NSEE/Cubesat-Mec/README.md

# Cubesat Mecânica

## Descrição
Desenvolvimento das partes mecânicas do cubesat NSEE, incluindo estrutura, analises térmicas, vibração ...

## Versao 1 

 Sistema escalonável que suporta até 3 unidades

## Envolvidos
- Felipe
- Bruna
- Leonardo

## Parte 1
