NSEE/Cubesat-Mec/Materiais/Arquivos/Apresentação/141203/ppt - com comentários/141128_Apresentacao_Felipe.pptx

## Projeto de Inércia para Rodas de Reação

Instituto Mauá de Tecnologia
Núcleo de Sistemas Eletrônicos Embarcados - NSEE

Felipe Mahlmeister

Engenharia Mecânica

## Slide 2

O trabalho encontra-se em fase de aprimoramento do protótipo, para um modelo matemático mais preciso.

1. Estudo das especificações exigidas pelo INPE e especificações dos motores - 4 semanas
2. Estudo e desenvolvimento de modelo matemático que descreve a dinâmica de atitude de rodas de reação - 10 semanas
3. Desenvolvimento de modelo tridimensional - 10 semanas
4. Construção de protótipo - 10 semanas
5. Teste e validação - 9 semanas
6. Redação de relatórios técnicos com os resultados obtidos - 9 semanas

Plano de trabalho e Cronograma

- Início do projeto: 29/07/2014

- Período de pesquisa: 16 semanas

- Etapas iniciadas: 1 a 4

- Prazo restante: 18 semanas

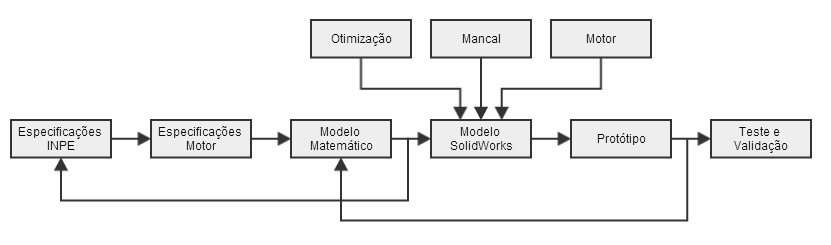
[picture p19: figure]

## Slide 3

Modelo matemático :

- Especificações;
- Projeto;
- Validação.

Simulink :

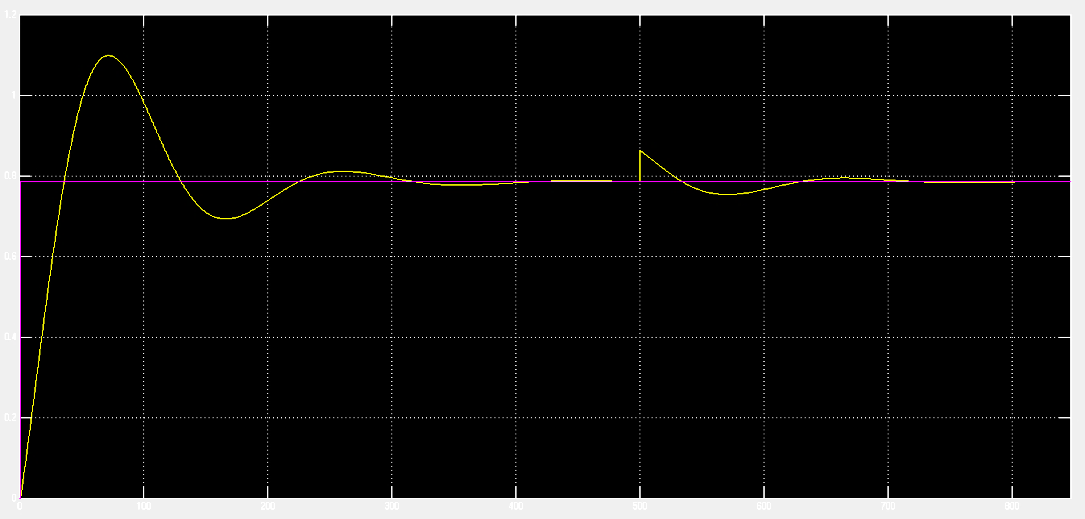
[picture p20: figure]
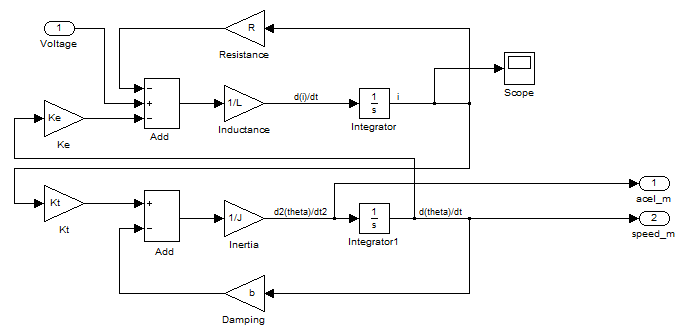
[picture p21: figure]
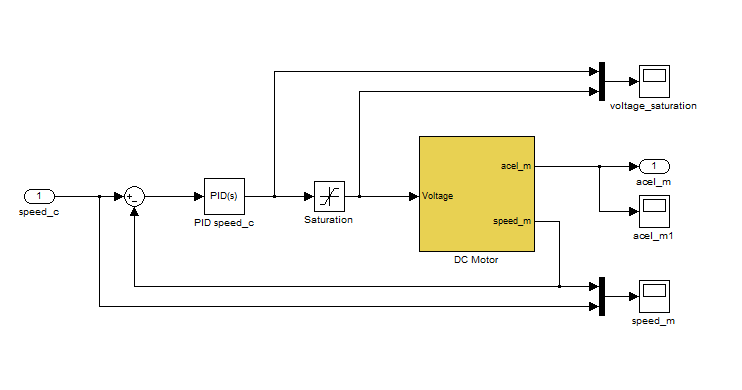
[picture p22: figure]

O modelo matemático foi desenvolvido no Matlab, com base em 3 definições:
Especificações, Projeto e Validação.

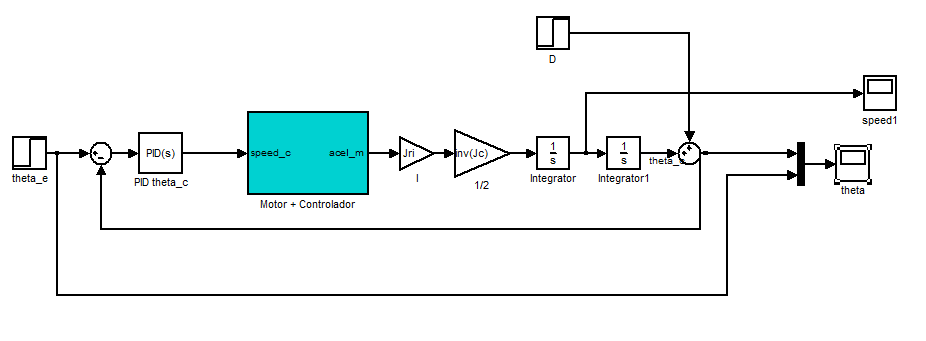
[picture p23: figure]

Protótipos :

Com a necessidade de uma melhor compreensão da dinâmica envolvida,
a pesquisa rumou para simulações no Simulink.

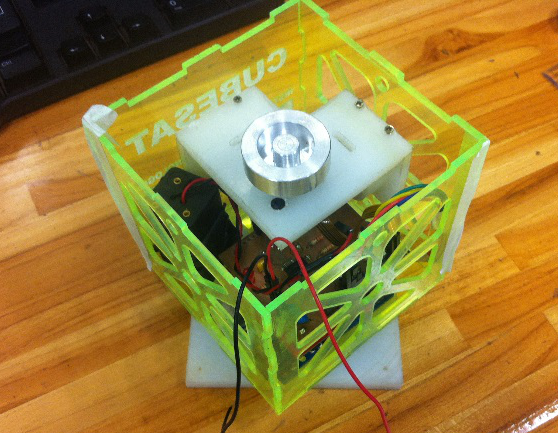
[picture p24: figure]
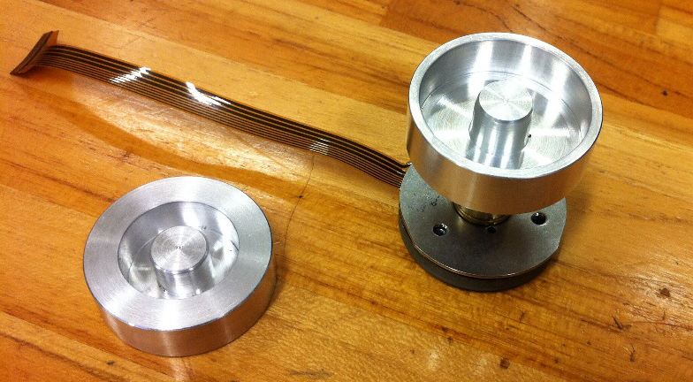
[picture p25: figure]
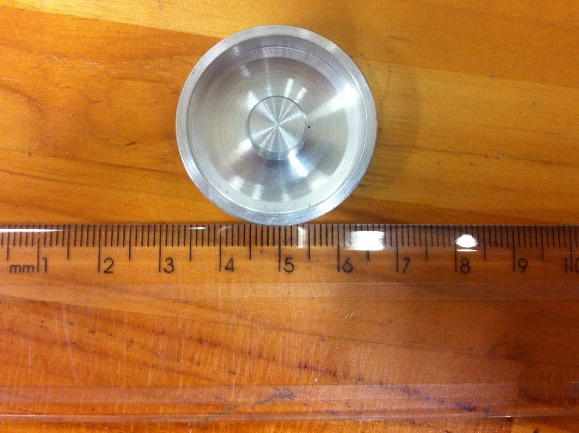
[picture p26: figure]

## Slide 4

Internacional Symposium on Dynamics Problems of Mechanics

Artigos Científicos:

- Projeto de Inércia para Rodas de Reação
- Construção e padronização de estrutura de um CubeSat, seus componentes e interligações

Possibilidades de Divulgação no meio científico:

Congresso Latino-Americano de Satélites – Setembro
Congresso Internacional de Tecnologia na Educação – Setembro
Congresso Nacional de Engenharia Mecânica – Agosto
DINAME – Fevereiro
SciELO – Scientific Electronic Library Online

Possibilidades de Divulgação no meio social:

Canal YouTube
Mídias sociais
