NSEE/Cubesat-Mec/Materiais/Arquivos/Apresentação/151112/ppt/151112_Apresentacao_Felipe.pptx

## CubeSat Frame Design - Petal Model

Instituto Mauá de Tecnologia
Núcleo de Sistemas Eletrônicos Embarcados - NSEE

Felipe Mahlmeister

Engenharia Mecânica

## Slide 2

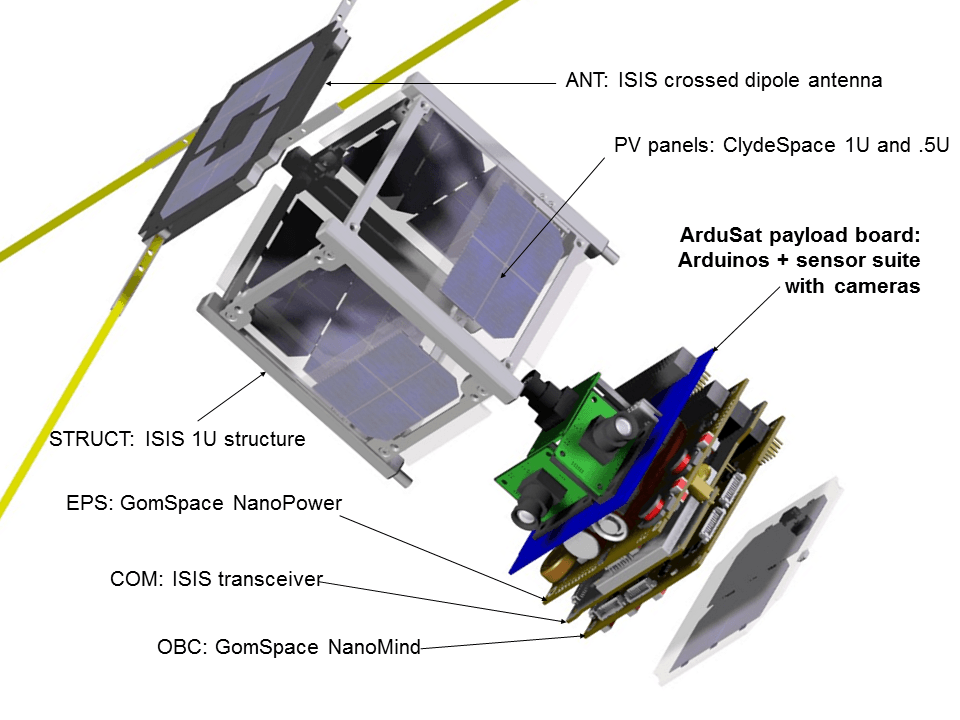
[picture p33: figure]

ArduSat / Fonte: spacesafetymagazine.com

Modelo Gaveta

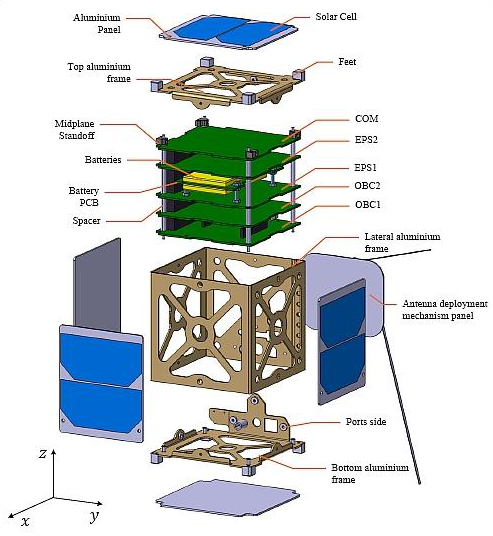
[picture p34: figure]

OUFTI-1 / Fonte: University of Liège

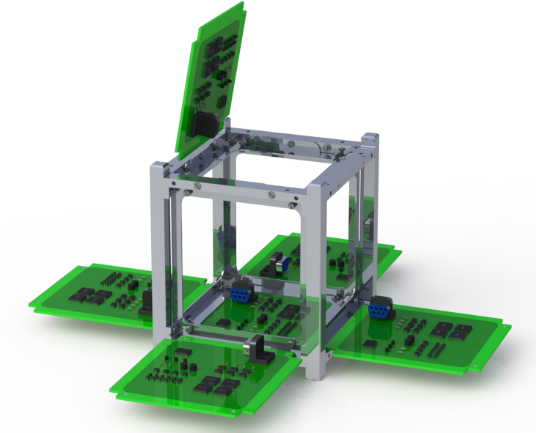
[picture p35: figure]

Modelo Pétala

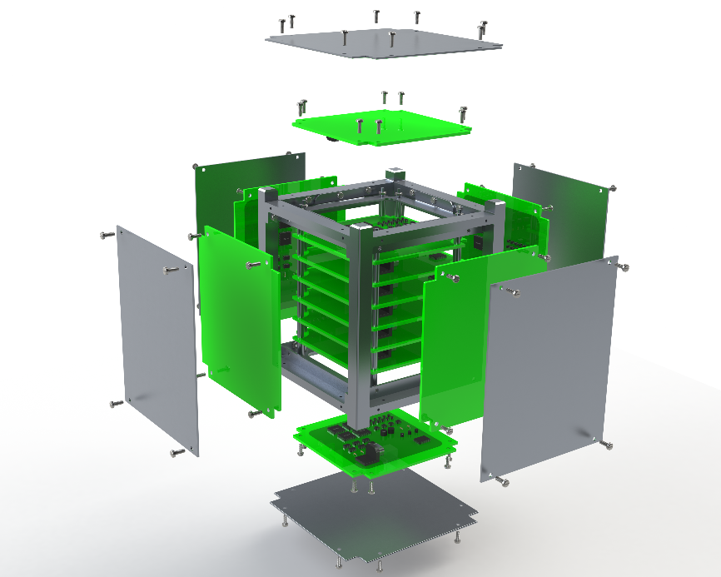
[picture p36: figure]
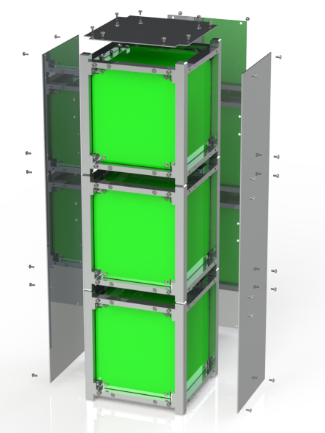
[picture p37: figure]

IMTSat 1U

IMTSat 1U

IMTSat 3U

## Slide 3

Protótipo IMTSat

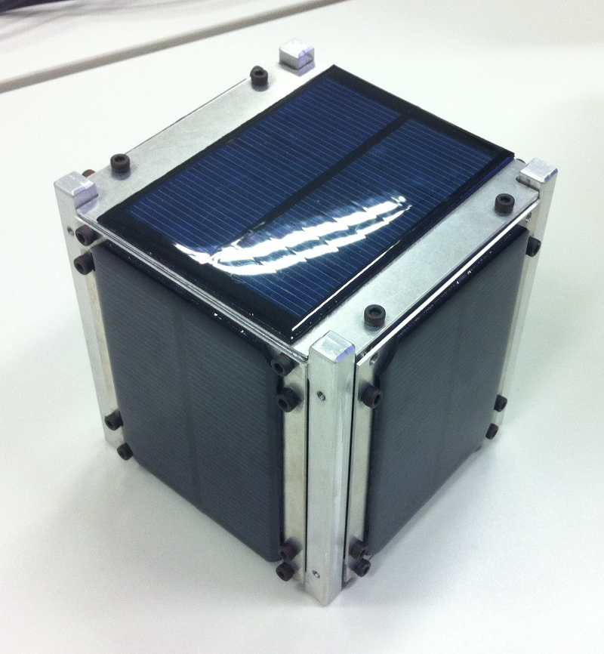
[picture p38: figure]
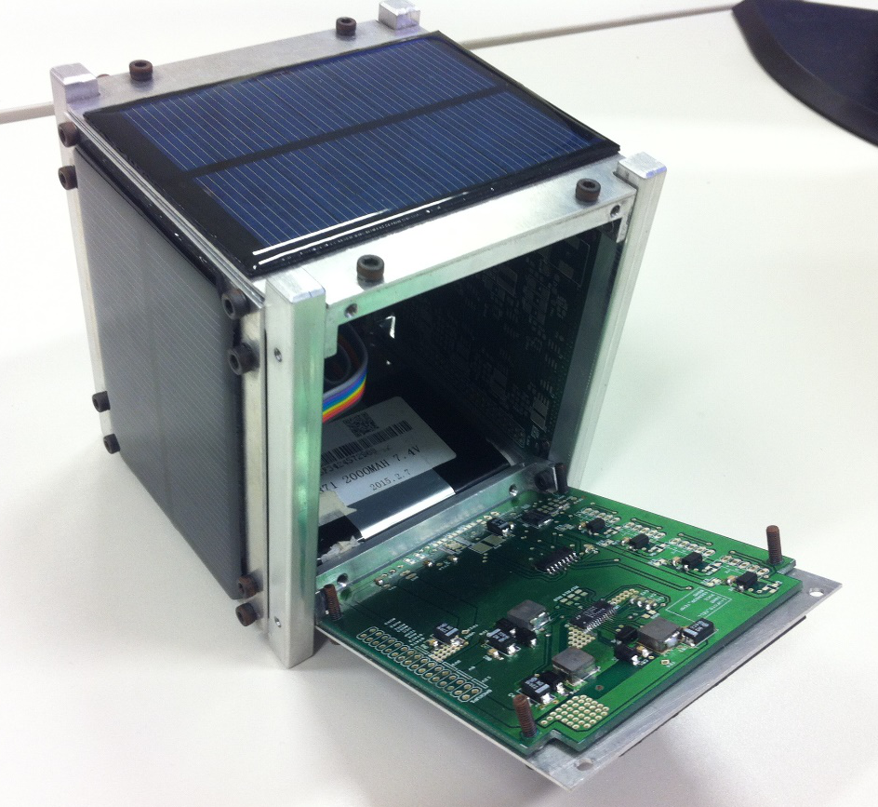
[picture p39: figure]

IMTSat v1.0

IMTSat v1.0
