NSEE/Cubesat-Mec/Materiais/Arquivos/Apresentação/141203/images/45graus - PID01.png

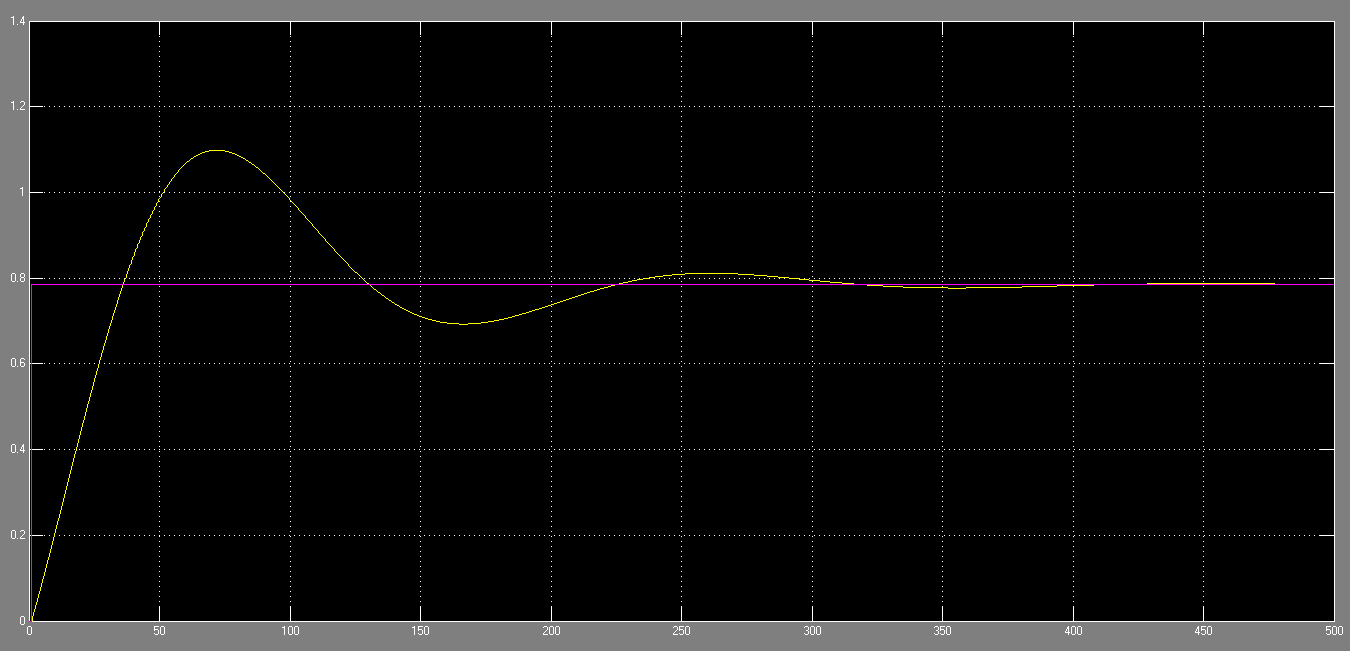
Materiais/Arquivos/Apresentação/141203/images/45graus - PID01.png
