NSEE/Cubesat-Mec/Materiais/Arquivos/Apresentação/151112/images/OUFTI1_AutoB.jpg

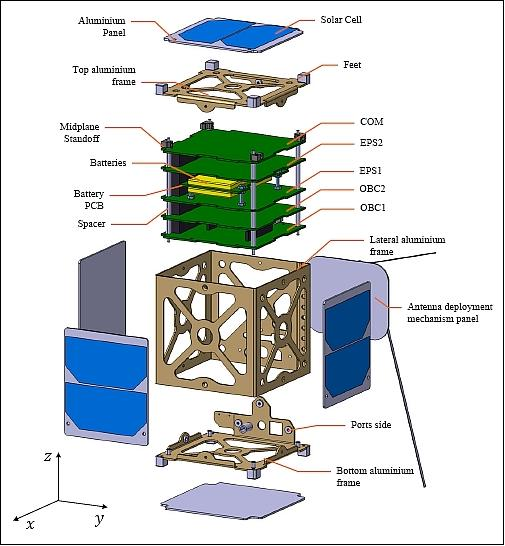
Materiais/Arquivos/Apresentação/151112/images/OUFTI1_AutoB.jpg
