NSEE/Cubesat-Mec/Materiais/Arquivos/Fotos/Reais/v01.1/IMG_6018.JPG

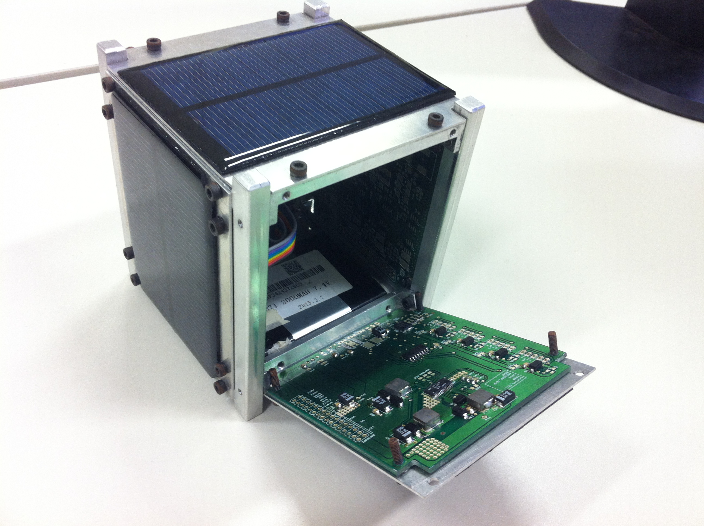
Materiais/Arquivos/Fotos/Reais/v01.1/IMG_6018.JPG
