NSEE/Cubesat-Mec/Materiais/Arquivos/Fotos/Reais/v01.1/IMG_6020.JPG

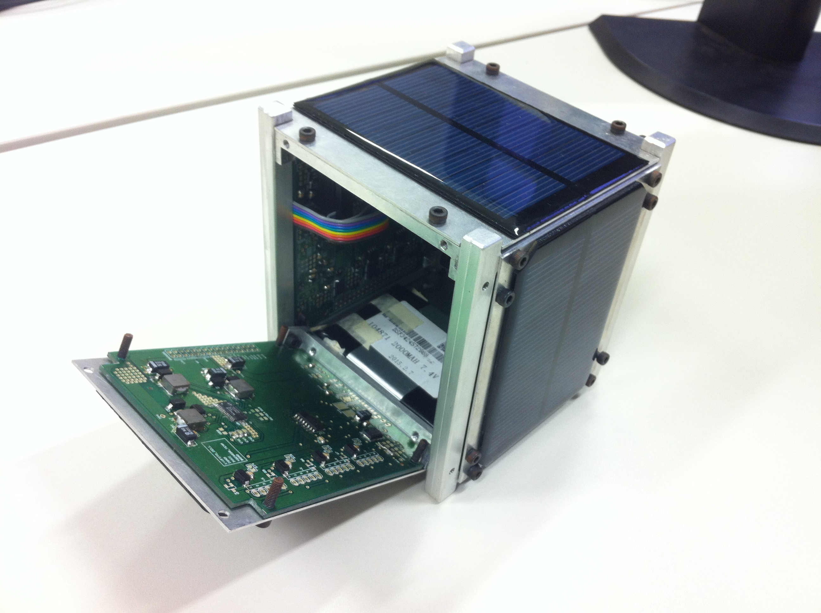
Materiais/Arquivos/Fotos/Reais/v01.1/IMG_6020.JPG
