NSEE/Cubesat-Mec/Materiais/Mecânica/Modelo/Solidworks/Inércia/Modelo 01/Cubesat_I_Flywheel_Mod01_Data.png

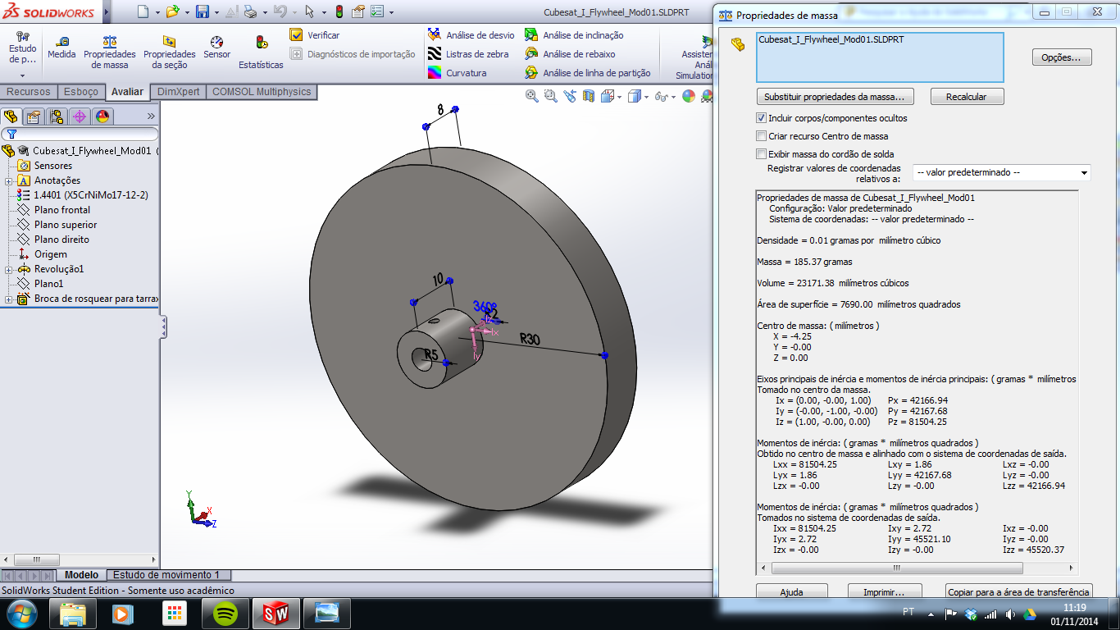
Materiais/Mecânica/Modelo/Solidworks/Inércia/Modelo 01/Cubesat_I_Flywheel_Mod01_Data.png
