NSEE/Cubesat-Mec/Materiais/Mecânica/Modelo/Solidworks/Inércia/Modelo 02/Cubesat_I_Flywheel_Mod02_Data.png

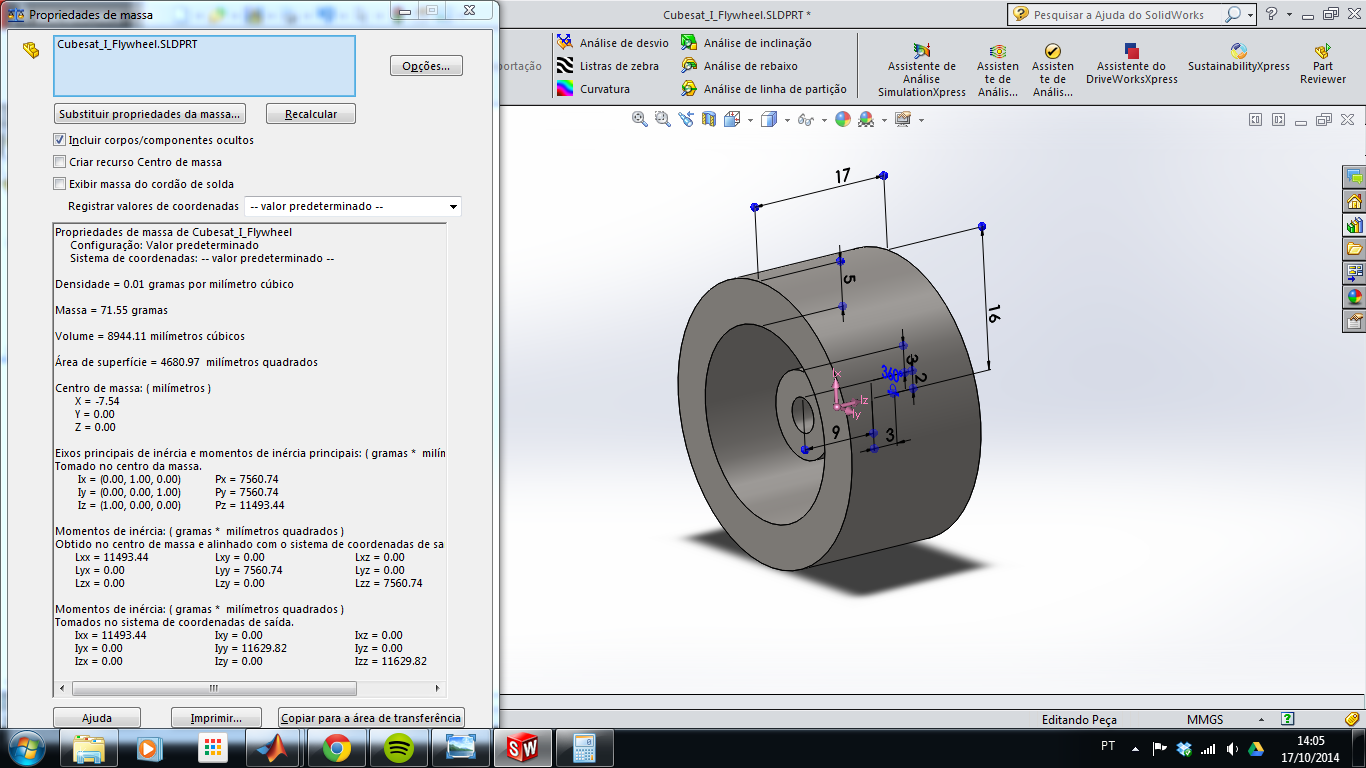
Materiais/Mecânica/Modelo/Solidworks/Inércia/Modelo 02/Cubesat_I_Flywheel_Mod02_Data.png
