NSEE/Cubesat-Mec/Materiais/Mecânica/Modelo/Solidworks/Estrutura/v01.2/Cubesat-PCB-Side-Assembly.SLDASM

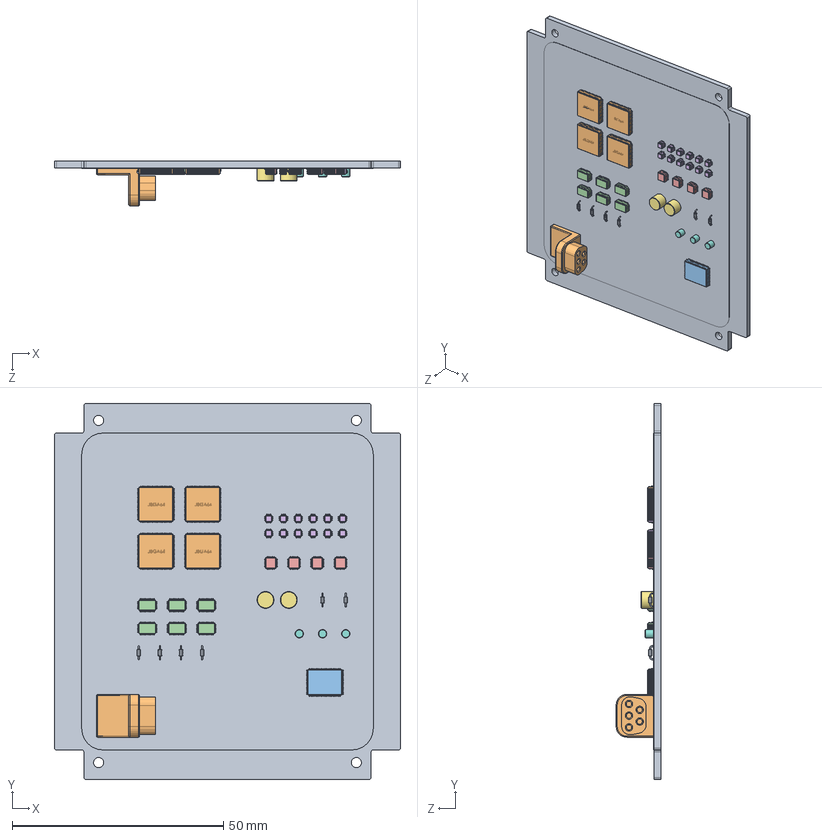
[picture p47: CAD file, 2016-01-29]
Materiais/Mecânica/Modelo/Solidworks/Estrutura/v01.2/Cubesat-PCB-Side-Assembly.SLDASM
82.0 x 89.0 x 10.6 mm
Cubesat-PCB-Side
Cubesat-PCB-Chip01 x 4
Cubesat-PCB-Chip02
Cubesat-PCB-Chip03 x 6
Cubesat-PCB-Chip04 x 4
Cubesat-PCB-Chip05 x 12
Cubesat-PCB-Chip07 x 2
Cubesat-PCB-Chip06 x 3
Cubesat-PCB-Resistor01 x 6
Cubesat-PCB-Connector01
