NSEE/Cubesat-Mec/Materiais/Mecânica/Modelo/Solidworks/Inércia/Modelo 05/Cubesat_I_Flywheel_Assembly_Mod05.SLDASM

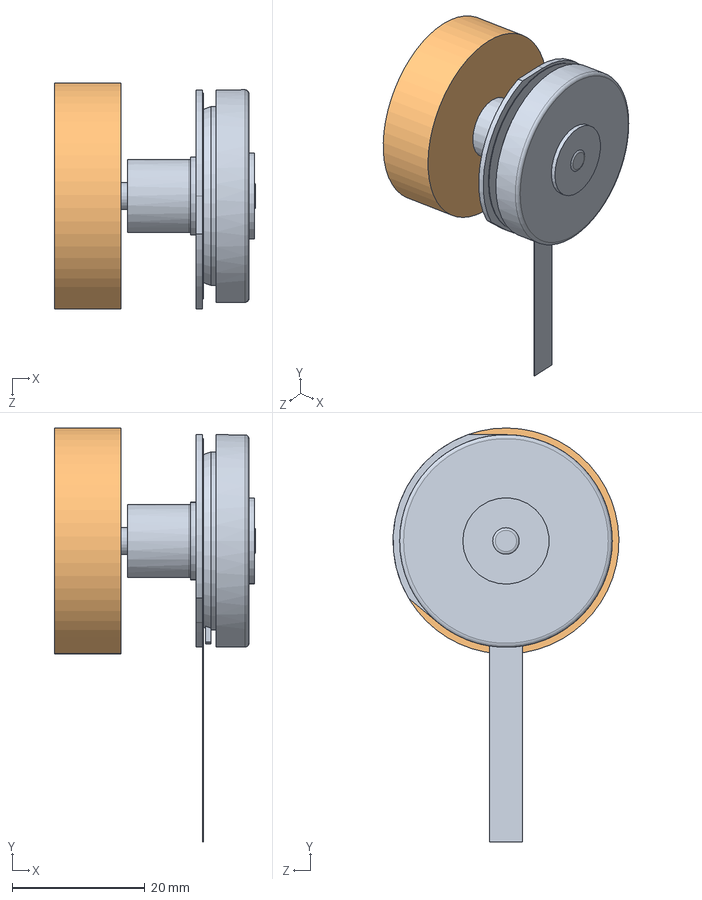
[picture p48: CAD file, 2015-04-06]
Materiais/Mecânica/Modelo/Solidworks/Inércia/Modelo 05/Cubesat_I_Flywheel_Assembly_Mod05.SLDASM
30.3 x 62.3 x 34.0 mm
Cubesat_I_EC32flat
Cubesat_I_Flywheel_Mod05
Cubesat_I_Flywheel_Screw
