NSEE/Cubesat-Mec/Materiais/Mecânica/Modelo/Solidworks/Inércia/Modelo 06/Cubesat_I_Flywheel_Assembly_Mod06.SLDASM

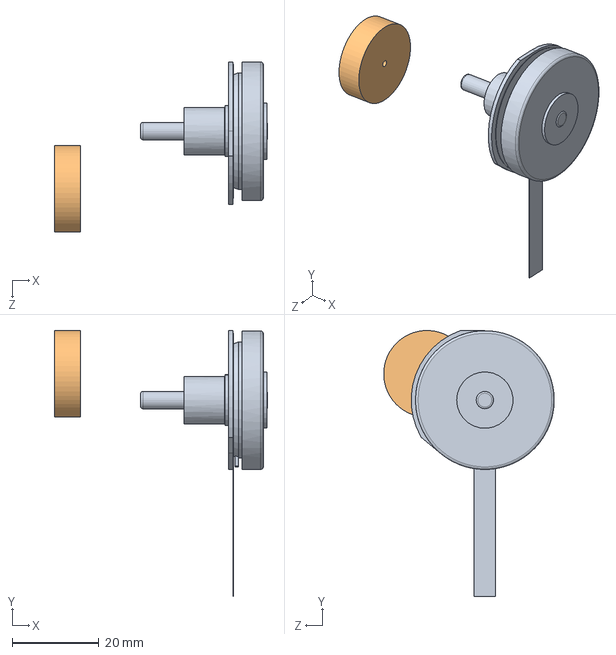
[picture p49: CAD file, 2015-04-06]
Materiais/Mecânica/Modelo/Solidworks/Inércia/Modelo 06/Cubesat_I_Flywheel_Assembly_Mod06.SLDASM
49.2 x 61.4 x 39.3 mm
Cubesat_I_EC32flat
Cubesat_I_Flywheel_Mod06
