NSEE/Cubesat-Mec/Materiais/Mecânica/Modelo/Solidworks/Inércia/Modelo 01/Cubesat_I_Flywheel_Assembly_Mod01.SLDASM

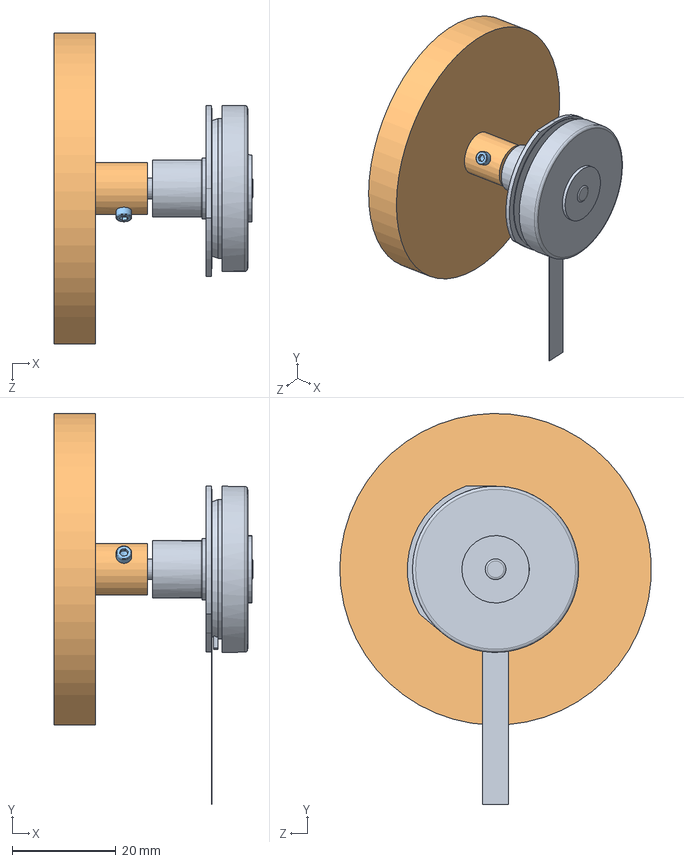
[picture p51: CAD file, 2015-04-06]
Materiais/Mecânica/Modelo/Solidworks/Inércia/Modelo 01/Cubesat_I_Flywheel_Assembly_Mod01.SLDASM
38.3 x 75.3 x 60.0 mm
Cubesat_I_EC32flat
Cubesat_I_Flywheel_Mod01
Cubesat_I_Flywheel_Screw
