NSEE/Cubesat-Mec/Materiais/Mecânica/Modelo/Solidworks/Inércia/Modelo 03/Cubesat_I_Flywheel_Assembly_Mod03.SLDASM

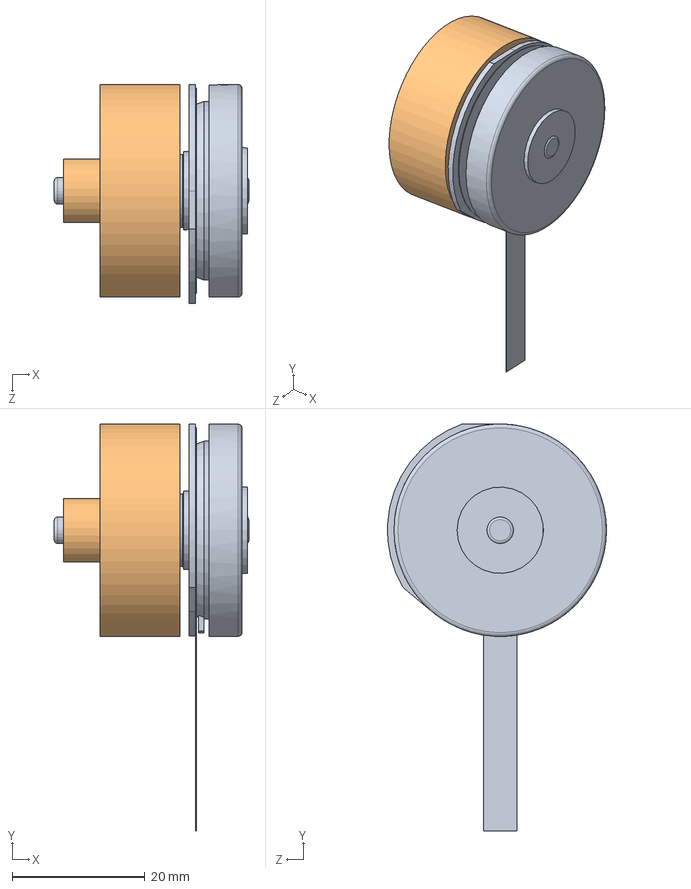
[picture p52: CAD file, 2015-04-06]
Materiais/Mecânica/Modelo/Solidworks/Inércia/Modelo 03/Cubesat_I_Flywheel_Assembly_Mod03.SLDASM
29.3 x 61.3 x 33.0 mm
Cubesat_I_EC32flat
Cubesat_I_Flywheel_Mod03
