NSEE/Cubesat-Mec/Materiais/Mecânica/Modelo/Solidworks/Inércia/Modelo 04/Cubesat_I_Flywheel_Assembly_Mod04.SLDASM

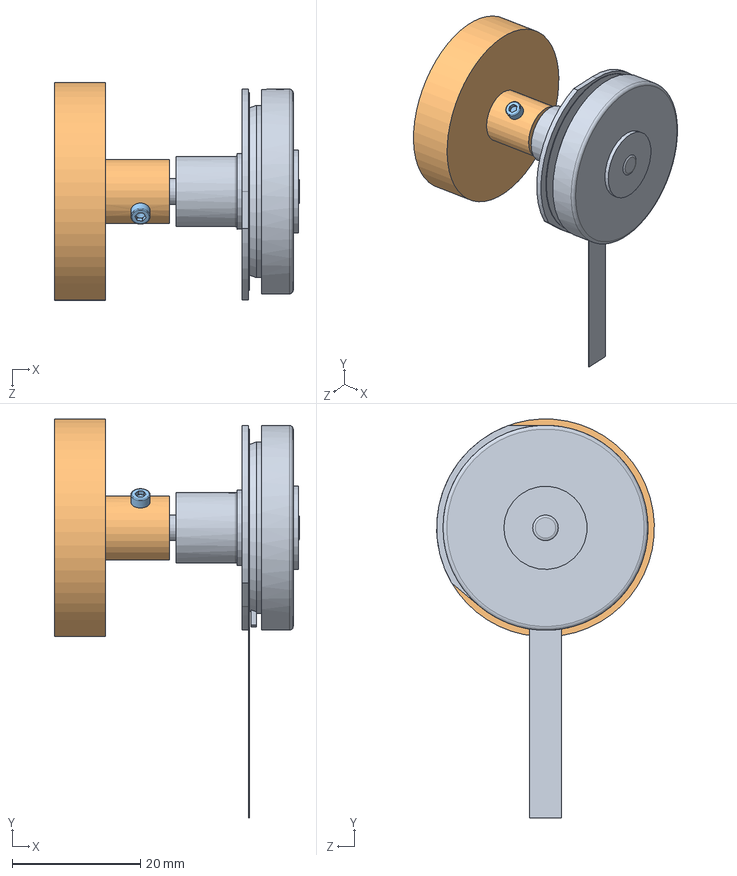
[picture p53: CAD file, 2015-04-06]
Materiais/Mecânica/Modelo/Solidworks/Inércia/Modelo 04/Cubesat_I_Flywheel_Assembly_Mod04.SLDASM
38.3 x 62.3 x 34.0 mm
Cubesat_I_EC32flat
Cubesat_I_Flywheel_Mod04
Cubesat_I_Flywheel_Screw
