NSEE/Cubesat-Mec/Materiais/Mecânica/Modelo/Solidworks/Inércia/Cubesat_I_Flywheel_Assembly.SLDASM

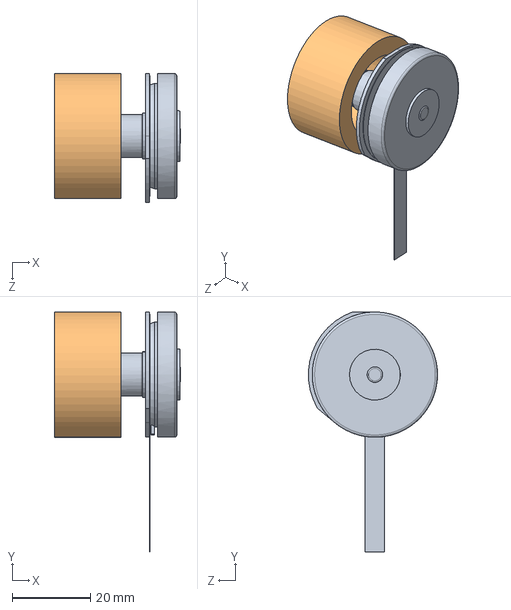
[picture p55: CAD file, 2015-04-06]
Materiais/Mecânica/Modelo/Solidworks/Inércia/Cubesat_I_Flywheel_Assembly.SLDASM
32.3 x 61.3 x 33.0 mm
Cubesat_I_EC32flat
Cubesat_I_Flywheel
