NSEE/Cubesat-Mec/Materiais/Mecânica/Modelo/Solidworks/Inércia/Modelo 10/Cubesat_I_Flywheel_Assembly_Mod10.SLDASM

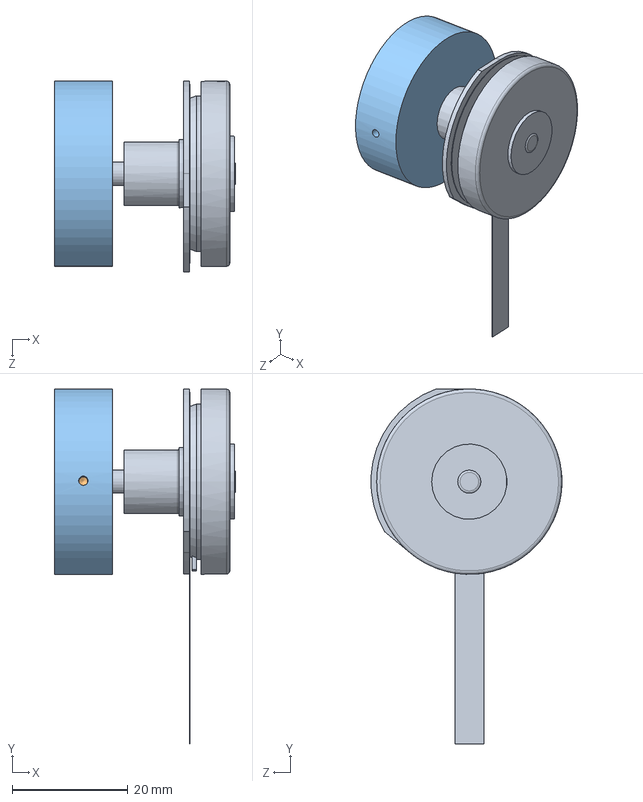
[picture p56: CAD file, 2015-04-06]
Materiais/Mecânica/Modelo/Solidworks/Inércia/Modelo 10/Cubesat_I_Flywheel_Assembly_Mod10.SLDASM
31.3 x 61.3 x 33.0 mm
Cubesat_I_EC32flat
Cubesat_I_Flywheel_Screw
Cubesat_I_Flywheel_Mod08
