NSEE/Cubesat-Mec/Materiais/Mecânica/Modelo/Solidworks/Estrutura/v01.2/Cubesat-PCB-Top-Assembly.SLDASM

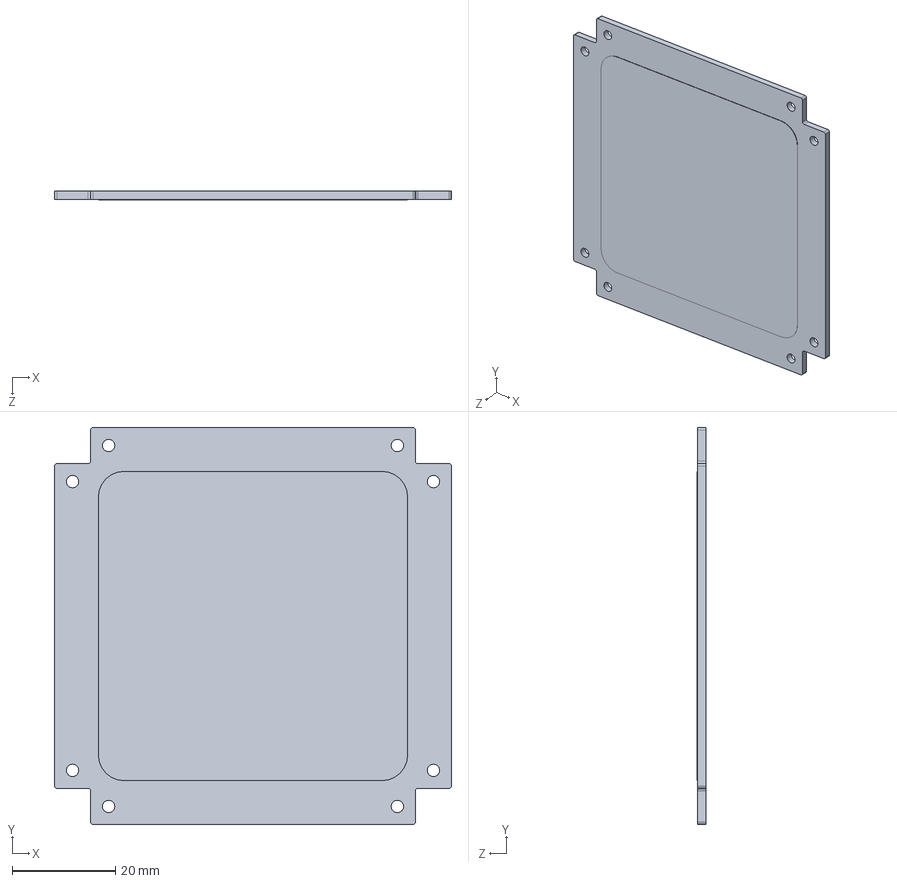
[picture p57: CAD file, 2016-01-29]
Materiais/Mecânica/Modelo/Solidworks/Estrutura/v01.2/Cubesat-PCB-Top-Assembly.SLDASM
77.0 x 77.0 x 1.70 mm
