NSEE/Cubesat-Mec/Materiais/Mecânica/Modelo/Solidworks/Estrutura/v01.2/Cubesat-3U-Assembly.SLDASM

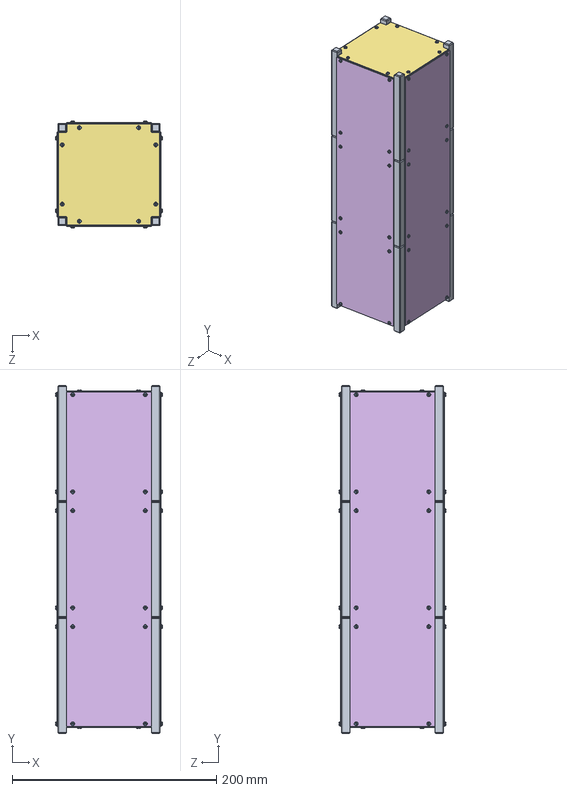
[picture p58: CAD file, 2016-01-29]
Materiais/Mecânica/Modelo/Solidworks/Estrutura/v01.2/Cubesat-3U-Assembly.SLDASM
104.6 x 340.5 x 104.6 mm
Cubesat-Struct-Int-Frame-Side01 x 6
Cubesat-Struct-Int-Plate-PCBStructHalf x 24
CubeSat-Toolbox-Int-Screw-M2-6mm x 208
Cubesat-PCB-Side x 12
Cubesat-PCB-Chip01 x 108
Cubesat-PCB-Chip02 x 27
Cubesat-PCB-Chip03 x 162
Cubesat-PCB-Chip04 x 108
Cubesat-PCB-Chip05 x 324
Cubesat-PCB-Chip07 x 54
Cubesat-PCB-Chip06 x 81
Cubesat-PCB-Resistor01 x 162
Cubesat-PCB-Connector01 x 27
CubeSat-Toolbox-Int-Nut-M2 x 96
Cubesat-Struct-Int-Frame-Side02 x 6
Cubesat-Struct-Int-Frame-Side03 x 6
Cubesat-Struct-Int-Frame-Top x 6
Cubesat-PCB-Top x 6
Cubesat-Struct-Int-Rail-1U x 24
Cubesat-Struct-Int-Rail-Spacer x 144
Cubesat-PCB-Rail x 15
Cubesat-Struct-Ext-Shell-Side-3U x 4
Cubesat-Struct-Ext-Shell-Top x 2
