NSEE/Cubesat-Mec/Materiais/Mecânica/Construção/Arquivos Enviados para Construção/Mauá - CNC/150703/Cubesat-Struct-Int-Frame-Side01.SLDPRT

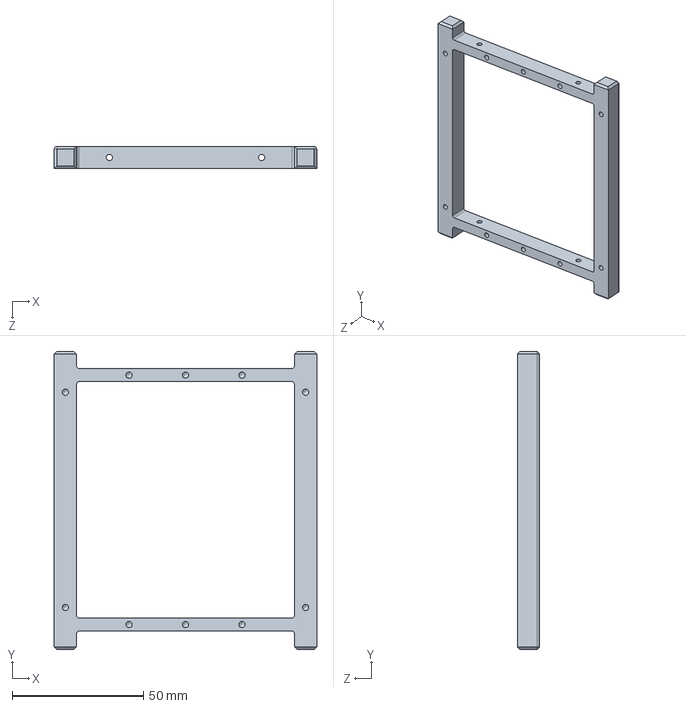
[picture p59: CAD file, 2015-07-07]
Materiais/Mecânica/Construção/Arquivos Enviados para Construção/Mauá - CNC/150703/Cubesat-Struct-Int-Frame-Side01.SLDPRT
100.0 x 113.5 x 8.50 mm
