NSEE/Cubesat-Mec/Materiais/Mecânica/Construção/Arquivos Enviados para Construção/Mauá - CNC/150703/STEP203/Cubesat-Struct-Int-Frame-Side03.STEP

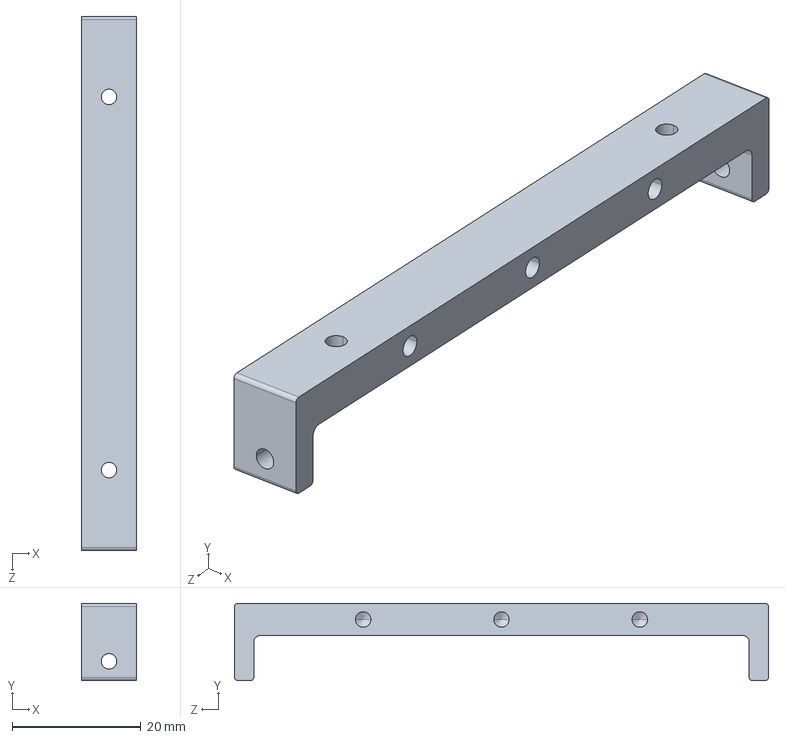
[picture p60: CAD file, 2015-07-07]
Materiais/Mecânica/Construção/Arquivos Enviados para Construção/Mauá - CNC/150703/STEP203/Cubesat-Struct-Int-Frame-Side03.STEP
8.50 x 12.0 x 83.0 mm
