NSEE/Cubesat-Mec/Materiais/Mecânica/Construção/Arquivos Enviados para Construção/Mauá - CNC/151109/Arquivos versão final/SLD/Cubesat-Struct-Int-Frame-Side03.SLDPRT

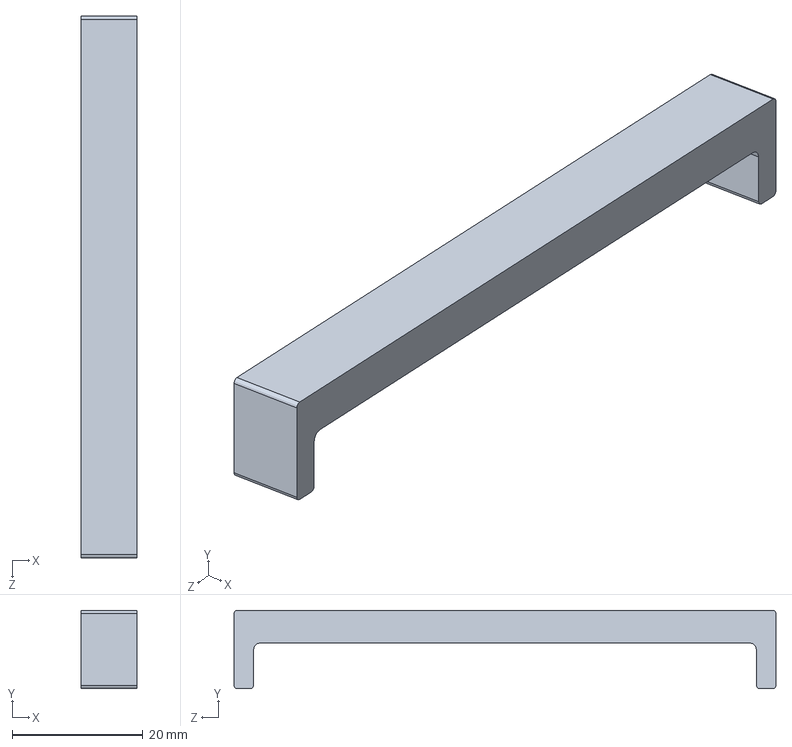
[picture p61: CAD file, 2016-01-26]
Materiais/Mecânica/Construção/Arquivos Enviados para Construção/Mauá - CNC/151109/Arquivos versão final/SLD/Cubesat-Struct-Int-Frame-Side03.SLDPRT
8.50 x 12.0 x 83.0 mm
