NSEE/Cubesat-Mec/Materiais/Mecânica/Modelo/Solidworks/Inércia/Cubesat_I_Flywheel.SLDPRT

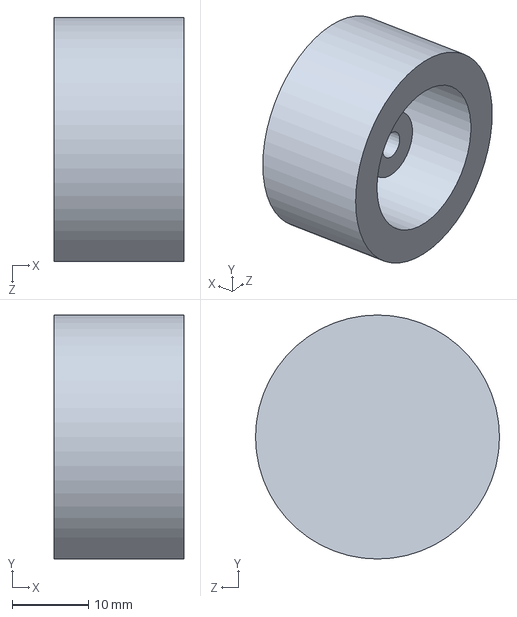
[picture p62: CAD file, 2015-04-06]
Materiais/Mecânica/Modelo/Solidworks/Inércia/Cubesat_I_Flywheel.SLDPRT
17.0 x 32.0 x 32.0 mm
