NSEE/Cubesat-Mec/Materiais/Mecânica/Modelo/Solidworks/Inércia/Modelo 01/Cubesat_I_EC32flat.SLDPRT

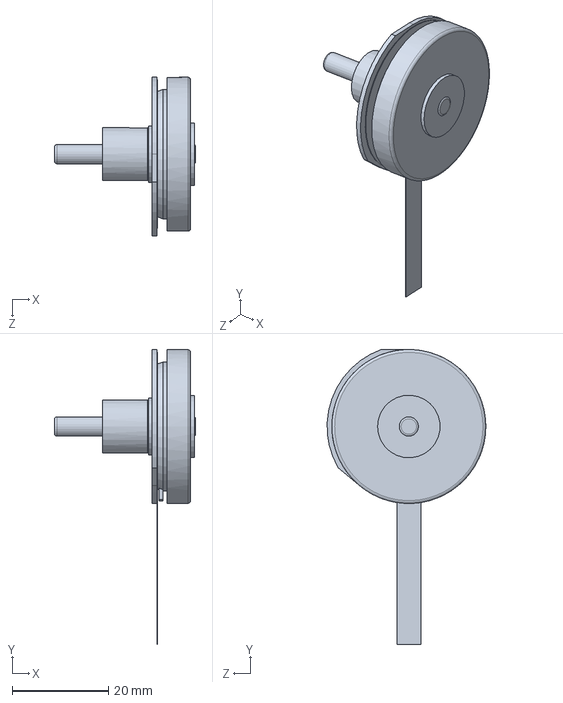
[picture p63: CAD file, 2015-04-06]
Materiais/Mecânica/Modelo/Solidworks/Inércia/Modelo 01/Cubesat_I_EC32flat.SLDPRT
29.3 x 61.3 x 33.0 mm
