NSEE/Cubesat-Mec/Materiais/Mecânica/Modelo/Solidworks/Inércia/Modelo 02/Cubesat_I_Flywheel_Mod02.SLDPRT

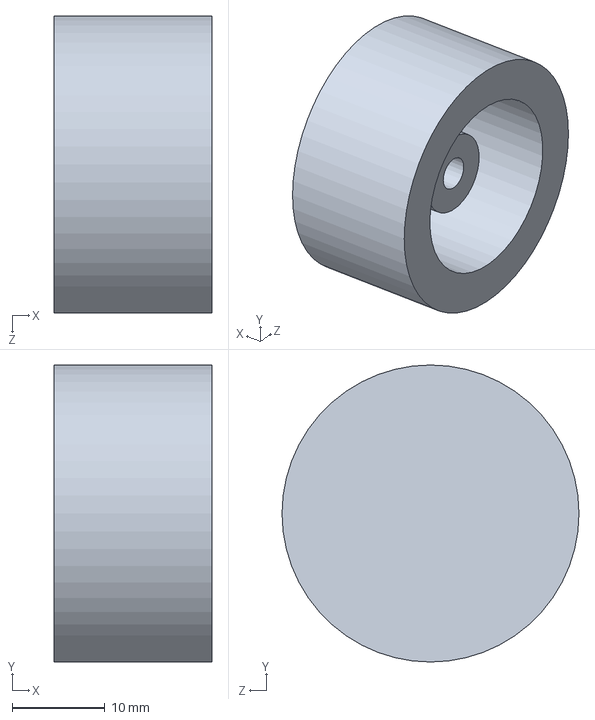
[picture p64: CAD file, 2015-04-06]
Materiais/Mecânica/Modelo/Solidworks/Inércia/Modelo 02/Cubesat_I_Flywheel_Mod02.SLDPRT
17.0 x 32.0 x 32.0 mm
