NSEE/Cubesat-Mec/Materiais/Mecânica/Modelo/Solidworks/Inércia/Modelo 11/Cubesat_I_Flywheel_Mod11.SLDPRT

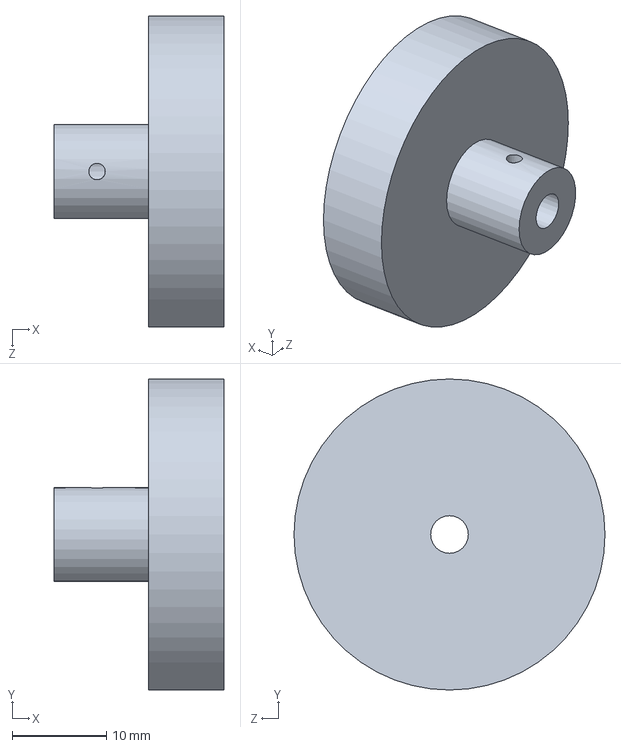
[picture p65: CAD file, 2015-04-06]
Materiais/Mecânica/Modelo/Solidworks/Inércia/Modelo 11/Cubesat_I_Flywheel_Mod11.SLDPRT
18.0 x 33.0 x 33.0 mm
