NSEE/Cubesat-Mec/Materiais/Mecânica/Modelo/Solidworks/Suporte Motor/v01.1/Cubesat-Struct-Int-Motor-Suport.SLDPRT

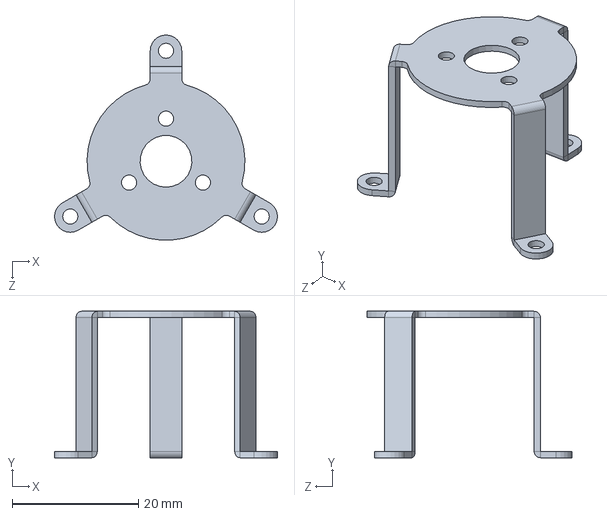
[picture p66: CAD file, 2016-01-26]
Materiais/Mecânica/Modelo/Solidworks/Suporte Motor/v01.1/Cubesat-Struct-Int-Motor-Suport.SLDPRT
35.3 x 23.2 x 32.5 mm
