NSEE/Cubesat-Mec/Materiais/Mecânica/Construção/Arquivos Enviados para Construção/Mauá - CNC/151109/Arquivos versão final/SLD/Cubesat-Struct-Int-Frame-Side01.SLDPRT

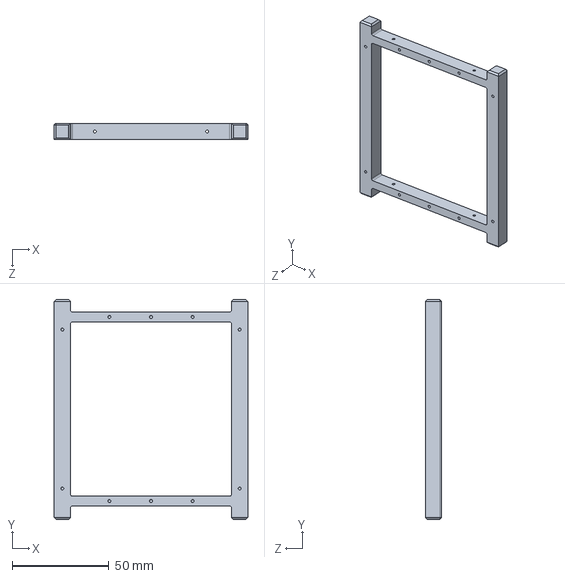
[picture p67: CAD file, 2016-01-26]
Materiais/Mecânica/Construção/Arquivos Enviados para Construção/Mauá - CNC/151109/Arquivos versão final/SLD/Cubesat-Struct-Int-Frame-Side01.SLDPRT
100.0 x 113.5 x 8.50 mm
