NSEE/Cubesat-Mec/Materiais/Mecânica/Construção/Arquivos Enviados para Construção/Mauá - Oficina/151203/Arquivos versão final/SLD/Cubesat-Struct-Ext-Shell-Side-3U.SLDPRT

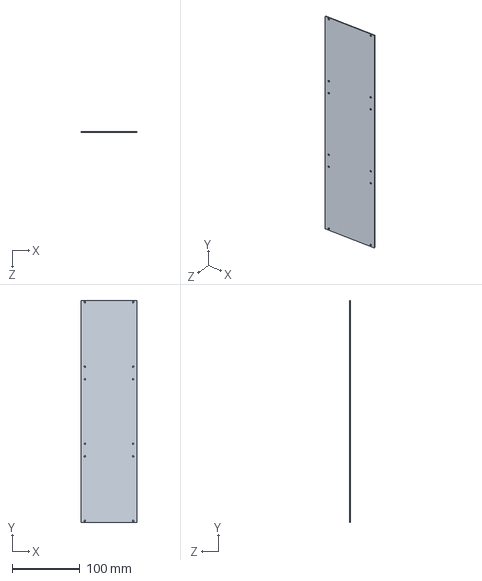
[picture p68: CAD file, 2016-01-26]
Materiais/Mecânica/Construção/Arquivos Enviados para Construção/Mauá - Oficina/151203/Arquivos versão final/SLD/Cubesat-Struct-Ext-Shell-Side-3U.SLDPRT
83.0 x 327.0 x 1.00 mm
