NSEE/Cubesat-Mec/Materiais/Mecânica/Modelo/Solidworks/Inércia/Modelo 05/Cubesat_I_Flywheel_Mod05.SLDPRT

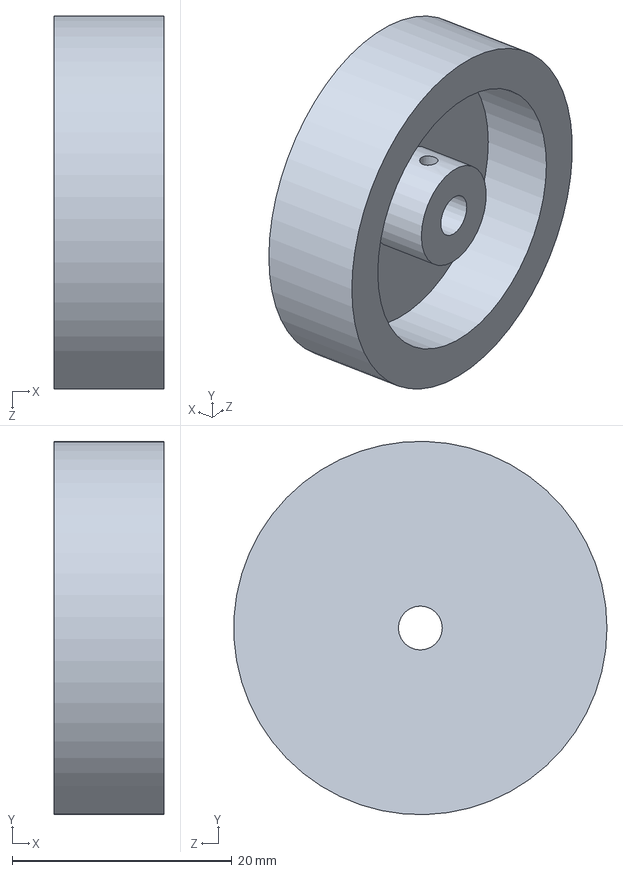
[picture p69: CAD file, 2015-04-06]
Materiais/Mecânica/Modelo/Solidworks/Inércia/Modelo 05/Cubesat_I_Flywheel_Mod05.SLDPRT
10.0 x 34.0 x 34.0 mm
