NSEE/Cubesat-Mec/Materiais/Mecânica/Modelo/Solidworks/Inércia/Modelo 10/Cubesat_I_Flywheel_Mod10.SLDPRT

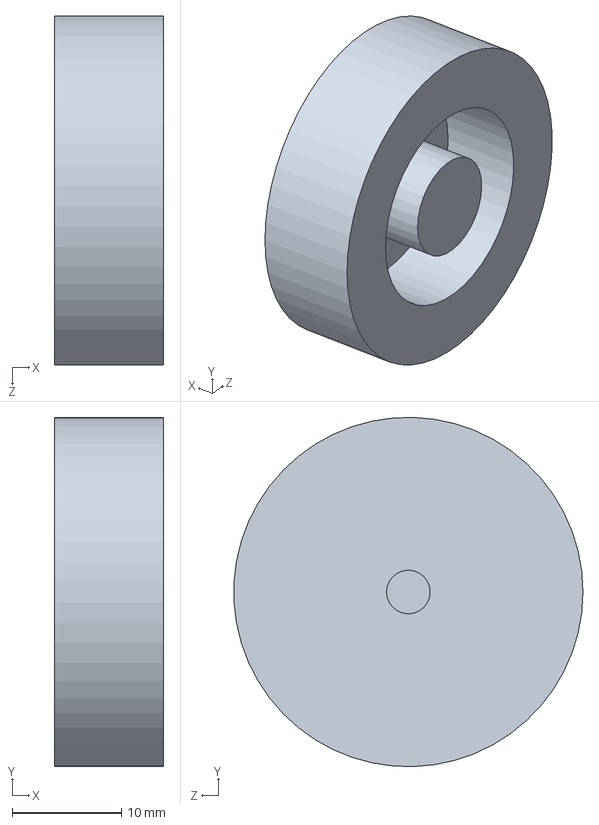
[picture p70: CAD file, 2015-04-06]
Materiais/Mecânica/Modelo/Solidworks/Inércia/Modelo 10/Cubesat_I_Flywheel_Mod10.SLDPRT
10.0 x 32.0 x 32.0 mm
