NSEE/Cubesat-Mec/Materiais/Mecânica/Modelo/Solidworks/Estrutura/v01.2/Cubesat-Struct-Int-Plate-PCBStructHalf.SLDPRT

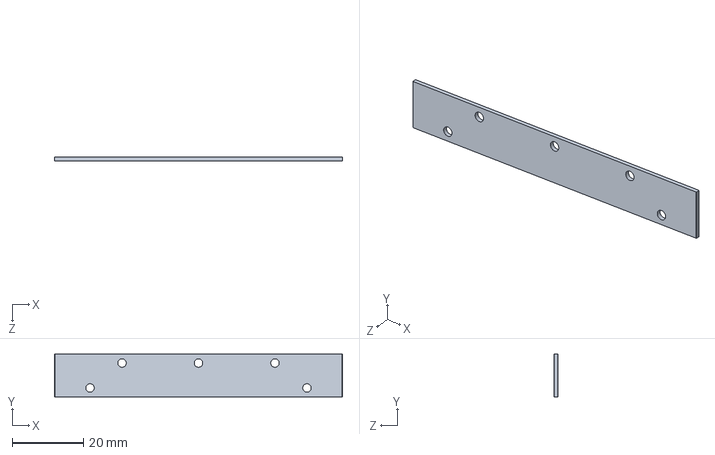
[picture p71: CAD file, 2016-01-29]
Materiais/Mecânica/Modelo/Solidworks/Estrutura/v01.2/Cubesat-Struct-Int-Plate-PCBStructHalf.SLDPRT
81.0 x 12.0 x 1.00 mm
