NSEE/Cubesat-Mec/Materiais/Mecânica/Modelo/Solidworks/Inércia/Modelo 03/Cubesat_I_Flywheel_Mod03.SLDPRT

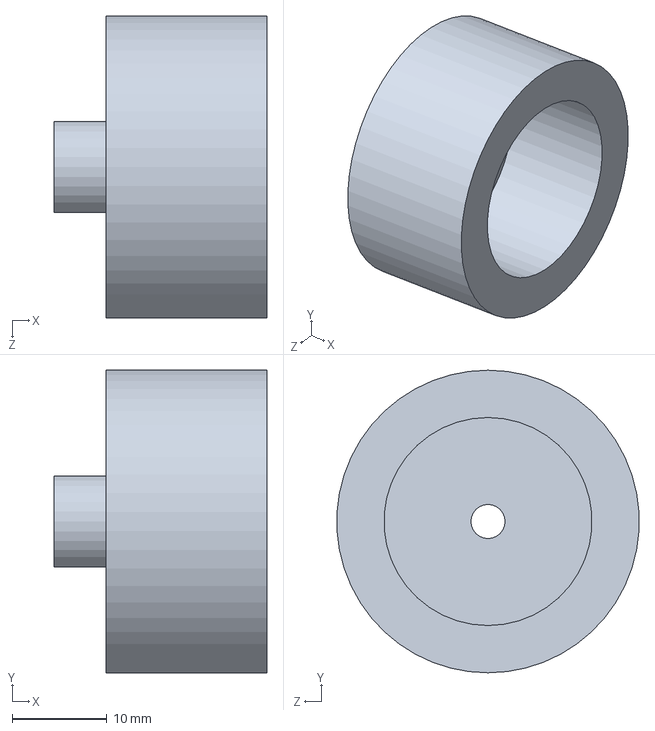
[picture p72: CAD file, 2015-04-06]
Materiais/Mecânica/Modelo/Solidworks/Inércia/Modelo 03/Cubesat_I_Flywheel_Mod03.SLDPRT
22.5 x 32.0 x 31.9 mm
