NSEE/Cubesat-Mec/Materiais/Mecânica/Modelo/Solidworks/Inércia/Modelo 04/Cubesat_I_Flywheel_Mod04.SLDPRT

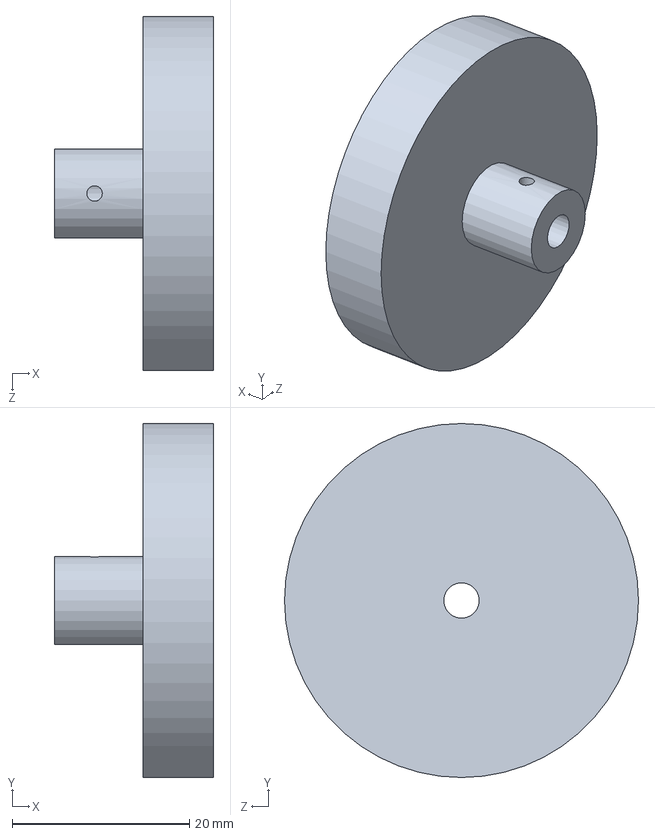
[picture p73: CAD file, 2015-04-06]
Materiais/Mecânica/Modelo/Solidworks/Inércia/Modelo 04/Cubesat_I_Flywheel_Mod04.SLDPRT
18.0 x 40.0 x 40.0 mm
