NSEE/Cubesat-Mec/Materiais/Mecânica/Modelo/Solidworks/Estrutura/v01.2/Cubesat-Struct-Int-Rail-Spacer.SLDPRT

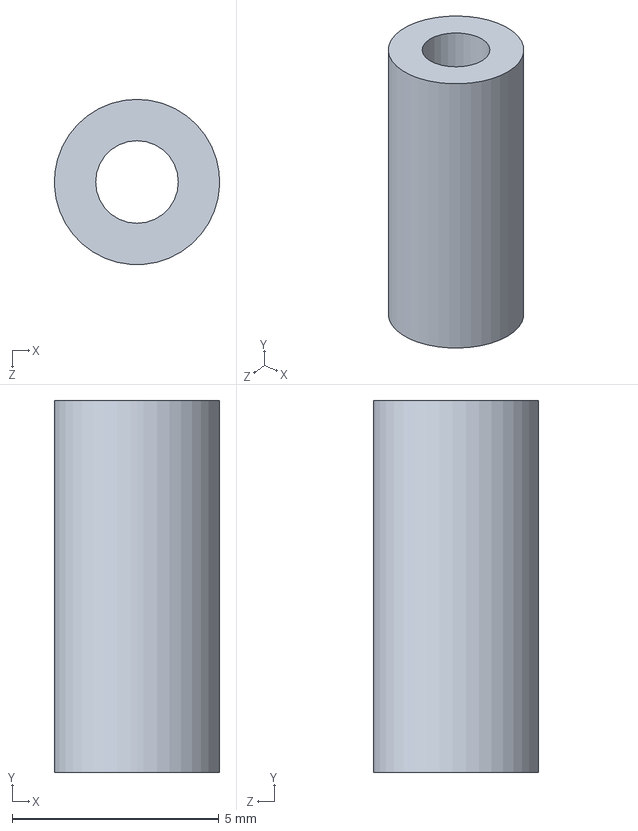
[picture p74: CAD file, 2016-01-29]
Materiais/Mecânica/Modelo/Solidworks/Estrutura/v01.2/Cubesat-Struct-Int-Rail-Spacer.SLDPRT
4.00 x 9.00 x 4.00 mm
