NSEE/Cubesat-Mec/Materiais/Mecânica/Modelo/Solidworks/Inércia/Modelo 01/Cubesat_I_Flywheel_Mod01.SLDPRT

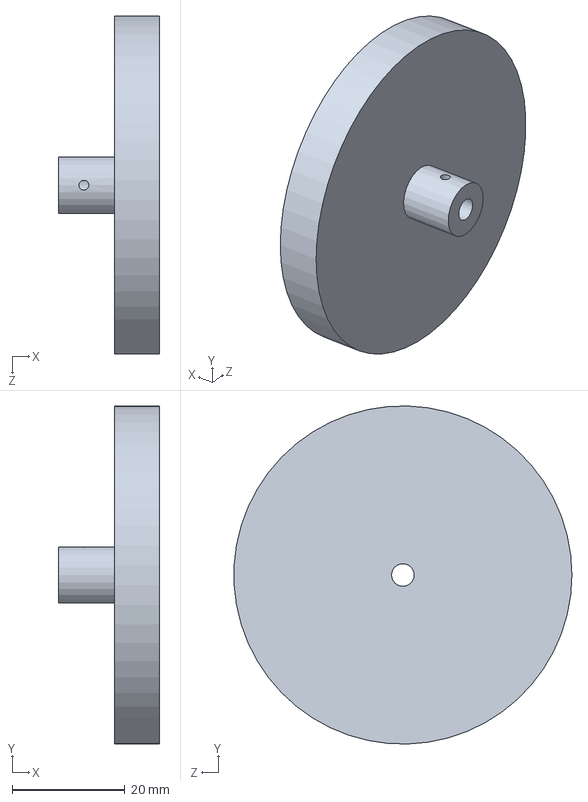
[picture p75: CAD file, 2015-04-06]
Materiais/Mecânica/Modelo/Solidworks/Inércia/Modelo 01/Cubesat_I_Flywheel_Mod01.SLDPRT
18.0 x 60.0 x 59.9 mm
