NSEE/Cubesat-Mec/Materiais/Mecânica/Modelo/Solidworks/Inércia/Modelo 06/Cubesat_I_Flywheel_Mod06.SLDPRT

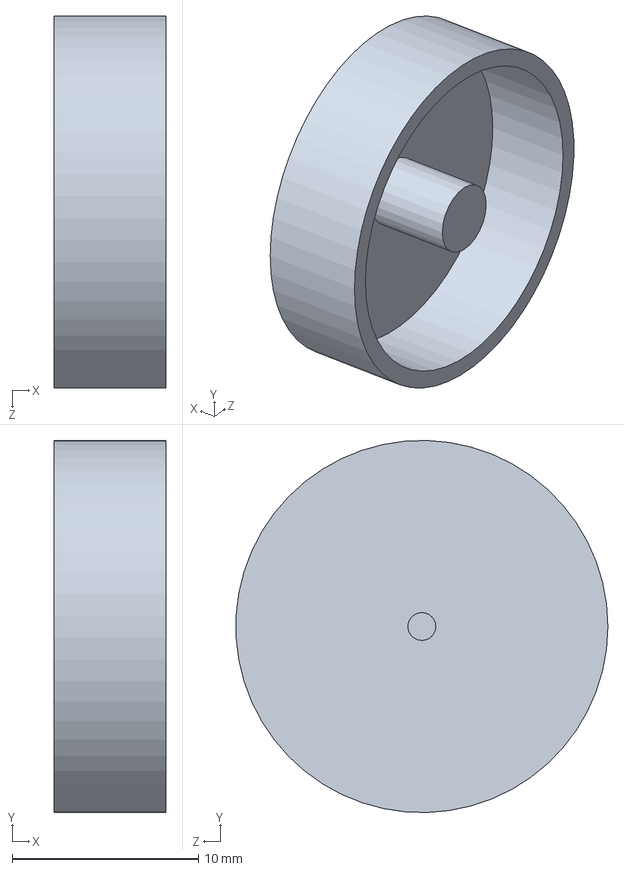
[picture p76: CAD file, 2015-04-06]
Materiais/Mecânica/Modelo/Solidworks/Inércia/Modelo 06/Cubesat_I_Flywheel_Mod06.SLDPRT
6.00 x 20.0 x 20.0 mm
