NSEE/Cubesat-Mec/Materiais/Mecânica/Modelo/Solidworks/Inércia/Modelo 07/Cubesat_I_Flywheel_Mod07.SLDPRT

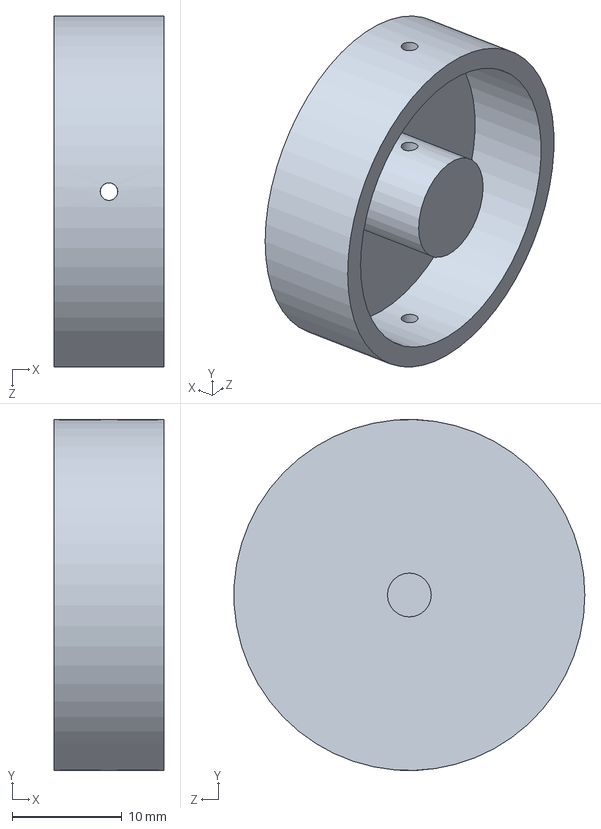
[picture p77: CAD file, 2015-04-06]
Materiais/Mecânica/Modelo/Solidworks/Inércia/Modelo 07/Cubesat_I_Flywheel_Mod07.SLDPRT
10.0 x 32.0 x 32.0 mm
