NSEE/Cubesat-Mec/Materiais/Mecânica/Modelo/Solidworks/Estrutura/v01.2/Cubesat-Struct-Ext-Shell-Top.SLDPRT

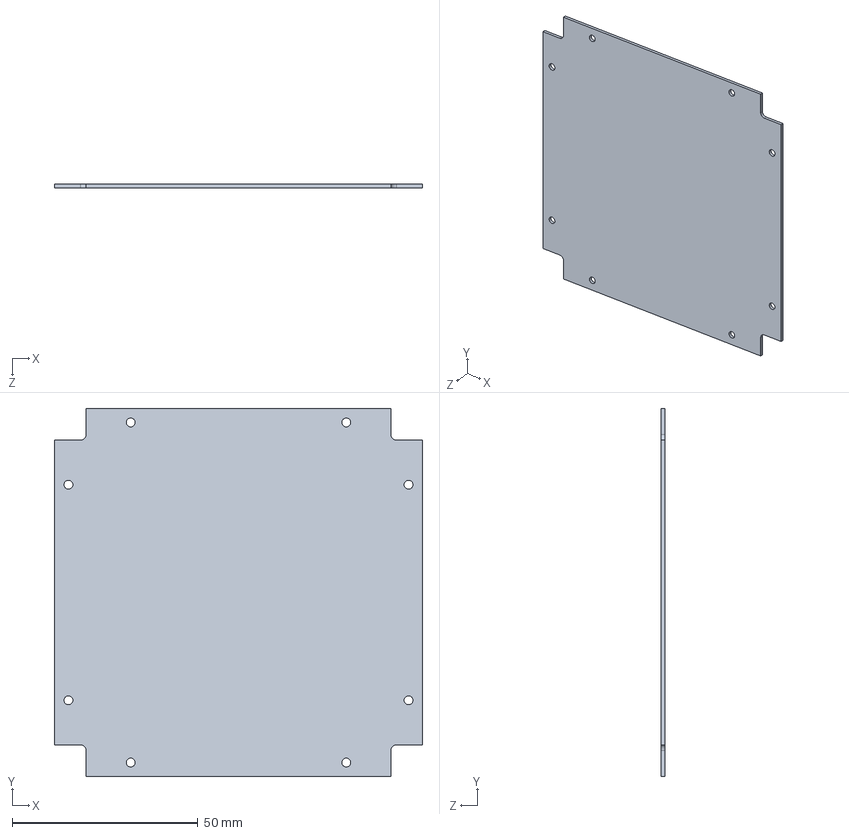
[picture p78: CAD file, 2016-01-29]
Materiais/Mecânica/Modelo/Solidworks/Estrutura/v01.2/Cubesat-Struct-Ext-Shell-Top.SLDPRT
99.0 x 99.0 x 1.00 mm
