NSEE/Cubesat-Mec/Materiais/Mecânica/Modelo/Solidworks/Estrutura/v01.2/Cubesat-Struct-Int-Rail-1U.SLDPRT

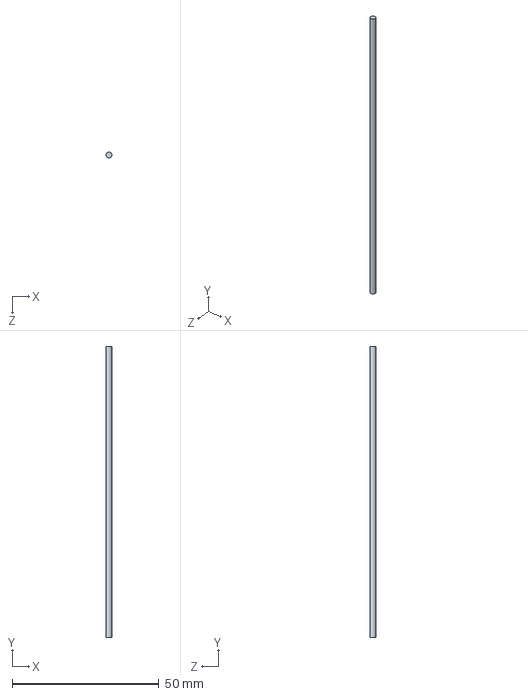
[picture p79: CAD file, 2016-01-29]
Materiais/Mecânica/Modelo/Solidworks/Estrutura/v01.2/Cubesat-Struct-Int-Rail-1U.SLDPRT
2.00 x 99.0 x 2.00 mm
