NSEE/Cubesat-Mec/Materiais/Mecânica/Modelo/Solidworks/Estrutura/v01.2/Cubesat-PCB-Side.SLDPRT

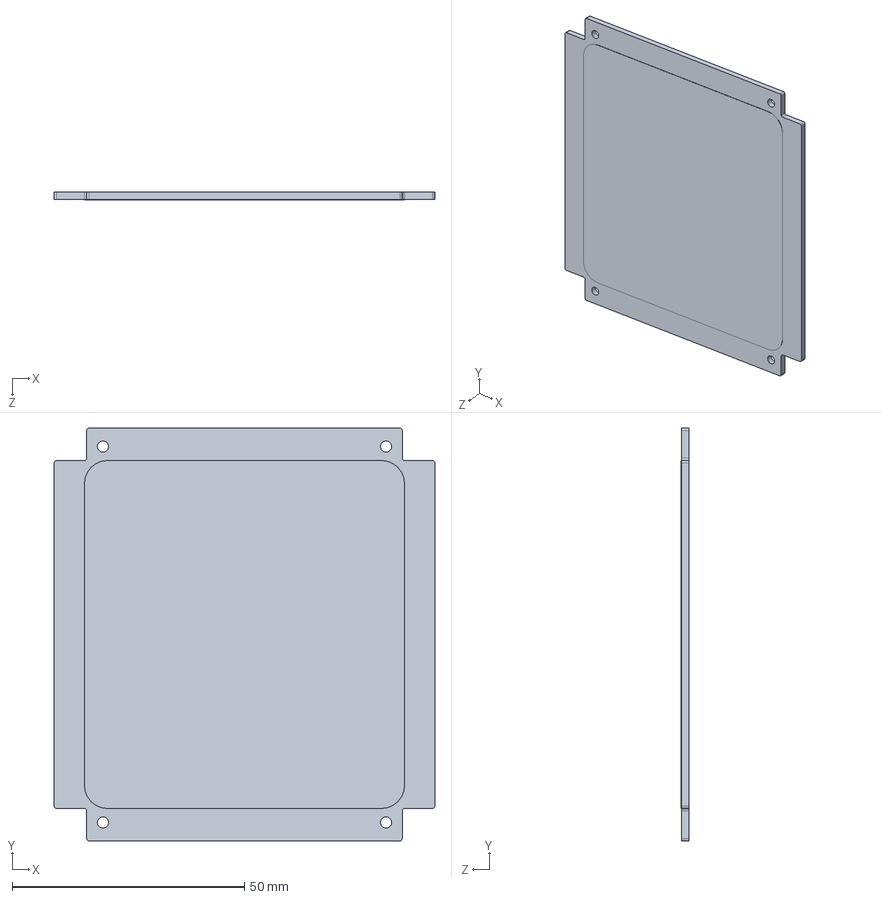
[picture p80: CAD file, 2016-01-28]
Materiais/Mecânica/Modelo/Solidworks/Estrutura/v01.2/Cubesat-PCB-Side.SLDPRT
82.0 x 89.0 x 1.70 mm
