NSEE/Cubesat-Mec/Materiais/Mecânica/Modelo/Solidworks/Estrutura/v01.2/Cubesat-Struct-Int-Frame-Top.SLDPRT

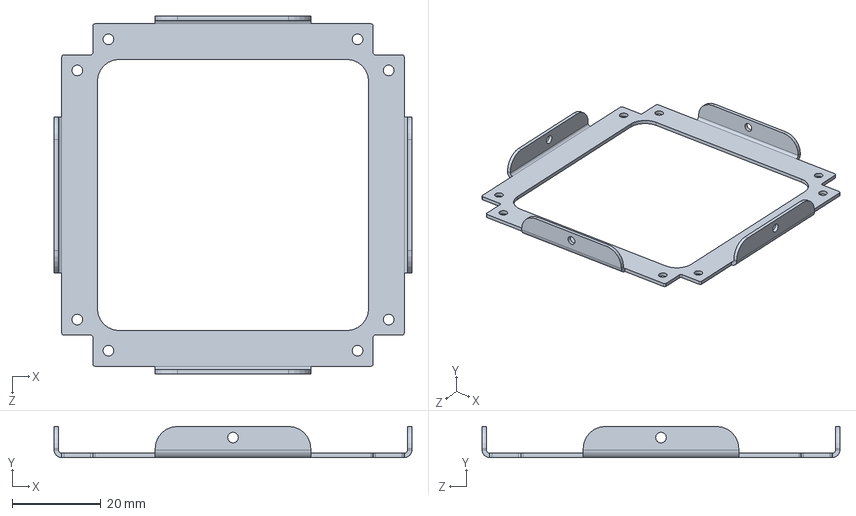
[picture p81: CAD file, 2016-01-28]
Materiais/Mecânica/Modelo/Solidworks/Estrutura/v01.2/Cubesat-Struct-Int-Frame-Top.SLDPRT
80.5 x 7.00 x 80.5 mm
