NSEE/Cubesat-Mec/Materiais/Mecânica/Modelo/Solidworks/Estrutura/v01.2/Cubesat-PCB-Connector01.SLDPRT

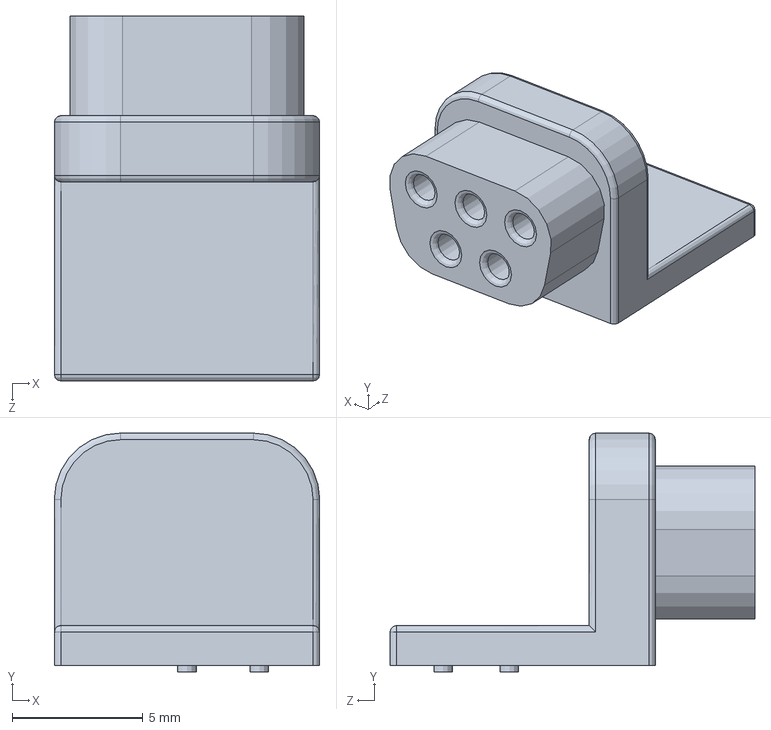
[picture p82: CAD file, 2016-01-28]
Materiais/Mecânica/Modelo/Solidworks/Estrutura/v01.2/Cubesat-PCB-Connector01.SLDPRT
10.2 x 9.14 x 14.0 mm
