NSEE/Cubesat-Mec/Materiais/Mecânica/Modelo/Solidworks/Estrutura/v01.2/Cubesat-Struct-Ext-Shell-Side-1U.SLDPRT

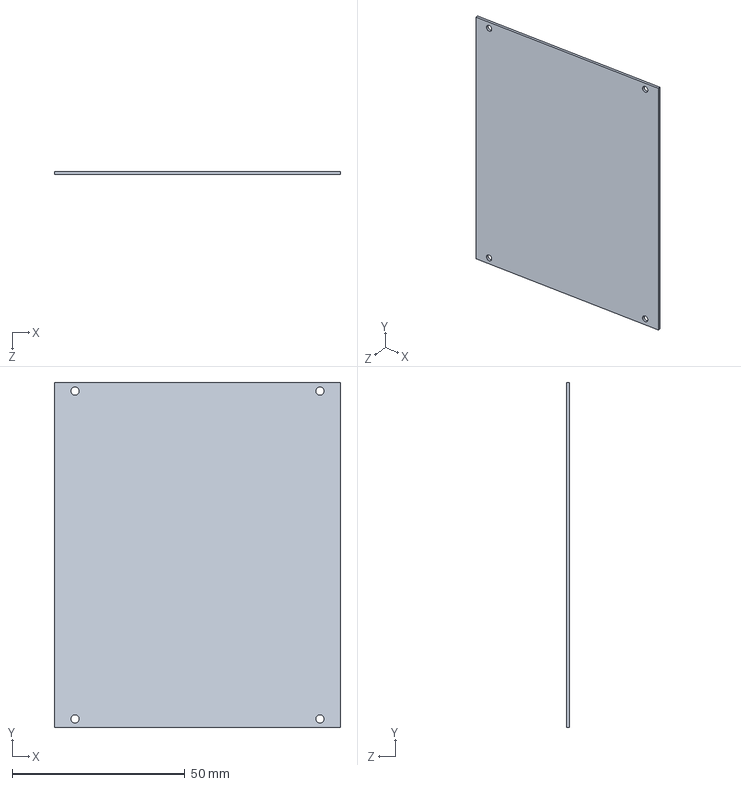
[picture p83: CAD file, 2016-01-28]
Materiais/Mecânica/Modelo/Solidworks/Estrutura/v01.2/Cubesat-Struct-Ext-Shell-Side-1U.SLDPRT
83.0 x 100.0 x 1.00 mm
