NSEE/Cubesat-Mec/Materiais/Mecânica/Modelo/Solidworks/Estrutura/v01.2/Cubesat-Struct-Int-Plate-PCBStruct.SLDPRT

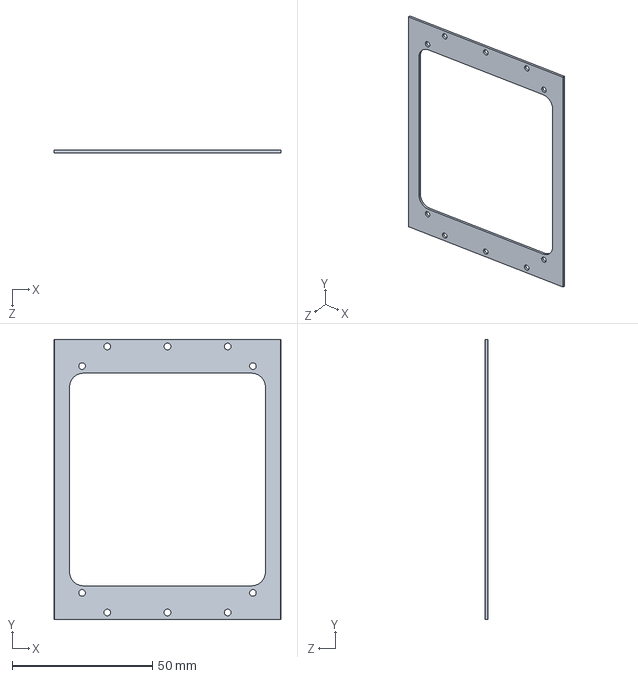
[picture p84: CAD file, 2016-01-28]
Materiais/Mecânica/Modelo/Solidworks/Estrutura/v01.2/Cubesat-Struct-Int-Plate-PCBStruct.SLDPRT
81.0 x 100.0 x 1.00 mm
