NSEE/Cubesat-Mec/Materiais/Mecânica/Modelo/Solidworks/Estrutura/v01.2/Cubesat-PCB-Chip02.SLDPRT

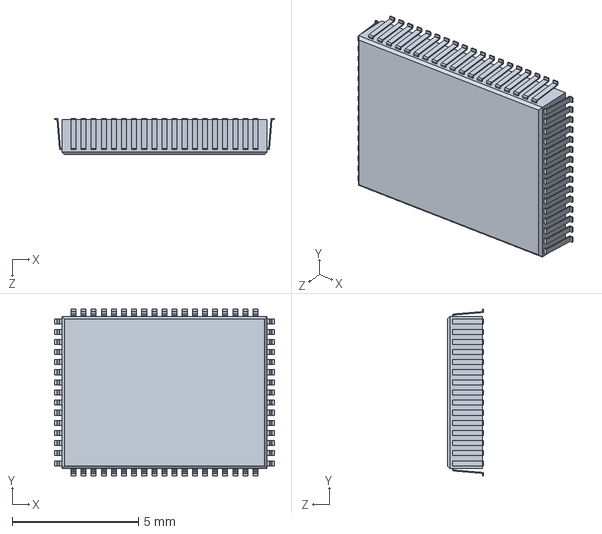
[picture p85: CAD file, 2015-04-01]
Materiais/Mecânica/Modelo/Solidworks/Estrutura/v01.2/Cubesat-PCB-Chip02.SLDPRT
8.70 x 6.60 x 1.44 mm
