NSEE/Cubesat-Mec/Materiais/Mecânica/Modelo/Solidworks/Estrutura/v01.2/Cubesat-PCB-Chip05.SLDPRT

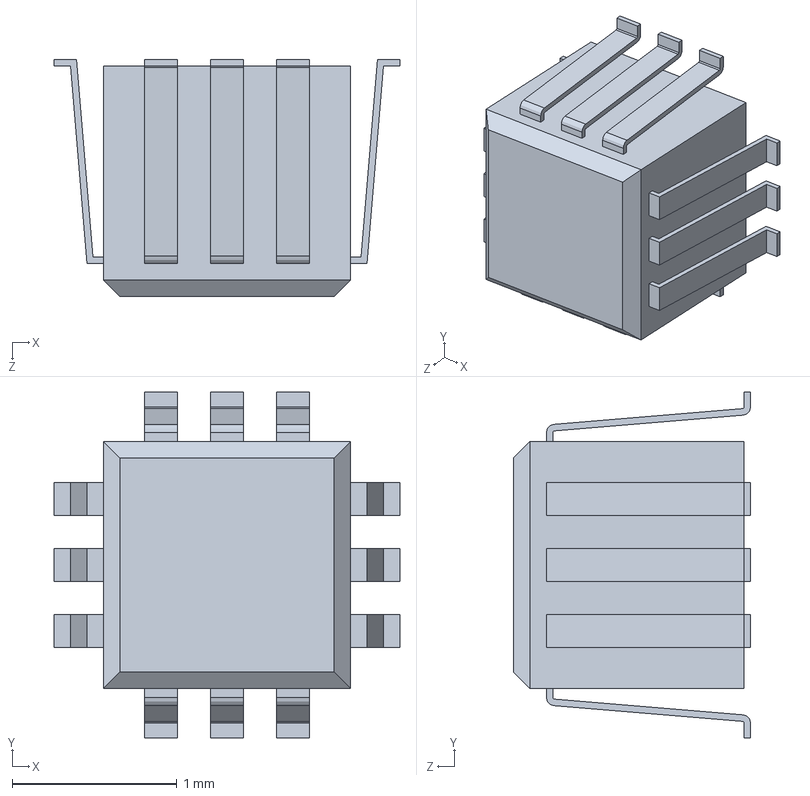
[picture p86: CAD file, 2015-04-01]
Materiais/Mecânica/Modelo/Solidworks/Estrutura/v01.2/Cubesat-PCB-Chip05.SLDPRT
2.10 x 2.10 x 1.44 mm
