NSEE/Cubesat-Mec/Materiais/Mecânica/Modelo/Solidworks/Estrutura/v01.2/Cubesat-PCB-Chip04.SLDPRT

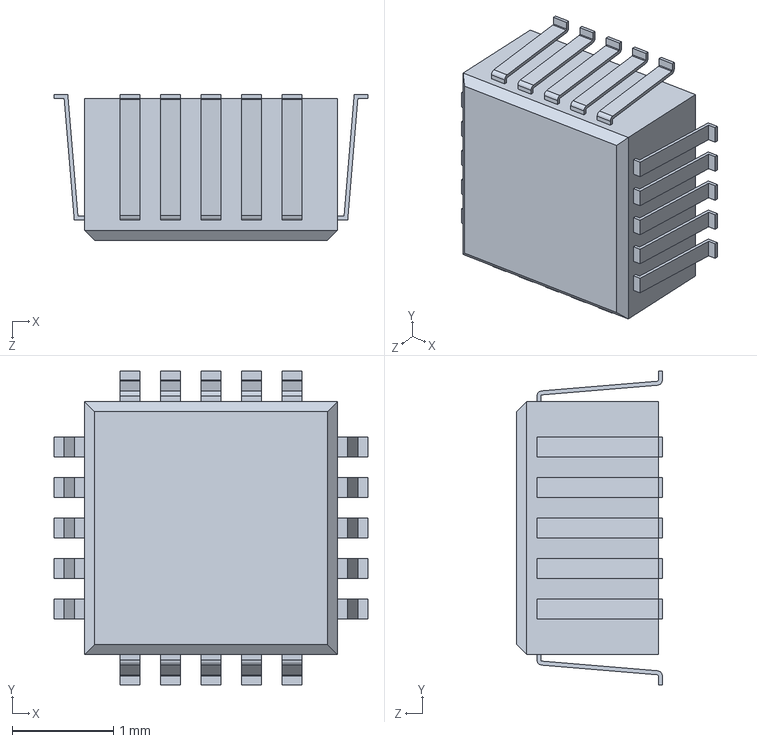
[picture p87: CAD file, 2015-04-01]
Materiais/Mecânica/Modelo/Solidworks/Estrutura/v01.2/Cubesat-PCB-Chip04.SLDPRT
3.10 x 3.10 x 1.44 mm
