NSEE/Cubesat-Mec/Materiais/Mecânica/Modelo/Solidworks/Estrutura/v01.2/Cubesat-PCB-Resistor01.SLDPRT

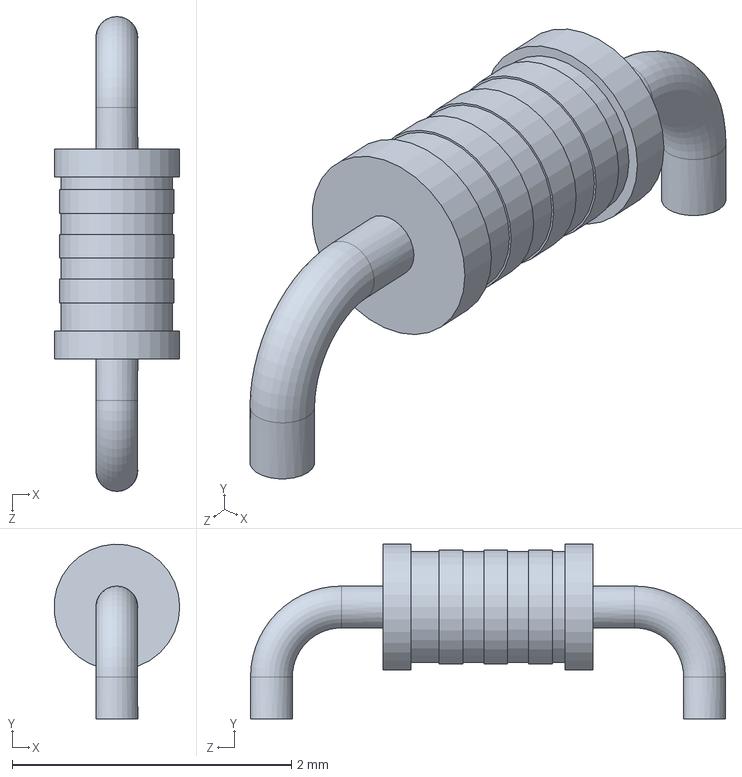
[picture p88: CAD file, 2015-04-01]
Materiais/Mecânica/Modelo/Solidworks/Estrutura/v01.2/Cubesat-PCB-Resistor01.SLDPRT
0.898 x 1.25 x 3.40 mm
