NSEE/Cubesat-Mec/Materiais/Mecânica/Modelo/Solidworks/Estrutura/v01.2/Cubesat-PCB-Chip03.SLDPRT

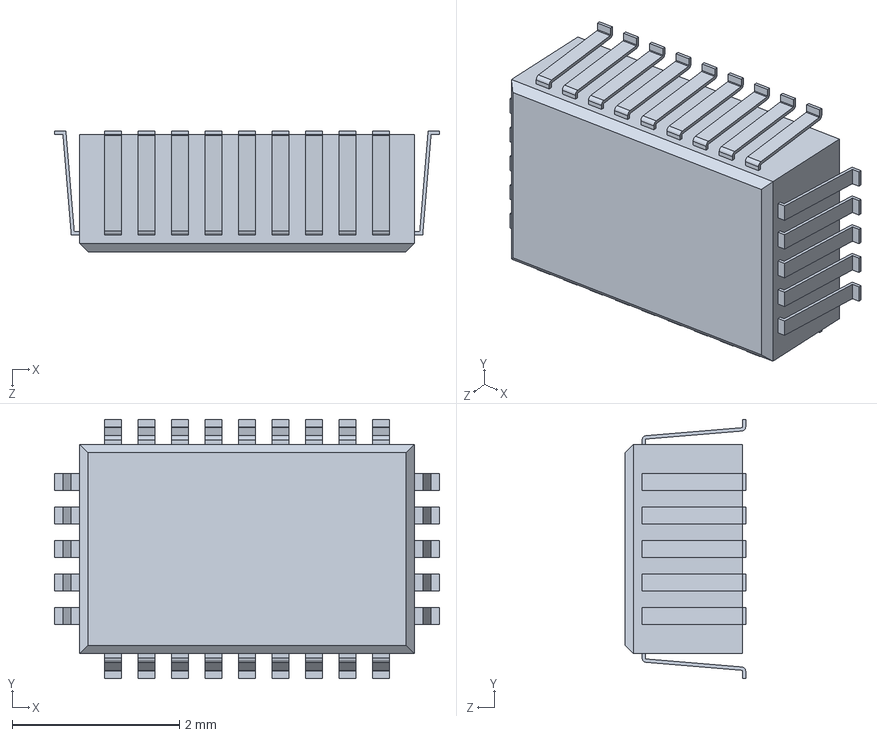
[picture p89: CAD file, 2015-04-01]
Materiais/Mecânica/Modelo/Solidworks/Estrutura/v01.2/Cubesat-PCB-Chip03.SLDPRT
4.60 x 3.10 x 1.44 mm
