NSEE/Cubesat-Mec/(list of files, cad)

Other CAD files:
Materiais/Mecânica/Modelo/Solidworks/Inércia/Modelo 02/Cubesat_I_Flywheel_Assembly_Mod02.SLDASM
Materiais/Mecânica/Modelo/Solidworks/Estrutura/v01.2/Cubesat-PCB-Step-Assembly.SLDASM
Materiais/Mecânica/Construção/Arquivos Enviados para Construção/Maquidema - Mayara/150713/v01.1/DWG/Cubesat-Struct-Int-Frame-Side02.DWG
Materiais/Mecânica/Construção/Arquivos Enviados para Construção/Maquidema - Mayara/150814/v01.1/DWG/Cubesat-Struct-Int-Frame-Side01.DWG
Materiais/Mecânica/Construção/Arquivos Enviados para Construção/Maquidema - Mayara/150826/DWG/Cubesat-Struct-Ext-Shell-Side-3U.DWG
Materiais/Mecânica/Construção/Arquivos Enviados para Construção/Mauá - CNC/150703/STEP214/Cubesat-Struct-Int-Frame-Side03.STEP
Materiais/Mecânica/Construção/Arquivos Enviados para Construção/Mauá - Oficina/151203/Arquivos versão final/SLD/Cubesat-Struct-Int-Frame-Side02.SLDPRT
Materiais/Mecânica/Construção/Arquivos Enviados para Construção/Tiago Demay/Arquivos versão final/SLD/Cubesat-Struct-Int-Frame-Side02.SLDPRT
Materiais/Mecânica/Construção/Folha de Processos/Corte a Jato D'água/v01.1/DWG/Cubesat-Struct-Int-Frame-Side01.DWG
Materiais/Mecânica/Construção/Arquivos Enviados para Construção/Maquidema - Mayara/150713/v01.1/DWG/Cubesat-Struct-Int-Frame-Top.DWG
Materiais/Mecânica/Construção/Arquivos Enviados para Construção/Maquidema - Mayara/150814/v01.1/DWG/Cubesat-Struct-Int-Frame-Side02.DWG
Materiais/Mecânica/Construção/Arquivos Enviados para Construção/Mauá - CNC/150703/Cubesat-Struct-Int-Frame-Side03.SLDPRT
Materiais/Mecânica/Construção/Arquivos Enviados para Construção/Mauá - CNC/150703/STEP203/Cubesat-Struct-Int-Frame-Side01.STEP
Materiais/Mecânica/Construção/Arquivos Enviados para Construção/Mauá - CNC/150703/STEP214/Cubesat-Struct-Int-Frame-Side02.STEP
Materiais/Mecânica/Construção/Folha de Processos/Corte a Jato D'água/v01.1/DWG/Cubesat-Struct-Ext-Shell-Top.DWG
Materiais/Mecânica/Construção/Arquivos Enviados para Construção/Maquidema - Mayara/150713/v01.1/DWG/Cubesat-Struct-Ext-Shell-Top.DWG
Materiais/Mecânica/Construção/Arquivos Enviados para Construção/Mauá - CNC/150703/Cubesat-Struct-Int-Frame-Side02.SLDPRT
Materiais/Mecânica/Construção/Arquivos Enviados para Construção/Mauá - CNC/150703/STEP203/Cubesat-Struct-Int-Frame-Side02.STEP
Materiais/Mecânica/Construção/Arquivos Enviados para Construção/Mauá - CNC/150703/STEP214/Cubesat-Struct-Int-Frame-Side01.STEP
Materiais/Mecânica/Construção/Arquivos Enviados para Construção/Mauá - CNC/151109/Arquivos versão final/SLD/Cubesat-Struct-Int-Frame-Side02.SLDPRT
Materiais/Mecânica/Construção/Folha de Processos/Corte a Jato D'água/v01.1/DWG/Cubesat-Struct-Ext-Shell-Side-1U.DWG
Materiais/Mecânica/Modelo/Solidworks/Inércia/Modelo 08/Cubesat_I_Flywheel_Mod08.SLDPRT
Materiais/Mecânica/Construção/Arquivos Enviados para Construção/Maquidema - Mayara/150713/v01.1/DWG/Cubesat-Struct-Int-Motor-Suport.DWG
Materiais/Mecânica/Construção/Folha de Processos/Corte a Jato D'água/v01.1/DWG/Cubesat-Struct-Int-Frame-Side02.DWG
Materiais/Mecânica/Modelo/Solidworks/Inércia/Modelo 09/Cubesat_I_Flywheel_Mod09.SLDPRT
Materiais/Mecânica/Construção/Arquivos Enviados para Construção/Maquidema - Mayara/150713/v01.1/DWG/Cubesat-Struct-Int-Frame-Side01.DWG
Materiais/Mecânica/Construção/Folha de Processos/Corte a Jato D'água/v01.1/DWG/Cubesat-Struct-Int-Motor-Suport.DWG
Materiais/Mecânica/Construção/Arquivos Enviados para Construção/Maquidema - Mayara/150713/v01.1/DWG/Cubesat-Struct-Ext-Shell-Side-1U.DWG
Materiais/Mecânica/Construção/Folha de Processos/Corte a Jato D'água/v01.1/DWG/Cubesat-Struct-Int-Frame-Top.DWG
Materiais/Mecânica/Modelo/Solidworks/Estrutura/v01.2/Cubesat-Struct-Int-Frame-Side02.SLDPRT
Materiais/Mecânica/Construção/Arquivos Enviados para Construção/Maquidema - Mayara/150713/v01.1/DWG/Cubesat-Struct-Int-Plate-PCBStructHalf.DWG
Materiais/Mecânica/Construção/Folha de Processos/Corte a Jato D'água/v01.1/DWG/Cubesat-Struct-Ext-Shell-Side-3U.DWG
Materiais/Mecânica/Modelo/Solidworks/Estrutura/v01.2/Cubesat-Struct-Int-Frame-Side03.SLDPRT
Materiais/Mecânica/Construção/Arquivos Enviados para Construção/Maquidema - Mayara/150713/v01.1/DWG/Cubesat-Struct-Ext-Shell-Side-3U.DWG
Materiais/Mecânica/Construção/Folha de Processos/Corte a Jato D'água/v01.1/DWG/Cubesat-Struct-Int-Plate-PCBStructHalf.DWG
Materiais/Mecânica/Modelo/Solidworks/Estrutura/v01.2/Cubesat-Struct-Int-Frame-Side01.SLDPRT
Materiais/Mecânica/Modelo/Solidworks/Estrutura/v01.2/Cubesat-PCB-Rail.SLDPRT
Materiais/Mecânica/Modelo/Solidworks/Estrutura/v01.2/Cubesat-PCB-Top.SLDPRT
Materiais/Mecânica/Construção/Arquivos Enviados para Construção/Maquidema - Mayara/150713/v01.1/SLD/Cubesat-Struct-Ext-Shell-Side-1U.SLDDRW
Materiais/Mecânica/Construção/Arquivos Enviados para Construção/Maquidema - Mayara/150713/v01.1/SLD/Cubesat-Struct-Ext-Shell-Side-3U.SLDDRW
Materiais/Mecânica/Construção/Arquivos Enviados para Construção/Maquidema - Mayara/150713/v01.1/SLD/Cubesat-Struct-Ext-Shell-Top.SLDDRW
Materiais/Mecânica/Construção/Arquivos Enviados para Construção/Maquidema - Mayara/150713/v01.1/SLD/Cubesat-Struct-Int-Frame-Side01.SLDDRW
Materiais/Mecânica/Construção/Arquivos Enviados para Construção/Maquidema - Mayara/150713/v01.1/SLD/Cubesat-Struct-Int-Frame-Side02.SLDDRW
Materiais/Mecânica/Construção/Arquivos Enviados para Construção/Maquidema - Mayara/150713/v01.1/SLD/Cubesat-Struct-Int-Frame-Top.SLDDRW
Materiais/Mecânica/Construção/Arquivos Enviados para Construção/Maquidema - Mayara/150713/v01.1/SLD/Cubesat-Struct-Int-Motor-Suport.SLDDRW
Materiais/Mecânica/Construção/Arquivos Enviados para Construção/Maquidema - Mayara/150713/v01.1/SLD/Cubesat-Struct-Int-Plate-PCBStructHalf.SLDDRW
Materiais/Mecânica/Construção/Arquivos Enviados para Construção/Maquidema - Mayara/150814/v01.1/SLD/Cubesat-Struct-Int-Frame-Side01.SLDDRW
Materiais/Mecânica/Construção/Arquivos Enviados para Construção/Maquidema - Mayara/150814/v01.1/SLD/Cubesat-Struct-Int-Frame-Side02.SLDDRW
Materiais/Mecânica/Construção/Arquivos Enviados para Construção/Maquidema - Mayara/150826/SLD/Cubesat-Struct-Ext-Shell-Side-3U.SLDDRW
Materiais/Mecânica/Construção/Arquivos Enviados para Construção/Mauá - CNC/151109/Arquivos Corte à Jato D'água/SLD/Cubesat-Struct-Int-Frame-Side01.SLDDRW
Materiais/Mecânica/Construção/Arquivos Enviados para Construção/Mauá - CNC/151109/Arquivos Corte à Jato D'água/SLD/Cubesat-Struct-Int-Frame-Side02.SLDDRW
Materiais/Mecânica/Construção/Arquivos Enviados para Construção/Tiago Demay/Arquivos Corte à Jato D'água/SLD/Cubesat-Struct-Ext-Shell-Side-3U.SLDDRW
Materiais/Mecânica/Construção/Arquivos Enviados para Construção/Tiago Demay/Arquivos Corte à Jato D'água/SLD/Cubesat-Struct-Int-Frame-Side01.SLDDRW
Materiais/Mecânica/Construção/Arquivos Enviados para Construção/Tiago Demay/Arquivos Corte à Jato D'água/SLD/Cubesat-Struct-Int-Frame-Side02.SLDDRW
Materiais/Mecânica/Construção/Dimensões PCB/v01.1/Cubesat-PCB-Side.SLDDRW
Materiais/Mecânica/Construção/Dimensões PCB/v01.1/Cubesat-PCB-Top.SLDDRW
Materiais/Mecânica/Construção/Folha de Processos/Completa/v01.1/Cubesat-1U-Assembly.SLDDRW
Materiais/Mecânica/Construção/Folha de Processos/Completa/v01.1/Cubesat-Struct-Ext-Shell-Side-1U.SLDDRW
Materiais/Mecânica/Construção/Folha de Processos/Completa/v01.1/Cubesat-Struct-Ext-Shell-Side-3U.SLDDRW
Materiais/Mecânica/Construção/Folha de Processos/Completa/v01.1/Cubesat-Struct-Ext-Shell-Top.SLDDRW
Materiais/Mecânica/Construção/Folha de Processos/Completa/v01.1/Cubesat-Struct-Int-Frame-Side01.SLDDRW
Materiais/Mecânica/Construção/Folha de Processos/Completa/v01.1/Cubesat-Struct-Int-Frame-Side02.SLDDRW
Materiais/Mecânica/Construção/Folha de Processos/Completa/v01.1/Cubesat-Struct-Int-Frame-Side03.SLDDRW
Materiais/Mecânica/Construção/Folha de Processos/Completa/v01.1/Cubesat-Struct-Int-Frame-Top.SLDDRW
Materiais/Mecânica/Construção/Folha de Processos/Completa/v01.1/Cubesat-Struct-Int-Plate-PCBStructHalf.SLDDRW
Materiais/Mecânica/Construção/Folha de Processos/Completa/v01/Cubesat-1U-Assembly.SLDDRW
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
