NSEE/Cubesat-Mec/Materiais/Arquivos/Relatórios/Manual Montagem/apresentacao.tex

\section{Apresentação}

Neste documento será apresentado instruções de montagem do CubeSat, é recomendável a leitura prévia do  \textbf{\href{http://www.cubesat.org/images/developers/cds_rev13_final.pdf}{CubeSat Design Specification}} para conhecimento dos padrões internacionais a serem seguidos pelo projeto.

Estaremos exemplificando a princípio com um CubeSat 1U, e posteriormente com um CubeSat 3U, as especificações de dimensões estão descritas no documento acima nas sessões 01 e 04, respectivamente.

Os desenhos com dimensões das peças e as folhas de processos estão em um documento à parte: \textbf{Folhas de Processos}

A relação de número dos furos está na folha de processos.
