NSEE/Cubesat-Mec/Materiais/Mecânica/Construção/Arquivos Enviados para Construção/Mauá - Oficina/150326/Cubesat-Struct-Int-Frame-Side01.PDF

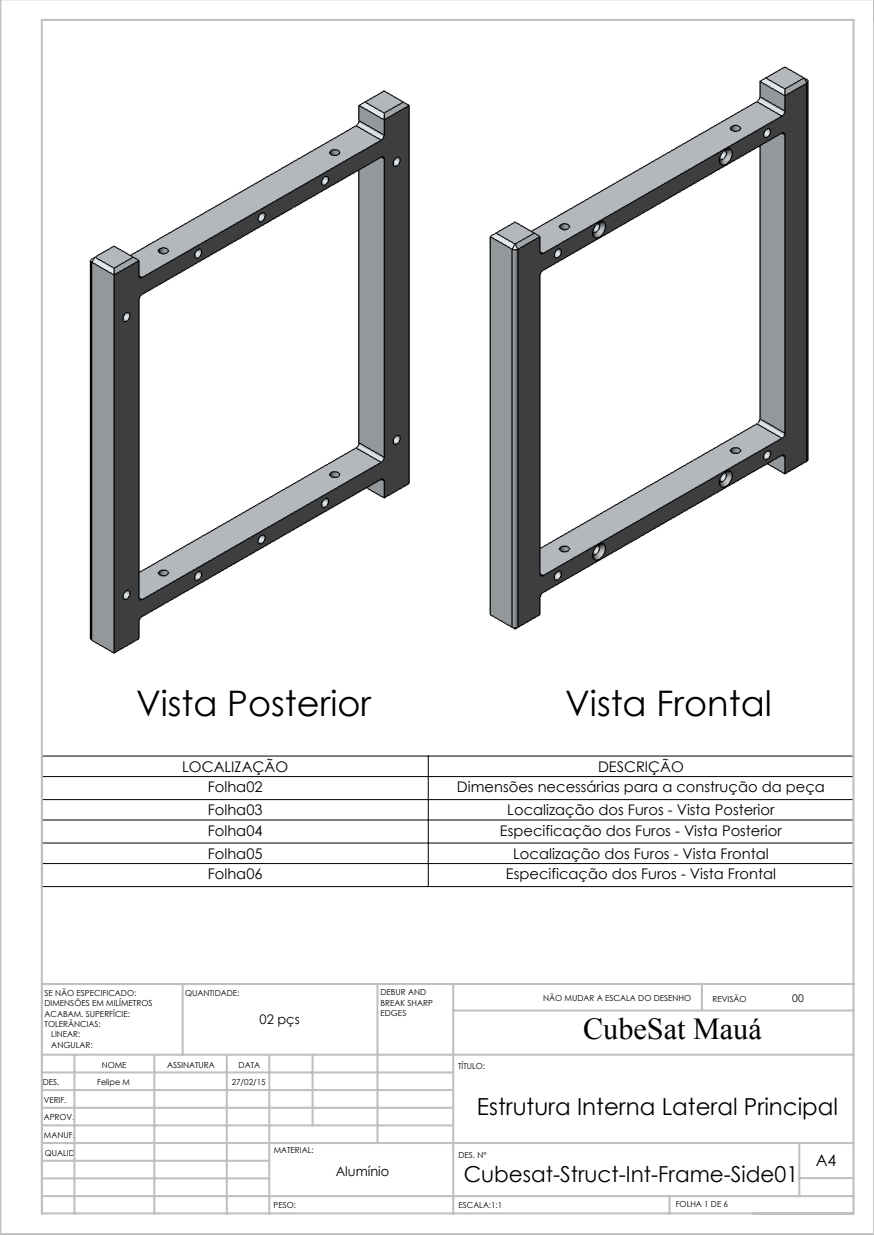
[picture p127: page 1]
Vista Posterior; Vista Frontal; CubeSat Mauá; 02 pçs; ESCALA:1:1; FOLHA 1 DE 6; NÃO MUDAR A ESCALA DO DESENHO; REVISÃO; DEBUR AND BREAK SHARP; SE NÃO ESPECIFICADO:; QUANTIDADE:

LOCALIZAÇÃO | DESCRIÇÃO
Folha02 | Dimensões necessárias para a construção da peça
Folha03 | Localização dos Furos - Vista Posterior
Folha04 | Especificação dos Furos - Vista Posterior
Folha05 | Localização dos Furos - Vista Frontal
Folha06 | Especificação dos Furos - Vista Frontal

DIMENSÕES EM MILÍMETROS
ACABAM. SUPERFÍCIE:
TOLERÂNCIAS:
LINEAR:
ANGULAR:

NOME | ASSINATURA | DATA | | | | TÍTULO: Estrutura Interna Lateral Principal

DES. | Felipe M | | 27/02/15
VERIF.
APROV.
MANUF.
QUALID | | | | MATERIAL: Alumínio | DES. Nº Cubesat-Struct-Int-Frame-Side01 | A4

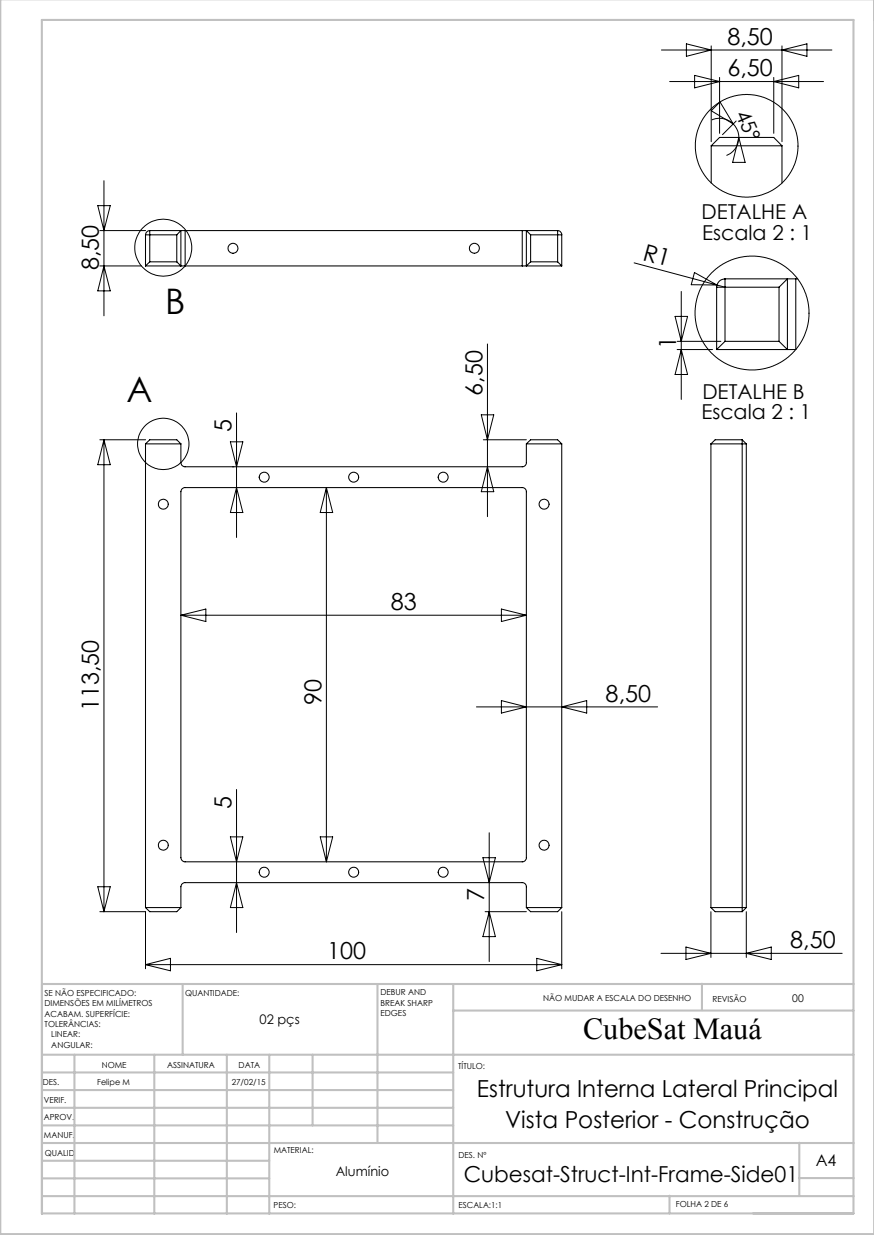
[picture p128: page 2]
DETALHE A Escala 2 : 1; DETALHE B Escala 2 : 1; CubeSat Mauá; 02 pçs; NÃO MUDAR A ESCALA DO DESENHO; REVISÃO; DEBUR AND BREAK SHARP; SE NÃO ESPECIFICADO:; QUANTIDADE:

DIMENSÕES EM MILÍMETROS
ACABAM. SUPERFÍCIE:
TOLERÂNCIAS:
LINEAR:
ANGULAR:

NOME | ASSINATURA | DATA | TÍTULO: Estrutura Interna Lateral Principal Vista Posterior - Construção

DES. | Felipe M | | 27/02/15
VERIF.
APROV.

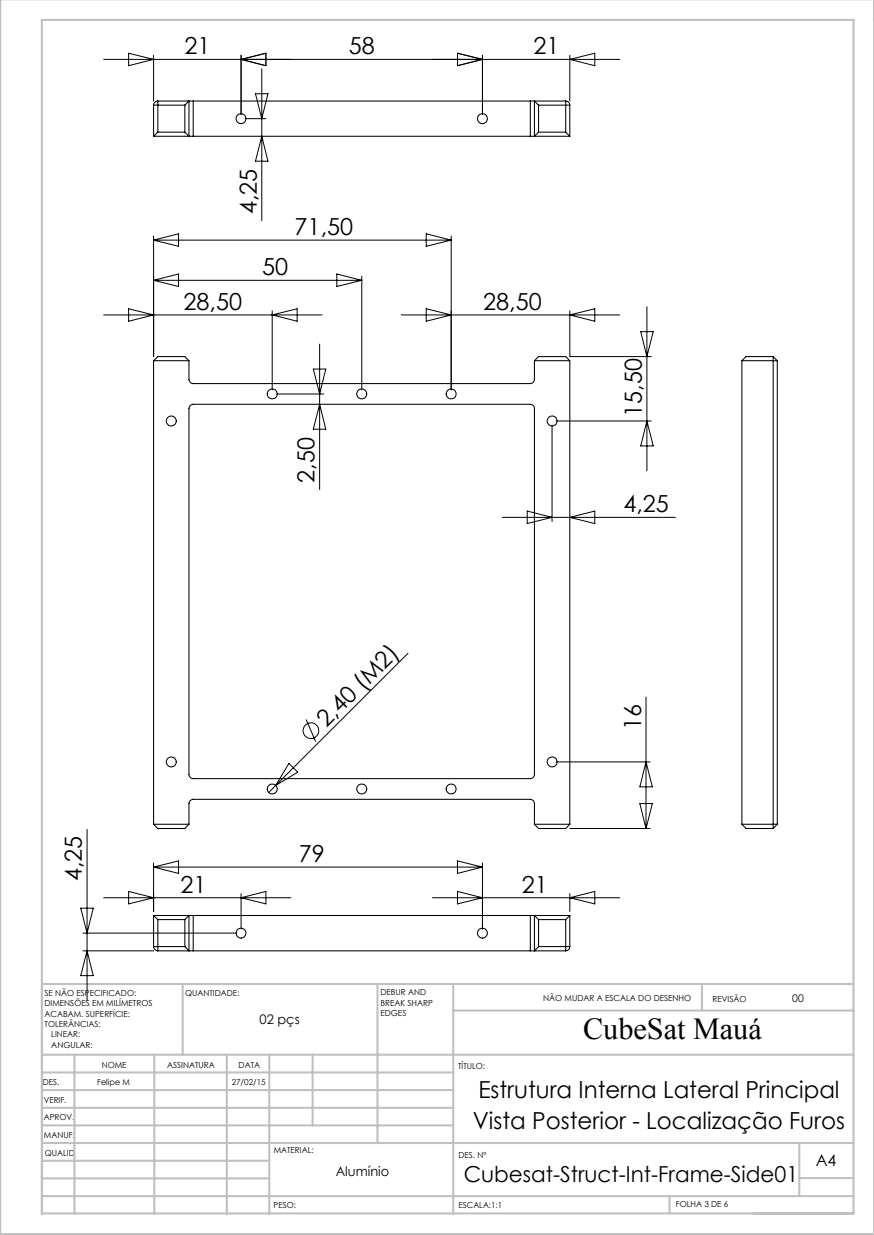
[picture p129: page 3]
CubeSat Mauá; 02 pçs; NÃO MUDAR A ESCALA DO DESENHO; REVISÃO; DEBUR AND BREAK SHARP; SE NÃO ESPECIFICADO:; QUANTIDADE:

DIMENSÕES EM MILÍMETROS
ACABAM. SUPERFÍCIE:
TOLERÂNCIAS:
LINEAR:
ANGULAR:

NOME | ASSINATURA | DATA | TÍTULO: Estrutura Interna Lateral Principal Vista Posterior - Localização Furos

DES. | Felipe M | | 27/02/15
VERIF.
APROV.

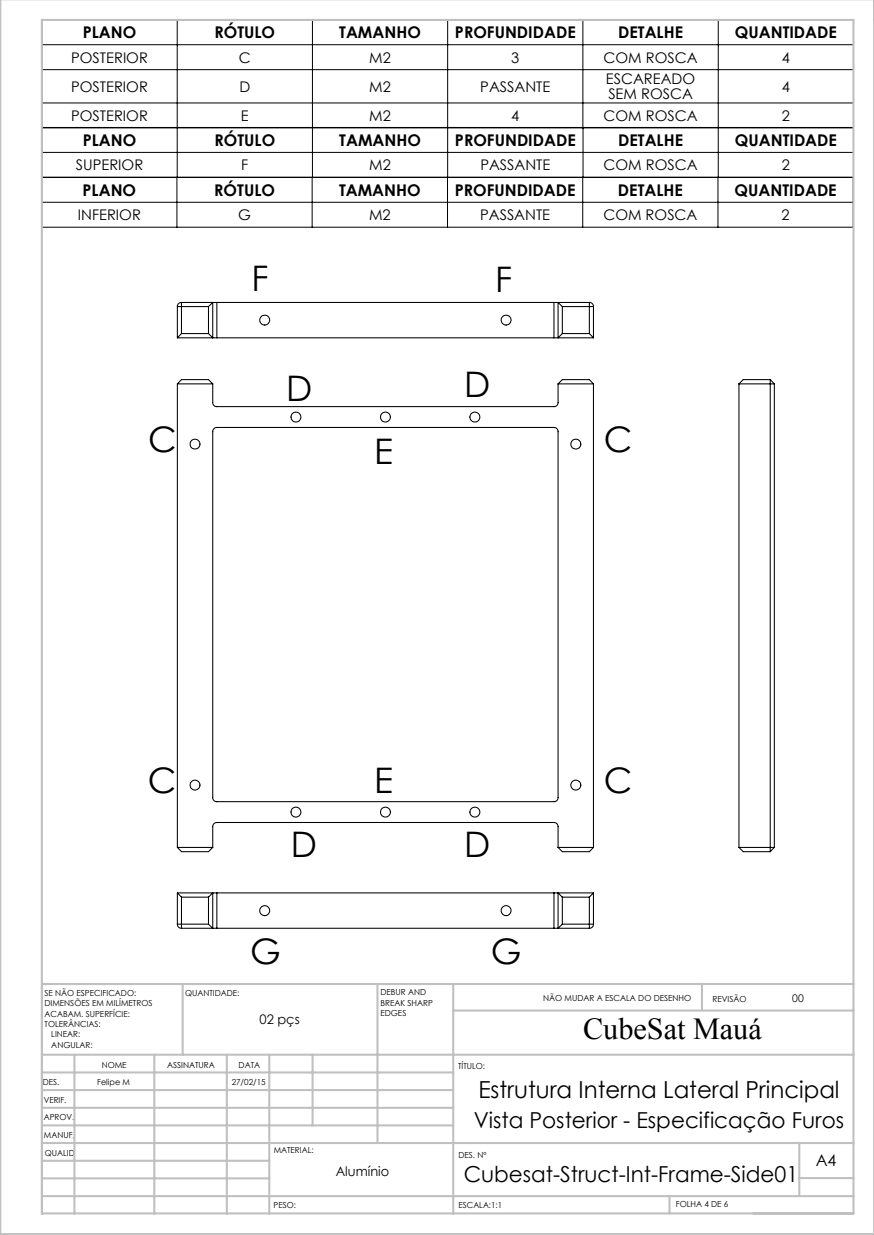
[picture p130: page 4]
CubeSat Mauá; 02 pçs; NÃO MUDAR A ESCALA DO DESENHO; REVISÃO; DEBUR AND BREAK SHARP; SE NÃO ESPECIFICADO:; QUANTIDADE:

PLANO | RÓTULO | TAMANHO | PROFUNDIDADE | DETALHE | QUANTIDADE
POSTERIOR | C | M2 | 3 | COM ROSCA | 4
POSTERIOR | D | M2 | PASSANTE | ESCAREADO SEM ROSCA | 4
POSTERIOR | E | M2 | 4 | COM ROSCA | 2
SUPERIOR | F | M2 | PASSANTE | COM ROSCA | 2
INFERIOR | G | M2 | PASSANTE | COM ROSCA | 2

DIMENSÕES EM MILÍMETROS
ACABAM. SUPERFÍCIE:
TOLERÂNCIAS:
LINEAR:
ANGULAR:

NOME | ASSINATURA | DATA | TÍTULO: Estrutura Interna Lateral Principal Vista Posterior - Especificação Furos

DES. | Felipe M | | 27/02/15
VERIF.
APROV.

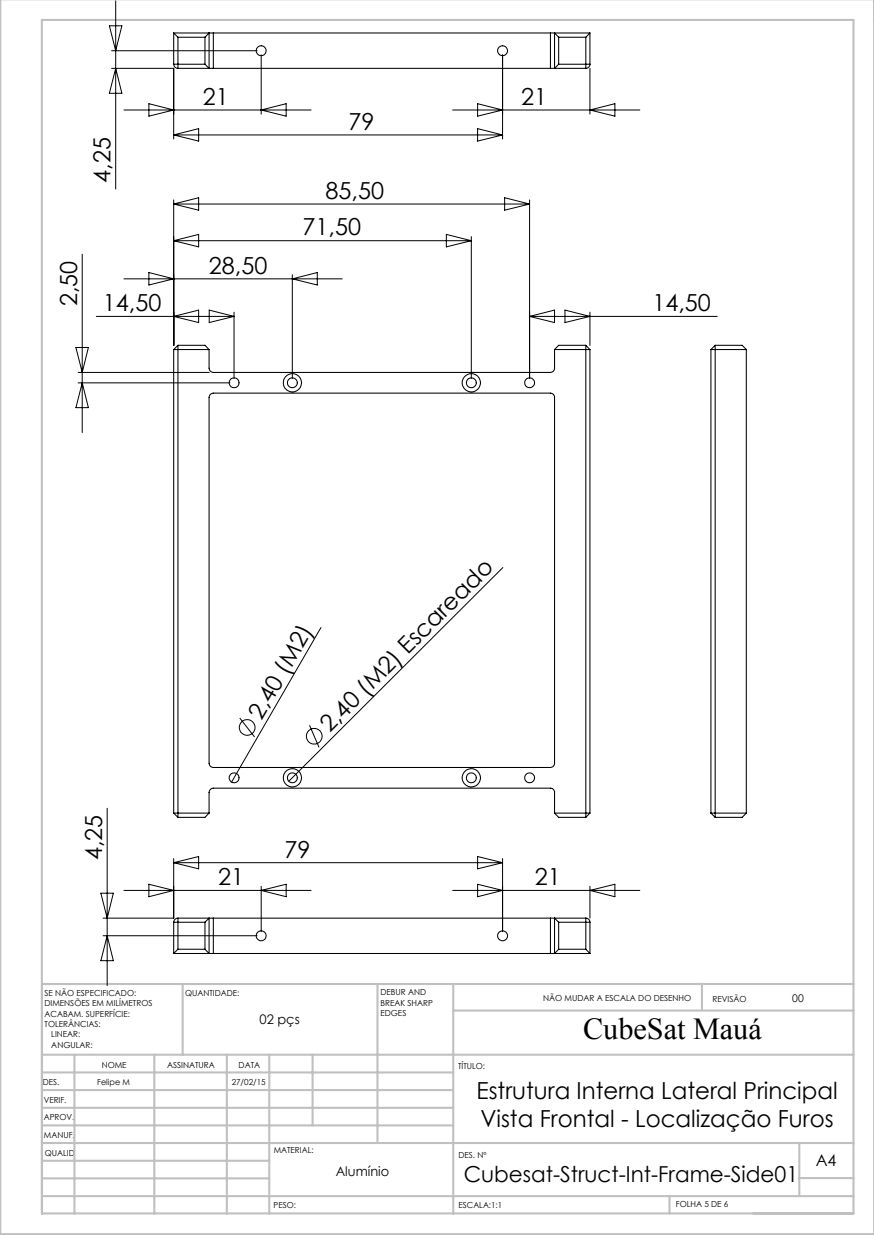
[picture p131: page 5]
2,40 (M2) Escareado; CubeSat Mauá; 02 pçs; NÃO MUDAR A ESCALA DO DESENHO; REVISÃO; DEBUR AND BREAK SHARP; SE NÃO ESPECIFICADO:; QUANTIDADE:

DIMENSÕES EM MILÍMETROS
ACABAM. SUPERFÍCIE:
TOLERÂNCIAS:
LINEAR:
ANGULAR:

NOME | ASSINATURA | DATA | TÍTULO: Estrutura Interna Lateral Principal Vista Frontal - Localização Furos

DES. | Felipe M | | 27/02/15
VERIF.
APROV.

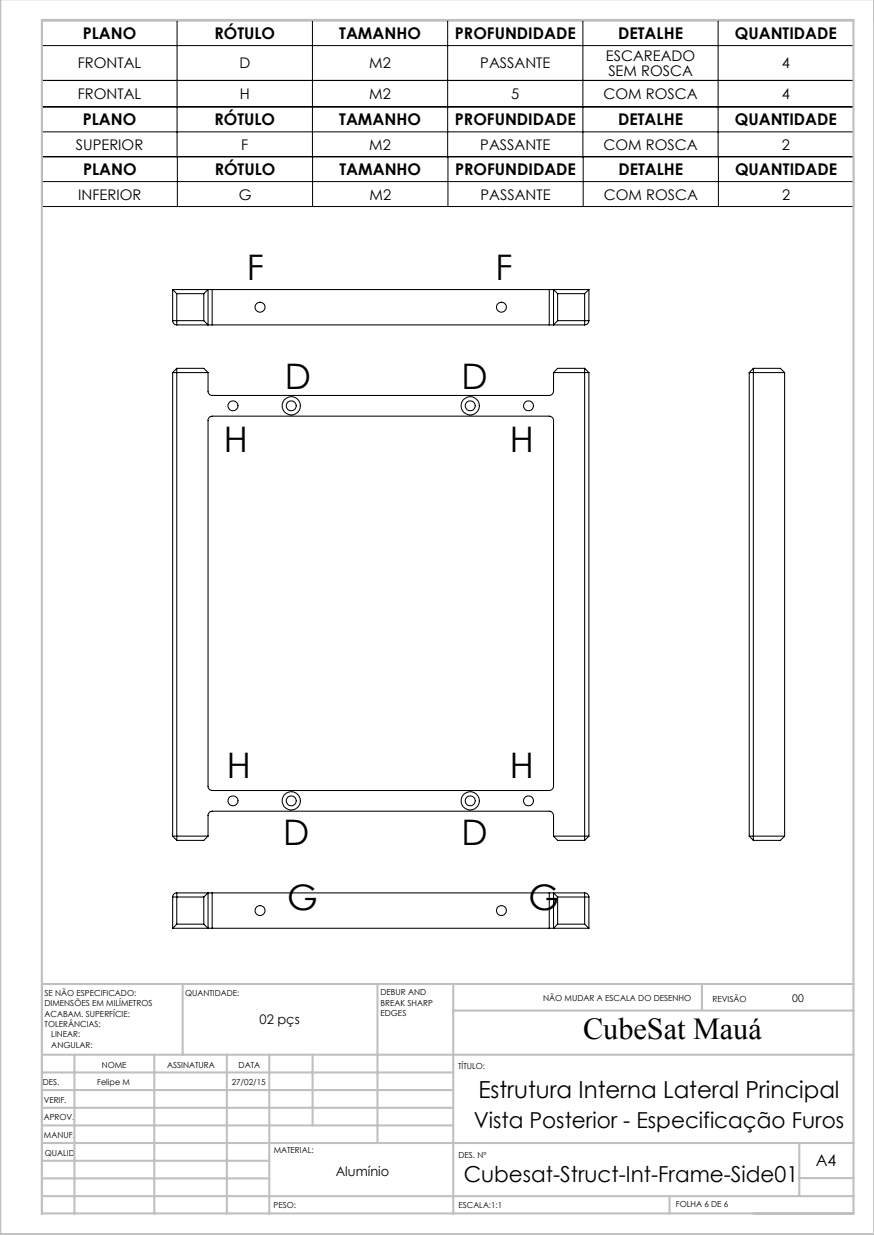
[picture p132: page 6]
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

PLANO | RÓTULO | TAMANHO | PROFUNDIDADE | DETALHE | QUANTIDADE
FRONTAL | D | M2 | PASSANTE | ESCAREADO SEM ROSCA | 4

FRONTAL | H | M2 | 5 | COM ROSCA | 4
SUPERIOR | F | M2 | PASSANTE | COM ROSCA | 2
INFERIOR | G | M2 | PASSANTE | COM ROSCA | 2

DIMENSÕES EM MILÍMETROS
ACABAM. SUPERFÍCIE:
TOLERÂNCIAS:
LINEAR:
ANGULAR:

NOME | ASSINATURA | DATA | TÍTULO: Estrutura Interna Lateral Principal Vista Posterior - Especificação Furos

DES. | Felipe M | | 27/02/15
VERIF.
APROV.
