NSEE/Cubesat-Mec/Materiais/Mecânica/Construção/Arquivos Enviados para Construção/Mauá - Oficina/150326/Cubesat-Struct-Int-Frame-Side03.PDF

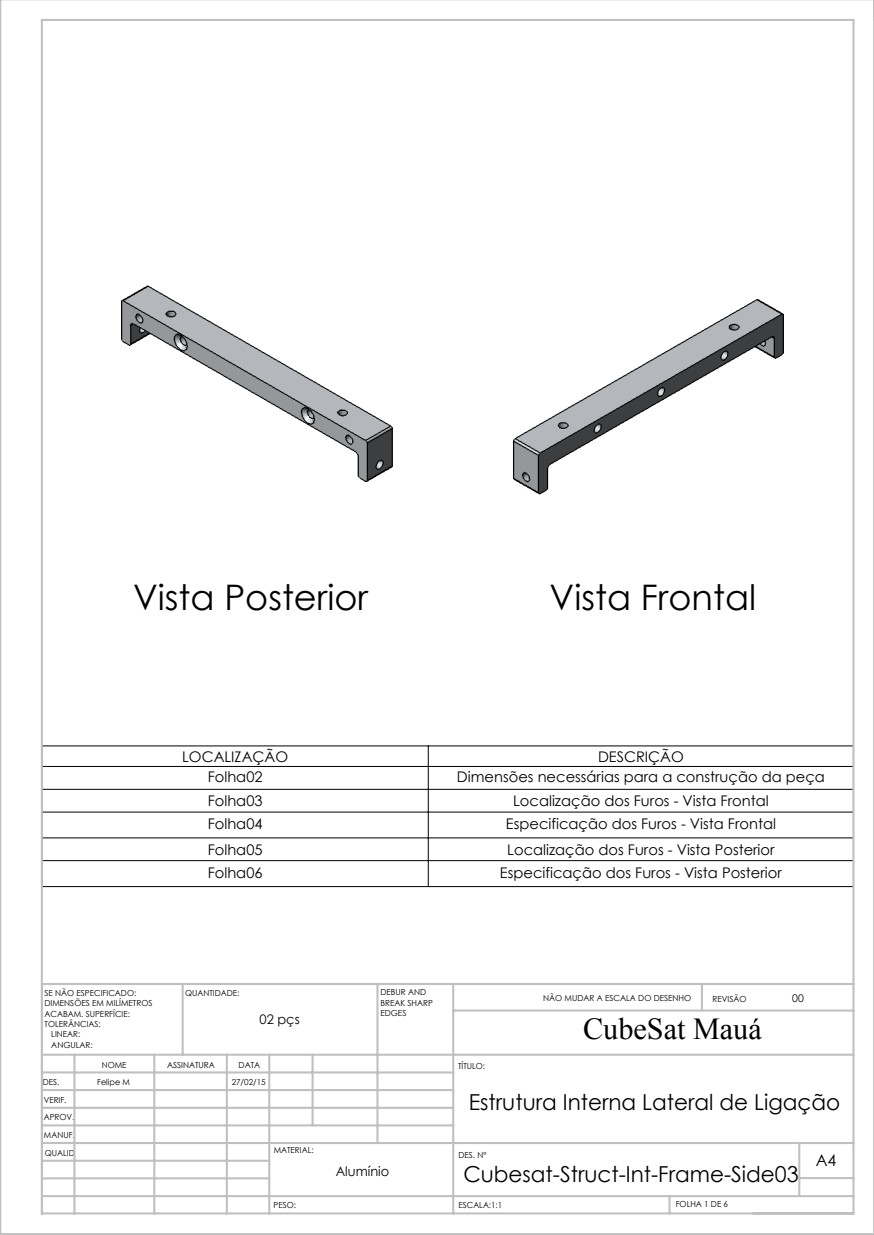
[picture p139: page 1]
Vista Posterior; Vista Frontal; CubeSat Mauá; 02 pçs; ESCALA:1:1; FOLHA 1 DE 6; NÃO MUDAR A ESCALA DO DESENHO; REVISÃO; DEBUR AND BREAK SHARP; SE NÃO ESPECIFICADO:; QUANTIDADE:

LOCALIZAÇÃO | DESCRIÇÃO
Folha02 | Dimensões necessárias para a construção da peça
Folha03 | Localização dos Furos - Vista Frontal
Folha04 | Especificação dos Furos - Vista Frontal
Folha05 | Localização dos Furos - Vista Posterior
Folha06 | Especificação dos Furos - Vista Posterior

DIMENSÕES EM MILÍMETROS
ACABAM. SUPERFÍCIE:
TOLERÂNCIAS:
LINEAR:
ANGULAR:

NOME | ASSINATURA | DATA | | | | TÍTULO: Estrutura Interna Lateral de Ligação

DES. | Felipe M | | 27/02/15
VERIF.
APROV.
MANUF.
QUALID | | | | MATERIAL: Alumínio | DES. Nº Cubesat-Struct-Int-Frame-Side03 | A4

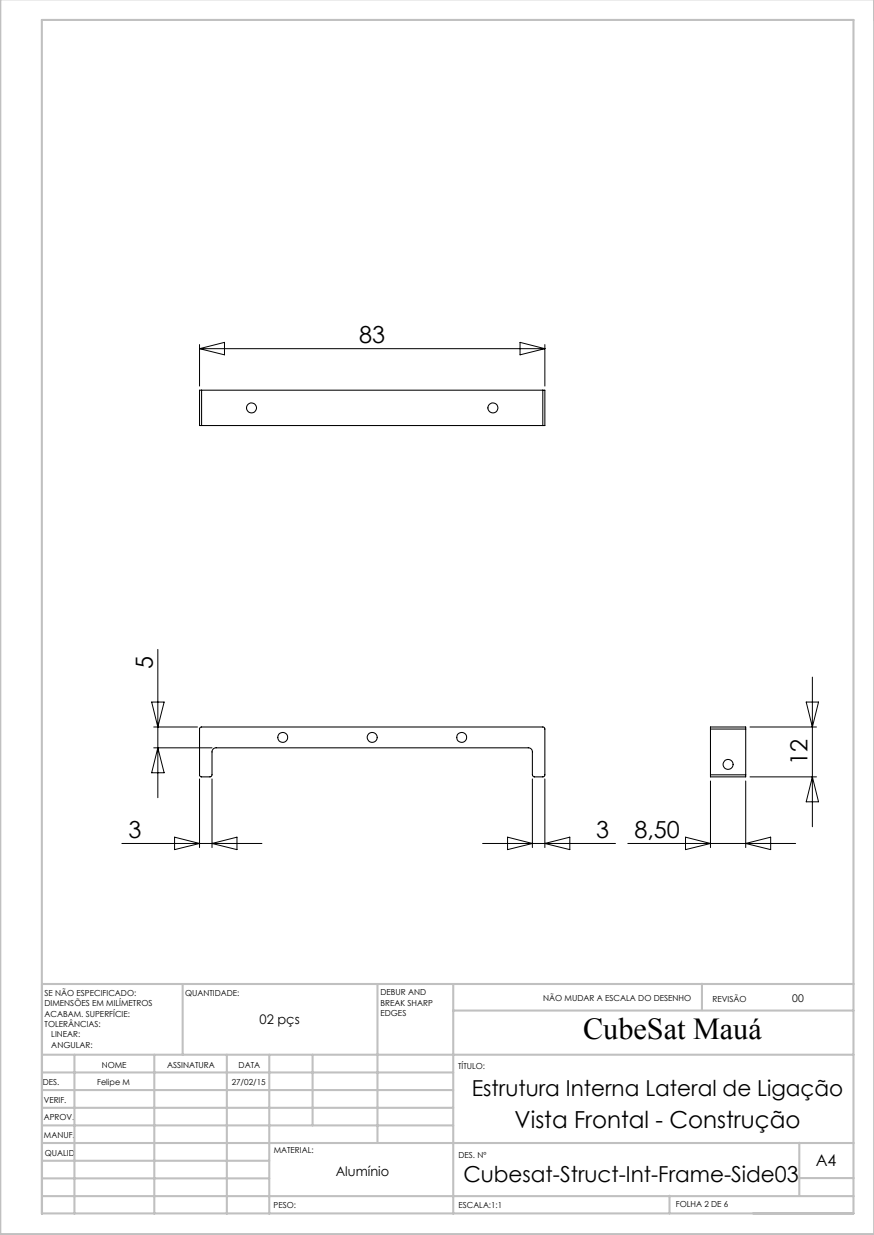
[picture p140: page 2]
CubeSat Mauá; 02 pçs; NÃO MUDAR A ESCALA DO DESENHO; REVISÃO; DEBUR AND BREAK SHARP; SE NÃO ESPECIFICADO:; QUANTIDADE:

DIMENSÕES EM MILÍMETROS
ACABAM. SUPERFÍCIE:
TOLERÂNCIAS:
LINEAR:
ANGULAR:

NOME | ASSINATURA | DATA | TÍTULO: Estrutura Interna Lateral de Ligação Vista Frontal - Construção

DES. | Felipe M | | 27/02/15
VERIF.
APROV.

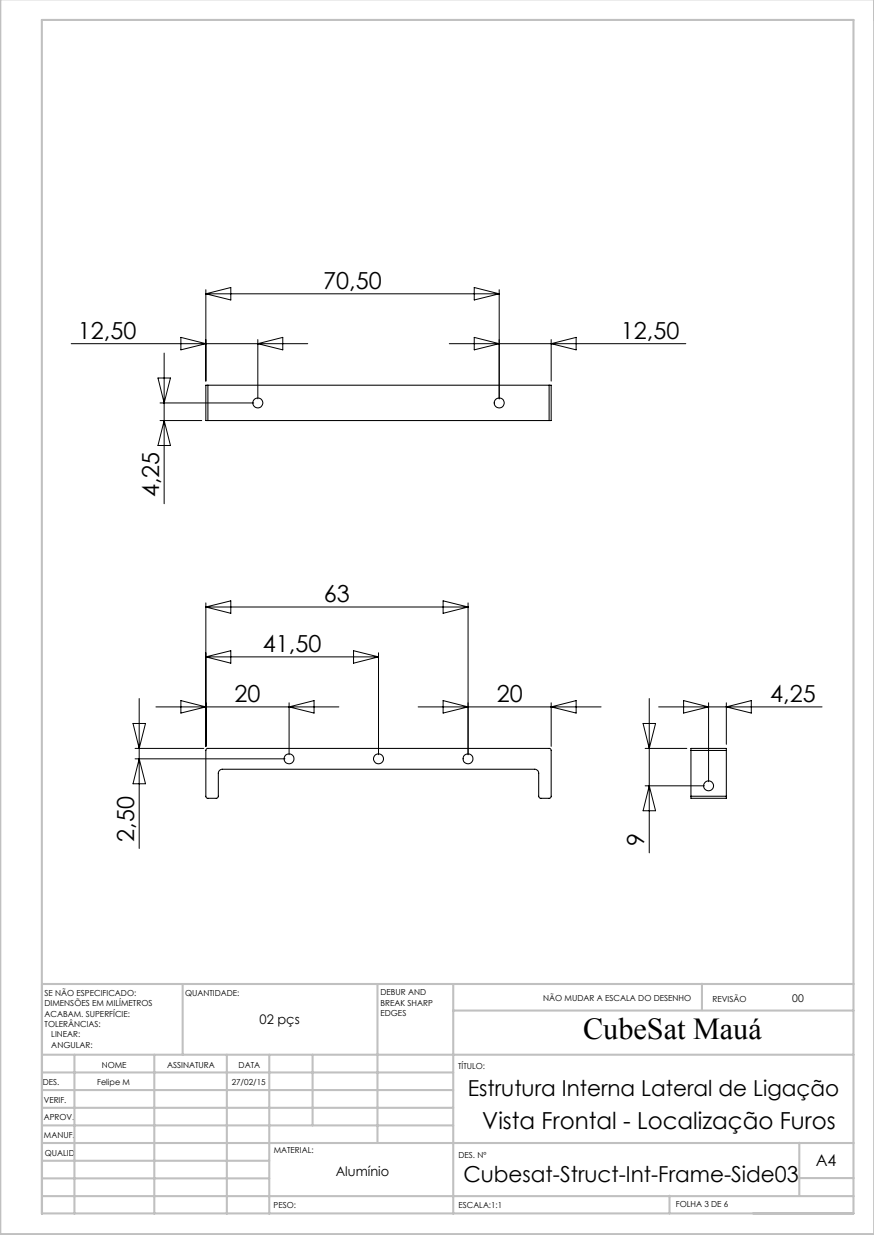
[picture p141: page 3]
CubeSat Mauá; 02 pçs; NÃO MUDAR A ESCALA DO DESENHO; REVISÃO; DEBUR AND BREAK SHARP; SE NÃO ESPECIFICADO:; QUANTIDADE:

DIMENSÕES EM MILÍMETROS
ACABAM. SUPERFÍCIE:
TOLERÂNCIAS:
LINEAR:
ANGULAR:

NOME | ASSINATURA | DATA | TÍTULO: Estrutura Interna Lateral de Ligação Vista Frontal - Localização Furos

DES. | Felipe M | | 27/02/15
VERIF.
APROV.

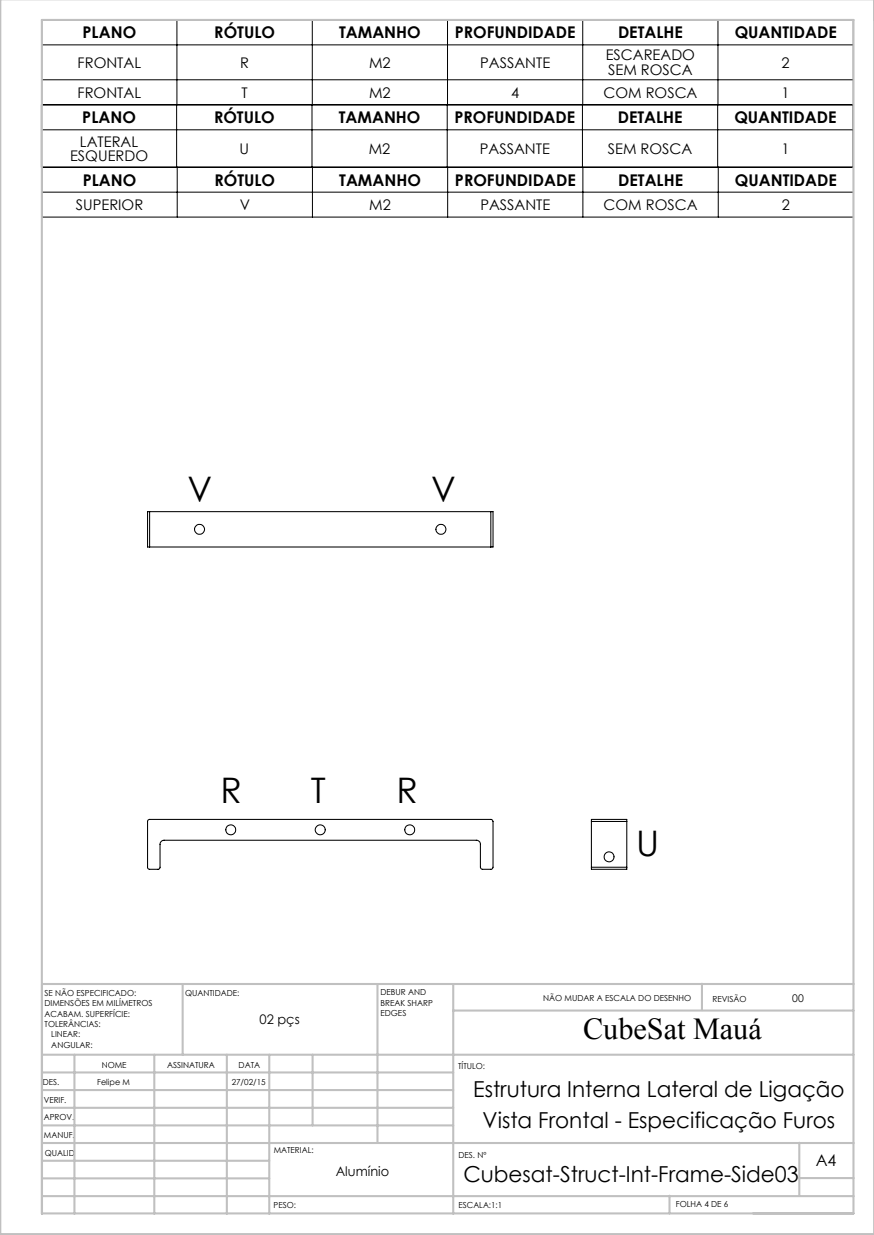
[picture p142: page 4]
CubeSat Mauá; 02 pçs; NÃO MUDAR A ESCALA DO DESENHO; REVISÃO; DEBUR AND BREAK SHARP; SE NÃO ESPECIFICADO:; QUANTIDADE:

PLANO | RÓTULO | TAMANHO | PROFUNDIDADE | DETALHE | QUANTIDADE
FRONTAL | R | M2 | PASSANTE | ESCAREADO SEM ROSCA | 2
FRONTAL | T | M2 | 4 | COM ROSCA | 1
LATERAL ESQUERDO | U | M2 | PASSANTE | SEM ROSCA | 1
SUPERIOR | V | M2 | PASSANTE | COM ROSCA | 2

DIMENSÕES EM MILÍMETROS
ACABAM. SUPERFÍCIE:
TOLERÂNCIAS:
LINEAR:
ANGULAR:

NOME | ASSINATURA | DATA | TÍTULO: Estrutura Interna Lateral de Ligação Vista Frontal - Especificação Furos

DES. | Felipe M | | 27/02/15
VERIF.
APROV.

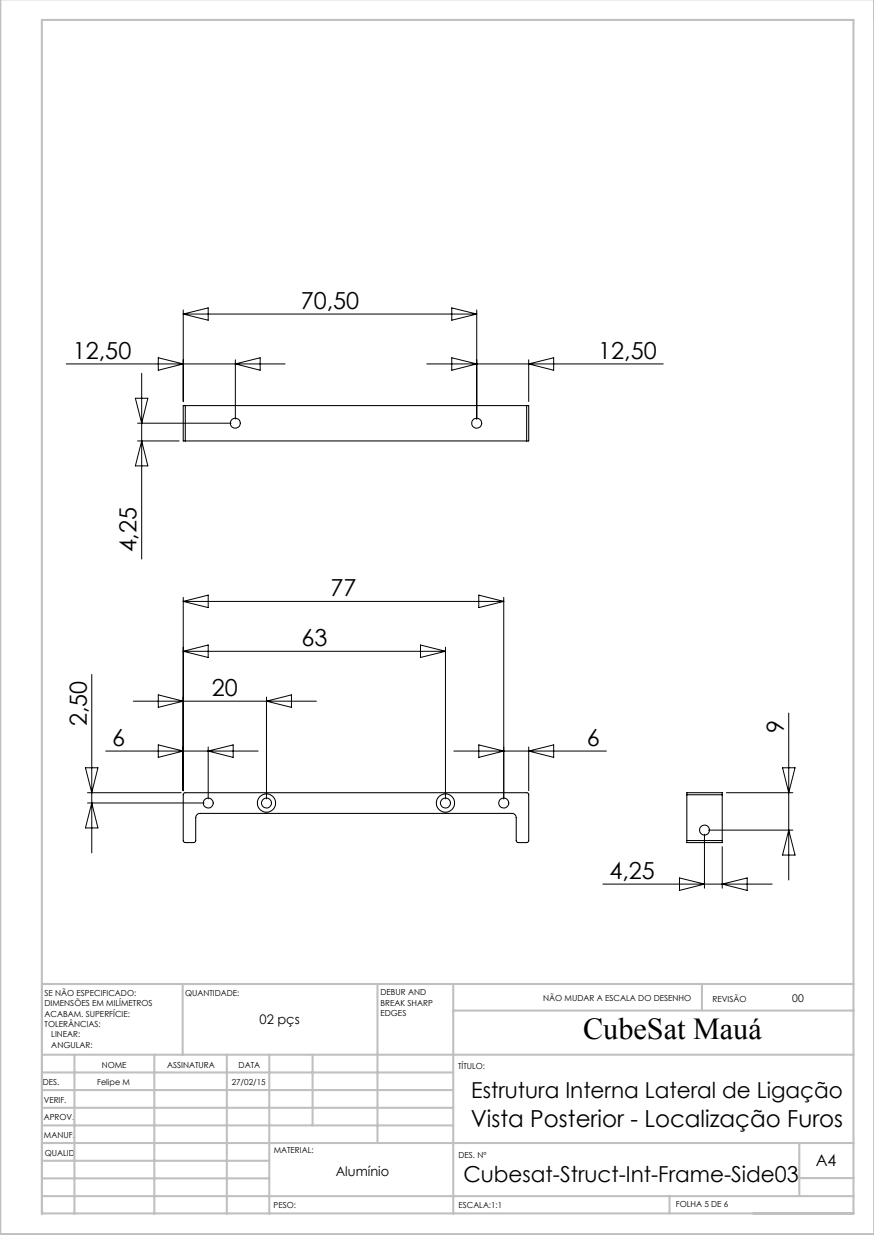
[picture p143: page 5]
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

DIMENSÕES EM MILÍMETROS
ACABAM. SUPERFÍCIE:
TOLERÂNCIAS:
LINEAR:
ANGULAR:

NOME | ASSINATURA | DATA | TÍTULO: Estrutura Interna Lateral de Ligação Vista Posterior - Localização Furos

DES. | Felipe M | | 27/02/15
VERIF.
APROV.

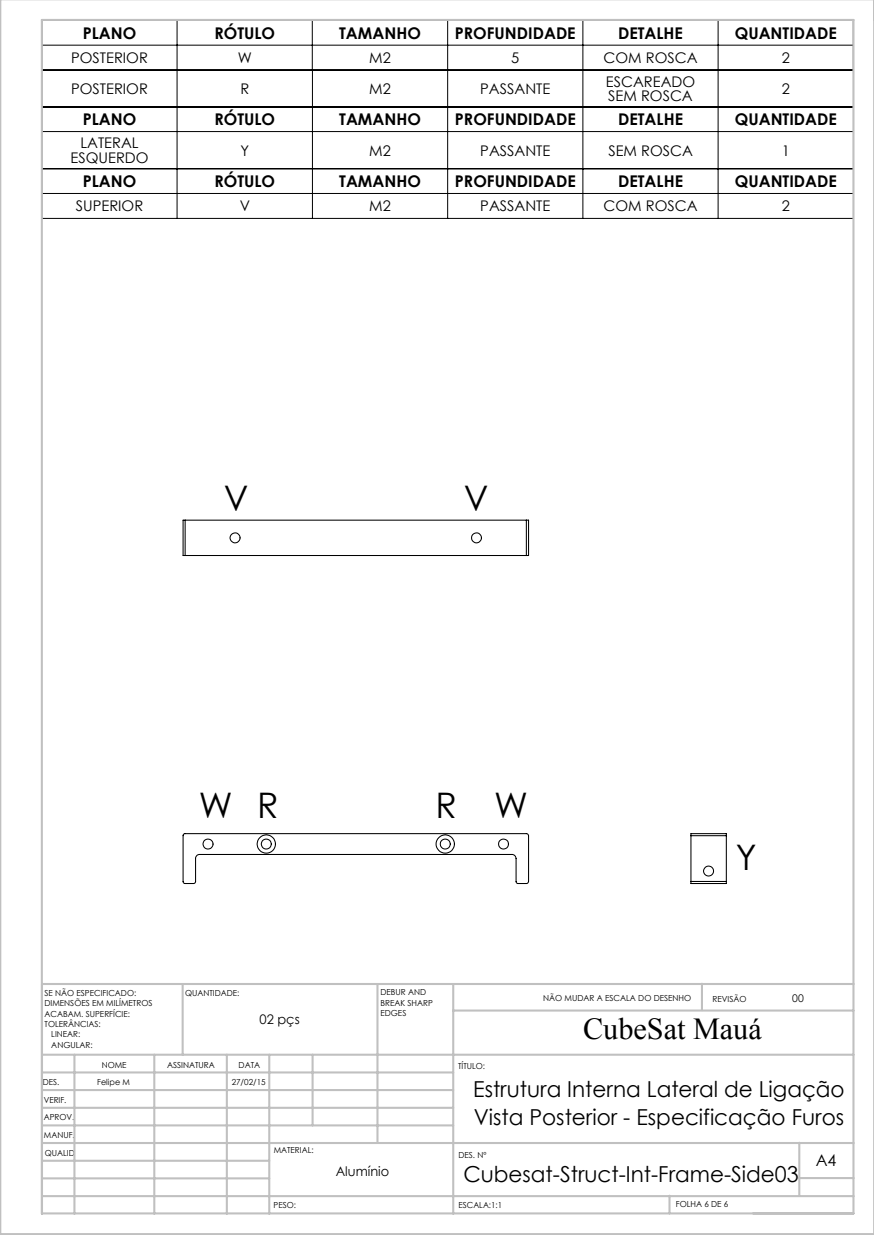
[picture p144: page 6]
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

PLANO | RÓTULO | TAMANHO | PROFUNDIDADE | DETALHE | QUANTIDADE
POSTERIOR | W | M2 | 5 | COM ROSCA | 2
POSTERIOR | R | M2 | PASSANTE | ESCAREADO SEM ROSCA | 2
LATERAL ESQUERDO | Y | M2 | PASSANTE | SEM ROSCA | 1
SUPERIOR | V | M2 | PASSANTE | COM ROSCA | 2

DIMENSÕES EM MILÍMETROS
ACABAM. SUPERFÍCIE:
TOLERÂNCIAS:
LINEAR:
ANGULAR:

NOME | ASSINATURA | DATA | TÍTULO: Estrutura Interna Lateral de Ligação Vista Posterior - Especificação Furos

DES. | Felipe M | | 27/02/15
VERIF.
APROV.
