NSEE/Cubesat-Mec/Materiais/Mecânica/Construção/Arquivos Enviados para Construção/Tiago Demay/Arquivos versão final/PDF/Cubesat-Struct-Int-Frame-Side01.PDF

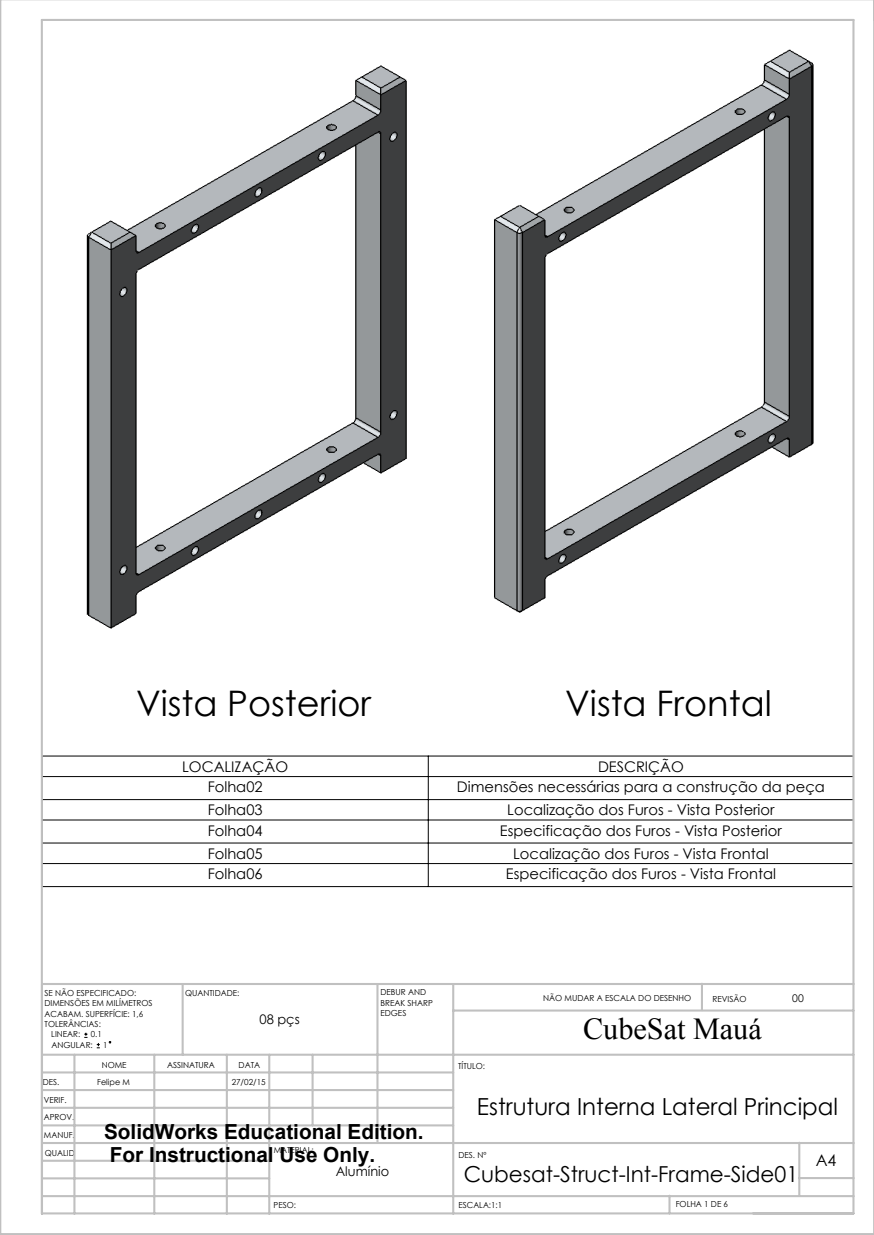
[picture p145: page 1]
Vista Posterior; Vista Frontal; CubeSat Mauá; 08 pçs; ESCALA:1:1; FOLHA 1 DE 6; NÃO MUDAR A ESCALA DO DESENHO; REVISÃO; DEBUR AND BREAK SHARP; SE NÃO ESPECIFICADO:; QUANTIDADE:

LOCALIZAÇÃO | DESCRIÇÃO
Folha02 | Dimensões necessárias para a construção da peça
Folha03 | Localização dos Furos - Vista Posterior
Folha04 | Especificação dos Furos - Vista Posterior
Folha05 | Localização dos Furos - Vista Frontal
Folha06 | Especificação dos Furos - Vista Frontal

DIMENSÕES EM MILÍMETROS
ACABAM. SUPERFÍCIE: 1,6
TOLERÂNCIAS:
LINEAR: 0.1
ANGULAR: 1

NOME | ASSINATURA | DATA | | | | TÍTULO: Estrutura Interna Lateral Principal

DES. | Felipe M | | 27/02/15
VERIF.
APROV.
MANUF. | SolidWorks Educational Edition.
QUALID | For Instructional Use Only. | | | MATERIAL: Alumínio | DES. Nº Cubesat-Struct-Int-Frame-Side01 | A4

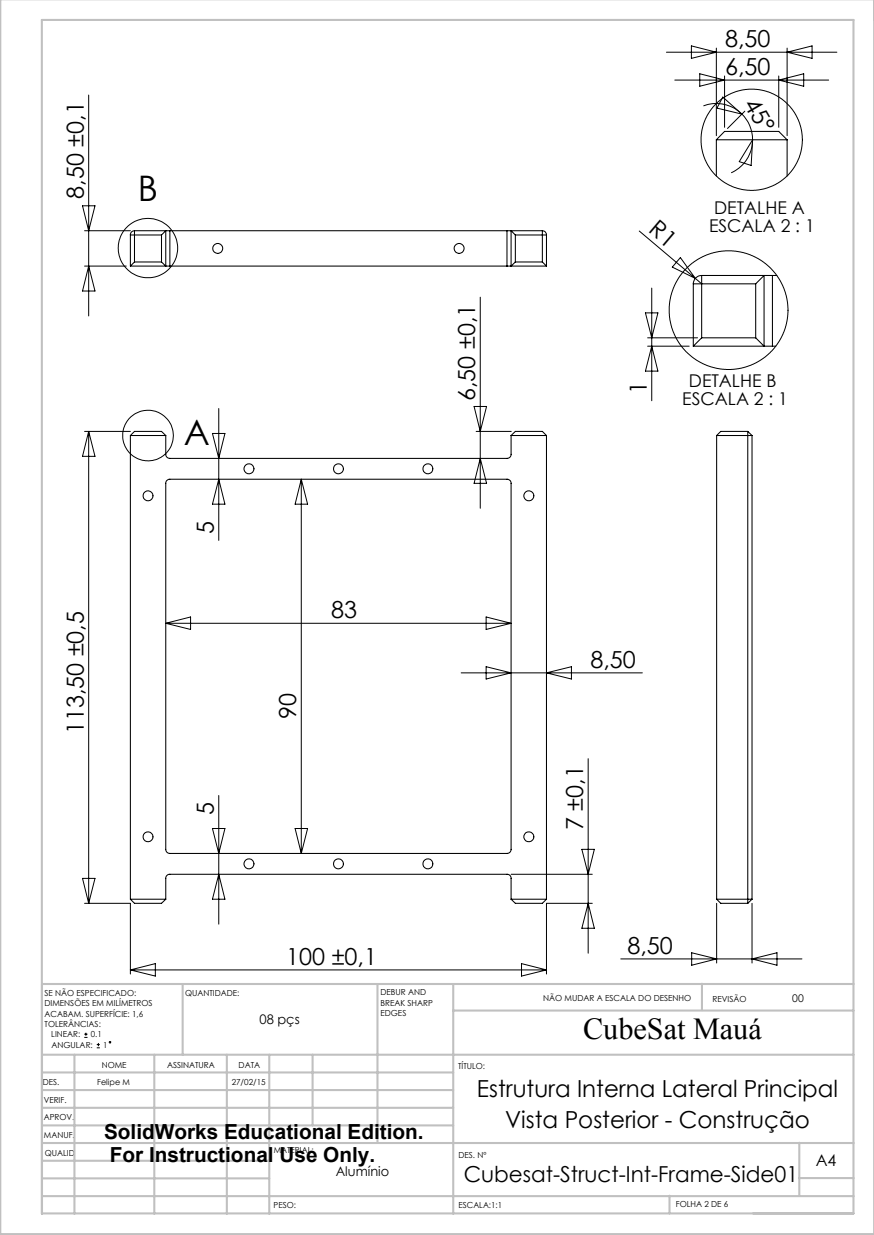
[picture p146: page 2]
DETALHE A ESCALA 2 : 1; DETALHE B ESCALA 2 : 1; CubeSat Mauá; 08 pçs; NÃO MUDAR A ESCALA DO DESENHO; REVISÃO; DEBUR AND BREAK SHARP; SE NÃO ESPECIFICADO:; QUANTIDADE:

DIMENSÕES EM MILÍMETROS
ACABAM. SUPERFÍCIE: 1,6
TOLERÂNCIAS:
LINEAR: 0.1
ANGULAR: 1

NOME | ASSINATURA | DATA | TÍTULO: Estrutura Interna Lateral Principal Vista Posterior - Construção SolidWorks Educational Edition.

DES. | Felipe M | | 27/02/15
VERIF.
APROV.

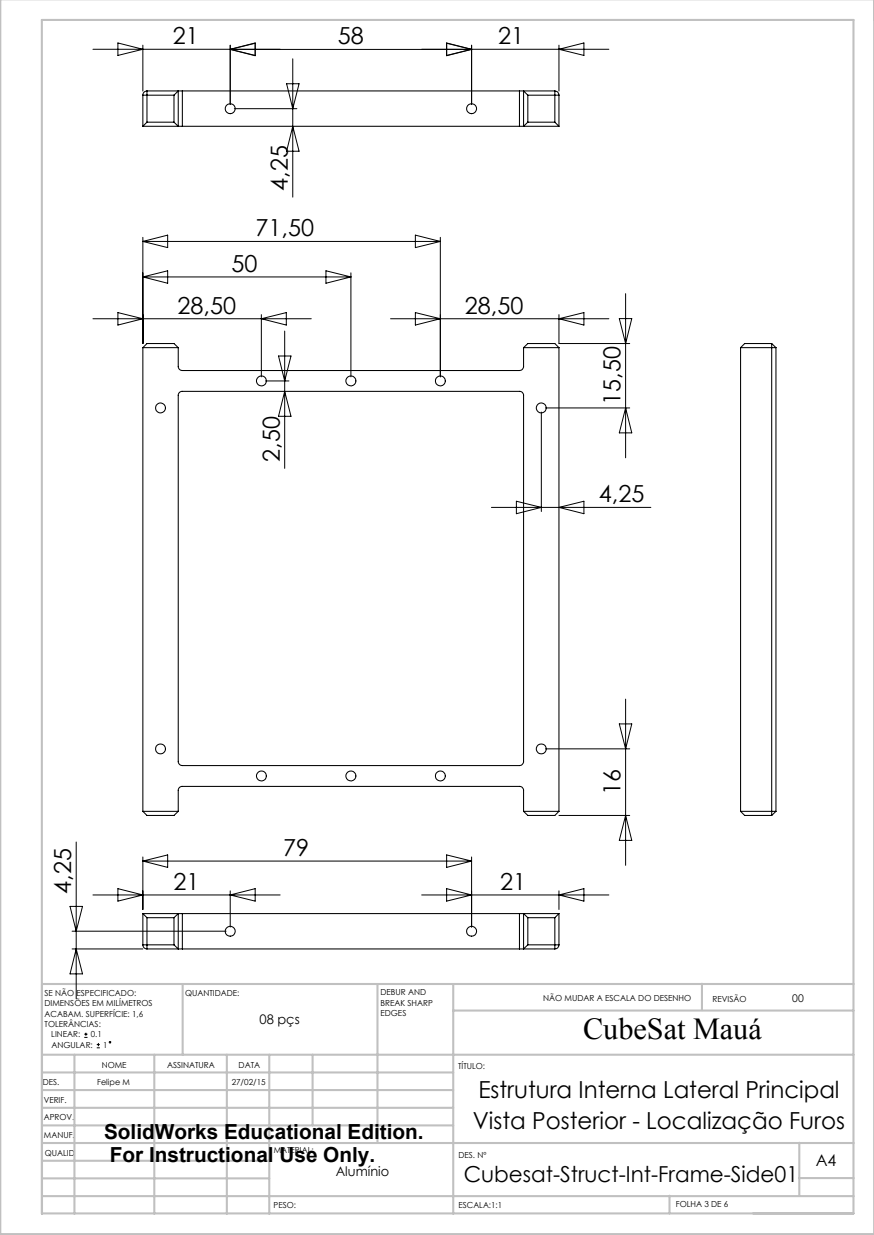
[picture p147: page 3]
CubeSat Mauá; 08 pçs; NÃO MUDAR A ESCALA DO DESENHO; REVISÃO; DEBUR AND BREAK SHARP; SE NÃO ESPECIFICADO:; QUANTIDADE:

DIMENSÕES EM MILÍMETROS
ACABAM. SUPERFÍCIE: 1,6
TOLERÂNCIAS:
LINEAR: 0.1
ANGULAR: 1

NOME | ASSINATURA | DATA | TÍTULO: Estrutura Interna Lateral Principal

DES. | Felipe M | | 27/02/15
VERIF.
APROV. | | | | Vista Posterior - Localização Furos SolidWorks Educational Edition.

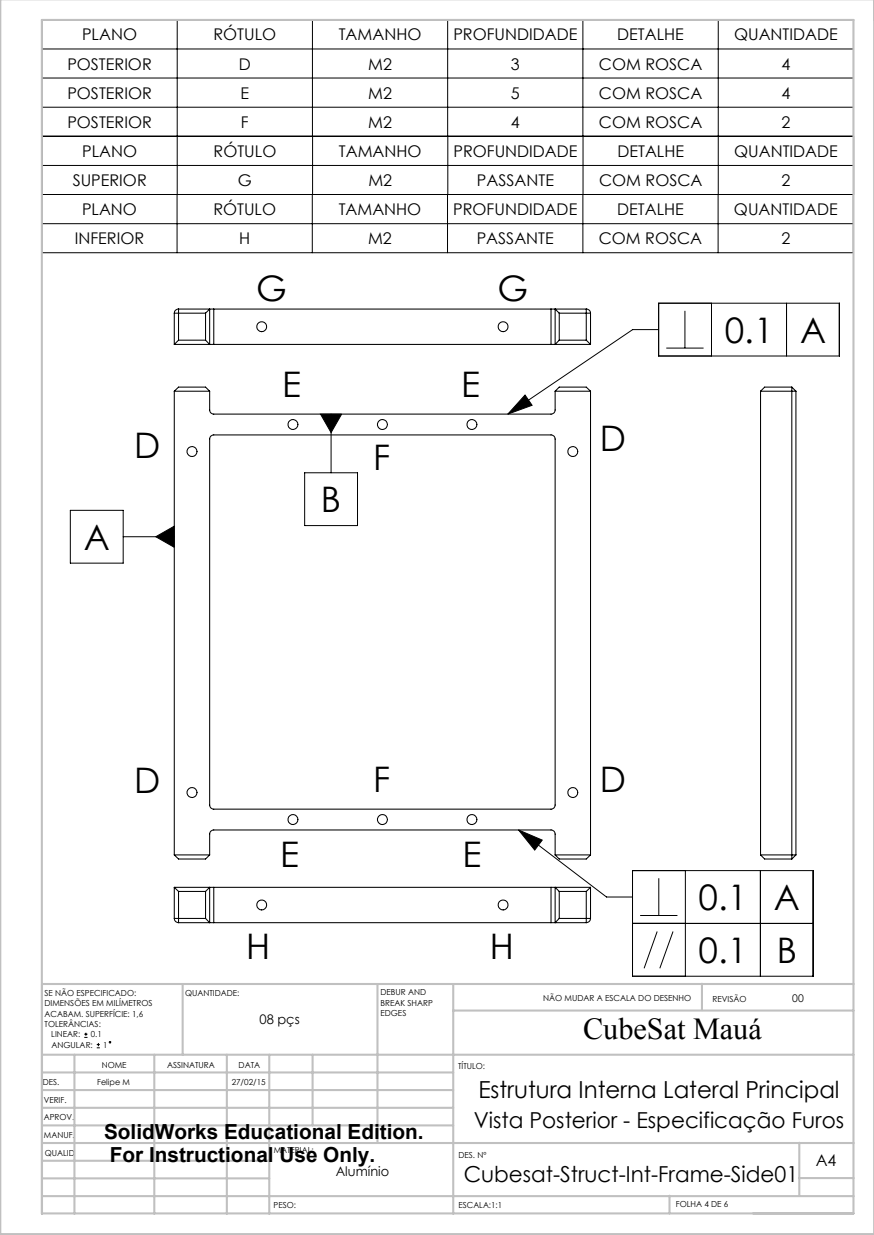
[picture p148: page 4]
CubeSat Mauá; 08 pçs; NÃO MUDAR A ESCALA DO DESENHO; REVISÃO; DEBUR AND BREAK SHARP; SE NÃO ESPECIFICADO:; QUANTIDADE:

PLANO | RÓTULO | TAMANHO | PROFUNDIDADE | DETALHE | QUANTIDADE
POSTERIOR | D | M2 | 3 | COM ROSCA | 4
POSTERIOR | E | M2 | 5 | COM ROSCA | 4
POSTERIOR | F | M2 | 4 | COM ROSCA | 2
SUPERIOR | G | M2 | PASSANTE | COM ROSCA | 2
INFERIOR | H | M2 | PASSANTE | COM ROSCA | 2

DIMENSÕES EM MILÍMETROS
ACABAM. SUPERFÍCIE: 1,6
TOLERÂNCIAS:
LINEAR: 0.1
ANGULAR: 1

NOME | ASSINATURA | DATA | TÍTULO: Estrutura Interna Lateral Principal

DES. | Felipe M | | 27/02/15
VERIF.
APROV. | | | | Vista Posterior - Especificação Furos SolidWorks Educational Edition.

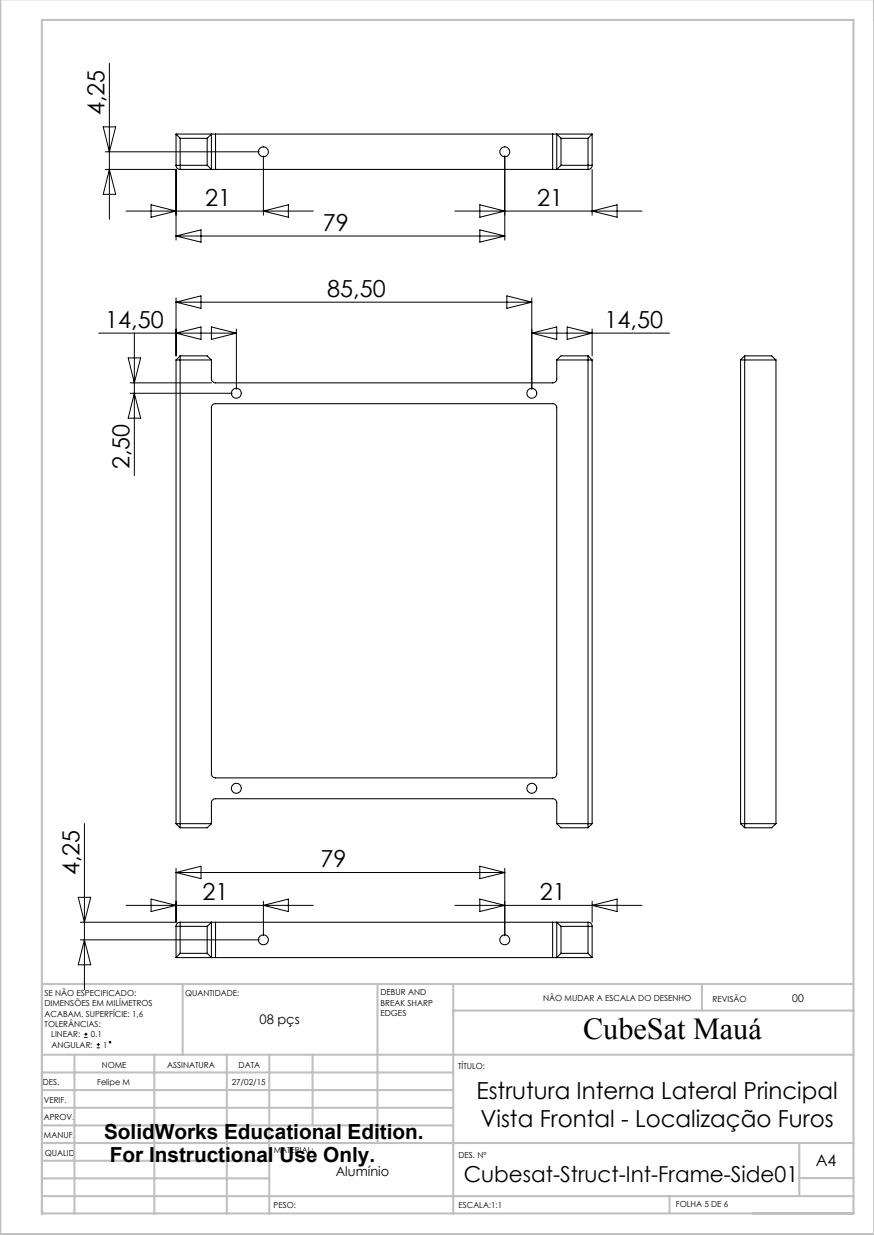
[picture p149: page 5]
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

DIMENSÕES EM MILÍMETROS
ACABAM. SUPERFÍCIE: 1,6
TOLERÂNCIAS:
LINEAR: 0.1
ANGULAR: 1

NOME | ASSINATURA | DATA | TÍTULO: Estrutura Interna Lateral Principal

DES. | Felipe M | | 27/02/15
VERIF.
APROV. | | | | Vista Frontal - Localização Furos SolidWorks Educational Edition.

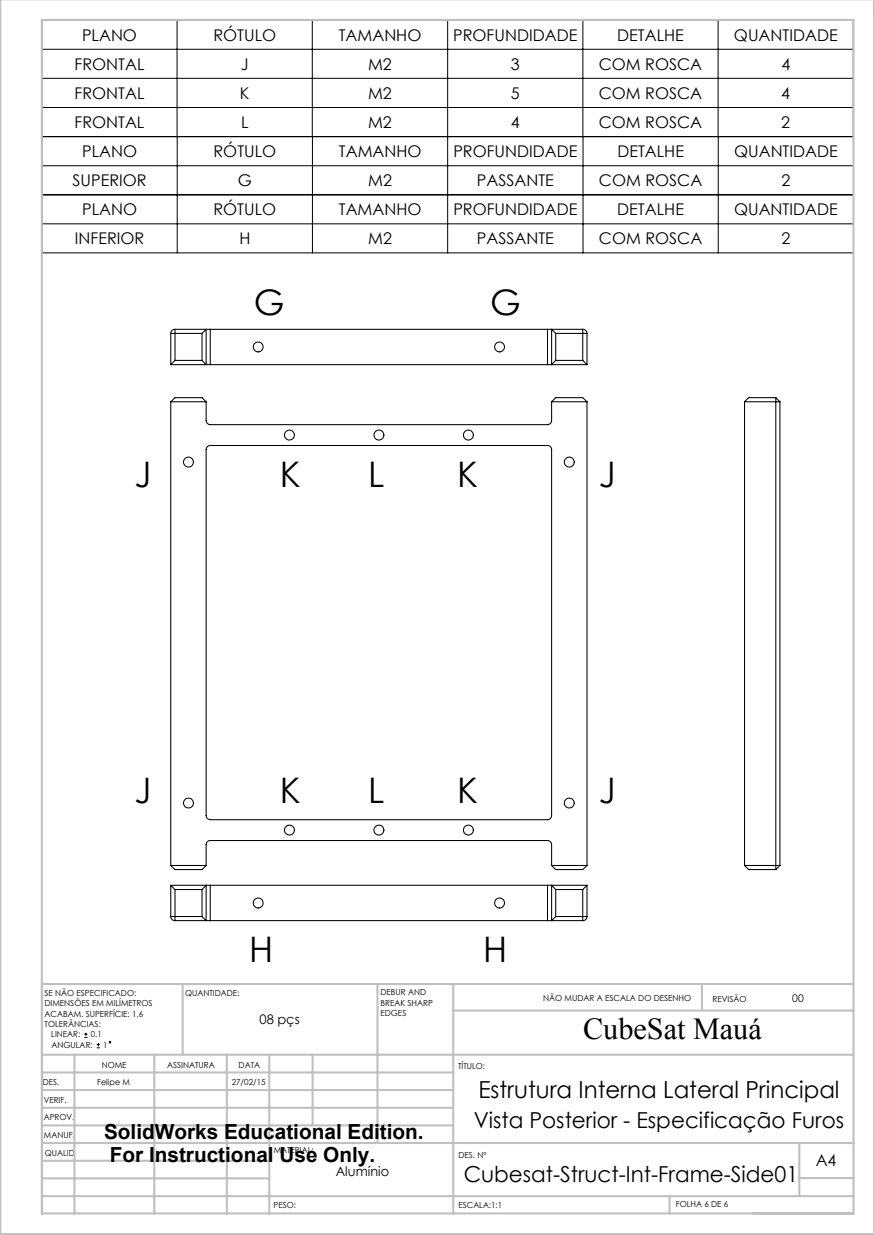
[picture p150: page 6]
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

PLANO | RÓTULO | TAMANHO | PROFUNDIDADE | DETALHE | QUANTIDADE
FRONTAL | J | M2 | 3 | COM ROSCA | 4
FRONTAL | K | M2 | 5 | COM ROSCA | 4
FRONTAL | L | M2 | 4 | COM ROSCA | 2
SUPERIOR | G | M2 | PASSANTE | COM ROSCA | 2
INFERIOR | H | M2 | PASSANTE | COM ROSCA | 2

DIMENSÕES EM MILÍMETROS
ACABAM. SUPERFÍCIE: 1,6
TOLERÂNCIAS:
LINEAR: 0.1
ANGULAR: 1

NOME | ASSINATURA | DATA | TÍTULO: Estrutura Interna Lateral Principal

DES. | Felipe M | | 27/02/15
VERIF.
APROV. | | | | Vista Posterior - Especificação Furos SolidWorks Educational Edition.
