NSEE/Cubesat-Mec/Materiais/Mecânica/Construção/Arquivos Enviados para Construção/Tiago Demay/Arquivos versão final/PDF/Cubesat-Struct-Int-Frame-Side02.PDF

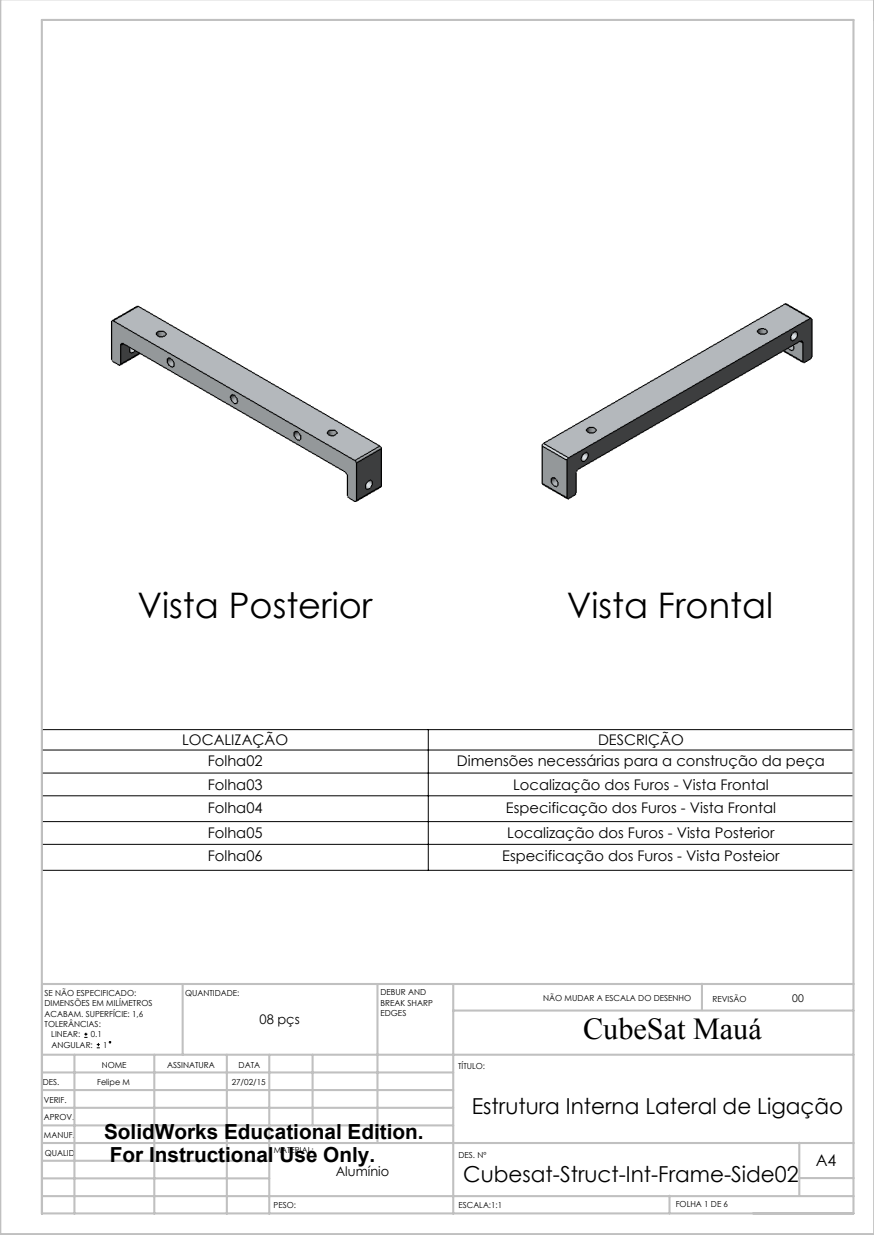
[picture p151: page 1]
Vista Posterior; Vista Frontal; CubeSat Mauá; 08 pçs; ESCALA:1:1; FOLHA 1 DE 6; NÃO MUDAR A ESCALA DO DESENHO; REVISÃO; DEBUR AND BREAK SHARP; SE NÃO ESPECIFICADO:; QUANTIDADE:

LOCALIZAÇÃO | DESCRIÇÃO
Folha02 | Dimensões necessárias para a construção da peça
Folha03 | Localização dos Furos - Vista Frontal
Folha04 | Especificação dos Furos - Vista Frontal
Folha05 | Localização dos Furos - Vista Posterior
Folha06 | Especificação dos Furos - Vista Posteior

DIMENSÕES EM MILÍMETROS
ACABAM. SUPERFÍCIE: 1,6
TOLERÂNCIAS:
LINEAR: 0.1
ANGULAR: 1

NOME | ASSINATURA | DATA | | | | TÍTULO: Estrutura Interna Lateral de Ligação

DES. | Felipe M | | 27/02/15
VERIF.
APROV.
MANUF. | SolidWorks Educational Edition.
QUALID | For Instructional Use Only. | | | MATERIAL: Alumínio | DES. Nº Cubesat-Struct-Int-Frame-Side02 | A4

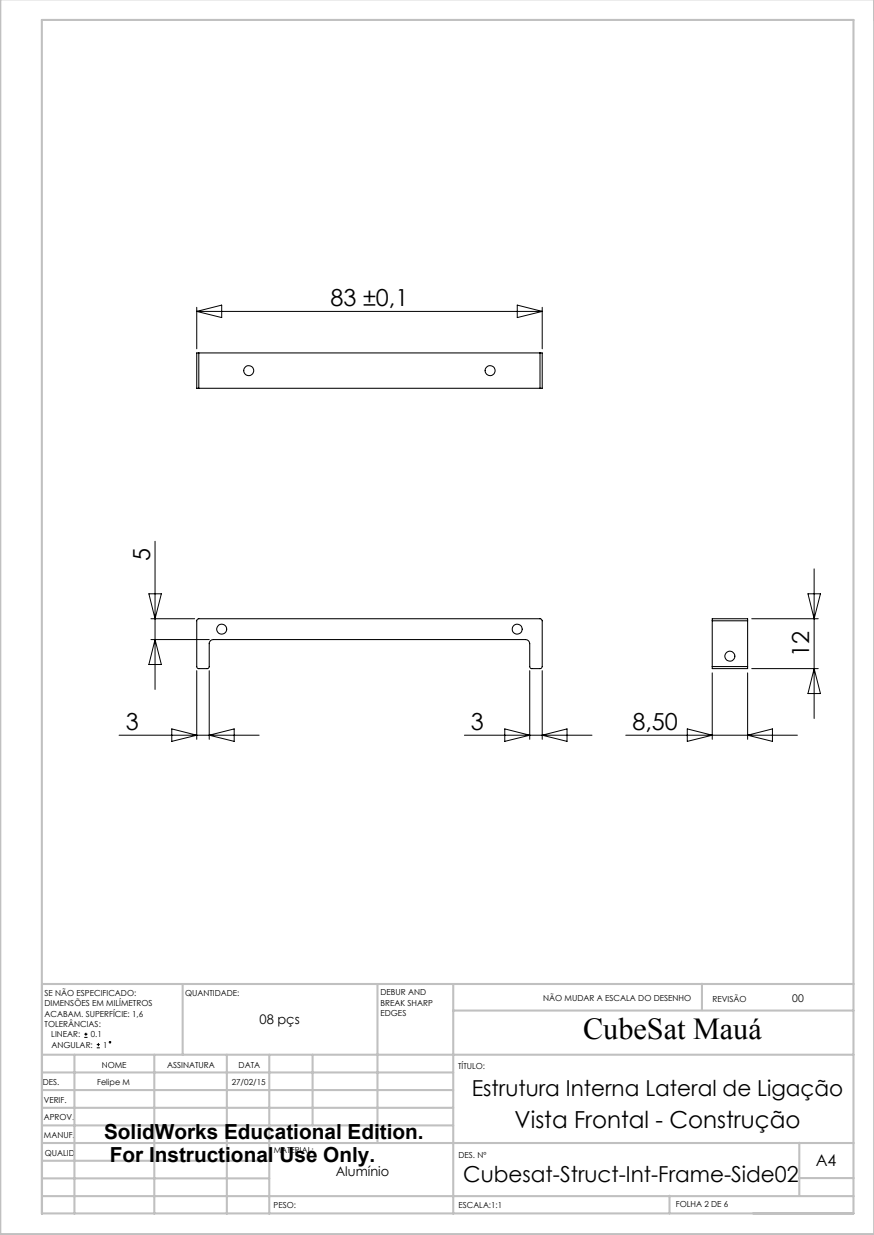
[picture p152: page 2]
CubeSat Mauá; 08 pçs; NÃO MUDAR A ESCALA DO DESENHO; REVISÃO; DEBUR AND BREAK SHARP; SE NÃO ESPECIFICADO:; QUANTIDADE:

DIMENSÕES EM MILÍMETROS
ACABAM. SUPERFÍCIE: 1,6
TOLERÂNCIAS:
LINEAR: 0.1
ANGULAR: 1

NOME | ASSINATURA | DATA | TÍTULO: Estrutura Interna Lateral de Ligação Vista Frontal - Construção SolidWorks Educational Edition.

DES. | Felipe M | | 27/02/15
VERIF.
APROV.

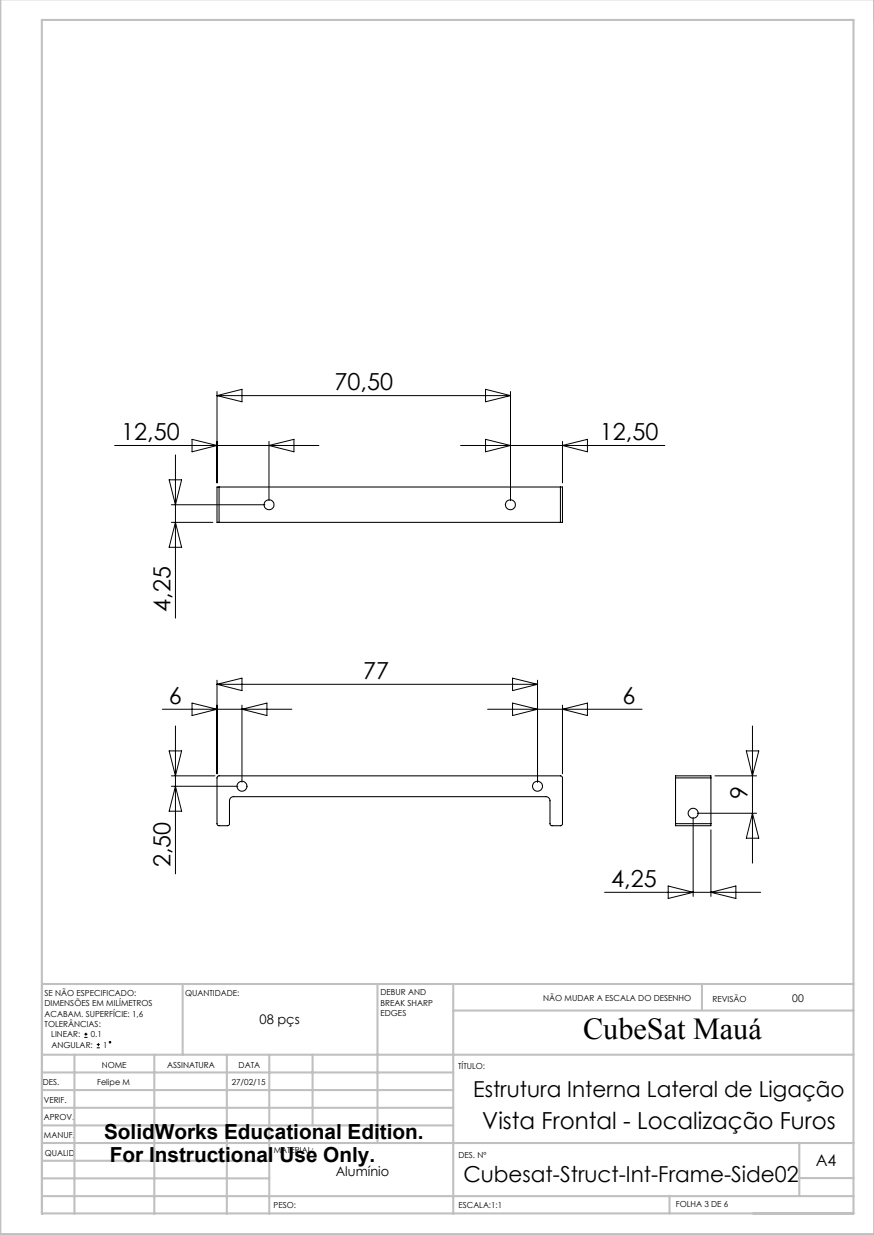
[picture p153: page 3]
CubeSat Mauá; 08 pçs; NÃO MUDAR A ESCALA DO DESENHO; REVISÃO; DEBUR AND BREAK SHARP; SE NÃO ESPECIFICADO:; QUANTIDADE:

DIMENSÕES EM MILÍMETROS
ACABAM. SUPERFÍCIE: 1,6
TOLERÂNCIAS:
LINEAR: 0.1
ANGULAR: 1

NOME | ASSINATURA | DATA | TÍTULO: Estrutura Interna Lateral de Ligação

DES. | Felipe M | | 27/02/15
VERIF.
APROV. | | | | Vista Frontal - Localização Furos SolidWorks Educational Edition.

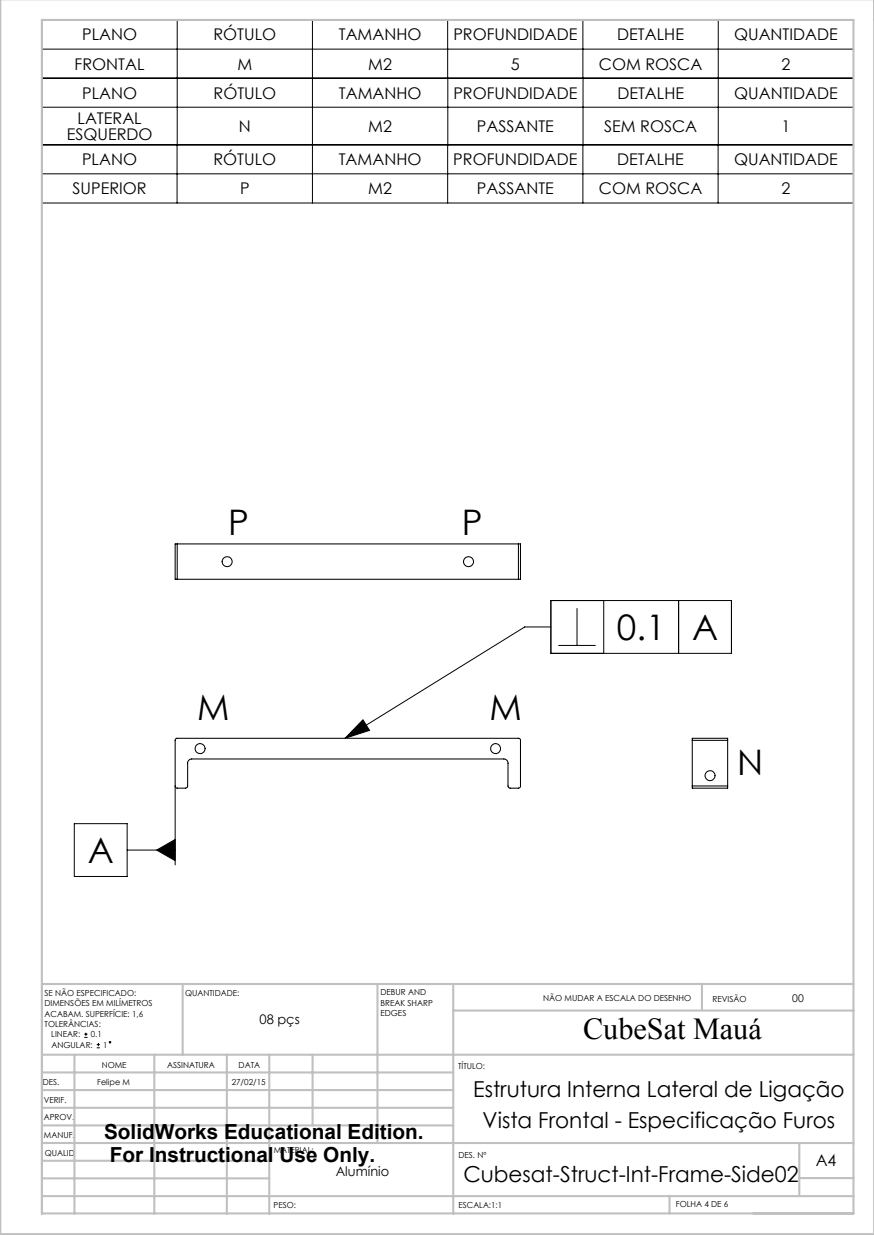
[picture p154: page 4]
CubeSat Mauá; 08 pçs; NÃO MUDAR A ESCALA DO DESENHO; REVISÃO; DEBUR AND BREAK SHARP; SE NÃO ESPECIFICADO:; QUANTIDADE:

PLANO | RÓTULO | TAMANHO | PROFUNDIDADE | DETALHE | QUANTIDADE
FRONTAL | M | M2 | 5 | COM ROSCA | 2
LATERAL ESQUERDO | N | M2 | PASSANTE | SEM ROSCA | 1
SUPERIOR | P | M2 | PASSANTE | COM ROSCA | 2

DIMENSÕES EM MILÍMETROS
ACABAM. SUPERFÍCIE: 1,6
TOLERÂNCIAS:
LINEAR: 0.1
ANGULAR: 1

NOME | ASSINATURA | DATA | TÍTULO: Estrutura Interna Lateral de Ligação

DES. | Felipe M | | 27/02/15
VERIF.
APROV. | | | | Vista Frontal - Especificação Furos SolidWorks Educational Edition.

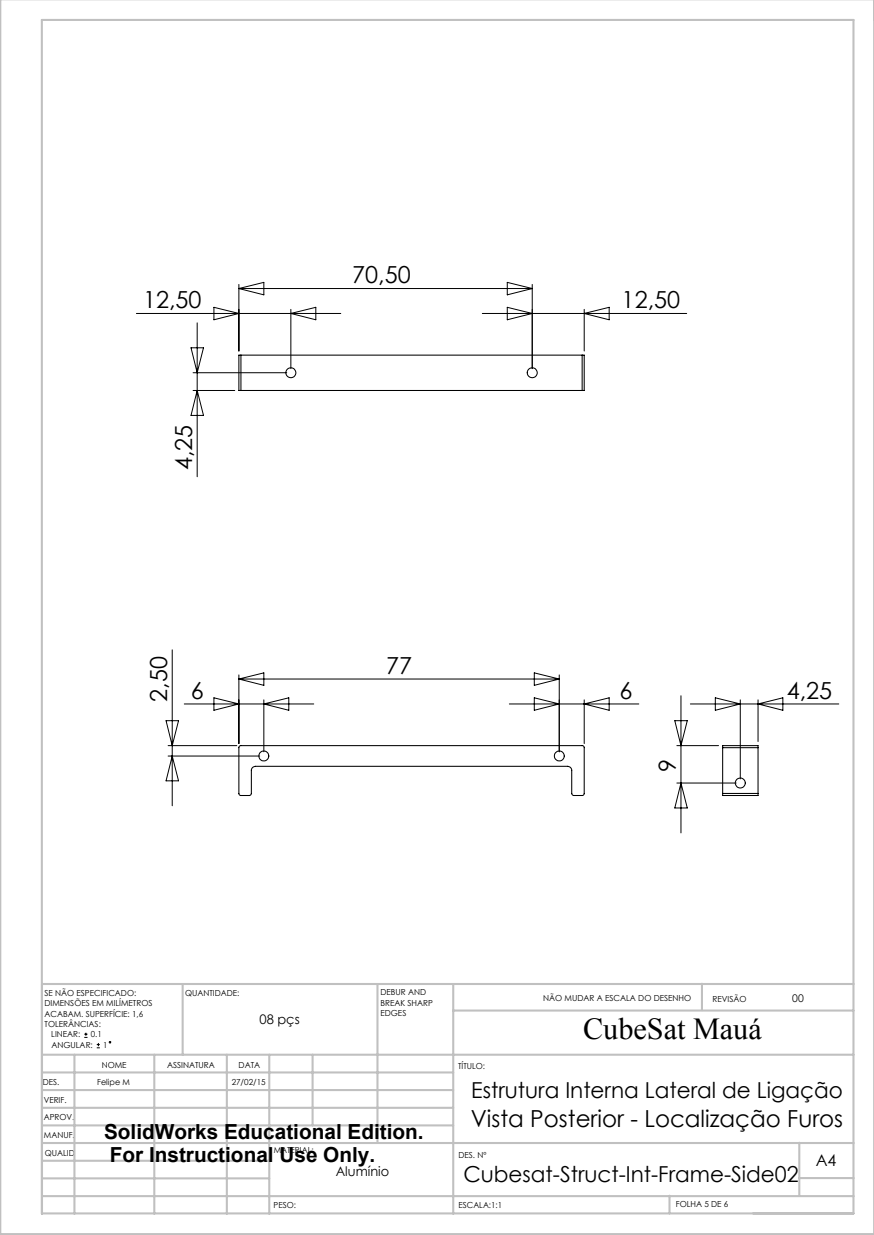
[picture p155: page 5]
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

DIMENSÕES EM MILÍMETROS
ACABAM. SUPERFÍCIE: 1,6
TOLERÂNCIAS:
LINEAR: 0.1
ANGULAR: 1

NOME | ASSINATURA | DATA | TÍTULO: Estrutura Interna Lateral de Ligação

DES. | Felipe M | | 27/02/15
VERIF.
APROV. | | | | Vista Posterior - Localização Furos SolidWorks Educational Edition.

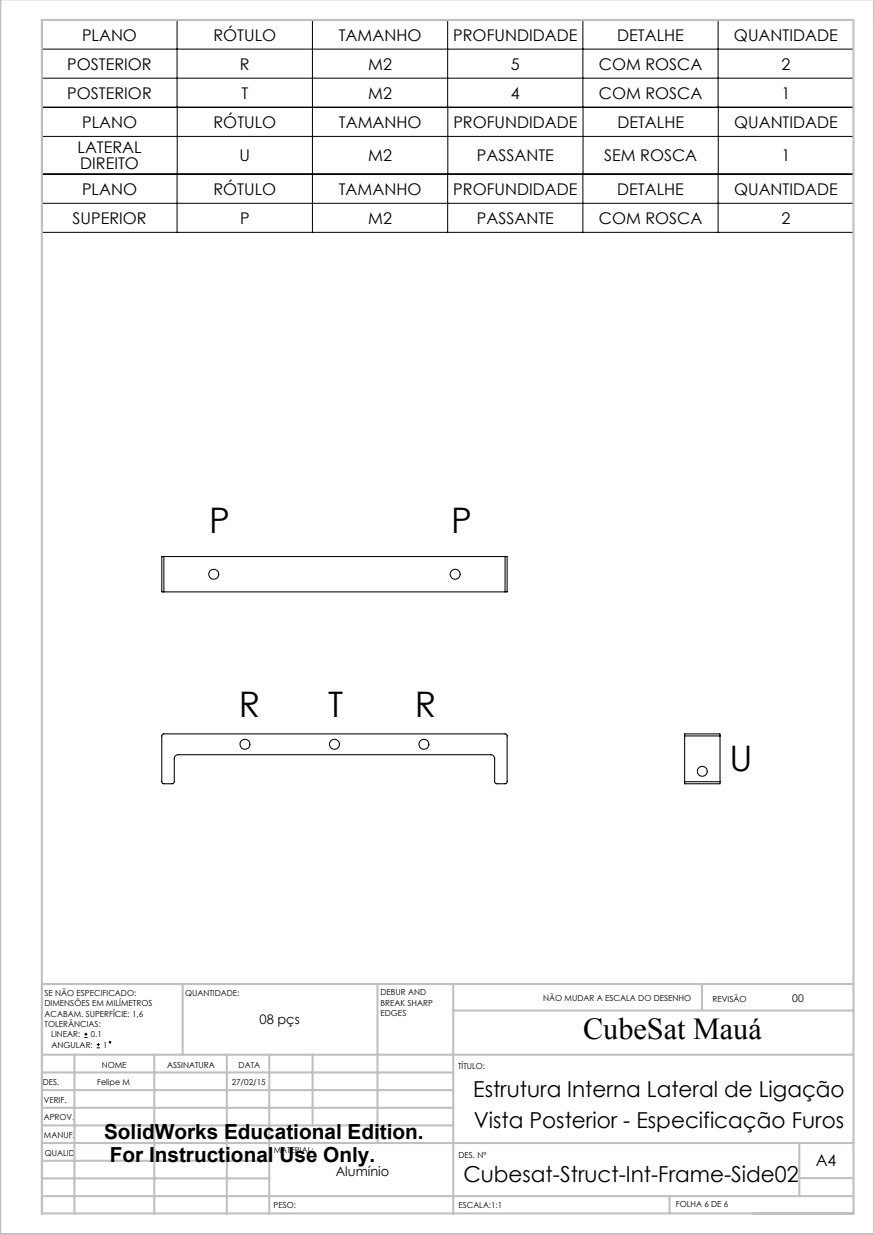
[picture p156: page 6]
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

PLANO | RÓTULO | TAMANHO | PROFUNDIDADE | DETALHE | QUANTIDADE
POSTERIOR | R | M2 | 5 | COM ROSCA | 2
POSTERIOR | T | M2 | 4 | COM ROSCA | 1
LATERAL DIREITO | U | M2 | PASSANTE | SEM ROSCA | 1
SUPERIOR | P | M2 | PASSANTE | COM ROSCA | 2

DIMENSÕES EM MILÍMETROS
ACABAM. SUPERFÍCIE: 1,6
TOLERÂNCIAS:
LINEAR: 0.1
ANGULAR: 1

NOME | ASSINATURA | DATA | TÍTULO: Estrutura Interna Lateral de Ligação

DES. | Felipe M | | 27/02/15
VERIF.
APROV. | | | | Vista Posterior - Especificação Furos SolidWorks Educational Edition.
