NSEE/Cubesat-Mec/Materiais/Mecânica/Construção/Arquivos Enviados para Construção/Tiago Demay/Arquivos versão final/PDF/Cubesat-Struct-Int-Frame-Side03.PDF

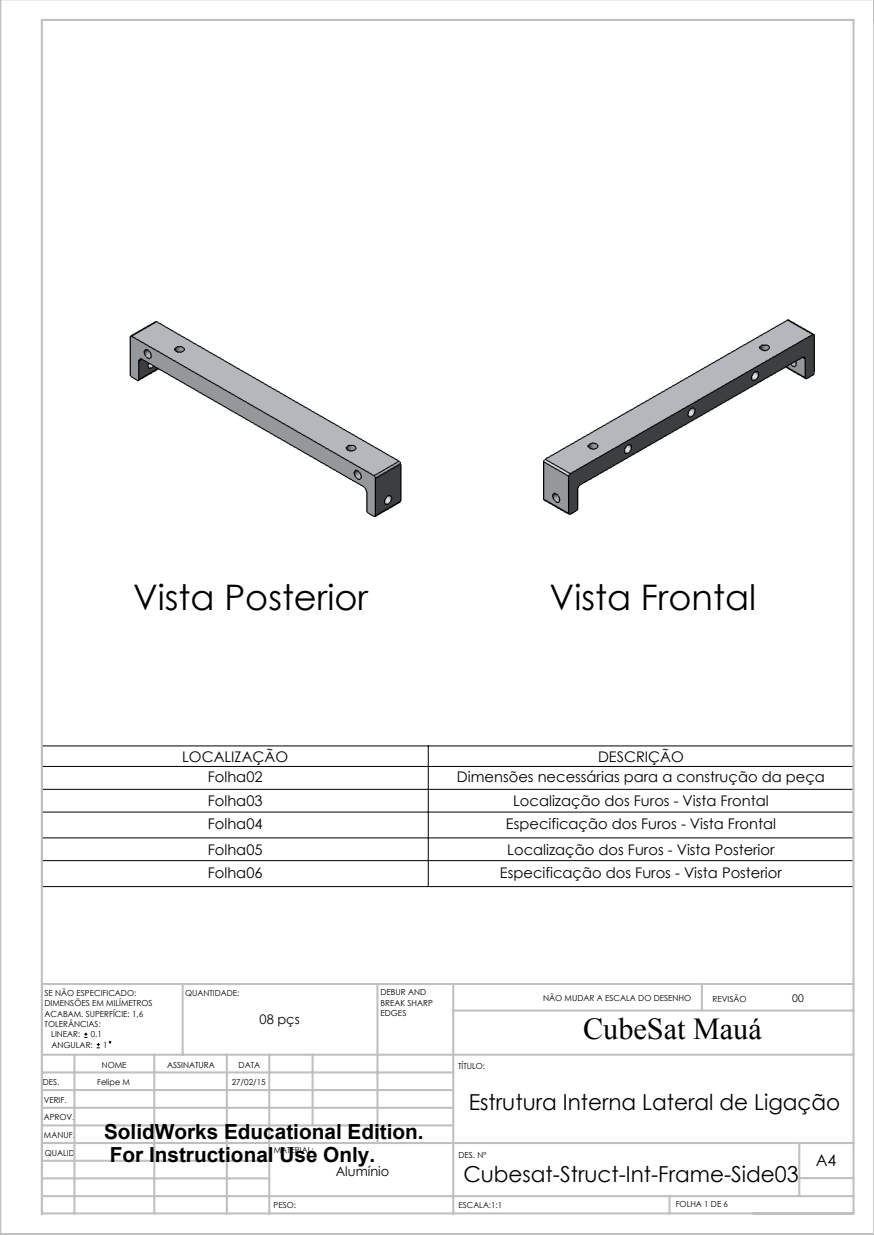
[picture p157: page 1]
Vista Posterior; Vista Frontal; CubeSat Mauá; 08 pçs; ESCALA:1:1; FOLHA 1 DE 6; NÃO MUDAR A ESCALA DO DESENHO; REVISÃO; DEBUR AND BREAK SHARP; SE NÃO ESPECIFICADO:; QUANTIDADE:

LOCALIZAÇÃO | DESCRIÇÃO
Folha02 | Dimensões necessárias para a construção da peça
Folha03 | Localização dos Furos - Vista Frontal
Folha04 | Especificação dos Furos - Vista Frontal
Folha05 | Localização dos Furos - Vista Posterior
Folha06 | Especificação dos Furos - Vista Posterior

DIMENSÕES EM MILÍMETROS
ACABAM. SUPERFÍCIE: 1,6
TOLERÂNCIAS:
LINEAR: 0.1
ANGULAR: 1

NOME | ASSINATURA | DATA | | | | TÍTULO: Estrutura Interna Lateral de Ligação

DES. | Felipe M | | 27/02/15
VERIF.
APROV.
MANUF. | SolidWorks Educational Edition.
QUALID | For Instructional Use Only. | | | MATERIAL: Alumínio | DES. Nº Cubesat-Struct-Int-Frame-Side03 | A4

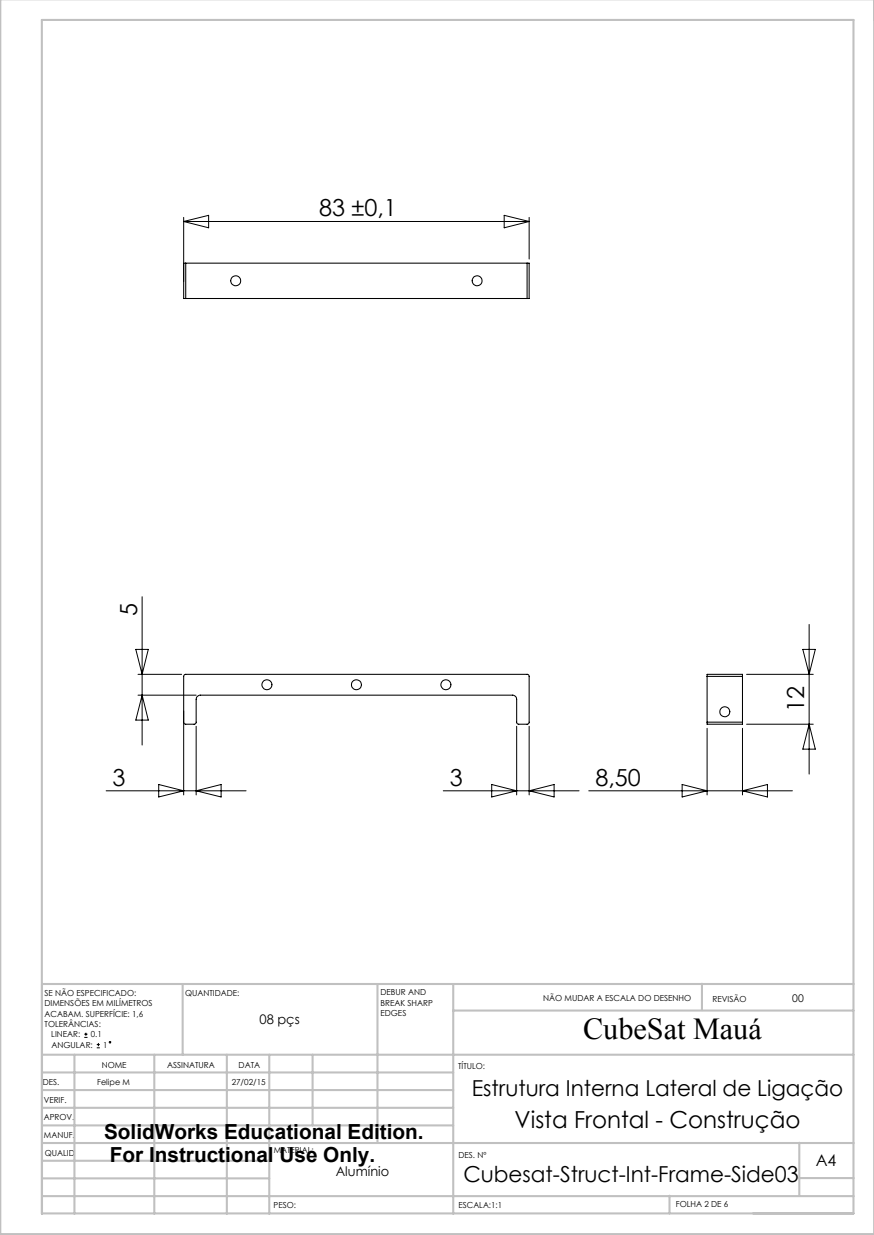
[picture p158: page 2]
CubeSat Mauá; 08 pçs; NÃO MUDAR A ESCALA DO DESENHO; REVISÃO; DEBUR AND BREAK SHARP; SE NÃO ESPECIFICADO:; QUANTIDADE:

DIMENSÕES EM MILÍMETROS
ACABAM. SUPERFÍCIE: 1,6
TOLERÂNCIAS:
LINEAR: 0.1
ANGULAR: 1

NOME | ASSINATURA | DATA | TÍTULO: Estrutura Interna Lateral de Ligação Vista Frontal - Construção SolidWorks Educational Edition.

DES. | Felipe M | | 27/02/15
VERIF.
APROV.

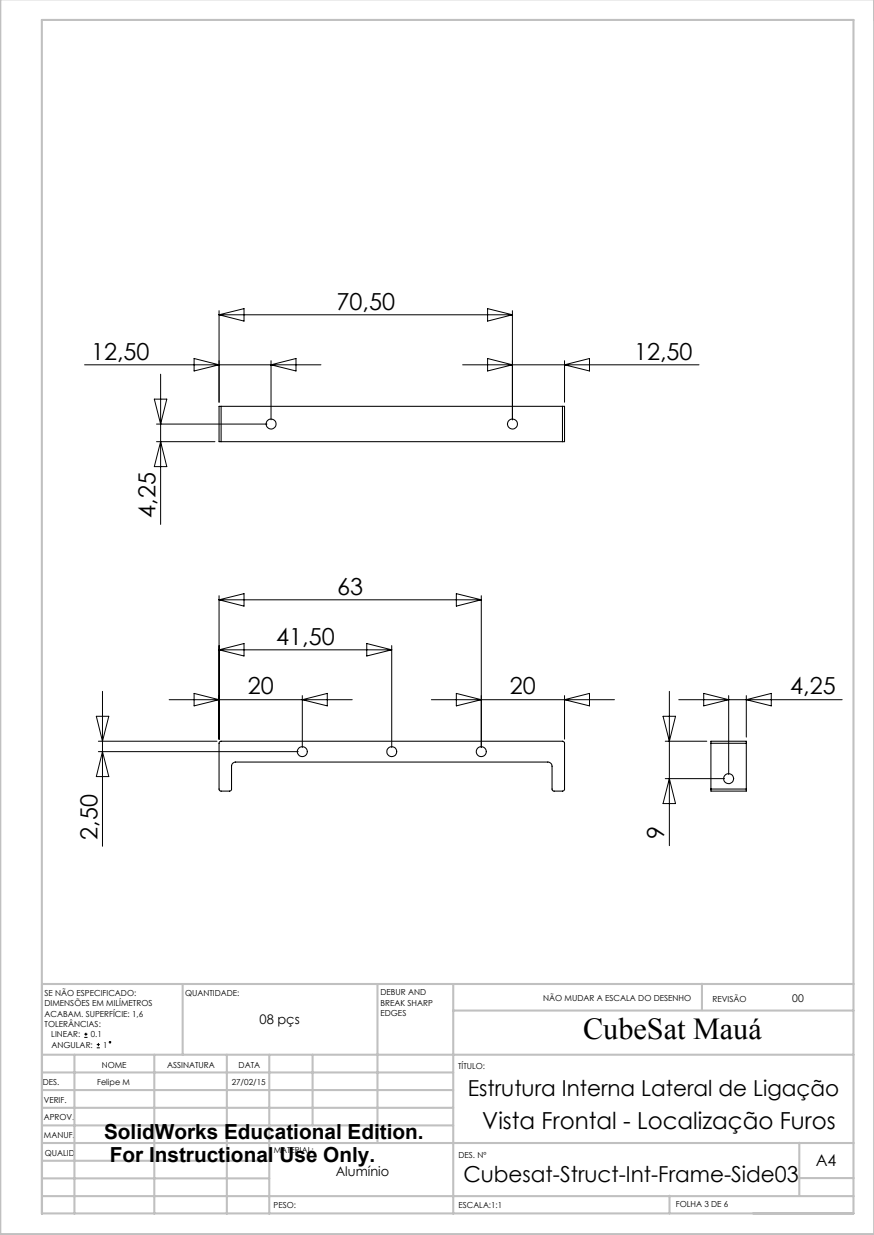
[picture p159: page 3]
CubeSat Mauá; 08 pçs; NÃO MUDAR A ESCALA DO DESENHO; REVISÃO; DEBUR AND BREAK SHARP; SE NÃO ESPECIFICADO:; QUANTIDADE:

DIMENSÕES EM MILÍMETROS
ACABAM. SUPERFÍCIE: 1,6
TOLERÂNCIAS:
LINEAR: 0.1
ANGULAR: 1

NOME | ASSINATURA | DATA | TÍTULO: Estrutura Interna Lateral de Ligação

DES. | Felipe M | | 27/02/15
VERIF.
APROV. | | | | Vista Frontal - Localização Furos SolidWorks Educational Edition.

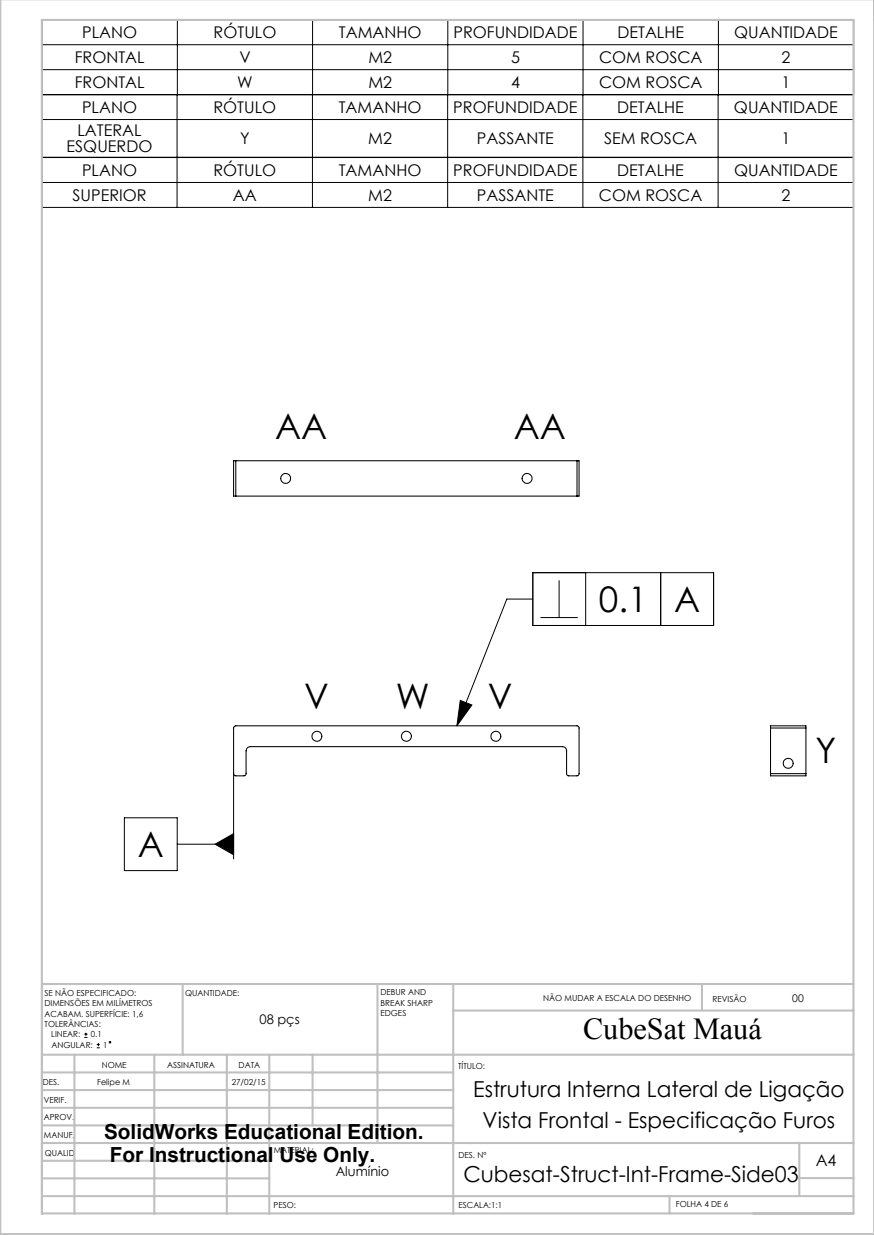
[picture p160: page 4]
CubeSat Mauá; 08 pçs; NÃO MUDAR A ESCALA DO DESENHO; REVISÃO; DEBUR AND BREAK SHARP; SE NÃO ESPECIFICADO:; QUANTIDADE:

PLANO | RÓTULO | TAMANHO | PROFUNDIDADE | DETALHE | QUANTIDADE
FRONTAL | V | M2 | 5 | COM ROSCA | 2
FRONTAL | W | M2 | 4 | COM ROSCA | 1
LATERAL ESQUERDO | Y | M2 | PASSANTE | SEM ROSCA | 1
SUPERIOR | AA | M2 | PASSANTE | COM ROSCA | 2

DIMENSÕES EM MILÍMETROS
ACABAM. SUPERFÍCIE: 1,6
TOLERÂNCIAS:
LINEAR: 0.1
ANGULAR: 1

NOME | ASSINATURA | DATA | TÍTULO: Estrutura Interna Lateral de Ligação

DES. | Felipe M | | 27/02/15
VERIF.
APROV. | | | | Vista Frontal - Especificação Furos SolidWorks Educational Edition.

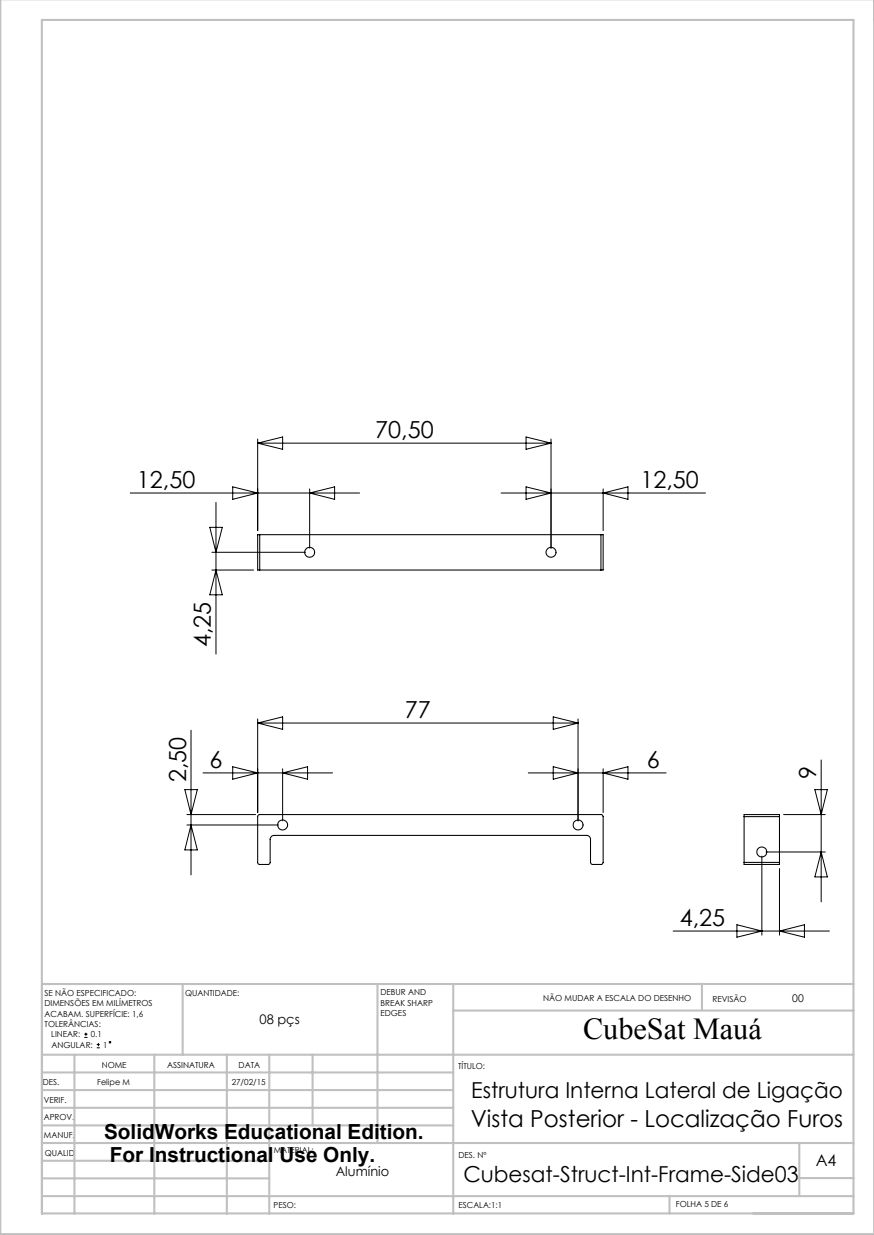
[picture p161: page 5]
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

DIMENSÕES EM MILÍMETROS
ACABAM. SUPERFÍCIE: 1,6
TOLERÂNCIAS:
LINEAR: 0.1
ANGULAR: 1

NOME | ASSINATURA | DATA | TÍTULO: Estrutura Interna Lateral de Ligação

DES. | Felipe M | | 27/02/15
VERIF.
APROV. | | | | Vista Posterior - Localização Furos SolidWorks Educational Edition.

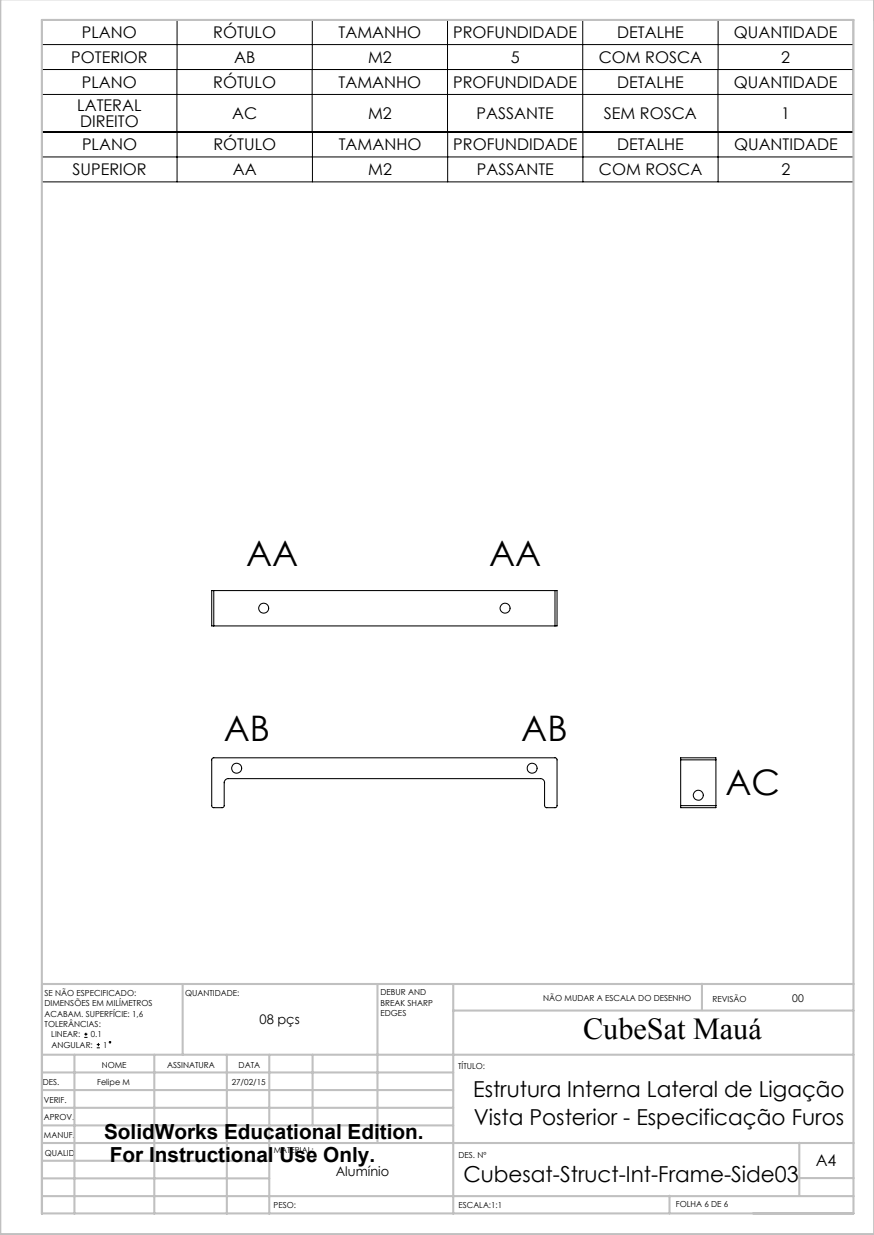
[picture p162: page 6]
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

PLANO | RÓTULO | TAMANHO | PROFUNDIDADE | DETALHE | QUANTIDADE
POTERIOR | AB | M2 | 5 | COM ROSCA | 2
LATERAL DIREITO | AC | M2 | PASSANTE | SEM ROSCA | 1
SUPERIOR | AA | M2 | PASSANTE | COM ROSCA | 2

DIMENSÕES EM MILÍMETROS
ACABAM. SUPERFÍCIE: 1,6
TOLERÂNCIAS:
LINEAR: 0.1
ANGULAR: 1

NOME | ASSINATURA | DATA | TÍTULO: Estrutura Interna Lateral de Ligação

DES. | Felipe M | | 27/02/15
VERIF.
APROV. | | | | Vista Posterior - Especificação Furos SolidWorks Educational Edition.
