NSEE/Cubesat-Mec/Materiais/Mecânica/Construção/Folha de Processos/Completa/v01.1/PDF/Cubesat-Struct-Int-Frame-Top.PDF

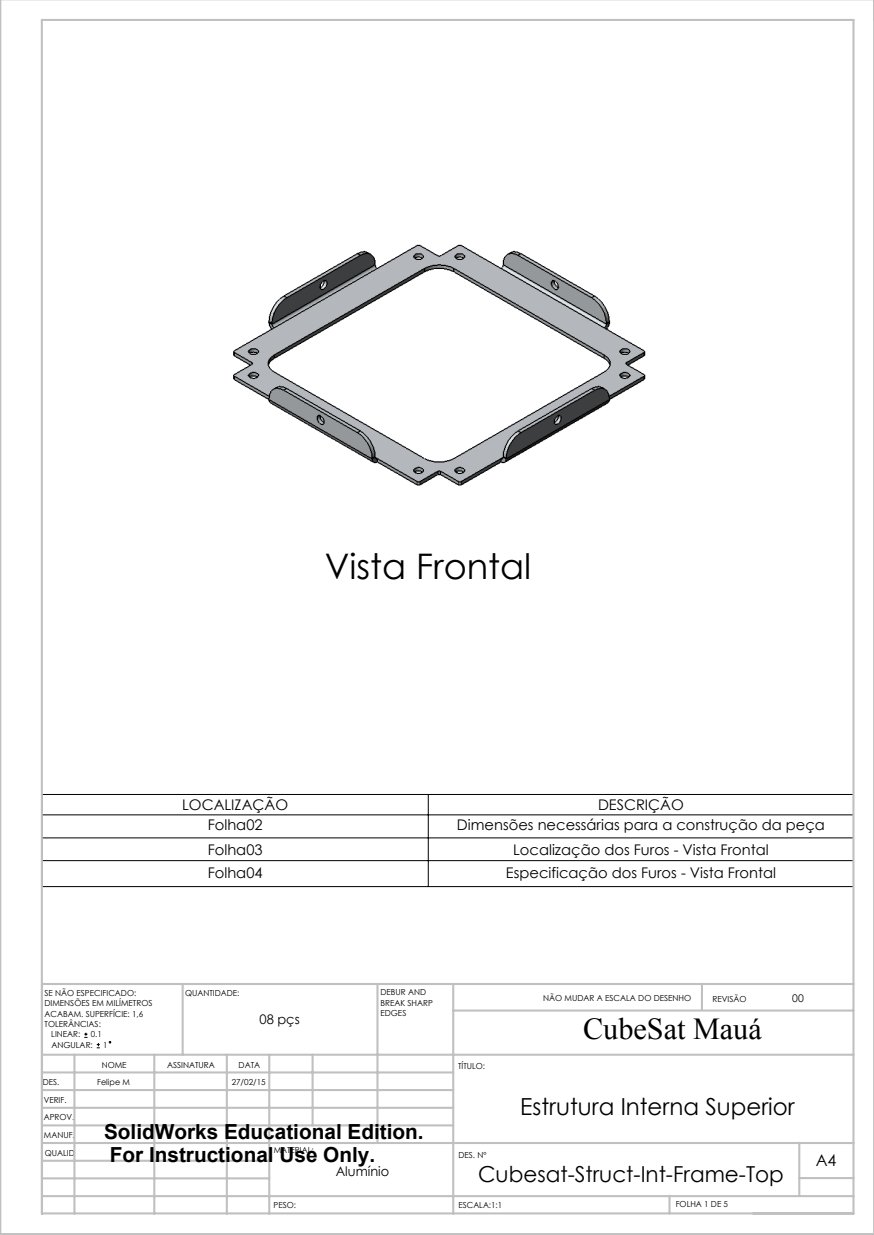
[picture p163: page 1]
Vista Frontal; CubeSat Mauá; 08 pçs; ESCALA:1:1; FOLHA 1 DE 5; NÃO MUDAR A ESCALA DO DESENHO; REVISÃO; DEBUR AND BREAK SHARP; SE NÃO ESPECIFICADO:; QUANTIDADE:

LOCALIZAÇÃO | DESCRIÇÃO
Folha02 | Dimensões necessárias para a construção da peça
Folha03 | Localização dos Furos - Vista Frontal
Folha04 | Especificação dos Furos - Vista Frontal

DIMENSÕES EM MILÍMETROS
ACABAM. SUPERFÍCIE: 1,6
TOLERÂNCIAS:
LINEAR: 0.1
ANGULAR: 1

NOME | ASSINATURA | DATA | | | | TÍTULO: Estrutura Interna Superior

DES. | Felipe M | | 27/02/15
VERIF.
APROV.
MANUF. | SolidWorks Educational Edition.
QUALID | For Instructional Use Only. | | | MATERIAL: Alumínio | DES. Nº Cubesat-Struct-Int-Frame-Top | A4

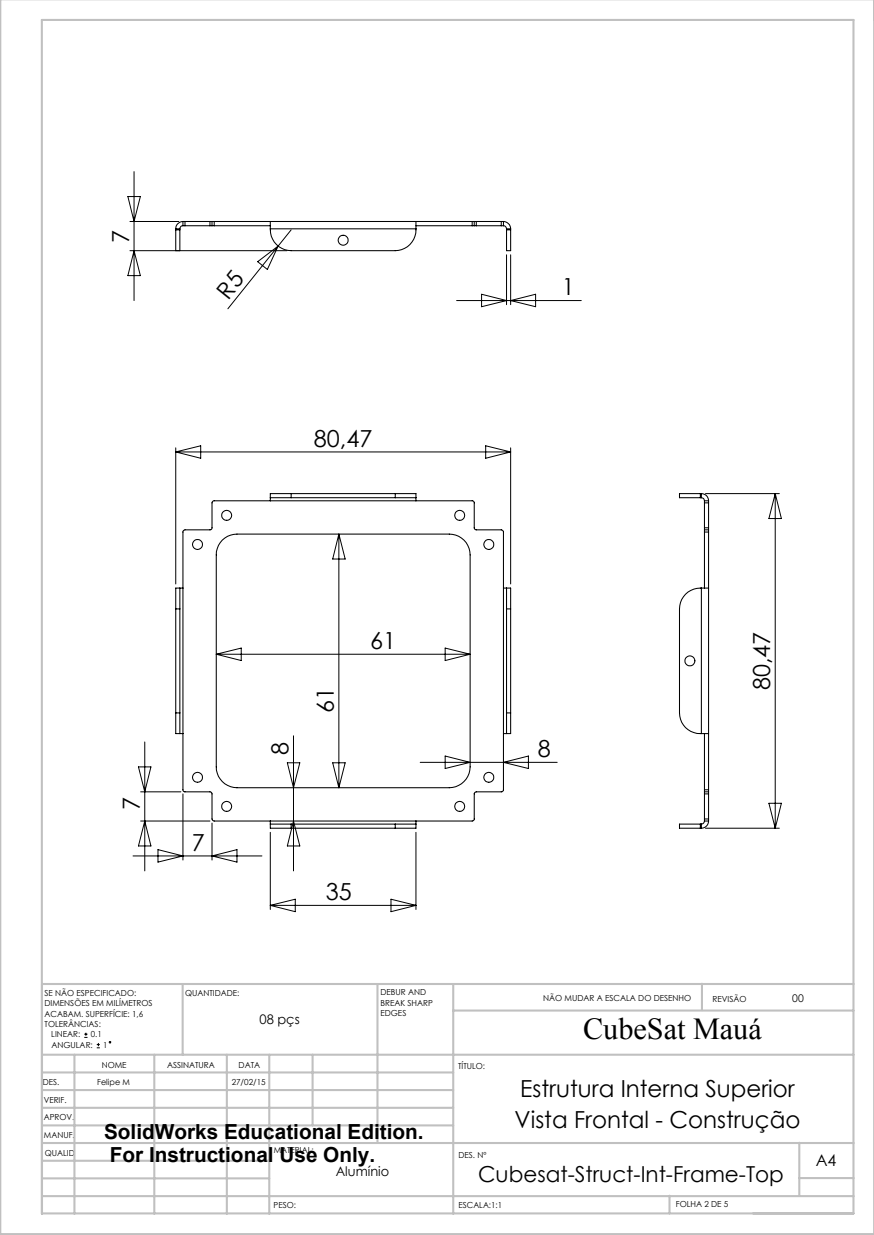
[picture p164: page 2]
CubeSat Mauá; 08 pçs; NÃO MUDAR A ESCALA DO DESENHO; REVISÃO; DEBUR AND BREAK SHARP; SE NÃO ESPECIFICADO:; QUANTIDADE:

DIMENSÕES EM MILÍMETROS
ACABAM. SUPERFÍCIE: 1,6
TOLERÂNCIAS:
LINEAR: 0.1
ANGULAR: 1

NOME | ASSINATURA | DATA | TÍTULO: Estrutura Interna Superior Vista Frontal - Construção SolidWorks Educational Edition.

DES. | Felipe M | | 27/02/15
VERIF.
APROV.

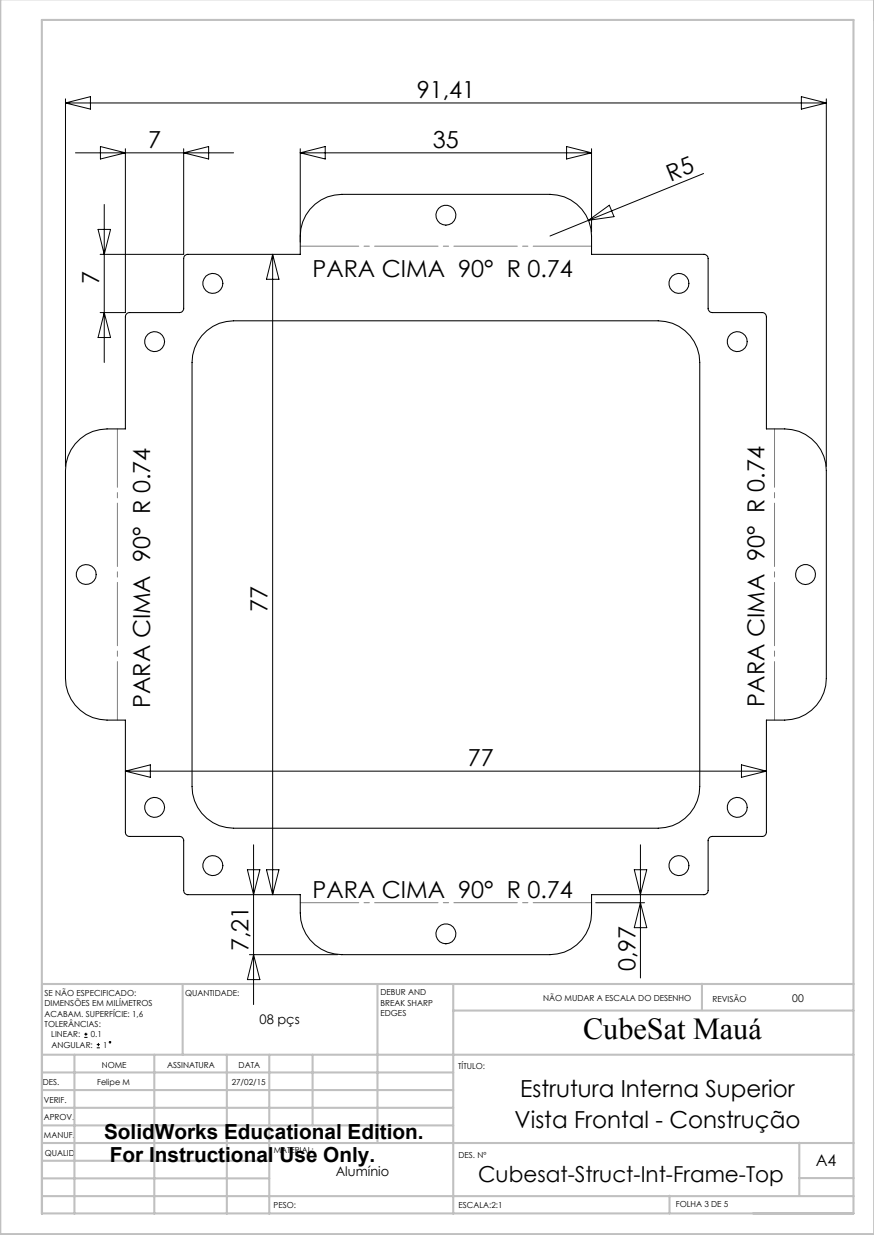
[picture p165: page 3]
PARA CIMA 90° R 0.74; CubeSat Mauá; 08 pçs; ESCALA:2:1; FOLHA 3 DE 5; NÃO MUDAR A ESCALA DO DESENHO; REVISÃO; DEBUR AND BREAK SHARP; SE NÃO ESPECIFICADO:; QUANTIDADE:

DIMENSÕES EM MILÍMETROS
ACABAM. SUPERFÍCIE: 1,6
TOLERÂNCIAS:
LINEAR: 0.1
ANGULAR: 1

NOME | ASSINATURA | DATA | TÍTULO: Estrutura Interna Superior Vista Frontal - Construção SolidWorks Educational Edition.

DES. | Felipe M | | 27/02/15
VERIF.
APROV.

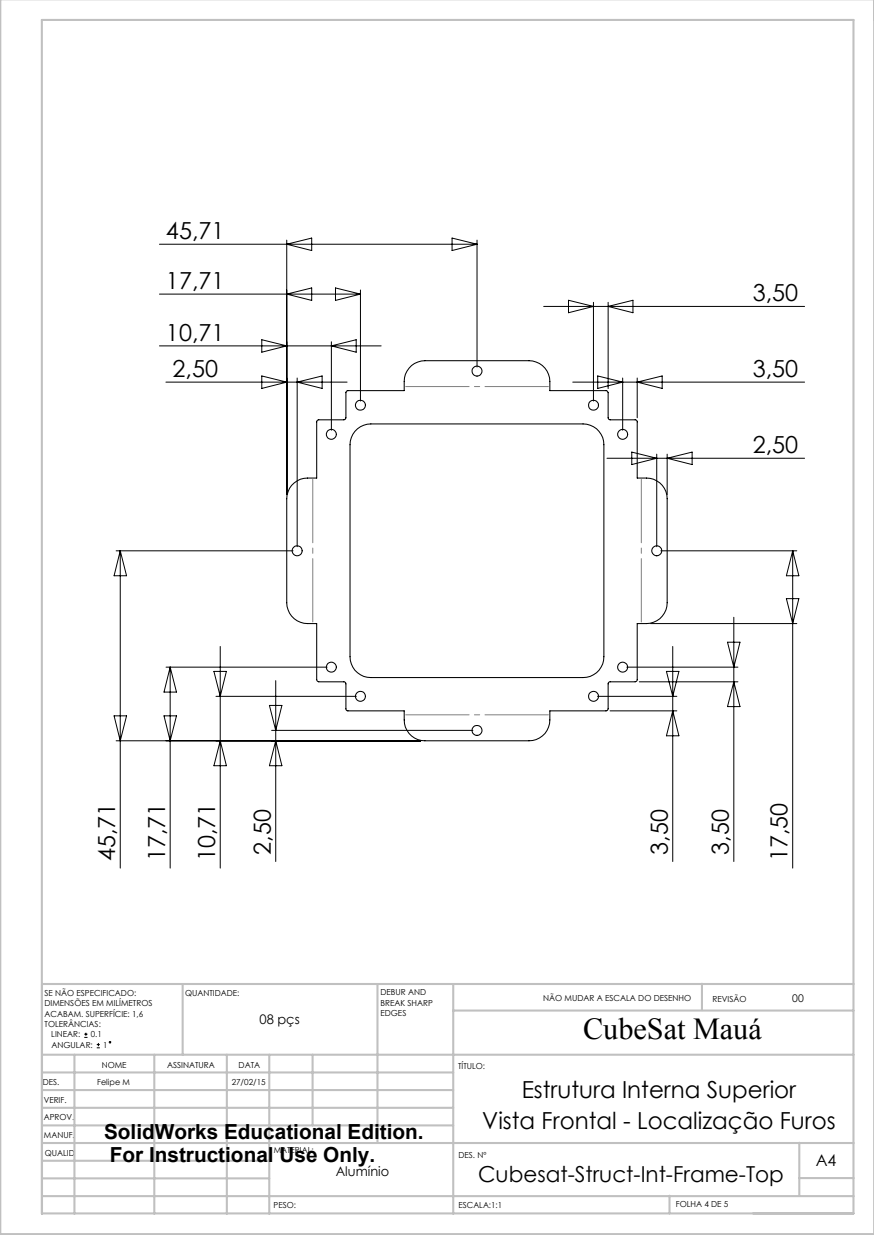
[picture p166: page 4]
CubeSat Mauá; 08 pçs; NÃO MUDAR A ESCALA DO DESENHO; REVISÃO; DEBUR AND BREAK SHARP; SE NÃO ESPECIFICADO:; QUANTIDADE:

DIMENSÕES EM MILÍMETROS
ACABAM. SUPERFÍCIE: 1,6
TOLERÂNCIAS:
LINEAR: 0.1
ANGULAR: 1

NOME | ASSINATURA | DATA | TÍTULO: Estrutura Interna Superior

DES. | Felipe M | | 27/02/15
VERIF.
APROV. | | | | Vista Frontal - Localização Furos SolidWorks Educational Edition.

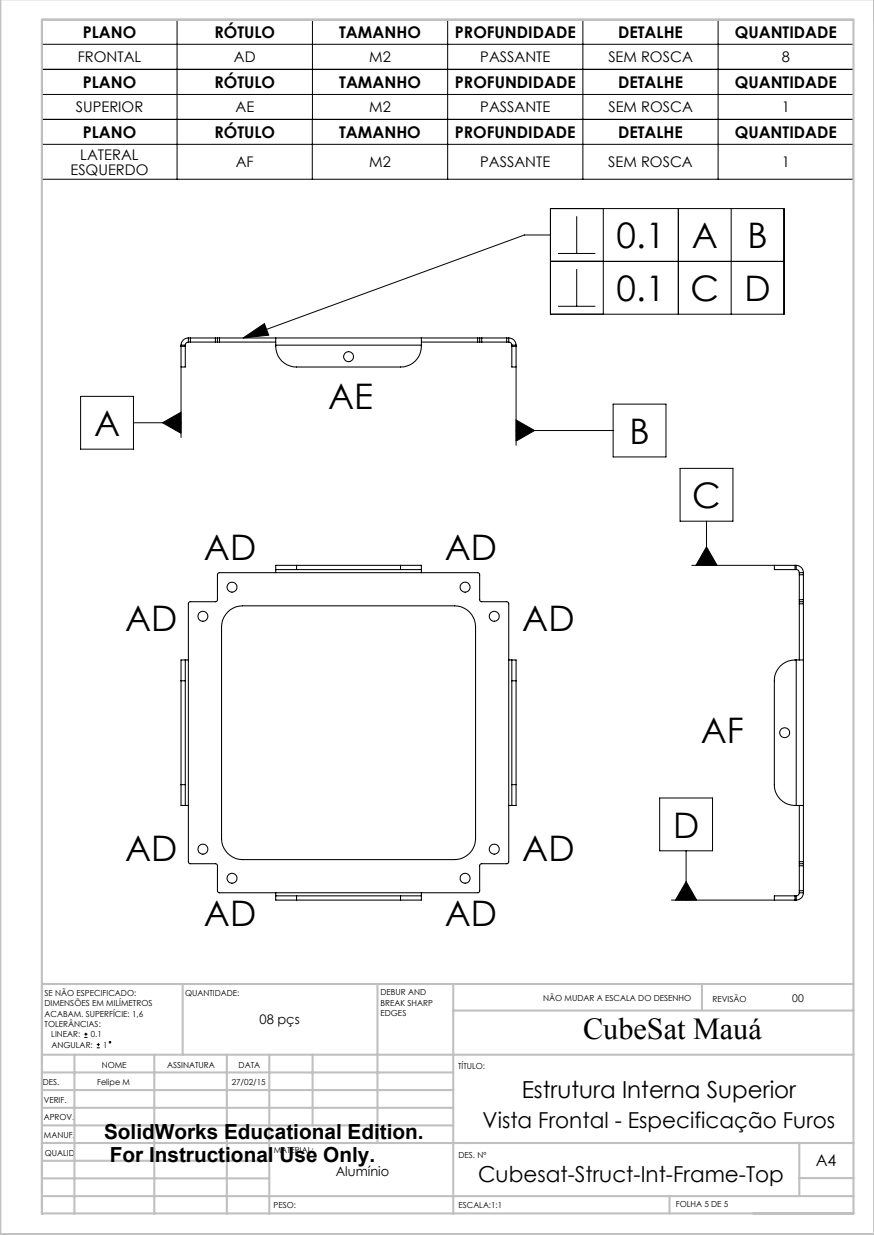
[picture p167: page 5]
CubeSat Mauá; 08 pçs; NÃO MUDAR A ESCALA DO DESENHO; REVISÃO; DEBUR AND BREAK SHARP; SE NÃO ESPECIFICADO:; QUANTIDADE:

PLANO | RÓTULO | TAMANHO | PROFUNDIDADE | DETALHE | QUANTIDADE
FRONTAL | AD | M2 | PASSANTE | SEM ROSCA | 8
SUPERIOR | AE | M2 | PASSANTE | SEM ROSCA | 1
LATERAL ESQUERDO | AF | M2 | PASSANTE | SEM ROSCA | 1

DIMENSÕES EM MILÍMETROS
ACABAM. SUPERFÍCIE: 1,6
TOLERÂNCIAS:
LINEAR: 0.1
ANGULAR: 1

NOME | ASSINATURA | DATA | TÍTULO: Estrutura Interna Superior

DES. | Felipe M | | 27/02/15
VERIF.
APROV. | | | | Vista Frontal - Especificação Furos SolidWorks Educational Edition.
