NSEE/Cubesat-Mec/Materiais/Arquivos/Fotos/Print Screen/v01.2/2.JPG

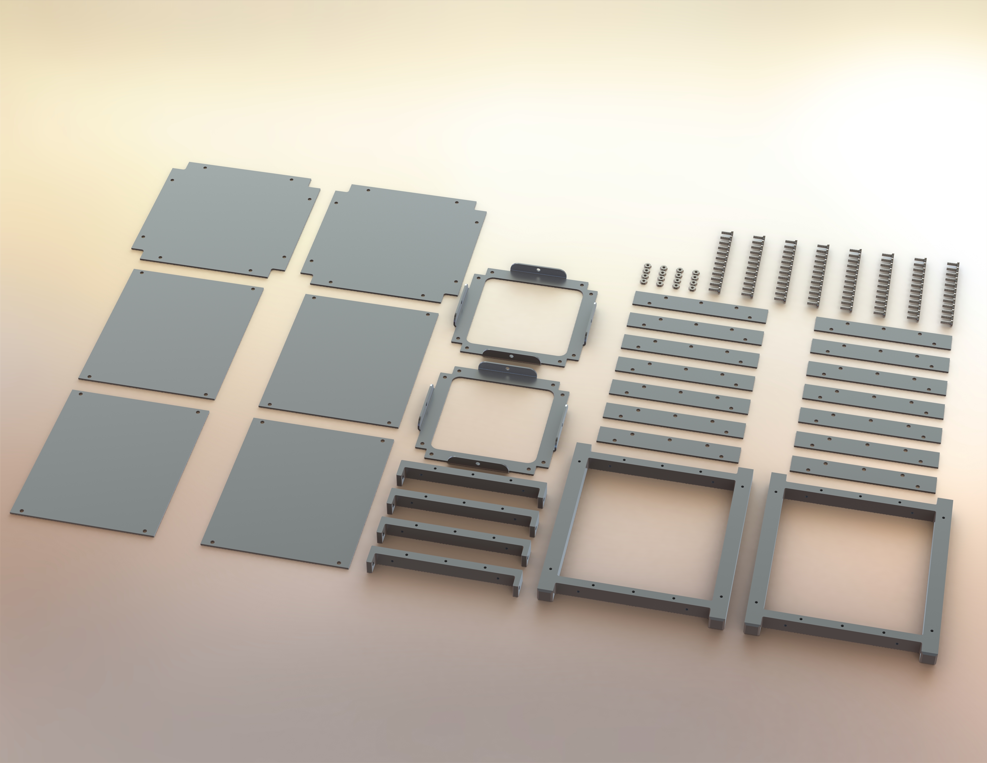
Materiais/Arquivos/Fotos/Print Screen/v01.2/2.JPG
