NSEE/Cubesat-Mec/Materiais/Arquivos/Fotos/Print Screen/v01.2/3.JPG

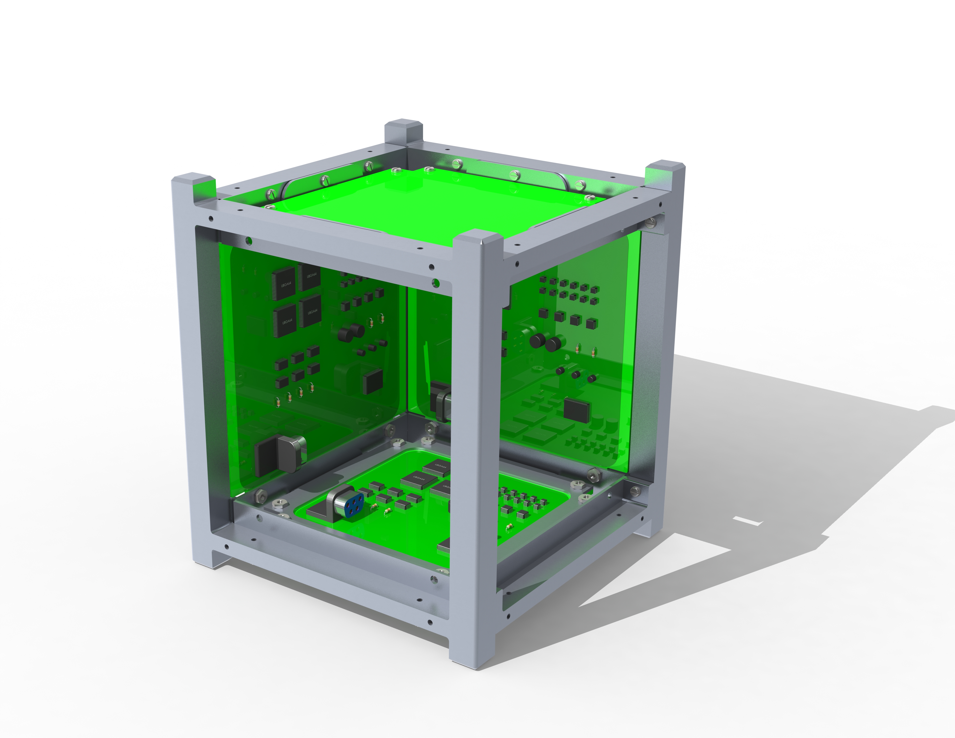
Materiais/Arquivos/Fotos/Print Screen/v01.2/3.JPG
