NSEE/Cubesat-Mec/Materiais/Arquivos/Fotos/Print Screen/v01.2/5.JPG

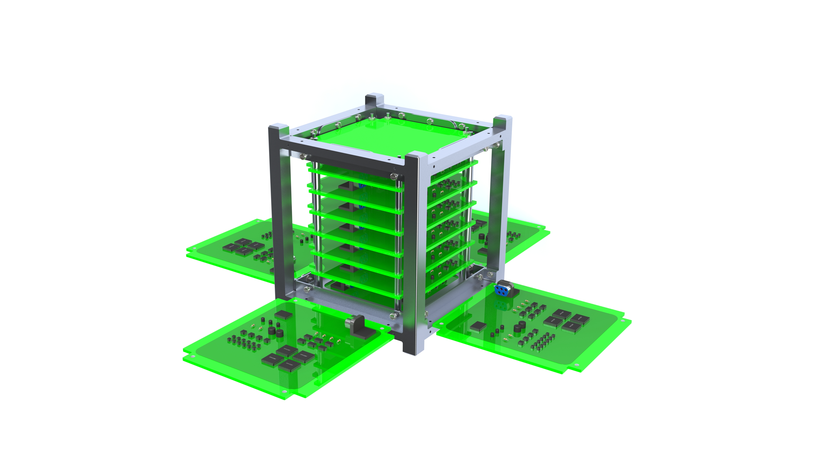
Materiais/Arquivos/Fotos/Print Screen/v01.2/5.JPG
