NSEE/Cubesat-Mec/Materiais/Mecânica/Modelo/Matlab/Testes/ctms/exp7.png

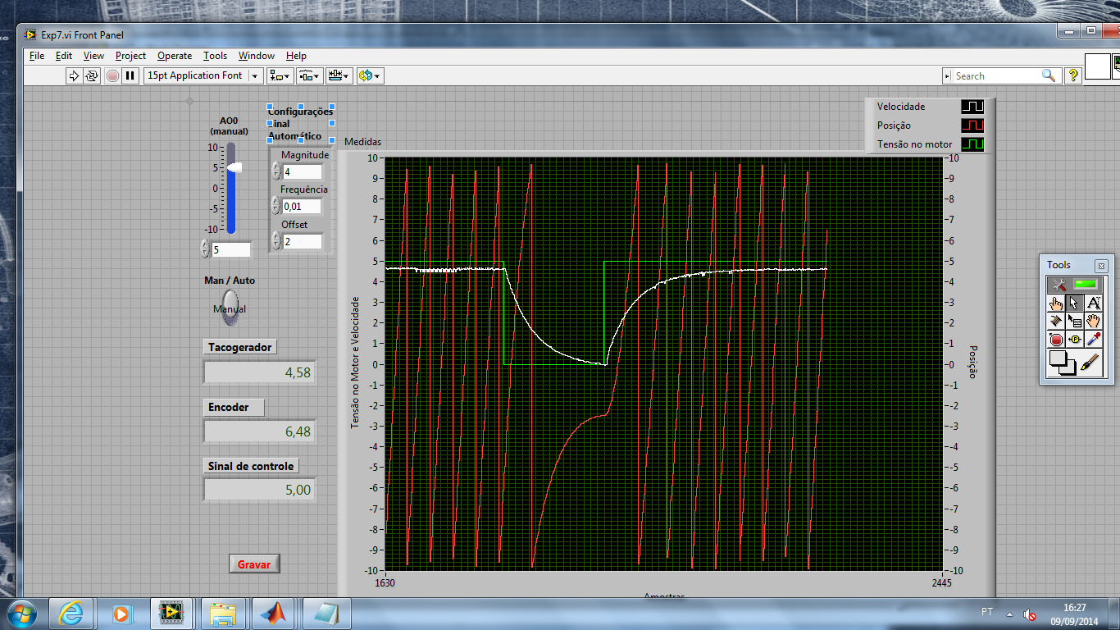
Materiais/Mecânica/Modelo/Matlab/Testes/ctms/exp7.png
