NSEE/Cubesat-Mec/Materiais/Arquivos/Relatórios/Manual Montagem/montagem.PDF

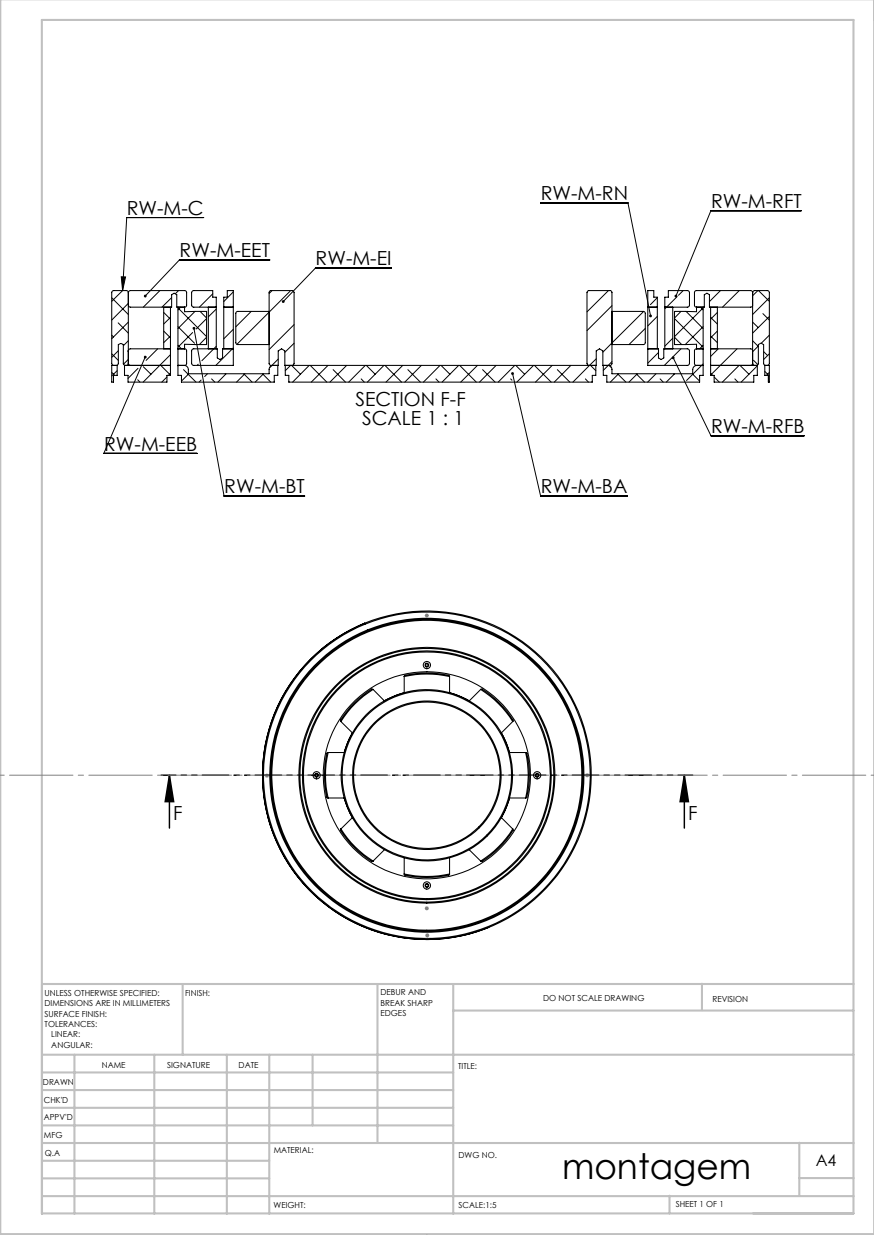
[picture p173: page 1]
SECTION F-F SCALE 1 : 1; SCALE:1:5; SHEET 1 OF 1; DO NOT SCALE DRAWING; REVISION; DEBUR AND BREAK SHARP; UNLESS OTHERWISE SPECIFIED:; FINISH:

DIMENSIONS ARE IN MILLIMETERS
SURFACE FINISH:
TOLERANCES:
LINEAR:
ANGULAR:

NAME | SIGNATURE | DATE | | | | TITLE:
Q.A | | | | MATERIAL: | montagem WEIGHT: DWG NO. | A4

DRAWN
CHK'D
APPV'D
MFG
