NSEE/Cubesat-Mec/Materiais/PCB/Dimensões PCB/v01.1/PDF/Cubesat-PCB-Side.PDF

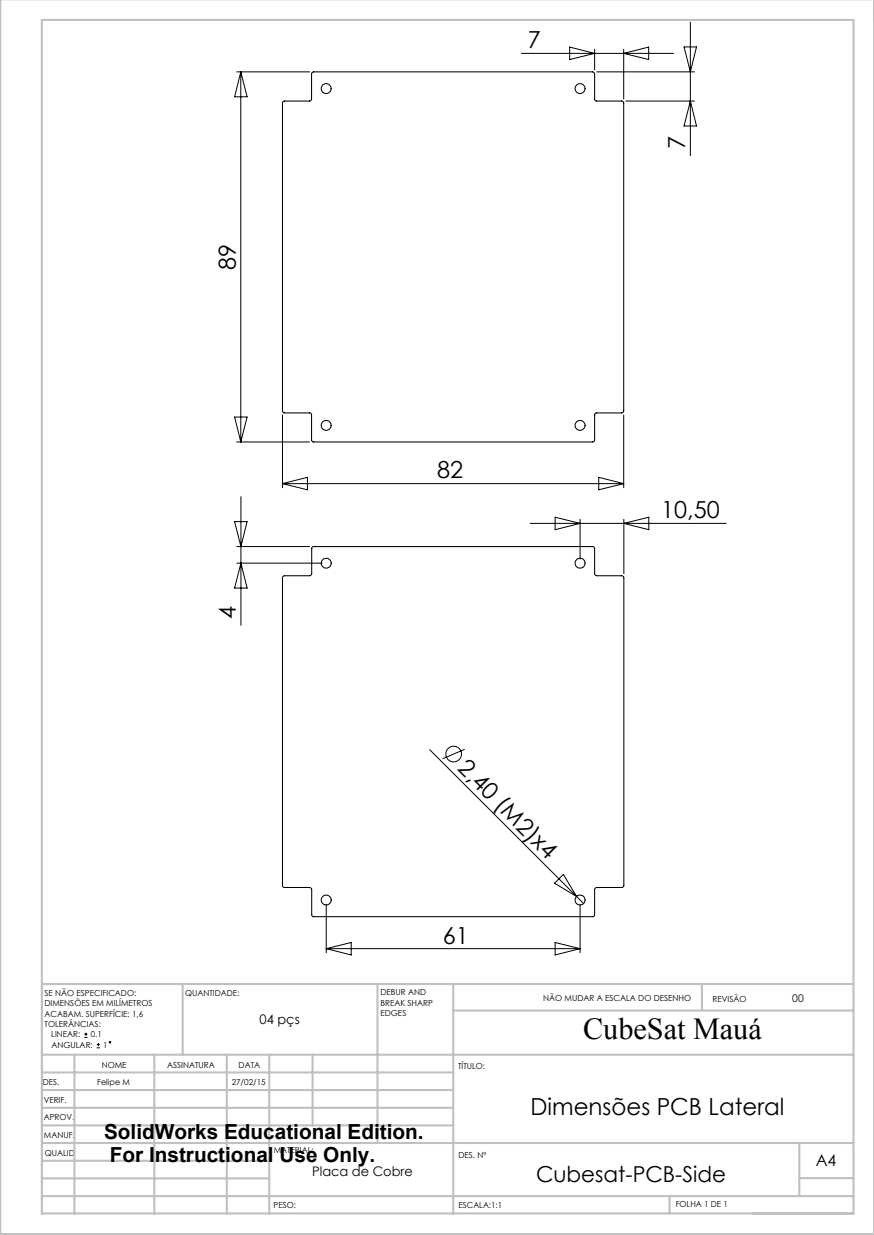
[picture p174: page 1]
CubeSat Mauá; 04 pçs; ESCALA:1:1; FOLHA 1 DE 1; NÃO MUDAR A ESCALA DO DESENHO; REVISÃO; DEBUR AND BREAK SHARP; SE NÃO ESPECIFICADO:; QUANTIDADE:

DIMENSÕES EM MILÍMETROS
ACABAM. SUPERFÍCIE: 1,6
TOLERÂNCIAS:
LINEAR: 0.1
ANGULAR: 1

NOME | ASSINATURA | DATA | | | | TÍTULO: Dimensões PCB Lateral

DES. | Felipe M | | 27/02/15
VERIF.
APROV.
MANUF. | SolidWorks Educational Edition.
QUALID | For Instructional Use Only. | | | MATERIAL: Placa de Cobre | DES. Nº Cubesat-PCB-Side | A4
