NSEE/Cubesat-Mec/Materiais/Mecânica/Construção/Arquivos Enviados para Construção/Mauá - Oficina/150326/Cubesat-1U-Assembly.PDF

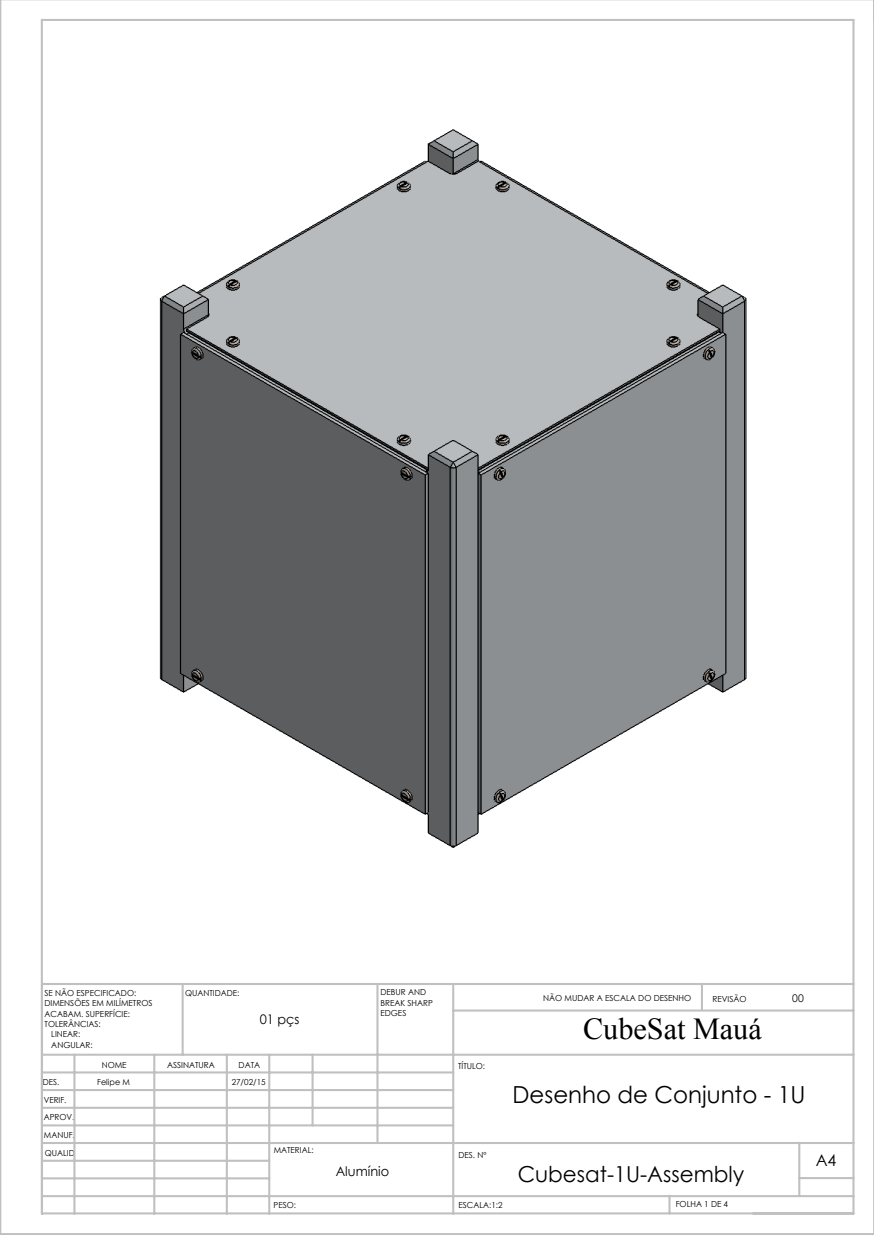
[picture p175: page 1]
CubeSat Mauá; 01 pçs; ESCALA:1:2; FOLHA 1 DE 4; NÃO MUDAR A ESCALA DO DESENHO; REVISÃO; DEBUR AND BREAK SHARP; SE NÃO ESPECIFICADO:; QUANTIDADE:

DIMENSÕES EM MILÍMETROS
ACABAM. SUPERFÍCIE:
TOLERÂNCIAS:
LINEAR:
ANGULAR:

NOME | ASSINATURA | DATA | | | | TÍTULO: Desenho de Conjunto - 1U

DES. | Felipe M | | 27/02/15
VERIF.
APROV.
MANUF.
QUALID | | | | MATERIAL: Alumínio | DES. Nº Cubesat-1U-Assembly | A4

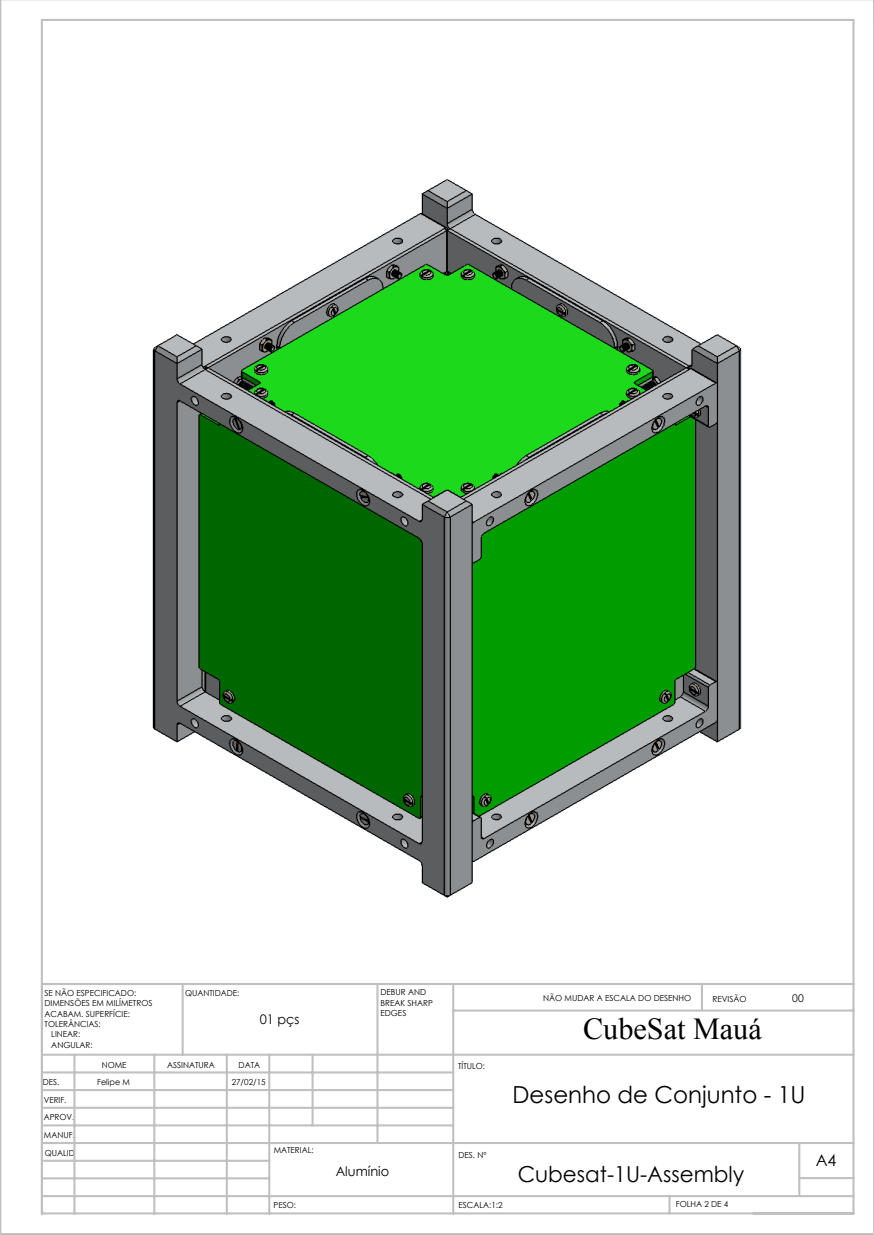
[picture p176: page 2]
CubeSat Mauá; 01 pçs; NÃO MUDAR A ESCALA DO DESENHO; REVISÃO; DEBUR AND BREAK SHARP; SE NÃO ESPECIFICADO:; QUANTIDADE:

DIMENSÕES EM MILÍMETROS
ACABAM. SUPERFÍCIE:
TOLERÂNCIAS:
LINEAR:
ANGULAR:

NOME | ASSINATURA | DATA | TÍTULO: Desenho de Conjunto - 1U

DES. | Felipe M | | 27/02/15
VERIF.
APROV.

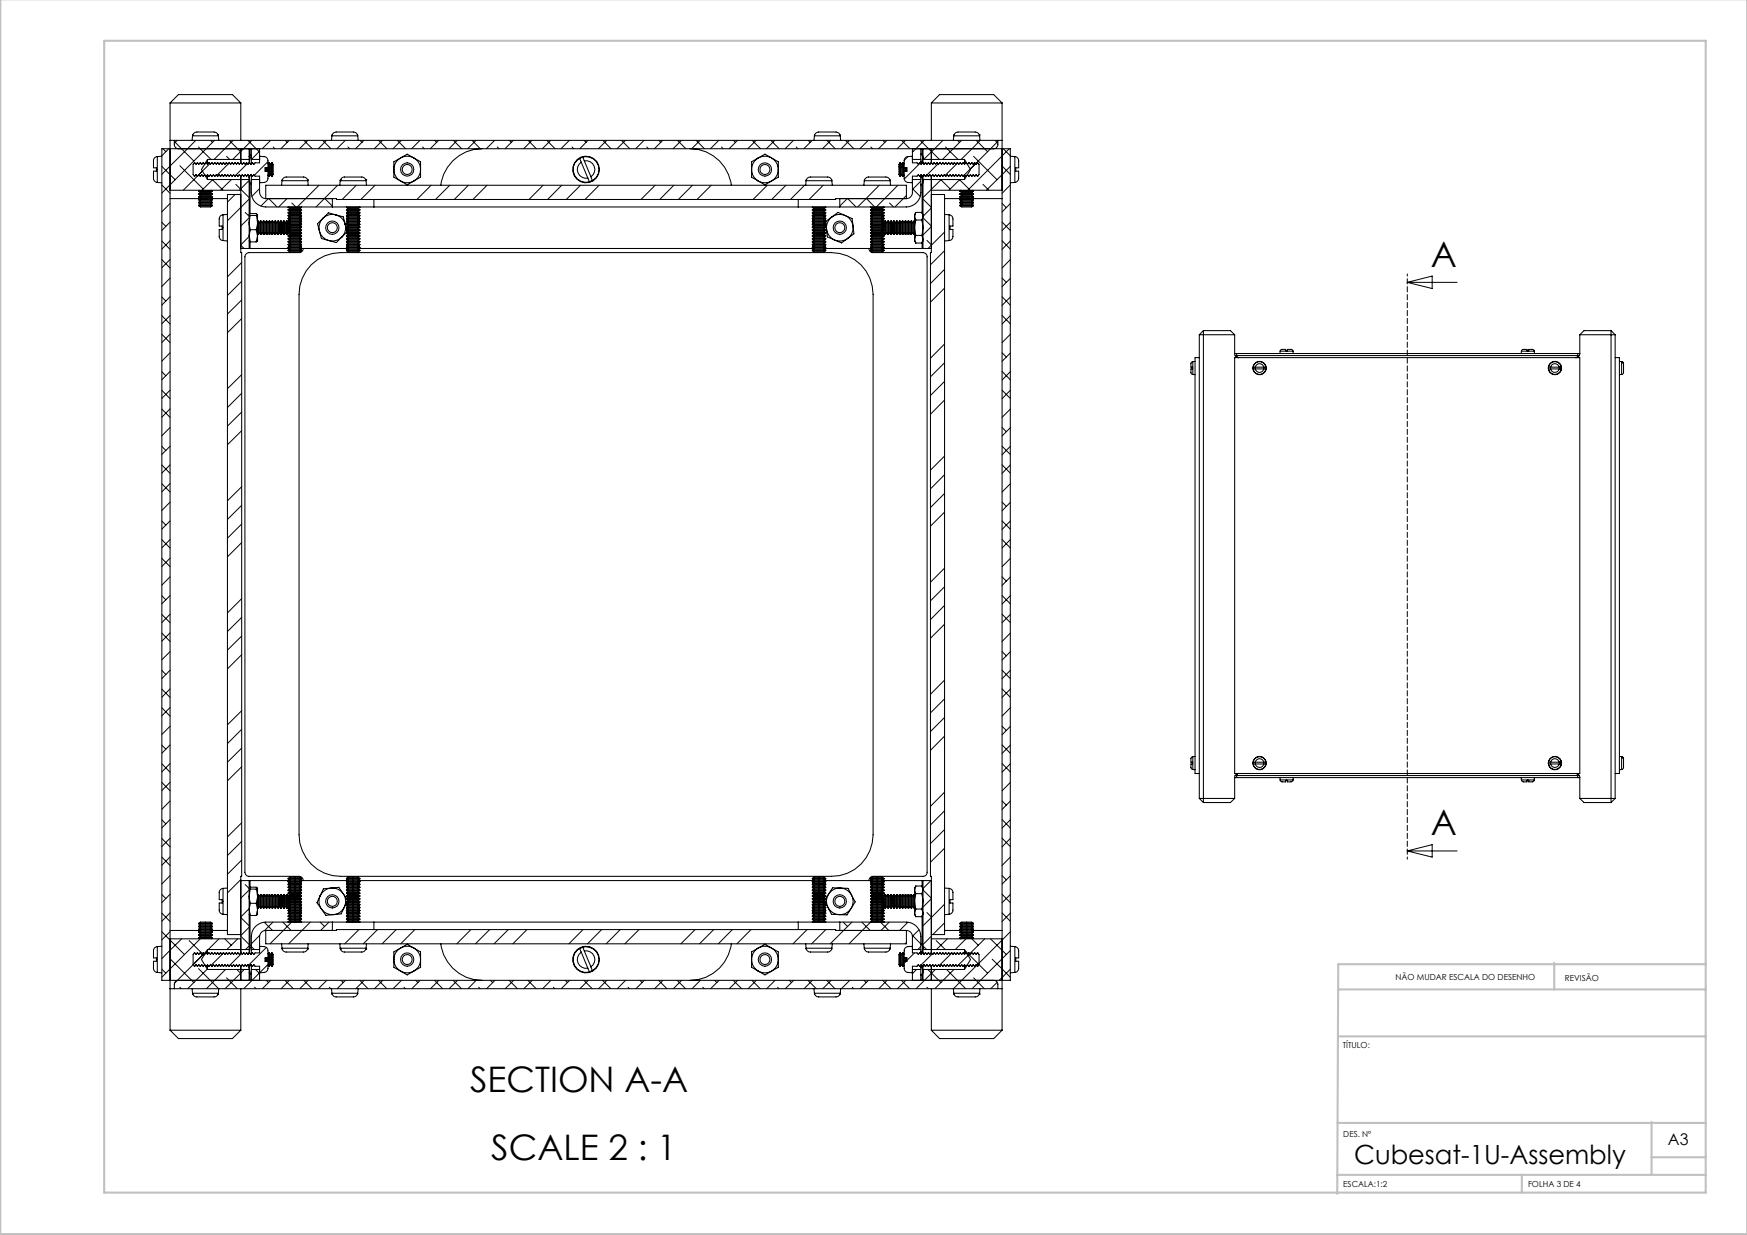
[picture p177: page 3]
SECTION A-A; SCALE 2 : 1; Cubesat-1U-Assembly; NÃO MUDAR ESCALA DO DESENHO; REVISÃO

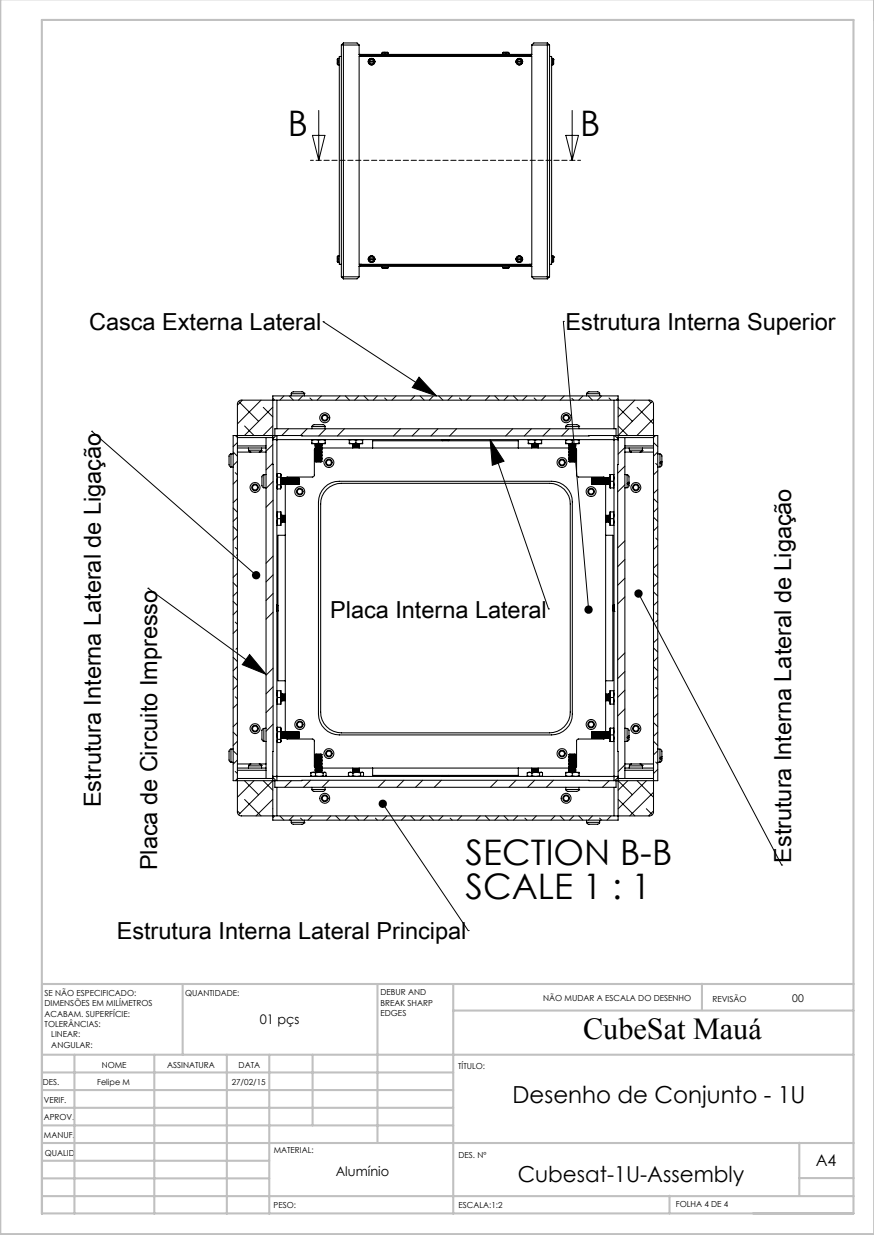
[picture p178: page 4]
SECTION B-B SCALE 1 : 1; Casca Externa Lateral Estrutura Interna Lateral de Ligação; Placa de Circuito Impresso; CubeSat Mauá; 01 pçs; NÃO MUDAR A ESCALA DO DESENHO; REVISÃO; DEBUR AND BREAK SHARP; SE NÃO ESPECIFICADO:; QUANTIDADE:

Estrutura Interna Superior

Estrutura Interna Lateral de Ligação

Placa Interna Lateral

Estrutura Interna Lateral Principal

DIMENSÕES EM MILÍMETROS
ACABAM. SUPERFÍCIE:
TOLERÂNCIAS:
LINEAR:
ANGULAR:

NOME | ASSINATURA | DATA | TÍTULO: Desenho de Conjunto - 1U

DES. | Felipe M | | 27/02/15
VERIF.
APROV.
