NSEE/Cubesat-Mec/Materiais/Mecânica/Construção/Folha de Processos/Corte a Jato D'água/v01.1/PDF/Cubesat-Struct-Int-Frame-Side01.PDF

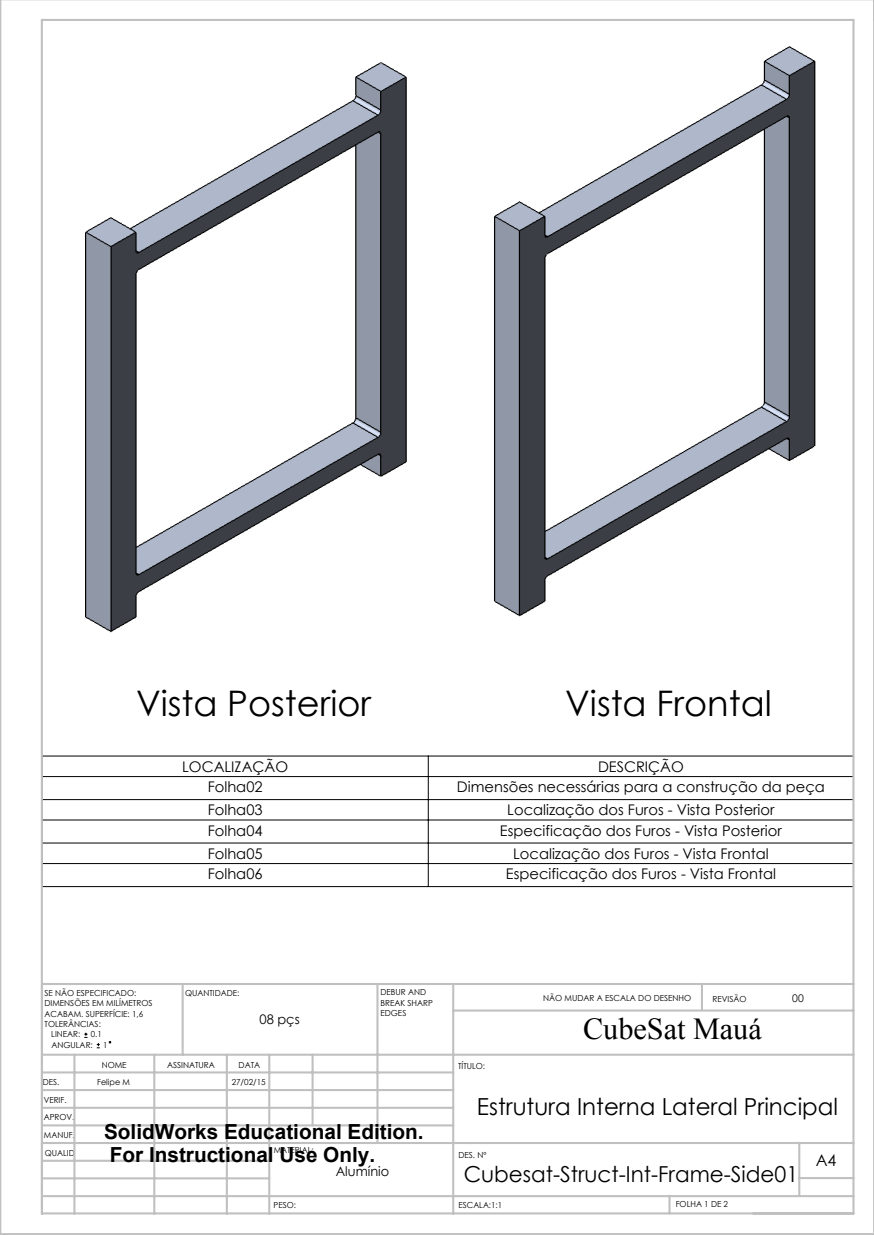
[picture p179: page 1]
Vista Posterior; Vista Frontal; CubeSat Mauá; 08 pçs; ESCALA:1:1; FOLHA 1 DE 2; NÃO MUDAR A ESCALA DO DESENHO; REVISÃO; DEBUR AND BREAK SHARP; SE NÃO ESPECIFICADO:; QUANTIDADE:

LOCALIZAÇÃO | DESCRIÇÃO
Folha02 | Dimensões necessárias para a construção da peça
Folha03 | Localização dos Furos - Vista Posterior
Folha04 | Especificação dos Furos - Vista Posterior
Folha05 | Localização dos Furos - Vista Frontal
Folha06 | Especificação dos Furos - Vista Frontal

DIMENSÕES EM MILÍMETROS
ACABAM. SUPERFÍCIE: 1,6
TOLERÂNCIAS:
LINEAR: 0.1
ANGULAR: 1

NOME | ASSINATURA | DATA | | | | TÍTULO: Estrutura Interna Lateral Principal

DES. | Felipe M | | 27/02/15
VERIF.
APROV.
MANUF. | SolidWorks Educational Edition.
QUALID | For Instructional Use Only. | | | MATERIAL: Alumínio | DES. Nº Cubesat-Struct-Int-Frame-Side01 | A4

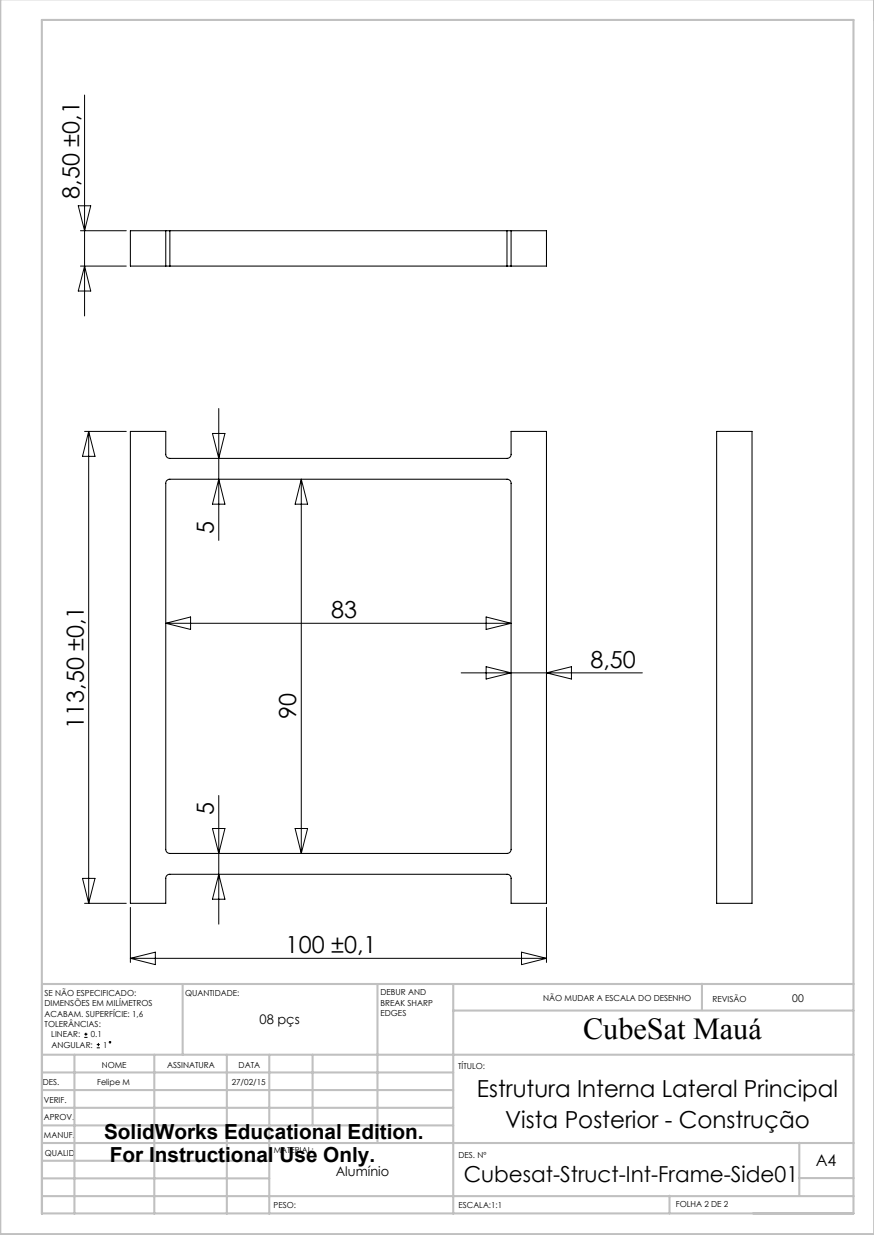
[picture p180: page 2]
CubeSat Mauá; 08 pçs; ESCALA:1:1; FOLHA 2 DE 2; NÃO MUDAR A ESCALA DO DESENHO; REVISÃO; DEBUR AND BREAK SHARP; SE NÃO ESPECIFICADO:; QUANTIDADE:

DIMENSÕES EM MILÍMETROS
ACABAM. SUPERFÍCIE: 1,6
TOLERÂNCIAS:
LINEAR: 0.1
ANGULAR: 1

NOME | ASSINATURA | DATA | | | | TÍTULO: Estrutura Interna Lateral Principal Vista Posterior - Construção SolidWorks Educational Edition.

DES. | Felipe M | | 27/02/15
VERIF.
APROV.
MANUF.
QUALID | For Instructional Use Only. | | | MATERIAL: Alumínio | DES. Nº Cubesat-Struct-Int-Frame-Side01 | A4
