NSEE/Cubesat-Mec/Materiais/Mecânica/Modelo/Solidworks/Inércia/Modelo 07/Cubesat_I_Flywheel_Mod07.PDF

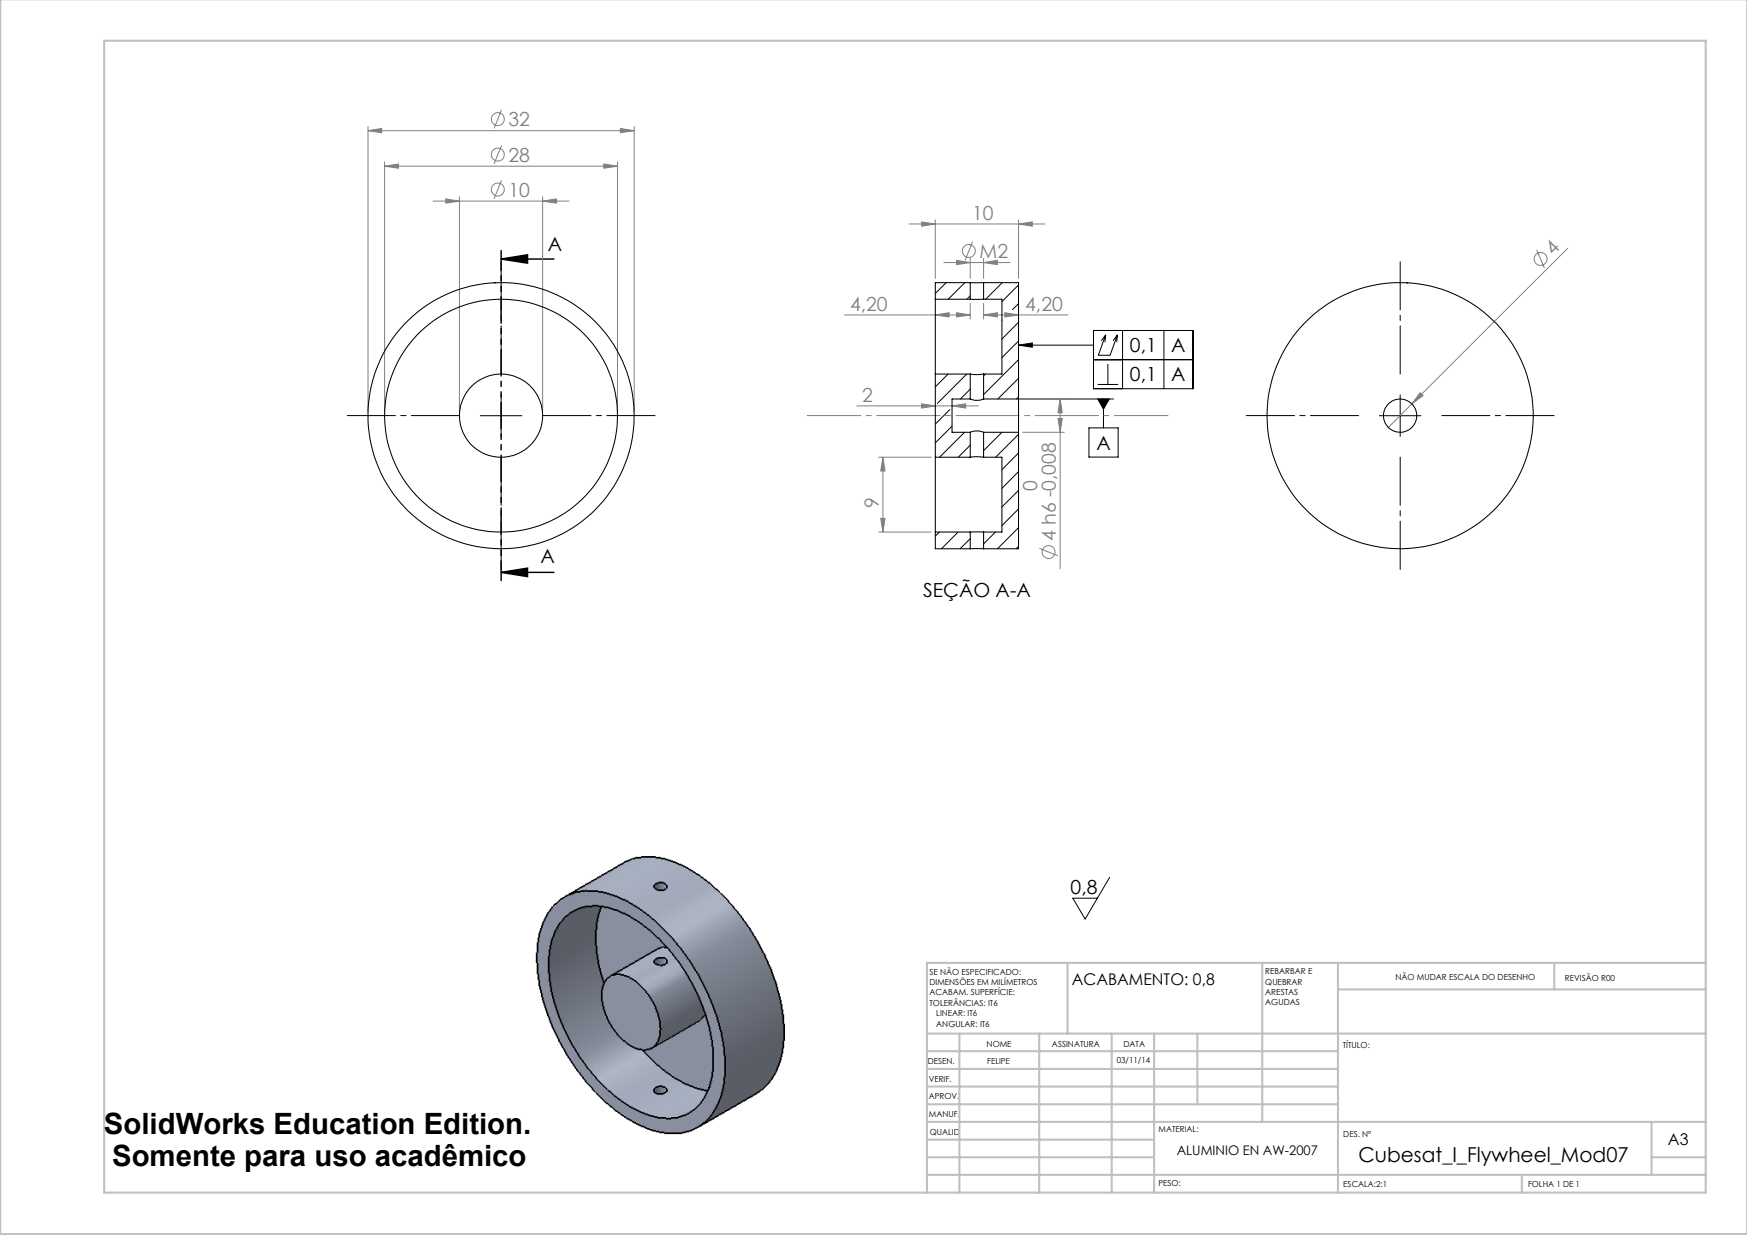
[picture p187: page 1]
SEÇÃO A-A; ESCALA:2:1; FOLHA 1 DE 1; NÃO MUDAR ESCALA DO DESENHO; REVISÃO R00; REBARBAR E

ACABAMENTO: 0,8 SE NÃO ESPECIFICADO:
DIMENSÕES EM MILÍMETROS
ACABAM. SUPERFÍCIE:
TOLERÂNCIAS: IT6
LINEAR: IT6
ANGULAR: IT6

NOME | ASSINATURA | DATA | | | | TÍTULO:

DESEN. | FELIPE | | 03/11/14
VERIF.
APROV.
MANUF.
QUALID | | | | MATERIAL: ALUMINIO EN AW-2007 | DES. Nº Cubesat_I_Flywheel_Mod07 | A3

SolidWorks Education Edition.
Somente para uso acadêmico
