NSEE/Cubesat-Mec/Materiais/Mecânica/Construção/Arquivos Enviados para Construção/Mauá - Oficina/150326/Cubesat-Struct-Ext-Shell-Top.PDF

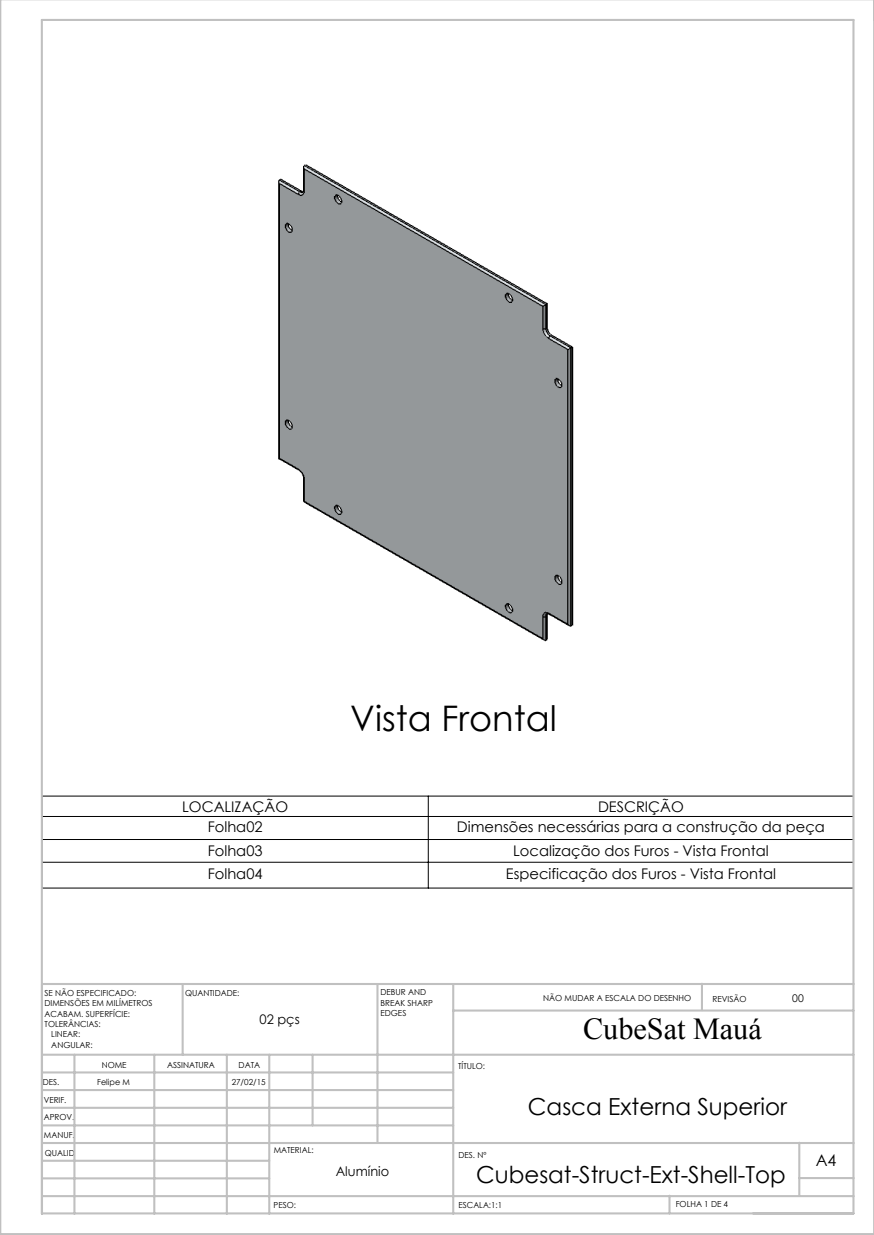
[picture p192: page 1]
Vista Frontal; CubeSat Mauá; 02 pçs; ESCALA:1:1; FOLHA 1 DE 4; NÃO MUDAR A ESCALA DO DESENHO; REVISÃO; DEBUR AND BREAK SHARP; SE NÃO ESPECIFICADO:; QUANTIDADE:

LOCALIZAÇÃO | DESCRIÇÃO
Folha02 | Dimensões necessárias para a construção da peça
Folha03 | Localização dos Furos - Vista Frontal
Folha04 | Especificação dos Furos - Vista Frontal

DIMENSÕES EM MILÍMETROS
ACABAM. SUPERFÍCIE:
TOLERÂNCIAS:
LINEAR:
ANGULAR:

NOME | ASSINATURA | DATA | | | | TÍTULO: Casca Externa Superior

DES. | Felipe M | | 27/02/15
VERIF.
APROV.
MANUF.
QUALID | | | | MATERIAL: Alumínio | DES. Nº Cubesat-Struct-Ext-Shell-Top | A4

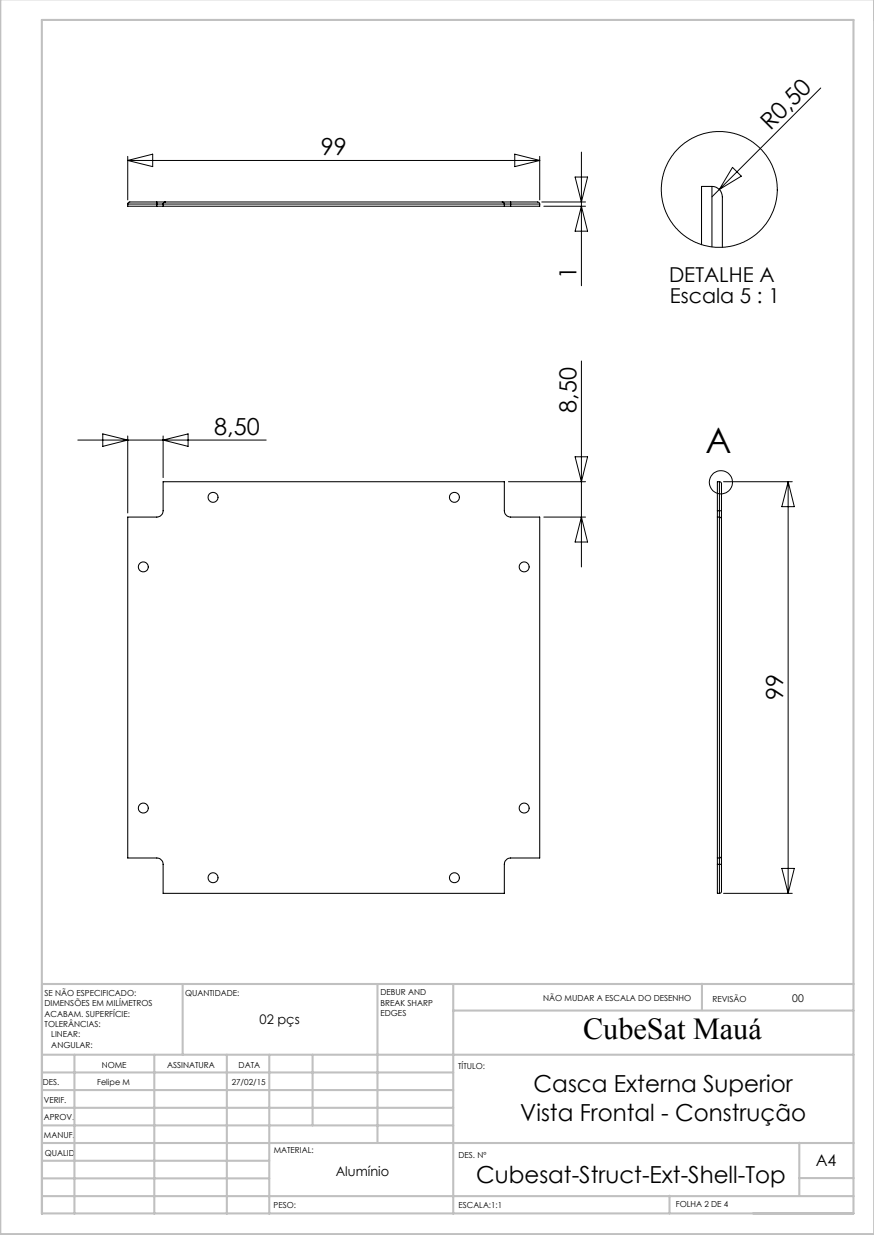
[picture p193: page 2]
DETALHE A Escala 5 : 1; CubeSat Mauá; 02 pçs; NÃO MUDAR A ESCALA DO DESENHO; REVISÃO; DEBUR AND BREAK SHARP; SE NÃO ESPECIFICADO:; QUANTIDADE:

DIMENSÕES EM MILÍMETROS
ACABAM. SUPERFÍCIE:
TOLERÂNCIAS:
LINEAR:
ANGULAR:

NOME | ASSINATURA | DATA | TÍTULO: Casca Externa Superior Vista Frontal - Construção

DES. | Felipe M | | 27/02/15
VERIF.
APROV.

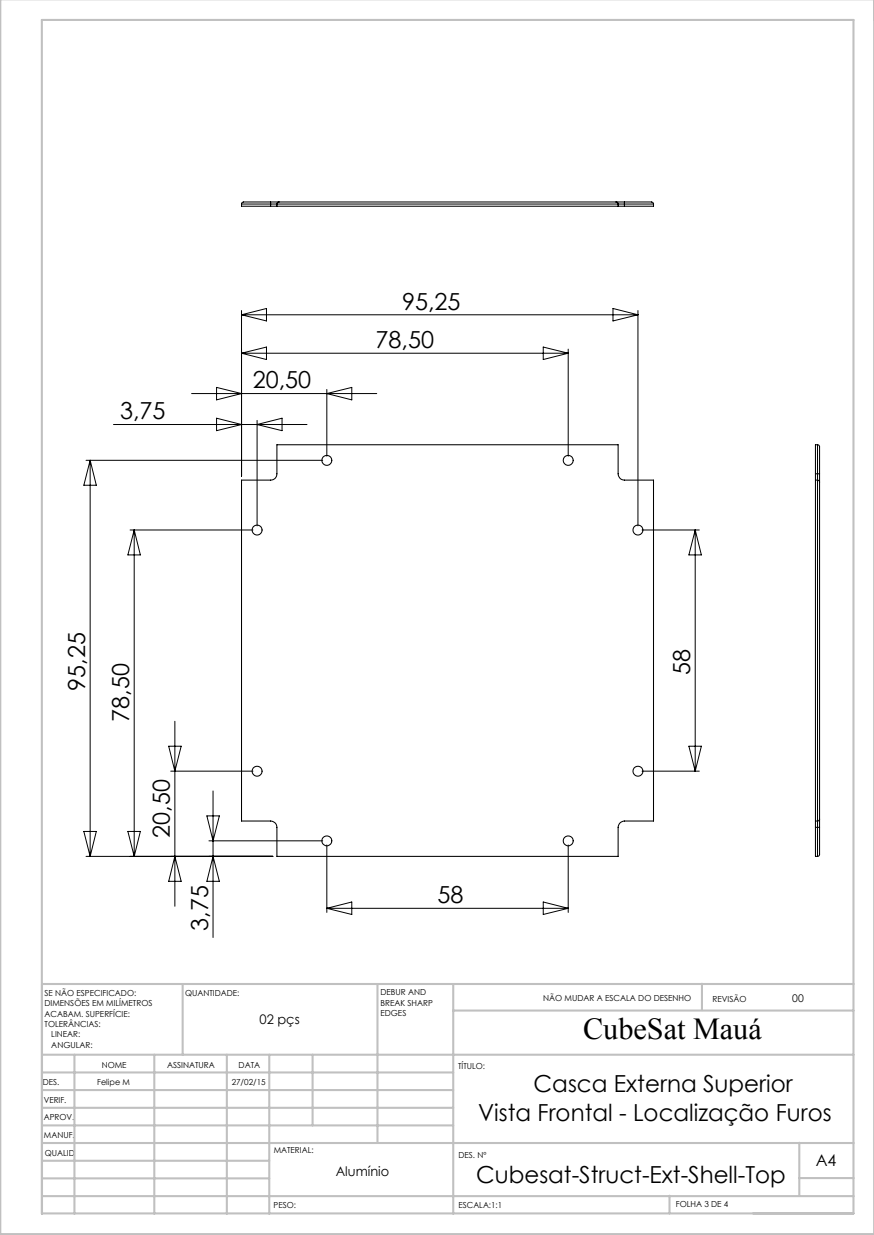
[picture p194: page 3]
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

DIMENSÕES EM MILÍMETROS
ACABAM. SUPERFÍCIE:
TOLERÂNCIAS:
LINEAR:
ANGULAR:

NOME | ASSINATURA | DATA | TÍTULO: Casca Externa Superior Vista Frontal - Localização Furos

DES. | Felipe M | | 27/02/15
VERIF.
APROV.

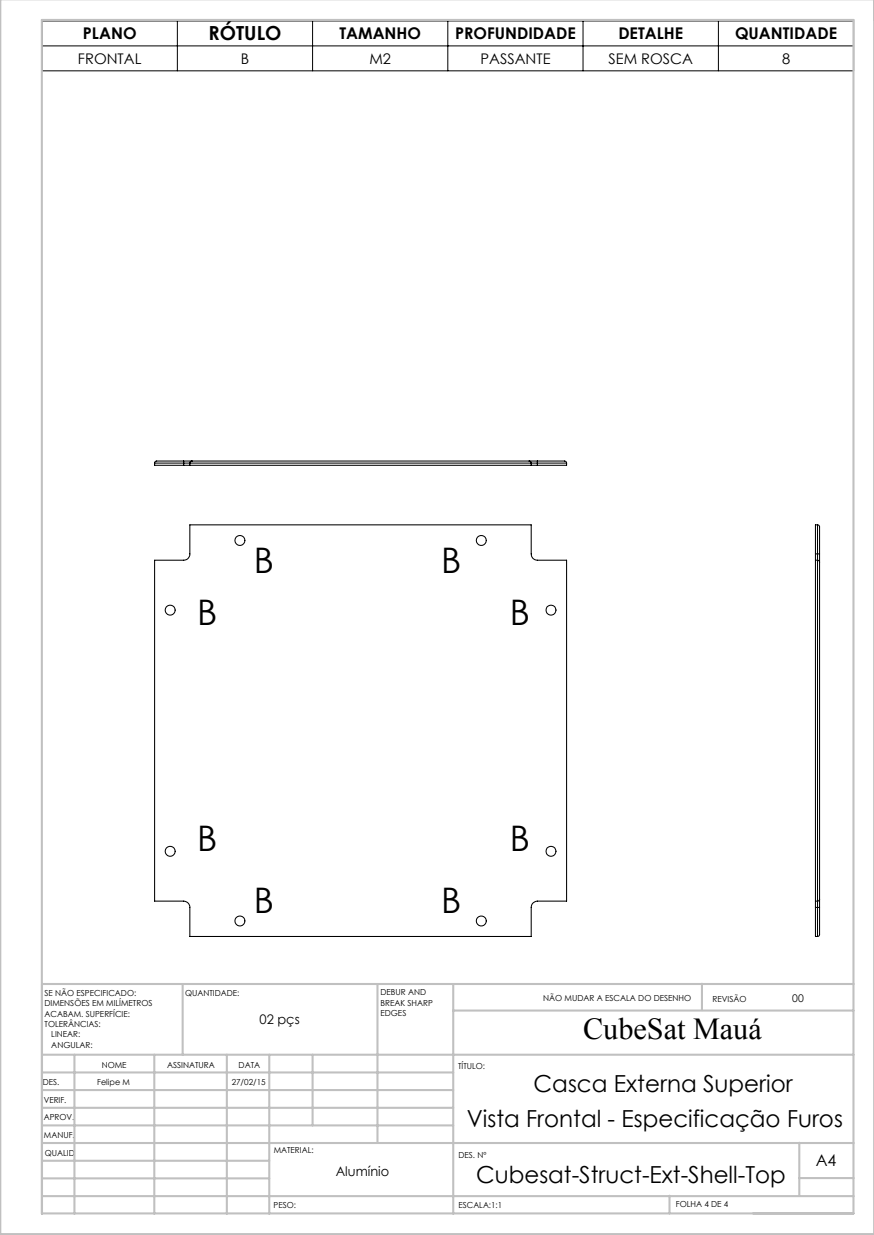
[picture p195: page 4]
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

PLANO | RÓTULO | TAMANHO | PROFUNDIDADE | DETALHE | QUANTIDADE
FRONTAL | B | M2 | PASSANTE | SEM ROSCA | 8

DIMENSÕES EM MILÍMETROS
ACABAM. SUPERFÍCIE:
TOLERÂNCIAS:
LINEAR:
ANGULAR:

NOME | ASSINATURA | DATA | TÍTULO: Casca Externa Superior Vista Frontal - Especificação Furos

DES. | Felipe M | | 27/02/15
VERIF.
APROV.
