NSEE/Cubesat-Mec/Materiais/Mecânica/Construção/Arquivos Enviados para Construção/Mauá - Oficina/150326/Cubesat-Struct-Int-Frame-Top.PDF

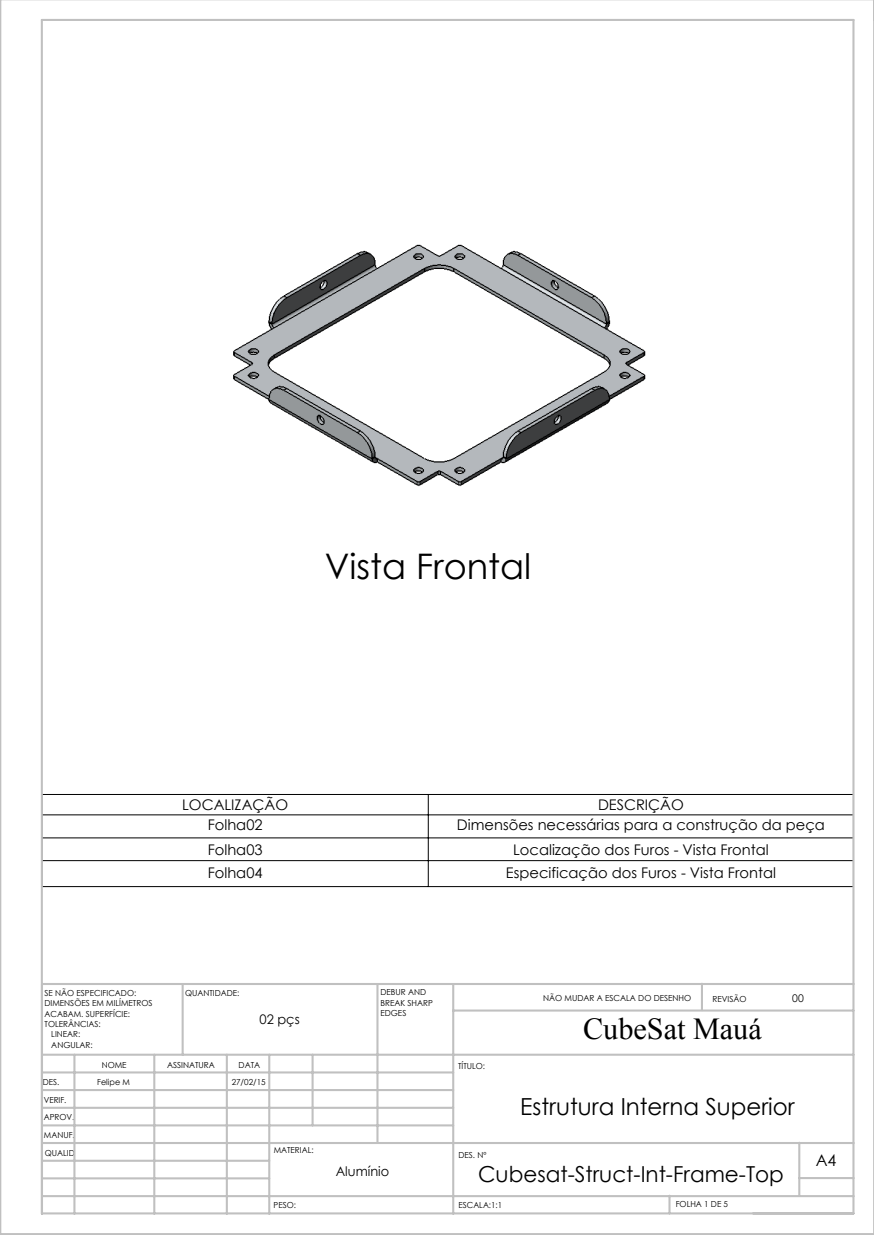
[picture p196: page 1]
Vista Frontal; CubeSat Mauá; 02 pçs; ESCALA:1:1; FOLHA 1 DE 5; NÃO MUDAR A ESCALA DO DESENHO; REVISÃO; DEBUR AND BREAK SHARP; SE NÃO ESPECIFICADO:; QUANTIDADE:

LOCALIZAÇÃO | DESCRIÇÃO
Folha02 | Dimensões necessárias para a construção da peça
Folha03 | Localização dos Furos - Vista Frontal
Folha04 | Especificação dos Furos - Vista Frontal

DIMENSÕES EM MILÍMETROS
ACABAM. SUPERFÍCIE:
TOLERÂNCIAS:
LINEAR:
ANGULAR:

NOME | ASSINATURA | DATA | | | | TÍTULO: Estrutura Interna Superior

DES. | Felipe M | | 27/02/15
VERIF.
APROV.
MANUF.
QUALID | | | | MATERIAL: Alumínio | DES. Nº Cubesat-Struct-Int-Frame-Top | A4

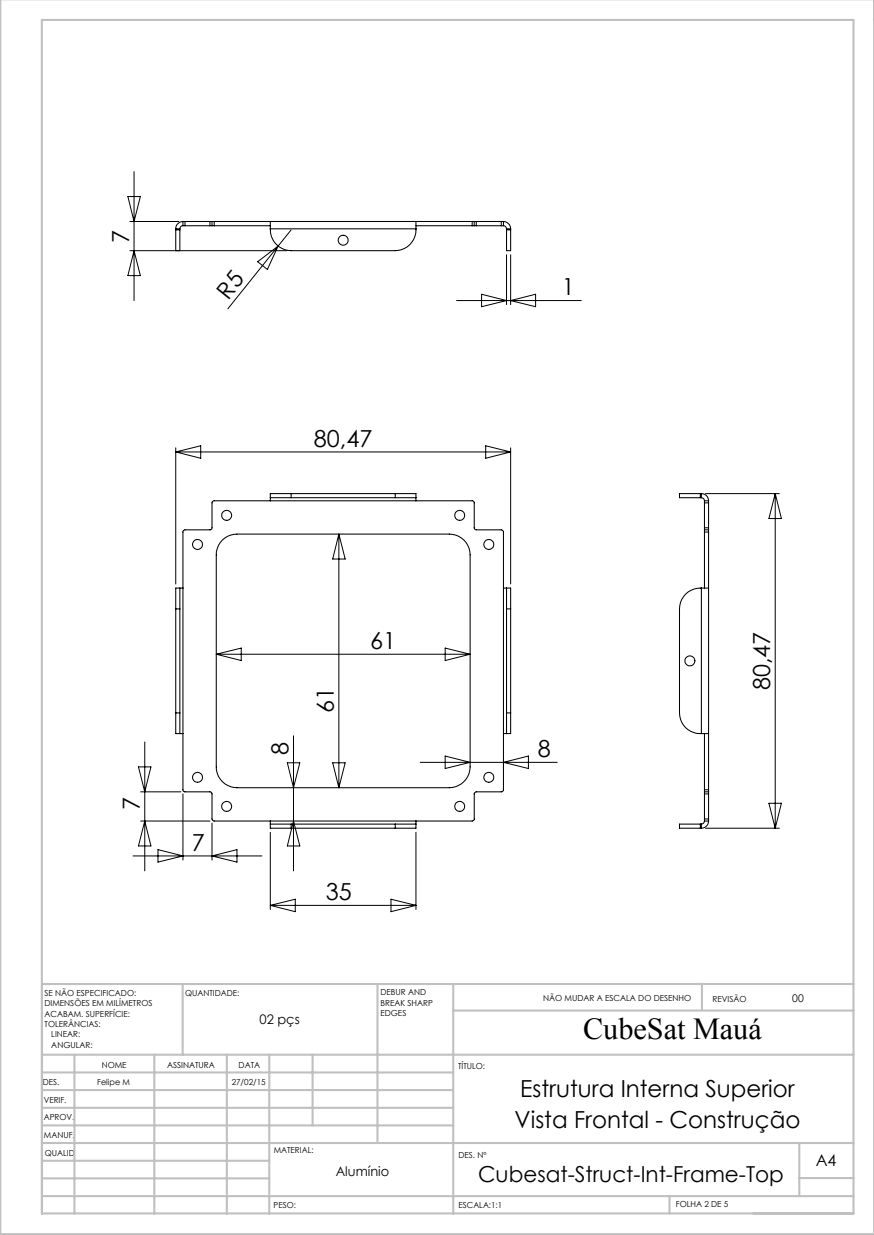
[picture p197: page 2]
CubeSat Mauá; 02 pçs; NÃO MUDAR A ESCALA DO DESENHO; REVISÃO; DEBUR AND BREAK SHARP; SE NÃO ESPECIFICADO:; QUANTIDADE:

DIMENSÕES EM MILÍMETROS
ACABAM. SUPERFÍCIE:
TOLERÂNCIAS:
LINEAR:
ANGULAR:

NOME | ASSINATURA | DATA | TÍTULO: Estrutura Interna Superior Vista Frontal - Construção

DES. | Felipe M | | 27/02/15
VERIF.
APROV.

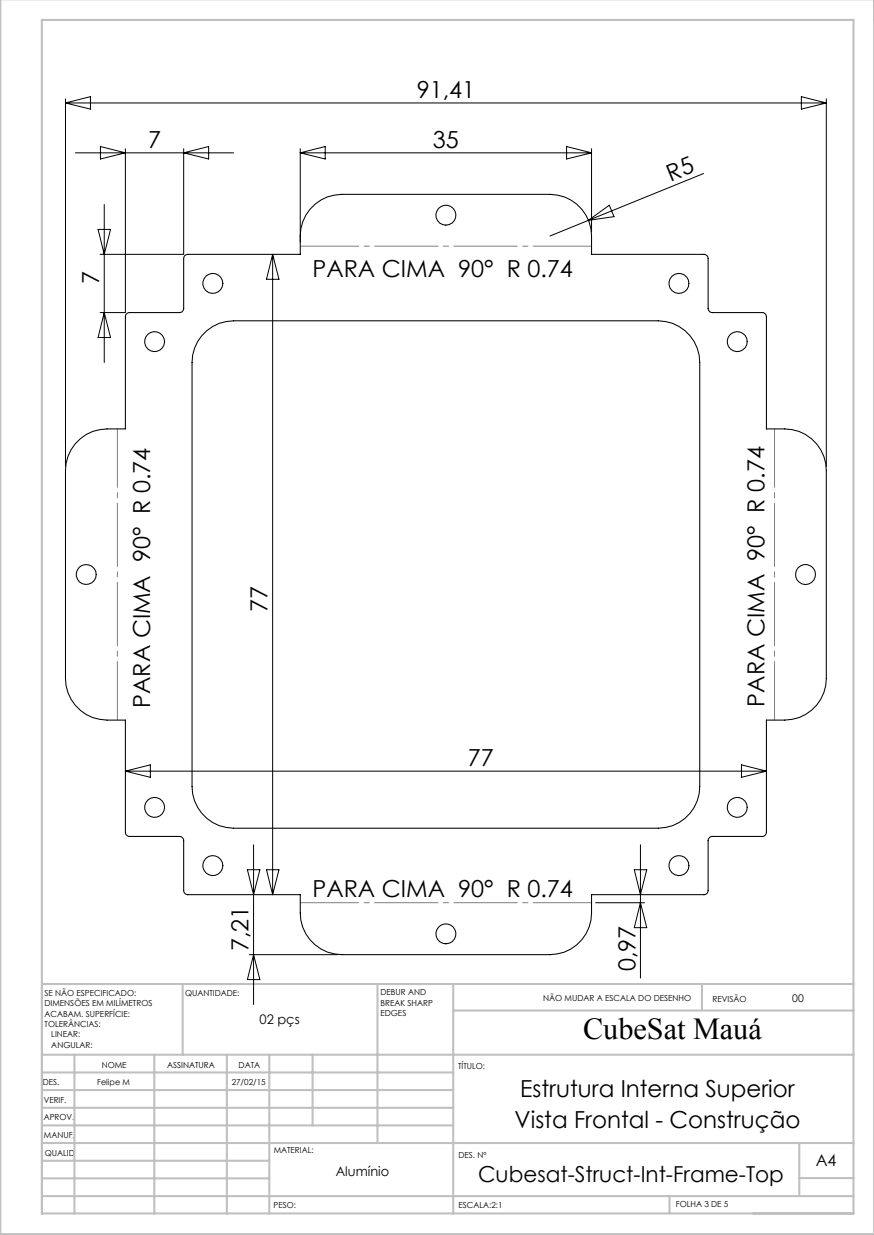
[picture p198: page 3]
PARA CIMA 90° R 0.74; CubeSat Mauá; 02 pçs; ESCALA:2:1; FOLHA 3 DE 5; NÃO MUDAR A ESCALA DO DESENHO; REVISÃO; DEBUR AND BREAK SHARP; SE NÃO ESPECIFICADO:; QUANTIDADE:

DIMENSÕES EM MILÍMETROS
ACABAM. SUPERFÍCIE:
TOLERÂNCIAS:
LINEAR:
ANGULAR:

NOME | ASSINATURA | DATA | TÍTULO: Estrutura Interna Superior Vista Frontal - Construção

DES. | Felipe M | | 27/02/15
VERIF.
APROV.

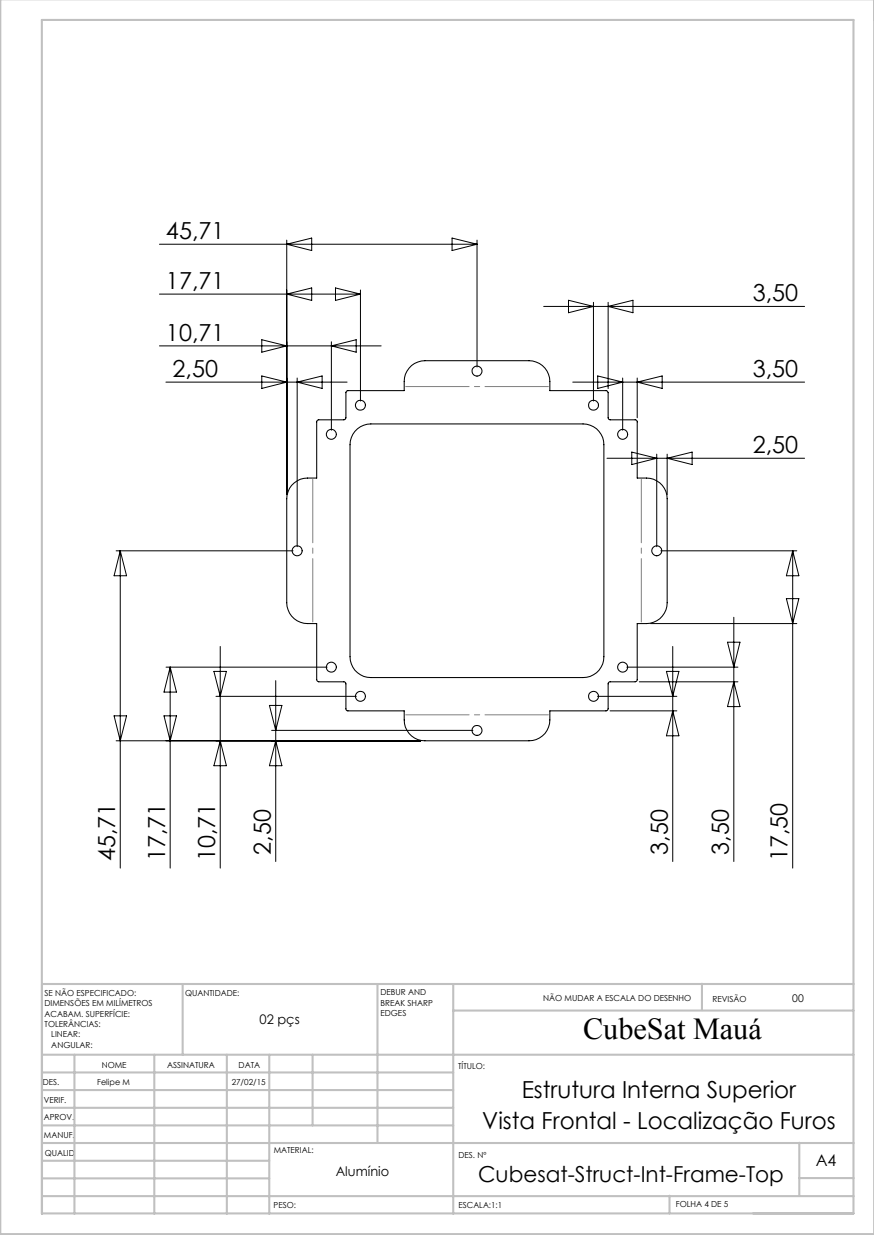
[picture p199: page 4]
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

DIMENSÕES EM MILÍMETROS
ACABAM. SUPERFÍCIE:
TOLERÂNCIAS:
LINEAR:
ANGULAR:

NOME | ASSINATURA | DATA | TÍTULO: Estrutura Interna Superior Vista Frontal - Localização Furos

DES. | Felipe M | | 27/02/15
VERIF.
APROV.

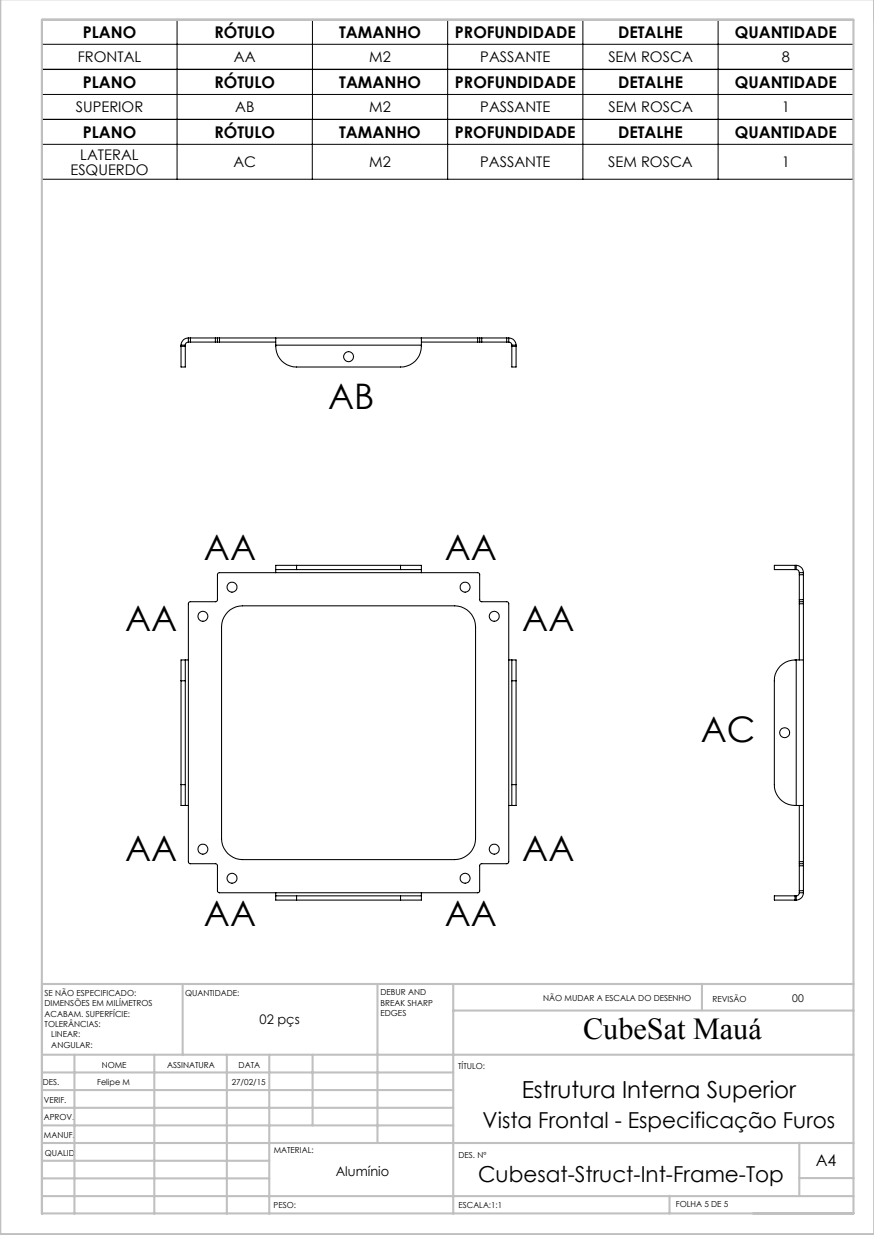
[picture p200: page 5]
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

PLANO | RÓTULO | TAMANHO | PROFUNDIDADE | DETALHE | QUANTIDADE
FRONTAL | AA | M2 | PASSANTE | SEM ROSCA | 8
SUPERIOR | AB | M2 | PASSANTE | SEM ROSCA | 1
LATERAL ESQUERDO | AC | M2 | PASSANTE | SEM ROSCA | 1

DIMENSÕES EM MILÍMETROS
ACABAM. SUPERFÍCIE:
TOLERÂNCIAS:
LINEAR:
ANGULAR:

NOME | ASSINATURA | DATA | TÍTULO: Estrutura Interna Superior Vista Frontal - Especificação Furos

DES. | Felipe M | | 27/02/15
VERIF.
APROV.
