NSEE/Cubesat-Mec/Materiais/Mecânica/Construção/Arquivos Enviados para Construção/Maquidema - Mayara/150826/PDF/Cubesat-Struct-Ext-Shell-Side-3U.PDF

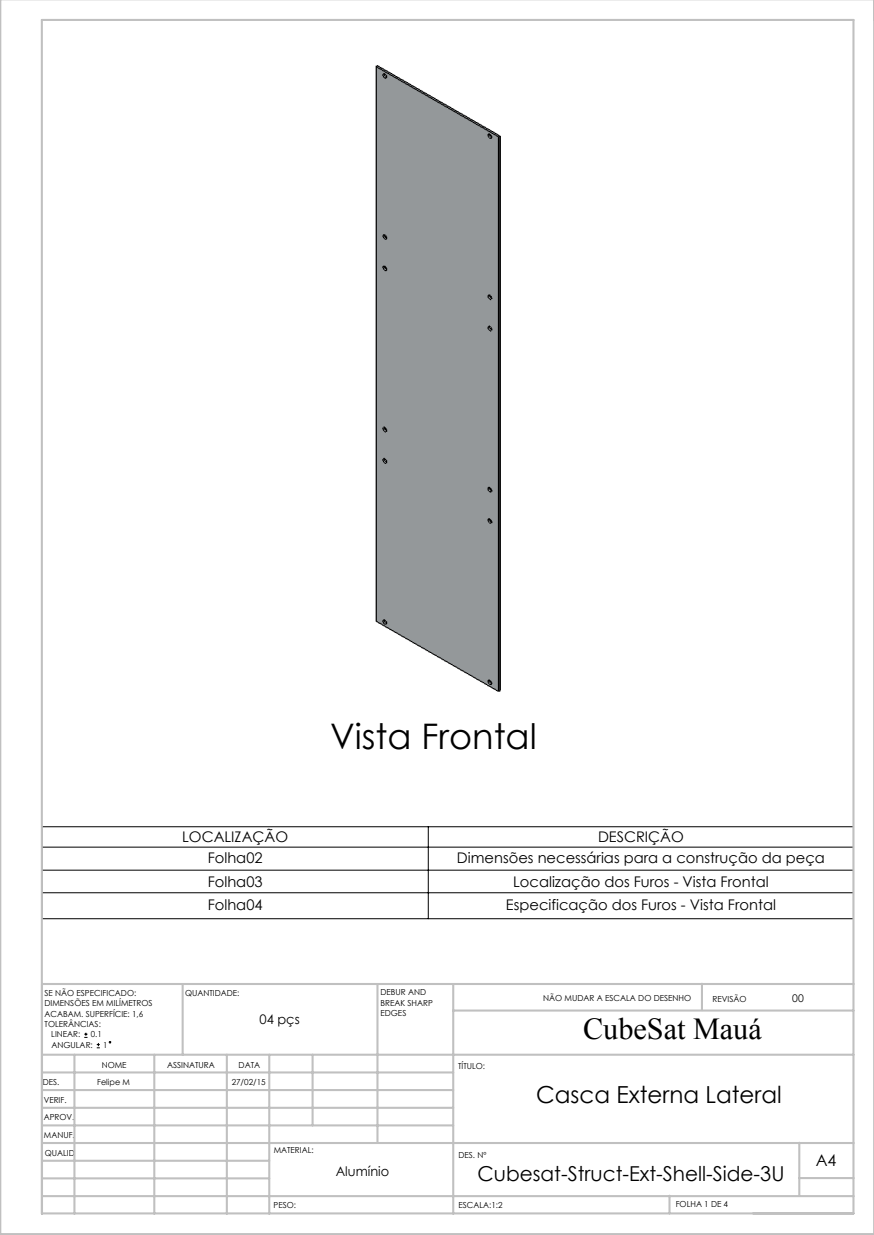
[picture p205: page 1]
Vista Frontal; CubeSat Mauá; 04 pçs; ESCALA:1:2; FOLHA 1 DE 4; NÃO MUDAR A ESCALA DO DESENHO; REVISÃO; DEBUR AND BREAK SHARP; SE NÃO ESPECIFICADO:; QUANTIDADE:

LOCALIZAÇÃO | DESCRIÇÃO
Folha02 | Dimensões necessárias para a construção da peça
Folha03 | Localização dos Furos - Vista Frontal
Folha04 | Especificação dos Furos - Vista Frontal

DIMENSÕES EM MILÍMETROS
ACABAM. SUPERFÍCIE: 1,6
TOLERÂNCIAS:
LINEAR: 0.1
ANGULAR: 1

NOME | ASSINATURA | DATA | | | | TÍTULO: Casca Externa Lateral

DES. | Felipe M | | 27/02/15
VERIF.
APROV.
MANUF.
QUALID | | | | MATERIAL: Alumínio | DES. Nº Cubesat-Struct-Ext-Shell-Side-3U | A4

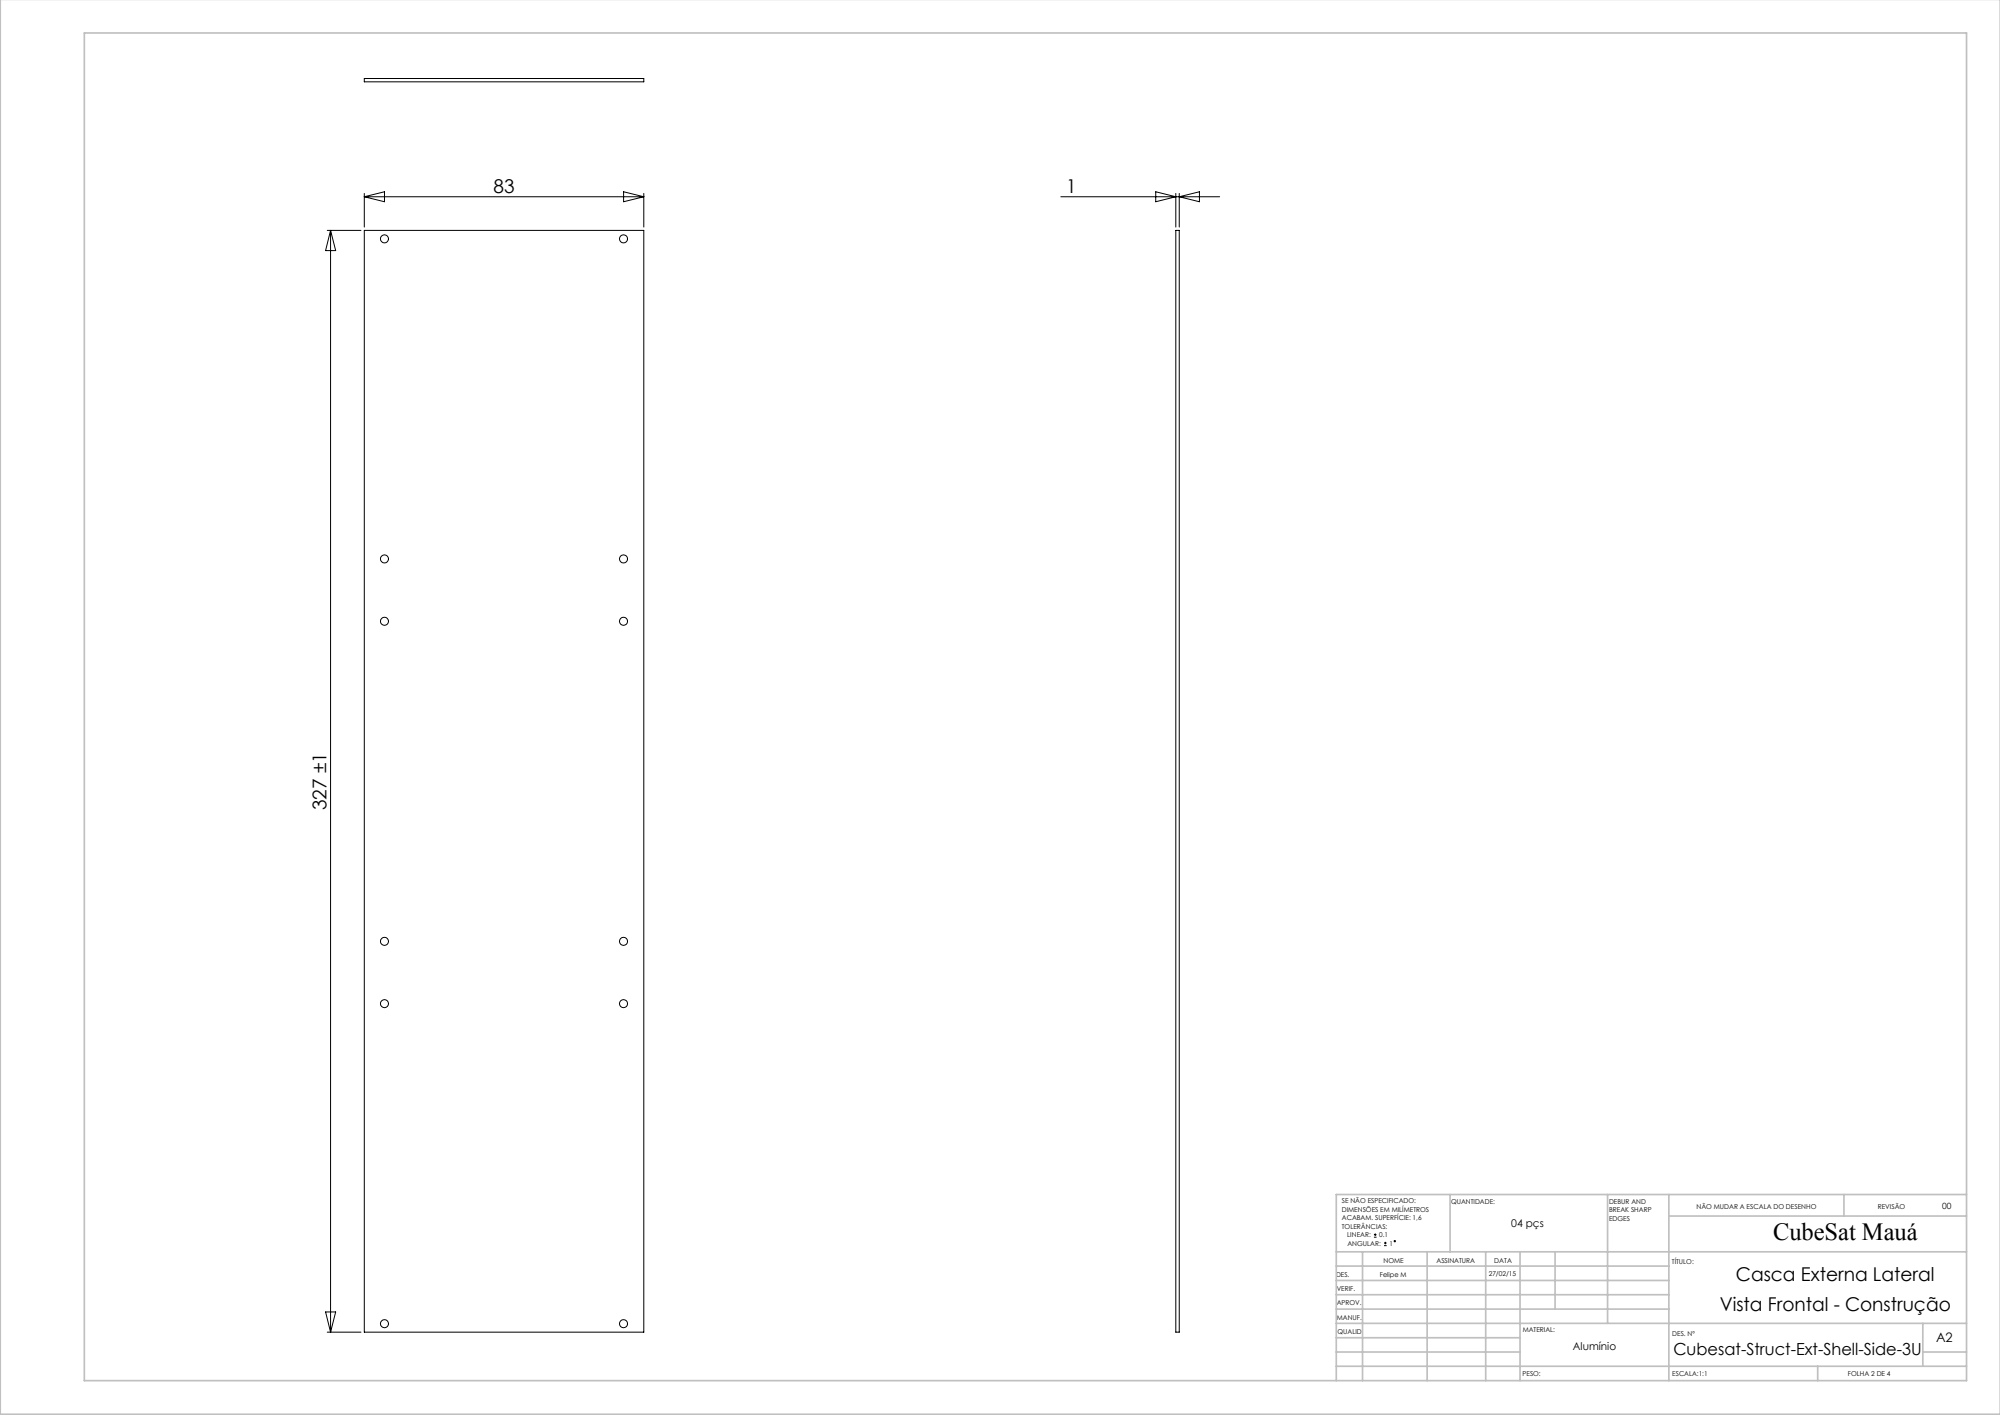
[picture p206: page 2]
CubeSat Mauá; 04 pçs; FOLHA 2 DE 4; NÃO MUDAR A ESCALA DO DESENHO; REVISÃO; DEBUR AND BREAK SHARP; SE NÃO ESPECIFICADO:; QUANTIDADE:

DIMENSÕES EM MILÍMETROS
ACABAM. SUPERFÍCIE: 1,6
TOLERÂNCIAS:
LINEAR: 0.1
ANGULAR: 1

NOME | ASSINATURA | DATA | TÍTULO: Casca Externa Lateral Vista Frontal - Construção

DES. | Felipe M | | 27/02/15
VERIF.
APROV.

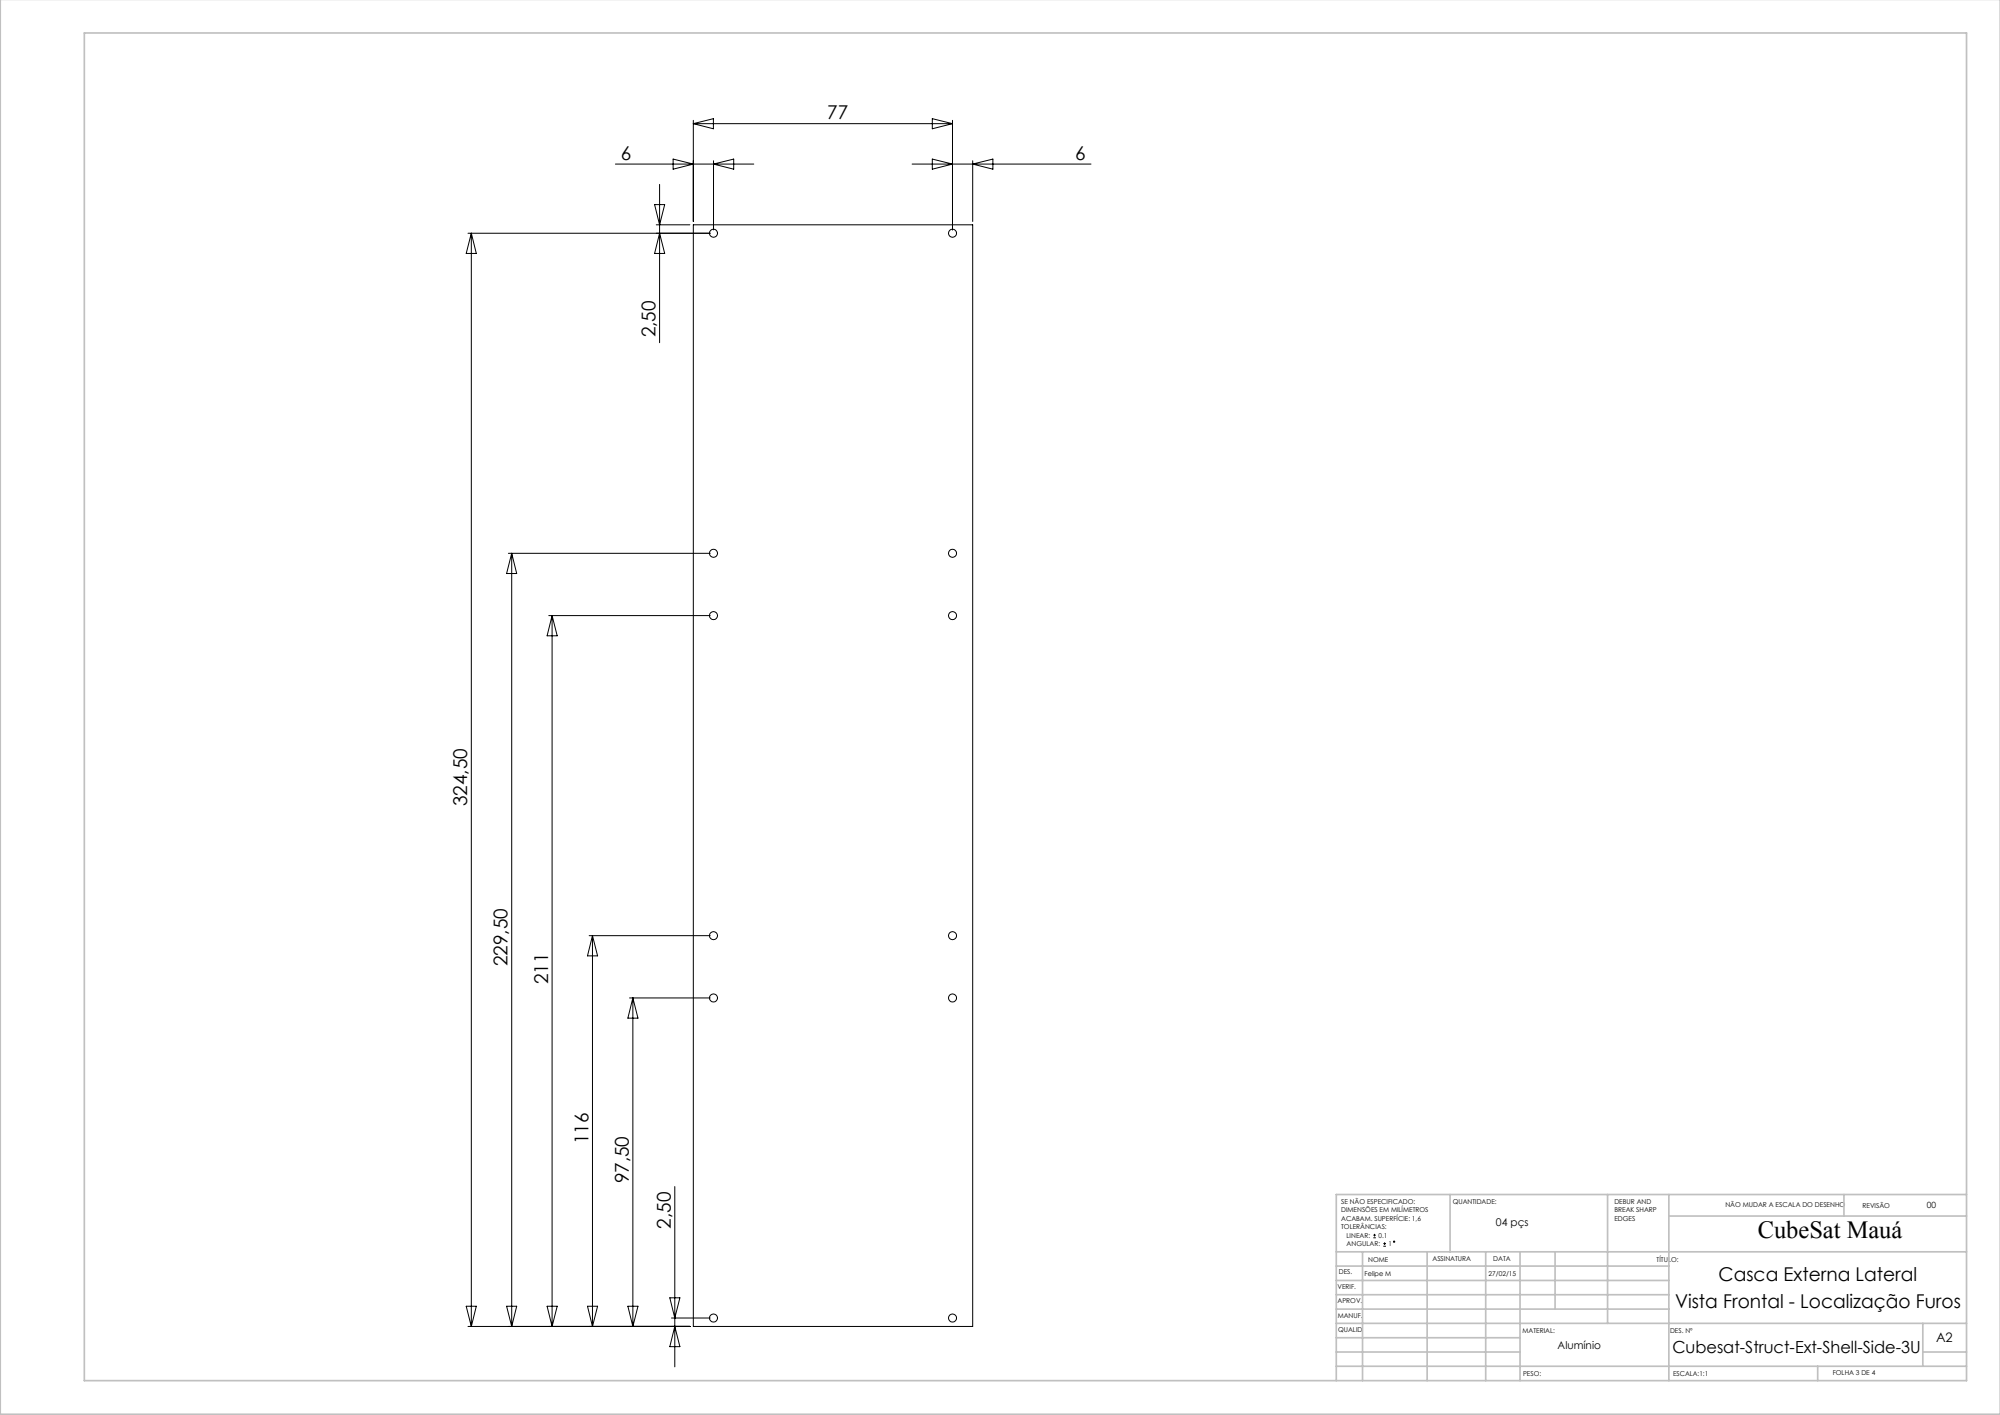
[picture p207: page 3]
CubeSat Mauá; 04 pçs; ESCALA:1:1; FOLHA 3 DE 4; NÃO MUDAR A ESCALA DO DESENHO; REVISÃO; DEBUR AND BREAK SHARP; SE NÃO ESPECIFICADO:; QUANTIDADE:

DIMENSÕES EM MILÍMETROS
ACABAM. SUPERFÍCIE: 1,6
TOLERÂNCIAS:
LINEAR: 0.1
ANGULAR: 1

NOME | ASSINATURA | DATA | TÍTULO: | Casca Externa Lateral Vista Frontal - Localização Furos

DES. | Felipe M | | 27/02/15
VERIF.

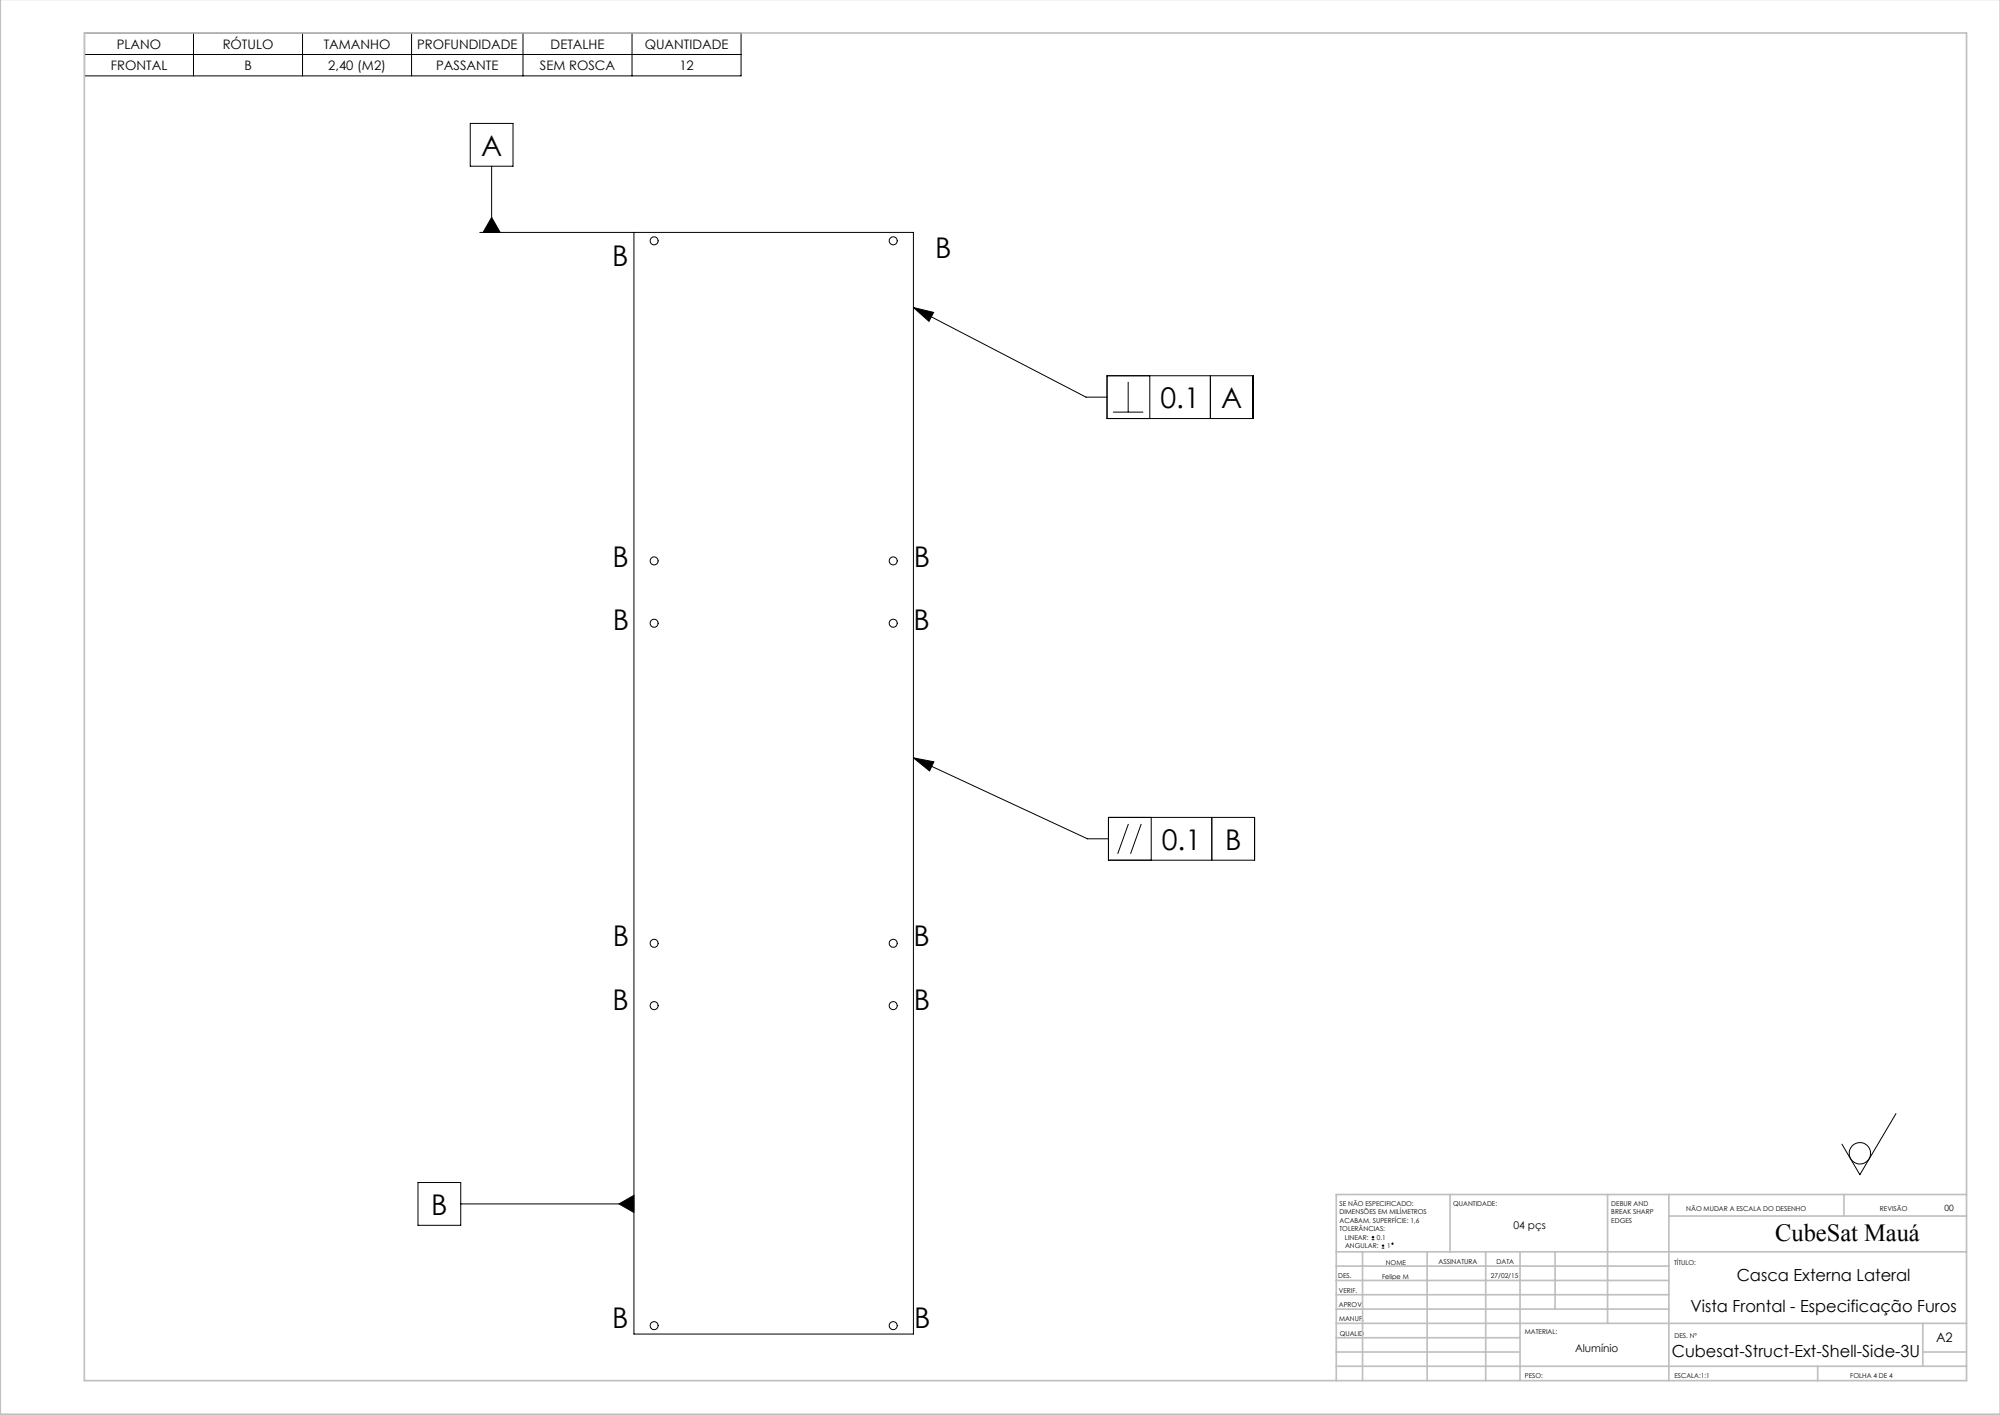
[picture p208: page 4]
CubeSat Mauá; 04 pçs; ESCALA:1:1; FOLHA 4 DE 4; NÃO MUDAR A ESCALA DO DESENHO; REVISÃO; DEBUR AND BREAK SHARP; SE NÃO ESPECIFICADO:; QUANTIDADE:

PLANO | RÓTULO | TAMANHO | PROFUNDIDADE | DETALHE | QUANTIDADE
FRONTAL | B | 2,40 (M2) | PASSANTE | SEM ROSCA | 12

DIMENSÕES EM MILÍMETROS
ACABAM. SUPERFÍCIE: 1,6
TOLERÂNCIAS:
LINEAR: 0.1
ANGULAR: 1

NOME | ASSINATURA | DATA | TÍTULO: Casca Externa Lateral Vista Frontal - Especificação Furos

DES. | Felipe M | | 27/02/15
VERIF.
