NSEE/Cubesat-Mec/Materiais/Mecânica/Construção/Folha de Processos/Corte a Jato D'água/v01.1/PDF/Cubesat-Struct-Ext-Shell-Side-1U.PDF

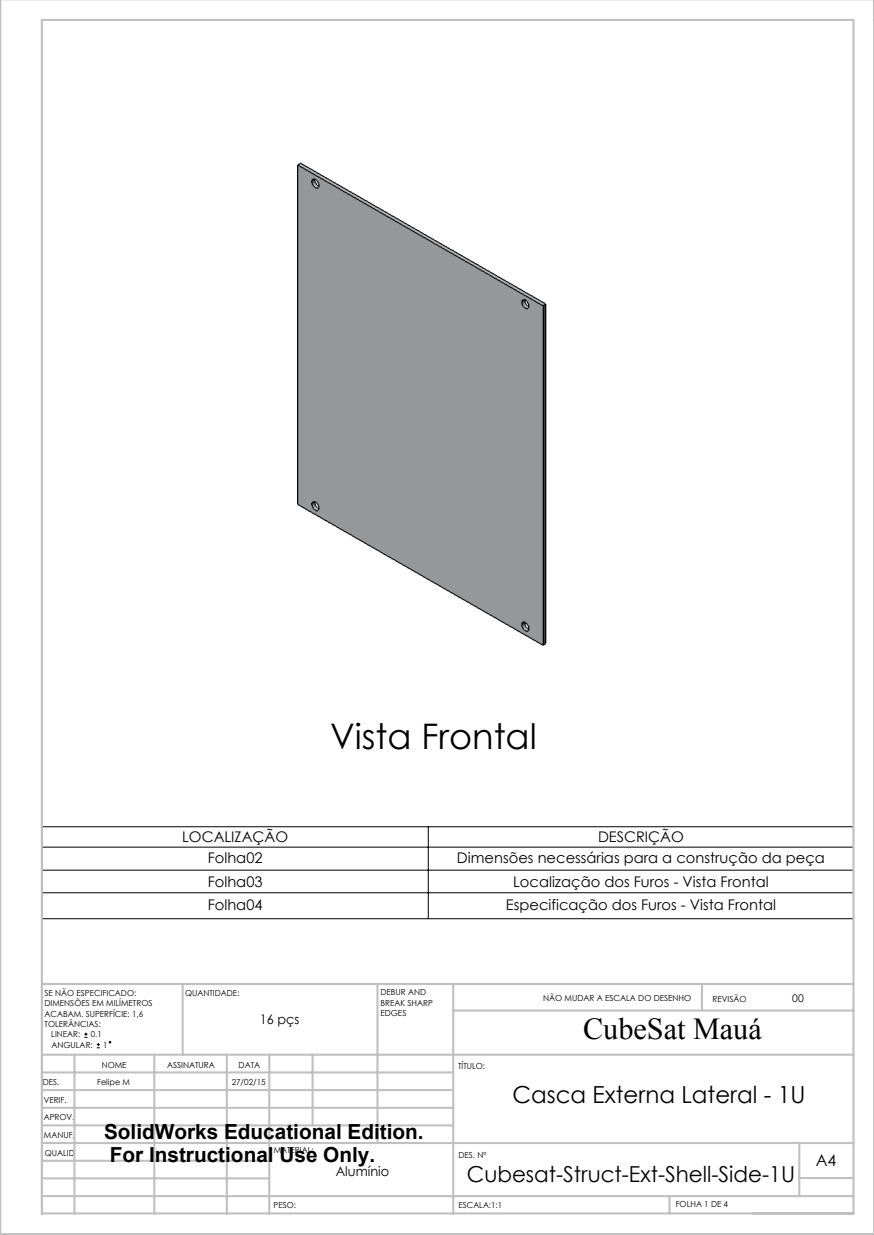
[picture p209: page 1]
Vista Frontal; CubeSat Mauá; 16 pçs; ESCALA:1:1; FOLHA 1 DE 4; NÃO MUDAR A ESCALA DO DESENHO; REVISÃO; DEBUR AND BREAK SHARP; SE NÃO ESPECIFICADO:; QUANTIDADE:

LOCALIZAÇÃO | DESCRIÇÃO
Folha02 | Dimensões necessárias para a construção da peça
Folha03 | Localização dos Furos - Vista Frontal
Folha04 | Especificação dos Furos - Vista Frontal

DIMENSÕES EM MILÍMETROS
ACABAM. SUPERFÍCIE: 1,6
TOLERÂNCIAS:
LINEAR: 0.1
ANGULAR: 1

NOME | ASSINATURA | DATA | | | | TÍTULO: Casca Externa Lateral - 1U

DES. | Felipe M | | 27/02/15
VERIF.
APROV.
MANUF. | SolidWorks Educational Edition.
QUALID | For Instructional Use Only. | | | MATERIAL: Alumínio | DES. Nº Cubesat-Struct-Ext-Shell-Side-1U | A4

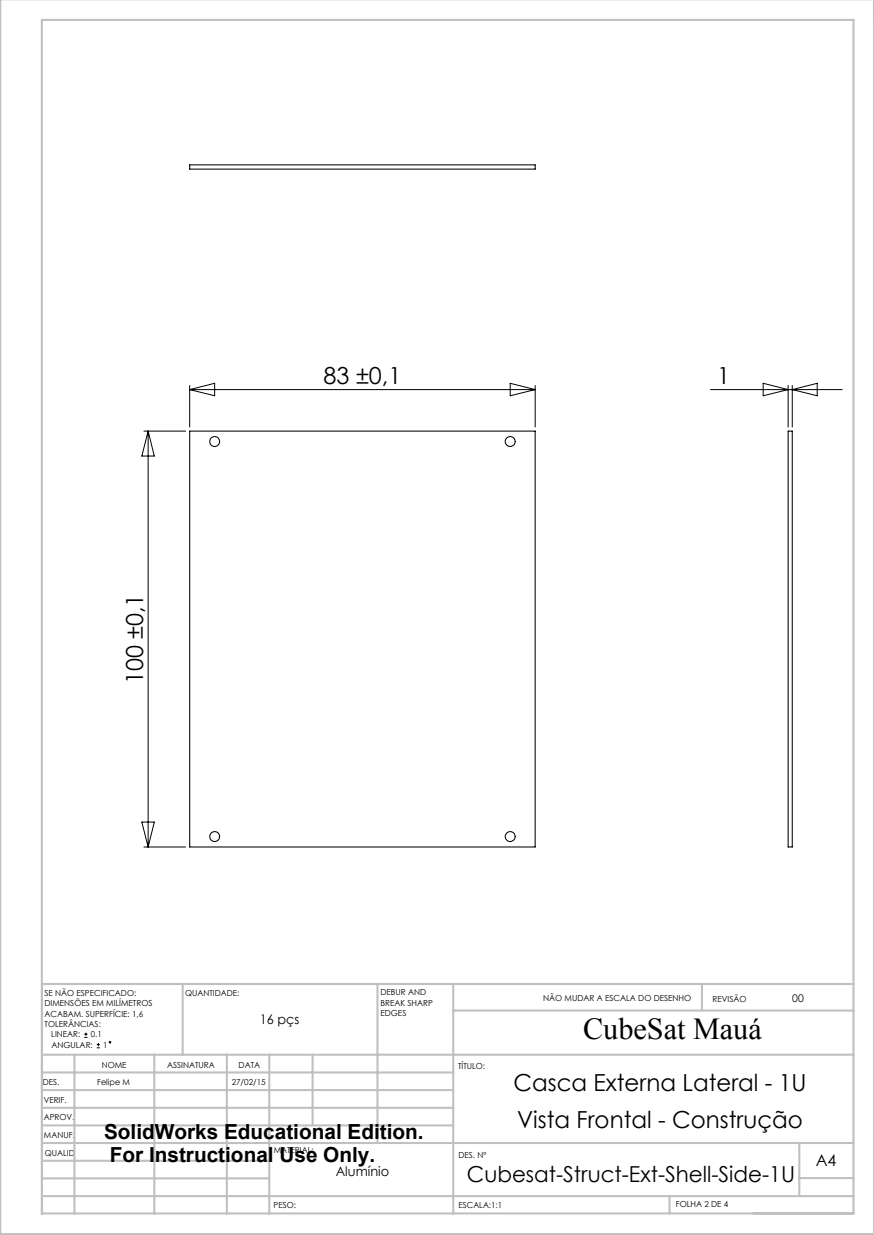
[picture p210: page 2]
CubeSat Mauá; 16 pçs; NÃO MUDAR A ESCALA DO DESENHO; REVISÃO; DEBUR AND BREAK SHARP; SE NÃO ESPECIFICADO:; QUANTIDADE:

DIMENSÕES EM MILÍMETROS
ACABAM. SUPERFÍCIE: 1,6
TOLERÂNCIAS:
LINEAR: 0.1
ANGULAR: 1

NOME | ASSINATURA | DATA | TÍTULO: Casca Externa Lateral - 1U Vista Frontal - Construção SolidWorks Educational Edition.

DES. | Felipe M | | 27/02/15
VERIF.
APROV.

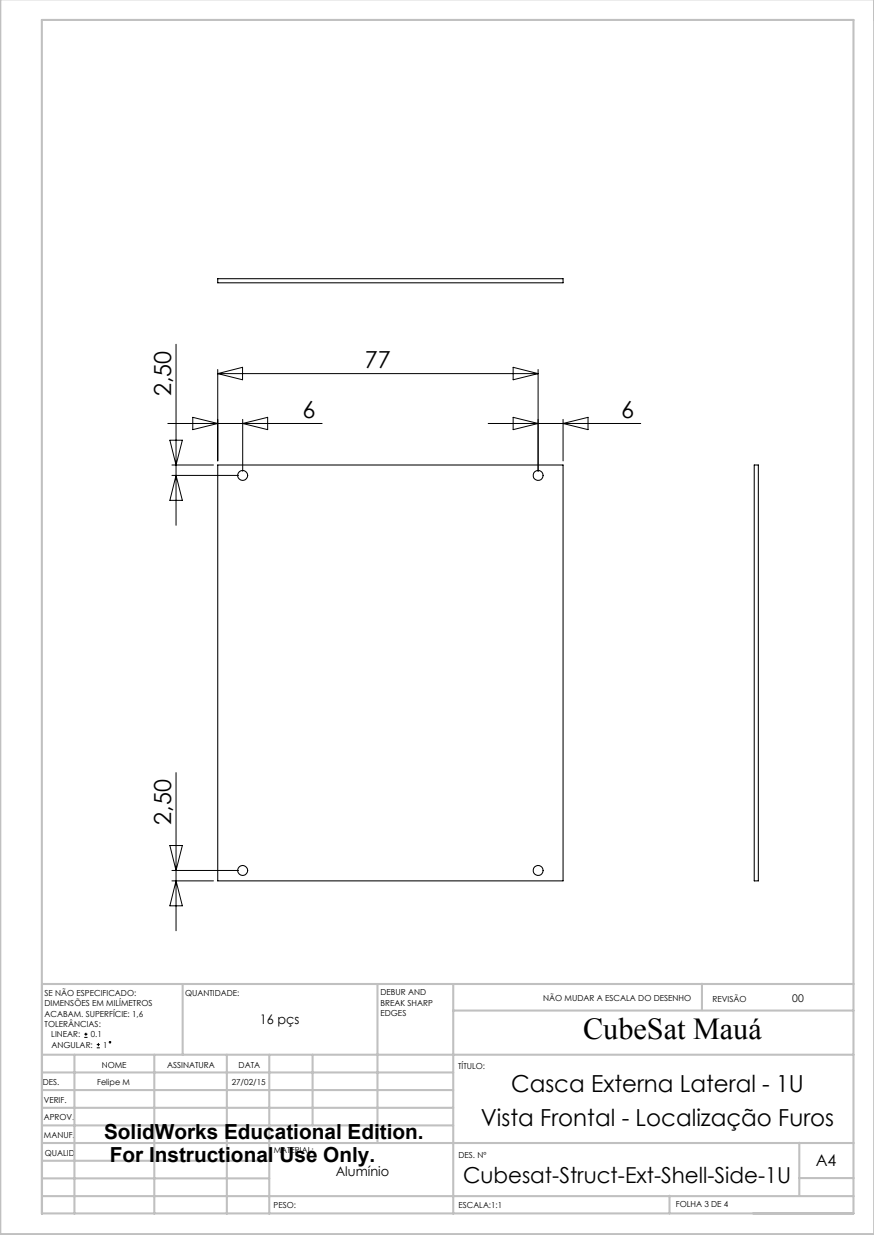
[picture p211: page 3]
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

DIMENSÕES EM MILÍMETROS
ACABAM. SUPERFÍCIE: 1,6
TOLERÂNCIAS:
LINEAR: 0.1
ANGULAR: 1

NOME | ASSINATURA | DATA | TÍTULO: Casca Externa Lateral - 1U

DES. | Felipe M | | 27/02/15
VERIF.
APROV. | | | | Vista Frontal - Localização Furos SolidWorks Educational Edition.

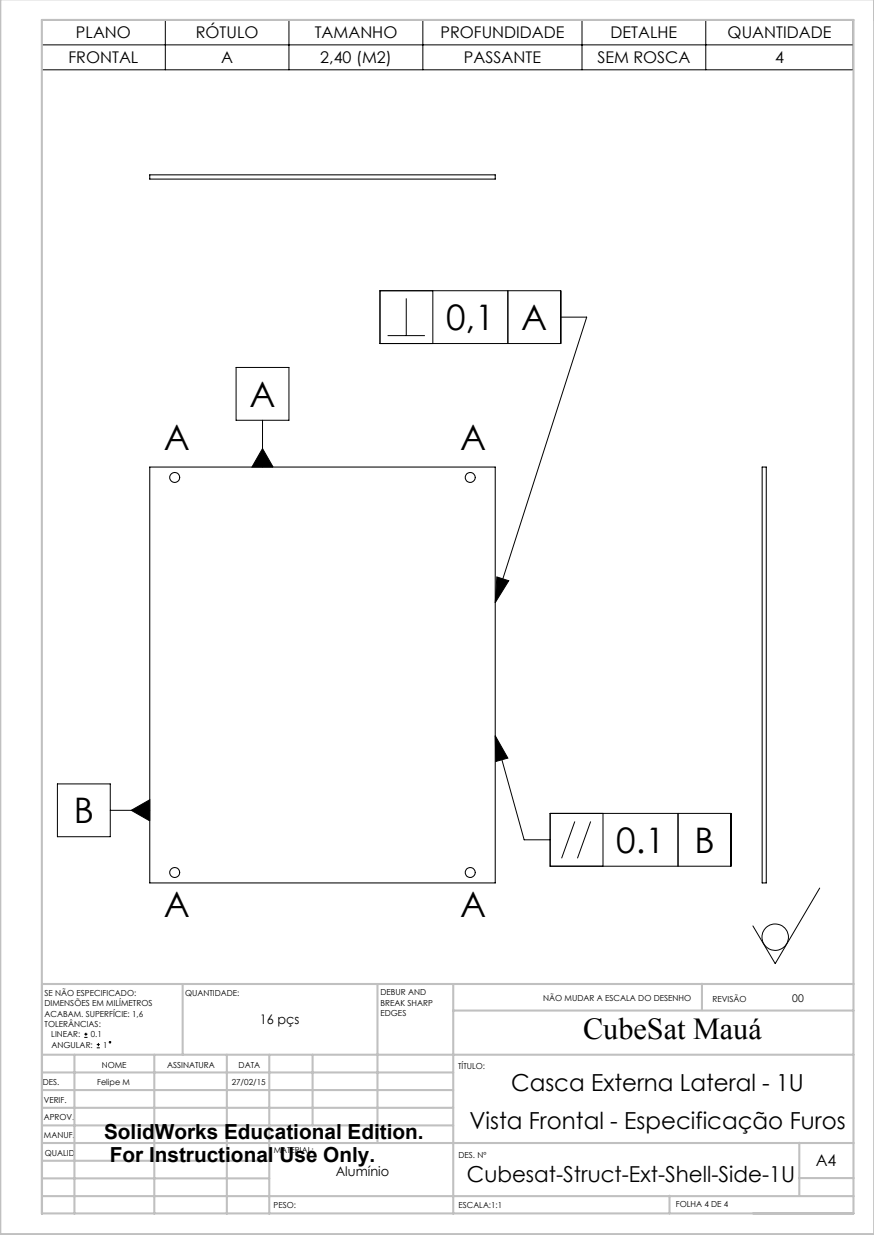
[picture p212: page 4]
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

PLANO | RÓTULO | TAMANHO | PROFUNDIDADE | DETALHE | QUANTIDADE
FRONTAL | A | 2,40 (M2) | PASSANTE | SEM ROSCA | 4

DIMENSÕES EM MILÍMETROS
ACABAM. SUPERFÍCIE: 1,6
TOLERÂNCIAS:
LINEAR: 0.1
ANGULAR: 1

NOME | ASSINATURA | DATA | TÍTULO: Casca Externa Lateral - 1U

DES. | Felipe M | | 27/02/15
VERIF.
APROV. | | | | Vista Frontal - Especificação Furos SolidWorks Educational Edition.
