NSEE/Cubesat-Mec/Materiais/Mecânica/Construção/Folha de Processos/Completa/v01.1/PDF/Cubesat-1U-Assembly.PDF

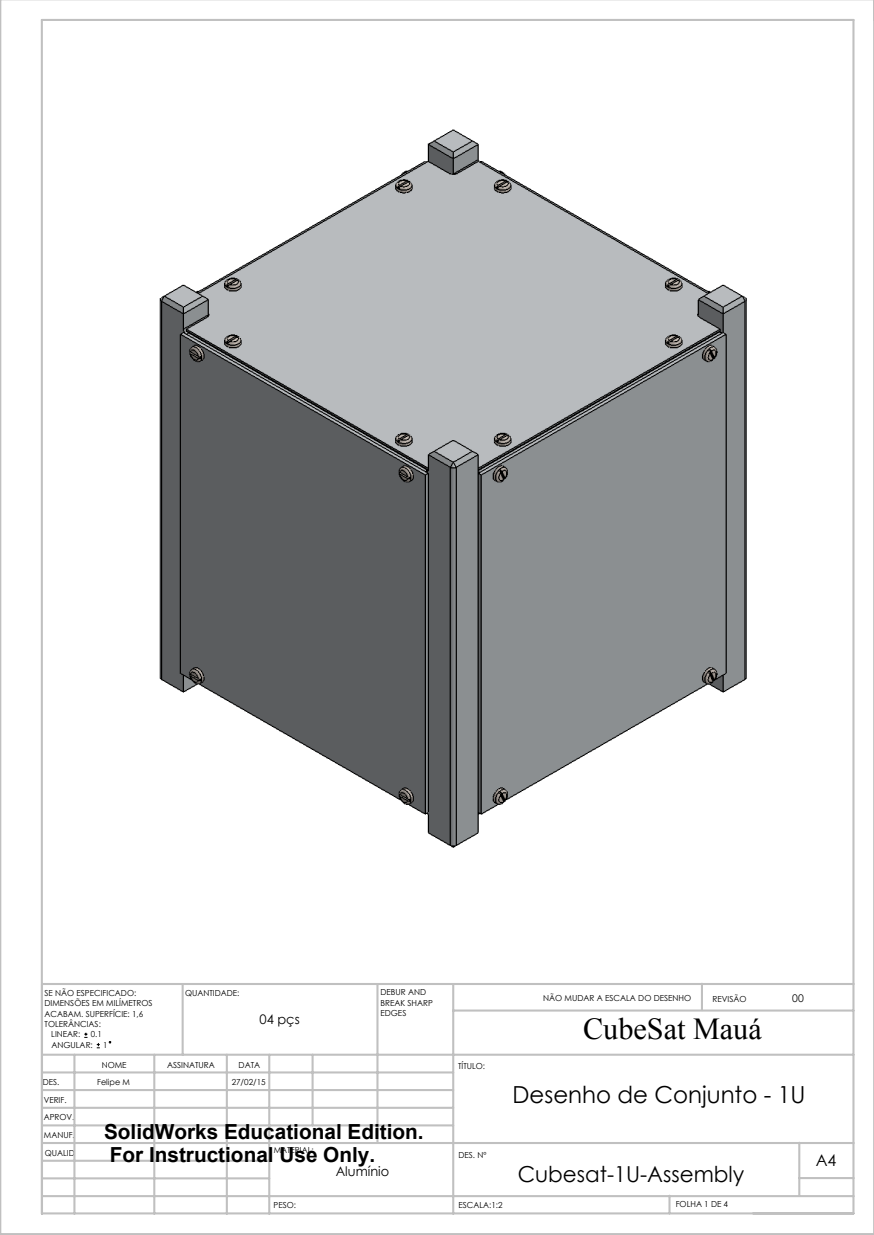
[picture p233: page 1]
CubeSat Mauá; 04 pçs; ESCALA:1:2; FOLHA 1 DE 4; NÃO MUDAR A ESCALA DO DESENHO; REVISÃO; DEBUR AND BREAK SHARP; SE NÃO ESPECIFICADO:; QUANTIDADE:

DIMENSÕES EM MILÍMETROS
ACABAM. SUPERFÍCIE: 1,6
TOLERÂNCIAS:
LINEAR: 0.1
ANGULAR: 1

NOME | ASSINATURA | DATA | | | | TÍTULO: Desenho de Conjunto - 1U

DES. | Felipe M | | 27/02/15
VERIF.
APROV.
MANUF. | SolidWorks Educational Edition.
QUALID | For Instructional Use Only. | | | MATERIAL: Alumínio | DES. Nº Cubesat-1U-Assembly | A4

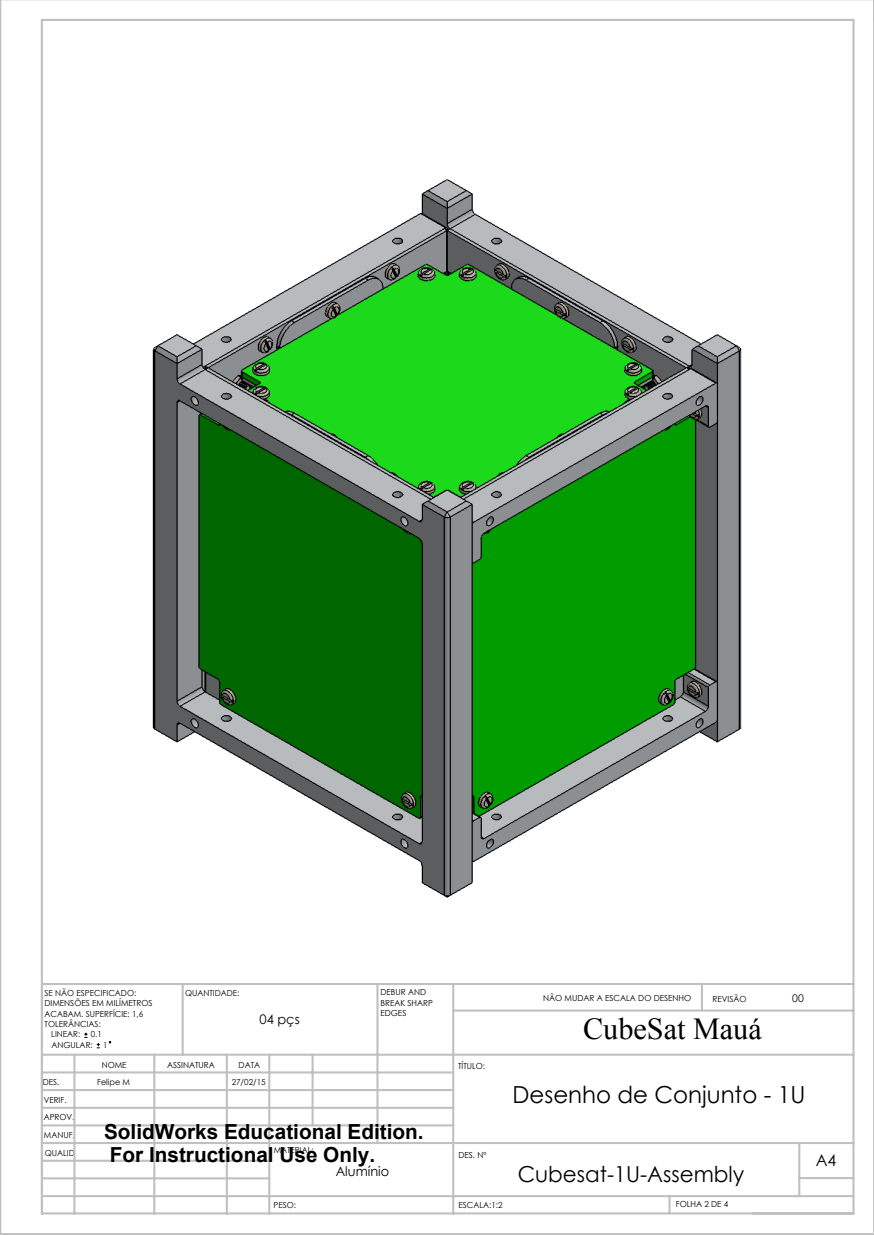
[picture p234: page 2]
CubeSat Mauá; 04 pçs; NÃO MUDAR A ESCALA DO DESENHO; REVISÃO; DEBUR AND BREAK SHARP; SE NÃO ESPECIFICADO:; QUANTIDADE:

DIMENSÕES EM MILÍMETROS
ACABAM. SUPERFÍCIE: 1,6
TOLERÂNCIAS:
LINEAR: 0.1
ANGULAR: 1

NOME | ASSINATURA | DATA | TÍTULO: Desenho de Conjunto - 1U

DES. | Felipe M | | 27/02/15
VERIF.
APROV.
SolidWorks Educational Edition.

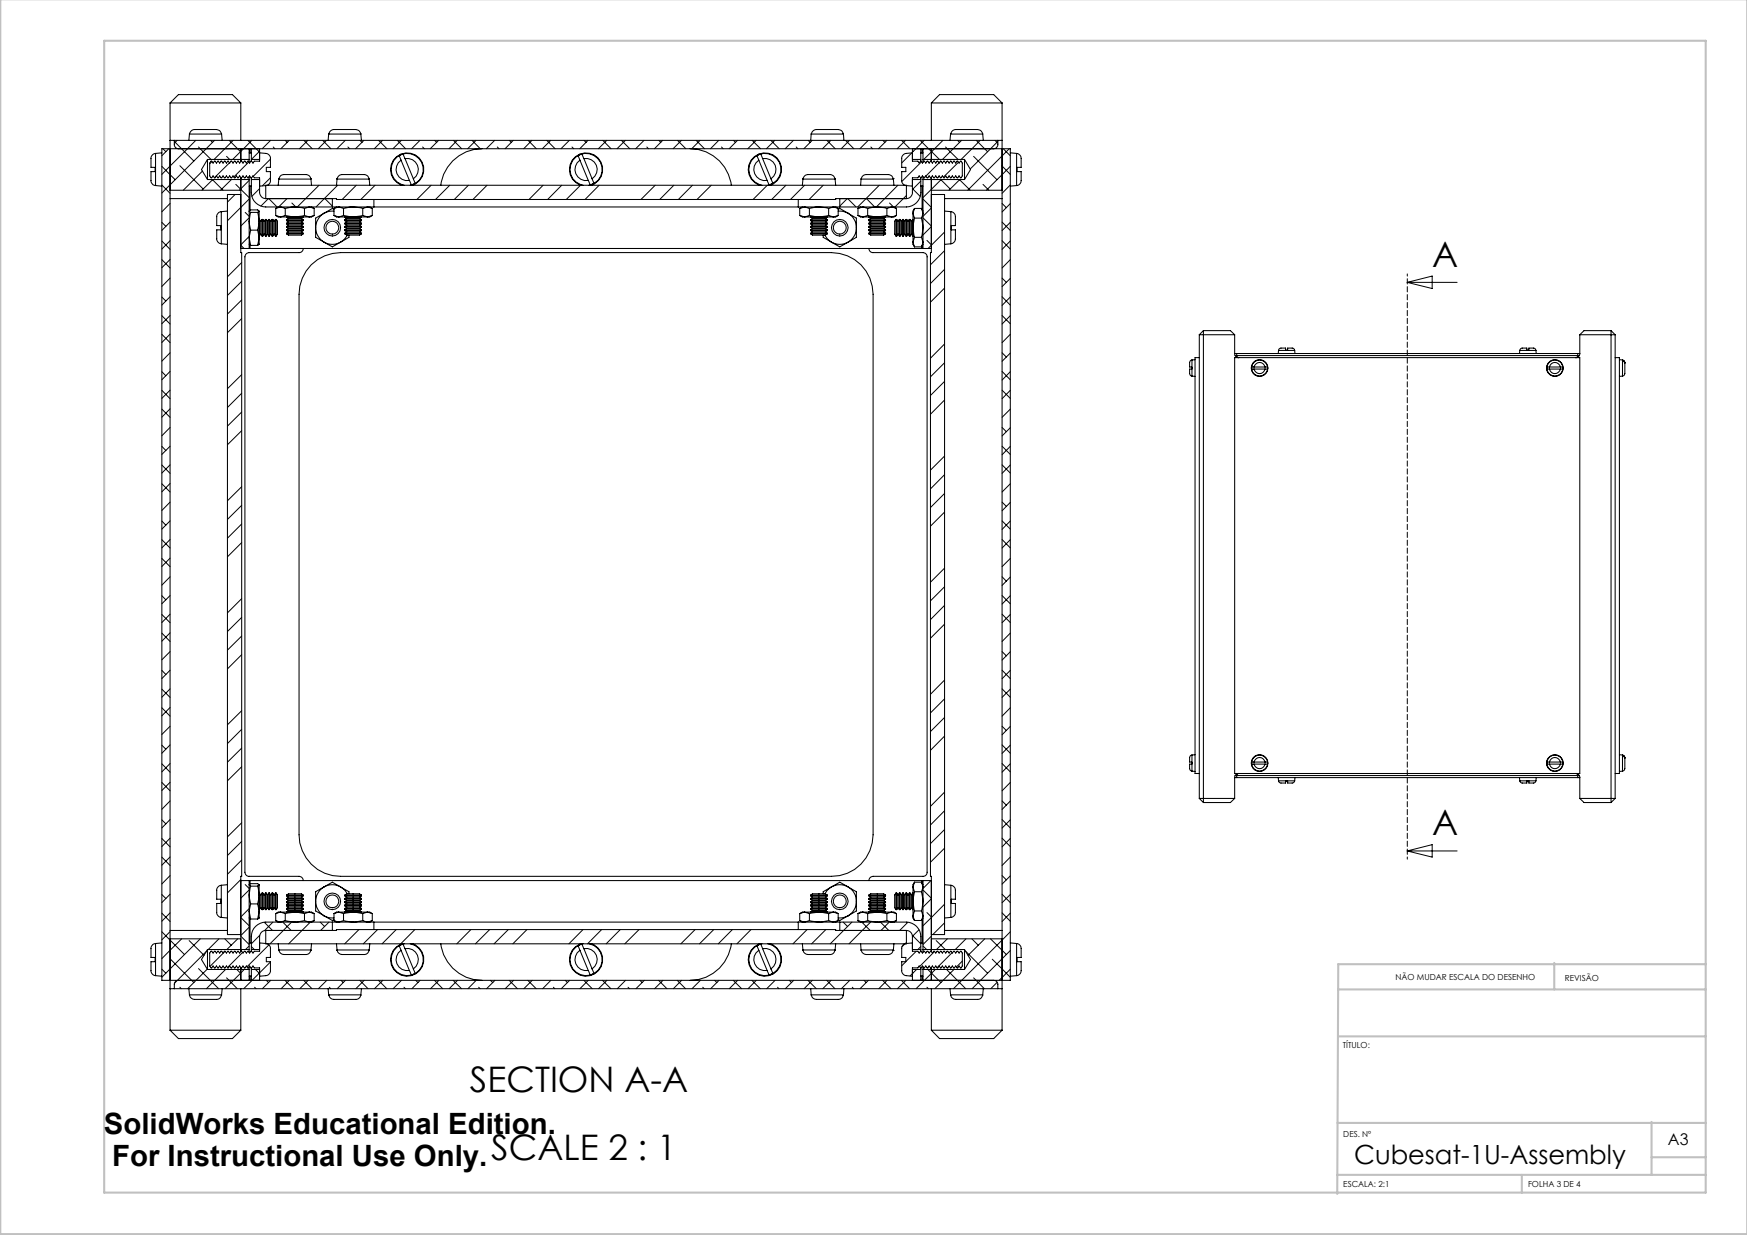
[picture p235: page 3]
SECTION A-A; SCALE 2 : 1; Cubesat-1U-Assembly; ESCALA: 2:1; FOLHA 3 DE 4; NÃO MUDAR ESCALA DO DESENHO; REVISÃO

SolidWorks Educational Edition.

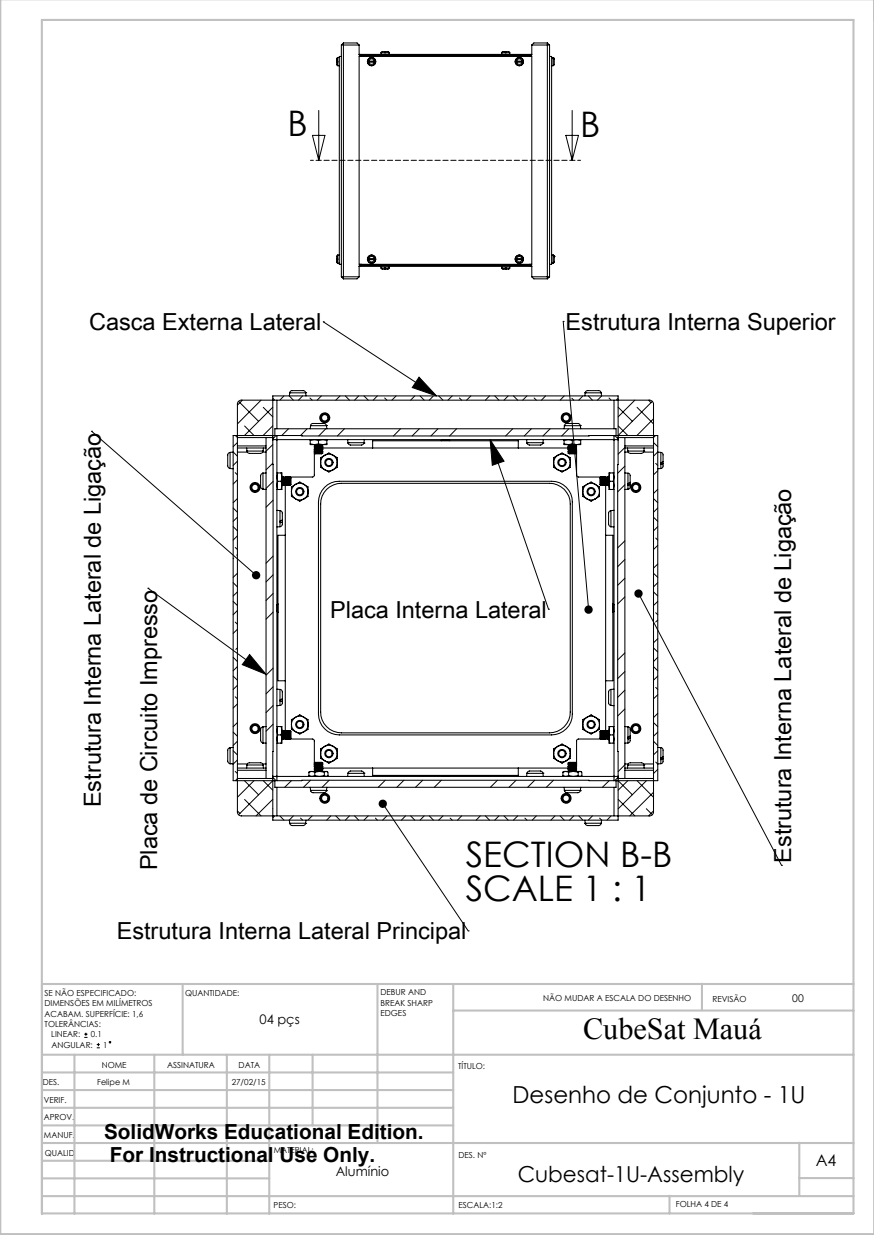
[picture p236: page 4]
SECTION B-B SCALE 1 : 1; Casca Externa Lateral Estrutura Interna Lateral de Ligação; Placa de Circuito Impresso; CubeSat Mauá; 04 pçs; NÃO MUDAR A ESCALA DO DESENHO; REVISÃO; DEBUR AND BREAK SHARP; SE NÃO ESPECIFICADO:; QUANTIDADE:

Estrutura Interna Superior

Estrutura Interna Lateral de Ligação

Placa Interna Lateral

Estrutura Interna Lateral Principal

DIMENSÕES EM MILÍMETROS
ACABAM. SUPERFÍCIE: 1,6
TOLERÂNCIAS:
LINEAR: 0.1
ANGULAR: 1

NOME | ASSINATURA | DATA | TÍTULO: Desenho de Conjunto - 1U

DES. | Felipe M | | 27/02/15
VERIF.
APROV.
SolidWorks Educational Edition.
