NSEE/Cubesat-Mec/(commit log)

2015-04-01 CubeSat V01
    Versão 01 do CubeSat
    [CubeSat-Toolbox-Int-Nut-M2.SLDPRT, CubeSat-Toolbox-Int-Screw-M2-12mm.SLDPRT, CubeSat-Toolbox-Int-Screw-M2-8mm.SLDPRT, CubeSat-Toolbox-Int-Washer-M2.SLDPRT, Cubesat-1U-Assembly.SLDASM, Cubesat-1U-Assembly.SLDDRW, Cubesat-3U-Assembly.SLDASM, Cubesat-PCB-Chip01.SLDPRT]
2015-04-06 CubeSat V01
    - Atualizei o V01 da estrutura, adicionando parafusos na parte externa
    do 3U;
    - Adicionei os modelos dos volantes de inércia.
    [CubeSat-Toolbox-Int-Nut-M2.SLDPRT, CubeSat-Toolbox-Int-Screw-M2-12mm.SLDPRT, CubeSat-Toolbox-Int-Screw-M2-8mm.SLDPRT, CubeSat-Toolbox-Int-Washer-M2.SLDPRT, Cubesat-1U-Assembly.SLDASM, Cubesat-3U-Assembly.SLDASM, Cubesat-PCB-Chip01.SLDPRT, Cubesat-PCB-Chip02.SLDPRT]
2015-04-09 Especificação Produto
    - Adicionei os manuais que tomei como base para a construção da
    estrutura mecânica (cubesatshop);
    - Adicionei o documento que vem sendo gerado pelo NSEE (especificação do
    produto - CubeSat Mauá);
2015-07-07 CubeSat v01.1
    Versão a ser enviada para construção tanto na CNC da Mauá, quanto o
    corte das chapas à lazer.
    [CubeSat-Toolbox-Int-Nut-M2.SLDPRT, CubeSat-Toolbox-Int-Screw-M2-12mm.SLDPRT, CubeSat-Toolbox-Int-Screw-M2-6mm.SLDPRT, CubeSat-Toolbox-Int-Washer-M2.SLDPRT, Cubesat-3U-Assembly.SLDASM, Cubesat-PCB-Chip01.SLDPRT, Cubesat-PCB-Chip02.SLDPRT, Cubesat-PCB-Chip03.SLDPRT]
2015-07-07 Folhas de Processos v01
    v01 mais organizada
    [Cubesat-1U-Assembly.SLDDRW, Cubesat-Struct-Ext-Shell-Side-1U.SLDDRW, Cubesat-Struct-Ext-Shell-Side-3U.SLDDRW, Cubesat-Struct-Ext-Shell-Top.SLDDRW, Cubesat-Struct-Int-Frame-Side01.SLDDRW, Cubesat-Struct-Int-Frame-Side02.SLDDRW, Cubesat-Struct-Int-Frame-Side03.SLDDRW, Cubesat-Struct-Int-Frame-Top.SLDDRW]
2015-07-07 Folhas de Processos v01.1
    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
    [Cubesat-1U-Assembly.SLDDRW, Cubesat-Struct-Ext-Shell-Side-1U.SLDDRW, Cubesat-Struct-Ext-Shell-Side-3U.SLDDRW, Cubesat-Struct-Ext-Shell-Top.SLDDRW, Cubesat-Struct-Int-Frame-Side01.SLDDRW, Cubesat-Struct-Int-Frame-Side02.SLDDRW, Cubesat-Struct-Int-Frame-Side03.SLDDRW, Cubesat-Struct-Int-Frame-Top.SLDDRW]
2015-07-07 Atualização de conteúdo
    Melhorei a organização de pastas e adicionei a pasta "Arquivos Enviados
    para Construção"
    [CubeSat-Toolbox-Int-Nut-M2.SLDPRT, CubeSat-Toolbox-Int-Screw-M2-12mm.SLDPRT, CubeSat-Toolbox-Int-Screw-M2-6mm.SLDPRT, CubeSat-Toolbox-Int-Screw-M2-8mm.SLDPRT, CubeSat-Toolbox-Int-Washer-M2.SLDPRT, Cubesat-1U-Assembly.SLDASM, Cubesat-1U-Assembly.SLDDRW, Cubesat-3U-Assembly.SLDASM]
2015-07-07 Dimensões PCB v01.1
    Versão atualizada para a construção da PCB, de acordo com o CubeSat
    v01.1
    [Cubesat-PCB-Side.SLDDRW, Cubesat-PCB-Top.SLDDRW]
2015-07-07 Atualização ordem das pastas e Adição Arquivos para Construção
    [Cubesat-PCB-Side.SLDDRW, Cubesat-PCB-Top.SLDDRW, Cubesat-Struct-Int-Frame-Side01.SLDPRT, Cubesat-Struct-Int-Frame-Side01.STEP, Cubesat-Struct-Int-Frame-Side02.SLDPRT, Cubesat-Struct-Int-Frame-Side02.STEP, Cubesat-Struct-Int-Frame-Side03.SLDPRT, Cubesat-Struct-Int-Frame-Side03.STEP]
2016-01-26 Atualização do Como
    Inseri todos os artigos sobre o assunto que possuo, a grande maioria dos
    downloads foi realizado e pago pela Mauá.
2016-01-26 Atualização Construção\Arquivos Enviados para Construção
    [Cubesat-Struct-Ext-Shell-Side-1U.DWG, Cubesat-Struct-Ext-Shell-Side-1U.SLDDRW, Cubesat-Struct-Ext-Shell-Side-3U.DWG, Cubesat-Struct-Ext-Shell-Side-3U.SLDDRW, Cubesat-Struct-Ext-Shell-Side-3U.SLDPRT, Cubesat-Struct-Ext-Shell-Top.DWG, Cubesat-Struct-Ext-Shell-Top.SLDDRW, Cubesat-Struct-Int-Frame-Side01.DWG]
2016-01-26 Atualização Folha de Processos
    [Cubesat-1U-Assembly.SLDDRW, Cubesat-Struct-Ext-Shell-Side-1U.DWG, Cubesat-Struct-Ext-Shell-Side-1U.SLDDRW, Cubesat-Struct-Ext-Shell-Side-3U.DWG, Cubesat-Struct-Ext-Shell-Side-3U.SLDDRW, Cubesat-Struct-Ext-Shell-Top.DWG, Cubesat-Struct-Ext-Shell-Top.SLDDRW, Cubesat-Struct-Int-Frame-Side01.DWG]
2016-01-26 Add arquivos Matlab
    Arquivos do Matlab + Simulink que projetam a dimensão do volante de
    inércia necessário para a realização de um certo torque reativo pelo
    CubeSat, além de simulação do comportamento do motor + CubeSat.
2016-01-26 Add Modelo solidworks suporte motor
    [Cubesat-Struct-Int-Motor-Suport.SLDPRT]
2016-01-28 Atualização V01.1
    [CubeSat-Toolbox-Int-Nut-M2.SLDPRT, CubeSat-Toolbox-Int-Screw-M2-12mm.SLDPRT, CubeSat-Toolbox-Int-Screw-M2-8mm.SLDPRT, CubeSat-Toolbox-Int-Washer-M2.SLDPRT, Cubesat-1U-Assembly.SLDASM, Cubesat-3U-Assembly.SLDASM, Cubesat-PCB-Chip01.SLDPRT, Cubesat-PCB-Chip02.SLDPRT]
2016-01-29 Add CubeSat v01.2 - Solidworks
    versão final
    [CubeSat-Toolbox-Int-Nut-M2.SLDPRT, CubeSat-Toolbox-Int-Screw-M2-6mm.SLDPRT, Cubesat-3U-Assembly.SLDASM, Cubesat-PCB-Chip01.SLDPRT, Cubesat-PCB-Chip02.SLDPRT, Cubesat-PCB-Chip03.SLDPRT, Cubesat-PCB-Chip04.SLDPRT, Cubesat-PCB-Chip05.SLDPRT]
2016-01-29 Tirei espaço da frente do Materiais
    [CubeSat-Toolbox-Int-Nut-M2.SLDPRT, CubeSat-Toolbox-Int-Screw-M2-12mm.SLDPRT, CubeSat-Toolbox-Int-Screw-M2-6mm.SLDPRT, CubeSat-Toolbox-Int-Screw-M2-8mm.SLDPRT, CubeSat-Toolbox-Int-Washer-M2.SLDPRT, Cubesat-1U-Assembly.SLDASM, Cubesat-1U-Assembly.SLDDRW, Cubesat-3U-Assembly.SLDASM]
2016-01-29 Add artigos
    Adicionei o artigo que foi selecionado para a II Latin American IAA
    CubeSat Workshop 2016
    [Area calc.xlsx]
2016-01-29 Excluindo o que não é tão importante
    [Area calc.xlsx]
